Tanvi11Ghelani/ECO_BUILD_UI/build/Images/gallery/hydrofoam-gallery-6.jpg

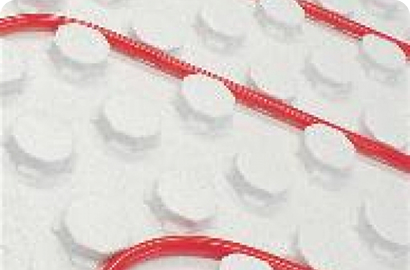
build/Images/gallery/hydrofoam-gallery-6.jpg
