Tanvi11Ghelani/ECO_BUILD_UI/public/lovable-uploads/3d971921-4959-4e32-b5d3-e499155b55ec.png

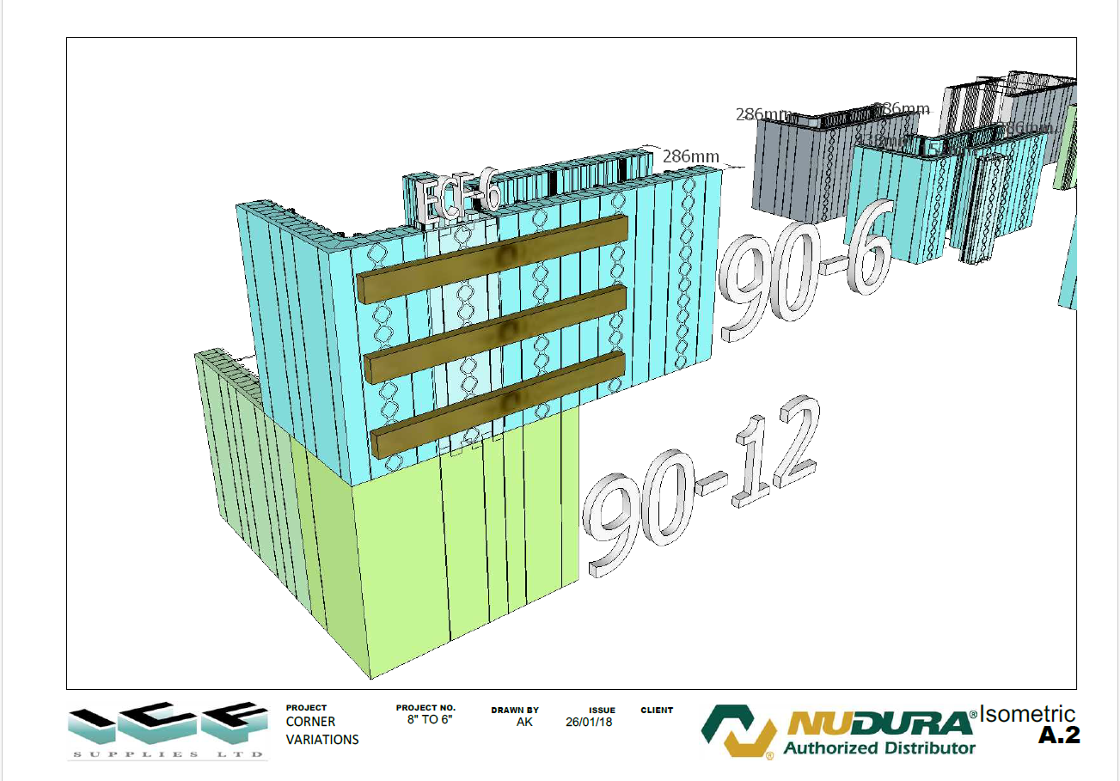
public/lovable-uploads/3d971921-4959-4e32-b5d3-e499155b55ec.png
