Tanvi11Ghelani/ECO_BUILD_UI/public/lovable-uploads/4f6da8b1-d799-4936-9964-731a3020e6be.png

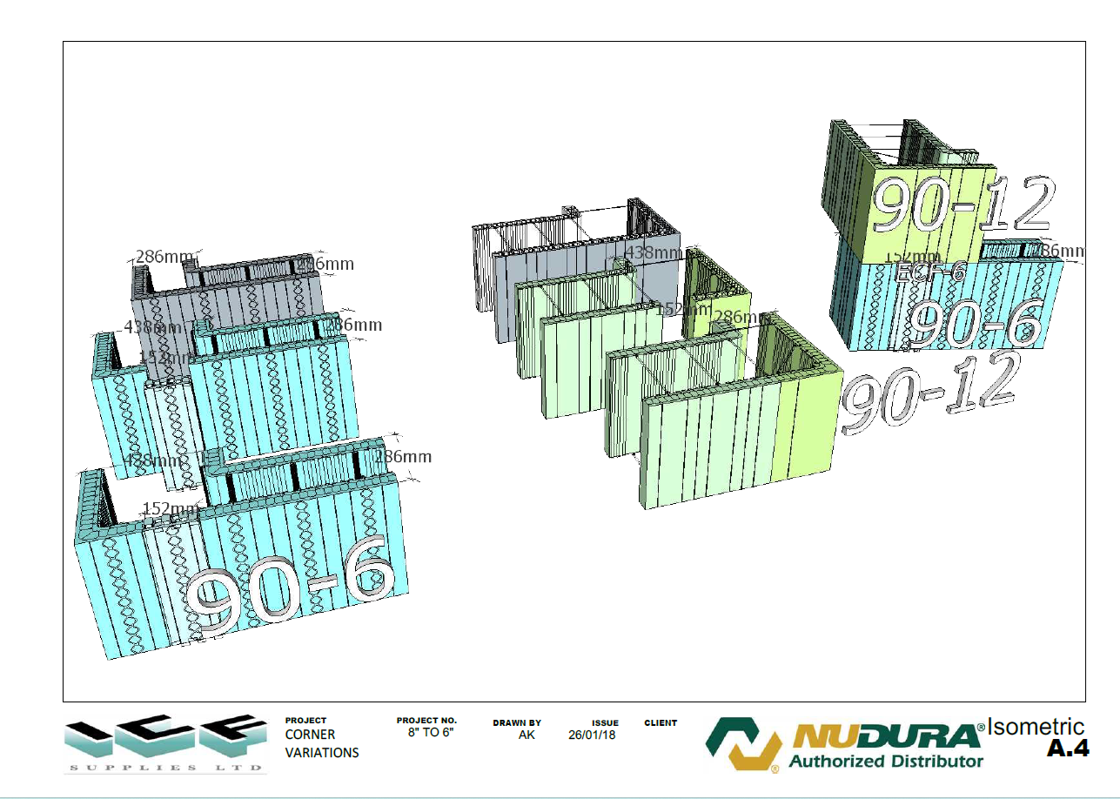
public/lovable-uploads/4f6da8b1-d799-4936-9964-731a3020e6be.png
