Tanvi11Ghelani/ECO_BUILD_UI/public/lovable-uploads/11e5b2ee-bb85-43c7-94f3-0dc3ca06c097.png

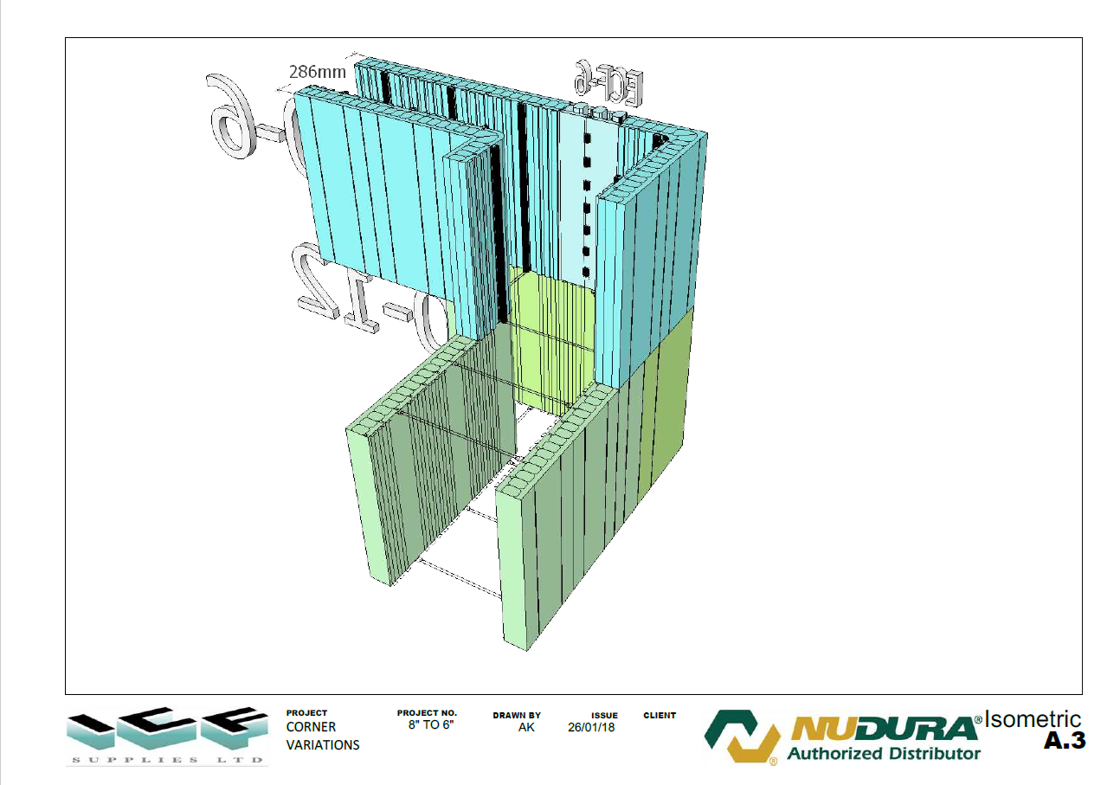
public/lovable-uploads/11e5b2ee-bb85-43c7-94f3-0dc3ca06c097.png
