Tanvi11Ghelani/ECO_BUILD_UI/public/lovable-uploads/427fd92c-301b-4182-912a-e023e5a5e665.png

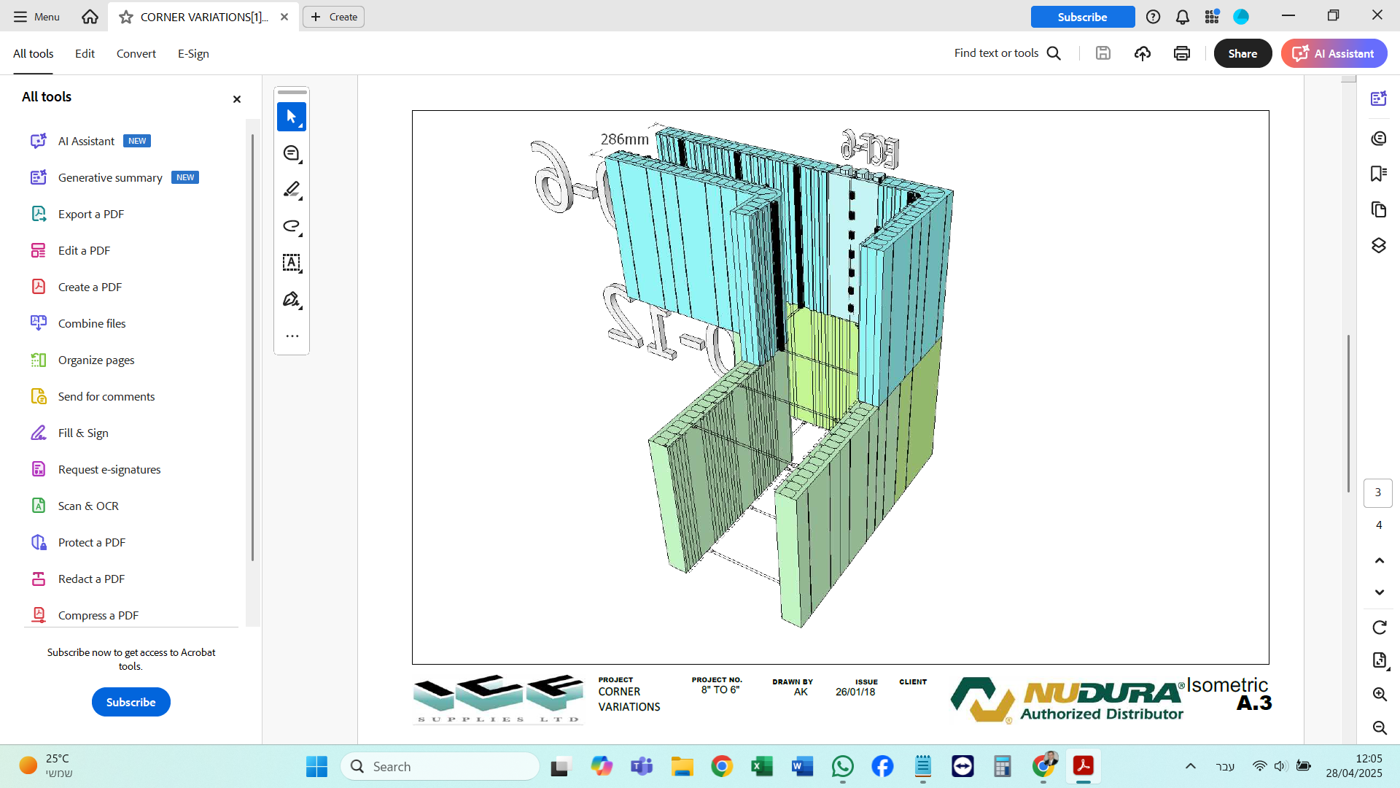
public/lovable-uploads/427fd92c-301b-4182-912a-e023e5a5e665.png
