Tanvi11Ghelani/ECO_BUILD_UI/public/lovable-uploads/4637e0ad-6543-4b1e-aaa6-287fe19e1be7.png

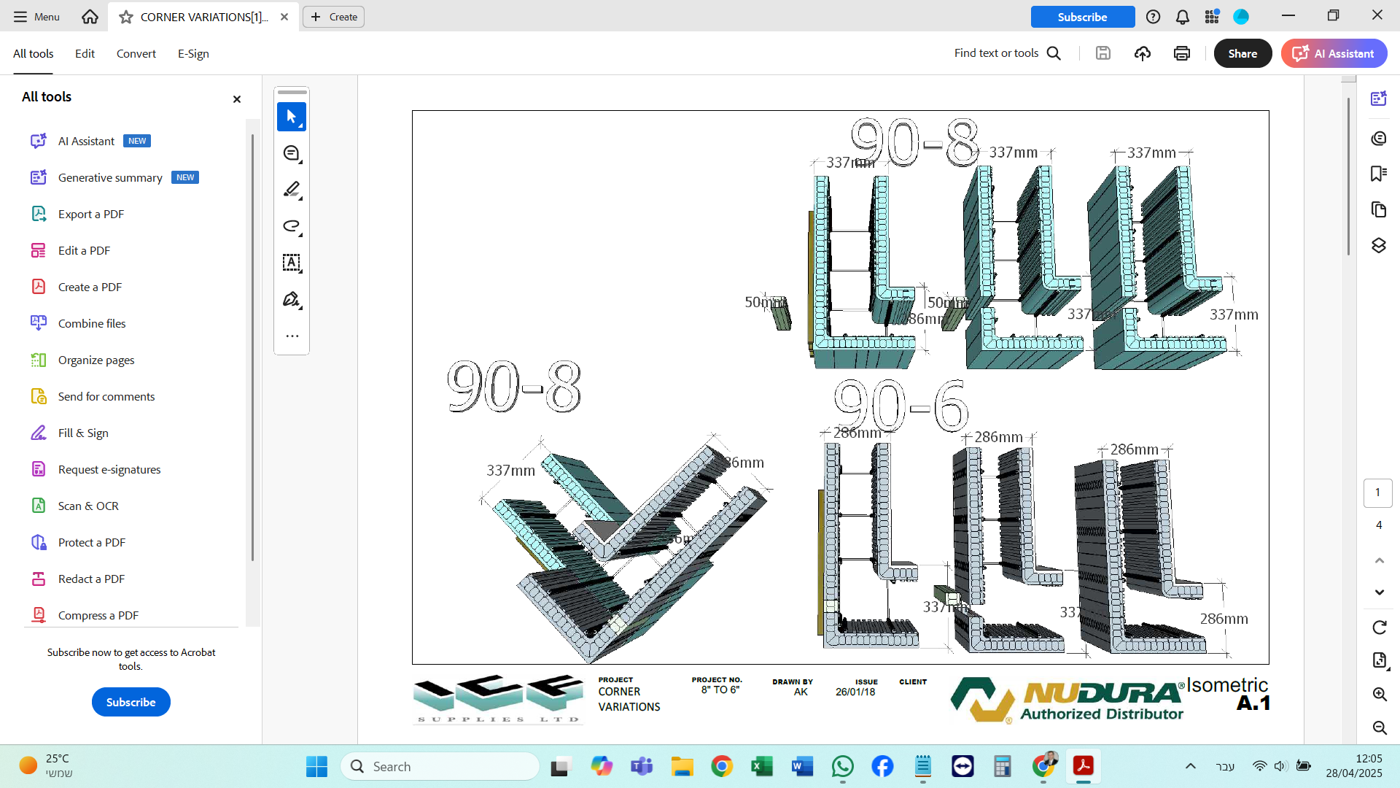
public/lovable-uploads/4637e0ad-6543-4b1e-aaa6-287fe19e1be7.png
