Tanvi11Ghelani/ECO_BUILD_UI/public/lovable-uploads/9743c81a-1aa8-4cef-92a5-277ad55554ff.png

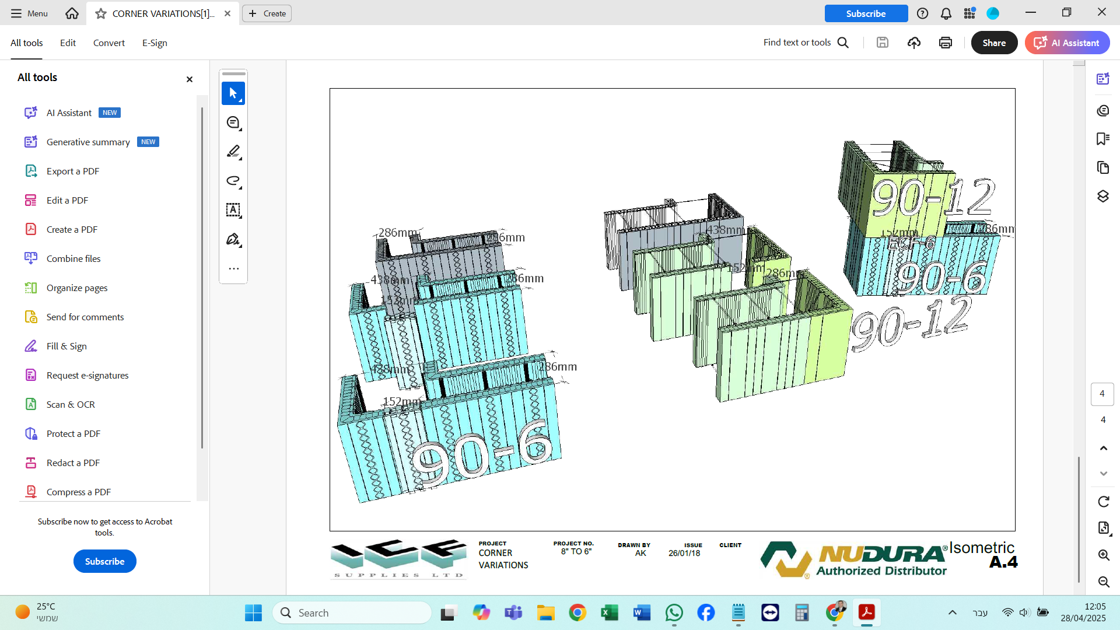
public/lovable-uploads/9743c81a-1aa8-4cef-92a5-277ad55554ff.png
