Tanvi11Ghelani/ECO_BUILD_UI/public/lovable-uploads/d565b1a1-05a1-4024-bde7-53276c35c365.png

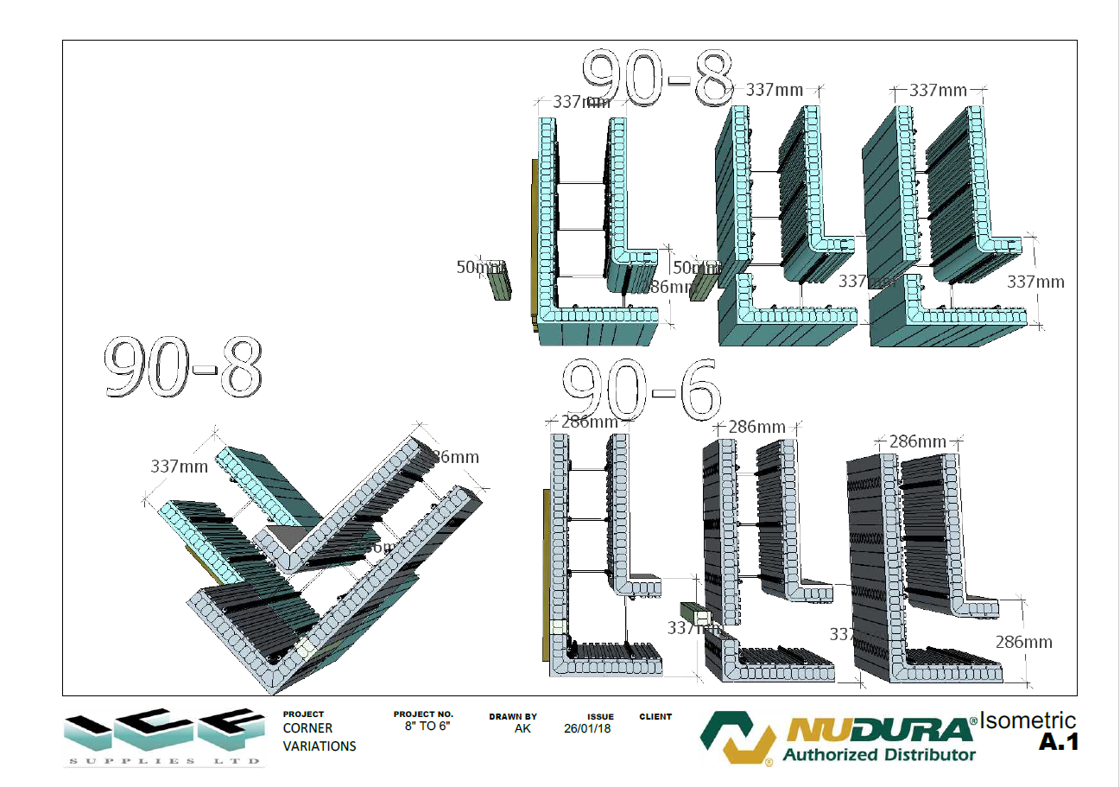
public/lovable-uploads/d565b1a1-05a1-4024-bde7-53276c35c365.png
