Tanvi11Ghelani/ECO_BUILD_UI/public/lovable-uploads/f4cbee15-ae2d-48a7-b90e-260a271ace03.png

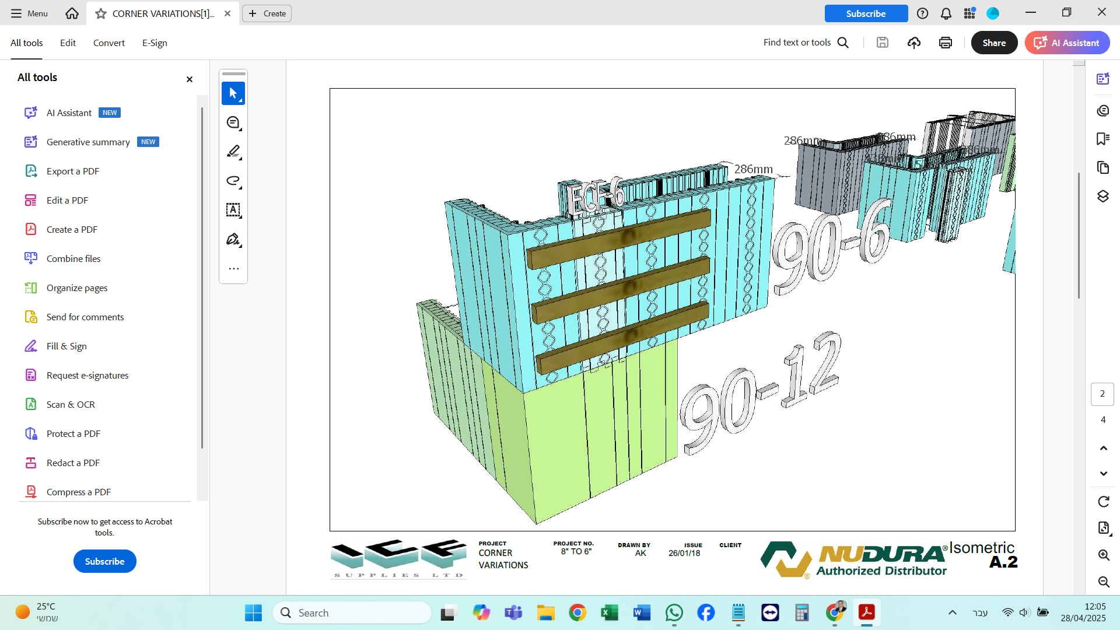
public/lovable-uploads/f4cbee15-ae2d-48a7-b90e-260a271ace03.png
