Tanvi11Ghelani/ECO_BUILD_UI/src/images/0c375863905e1bb1b25750cc52798b844b6eee66.jpg

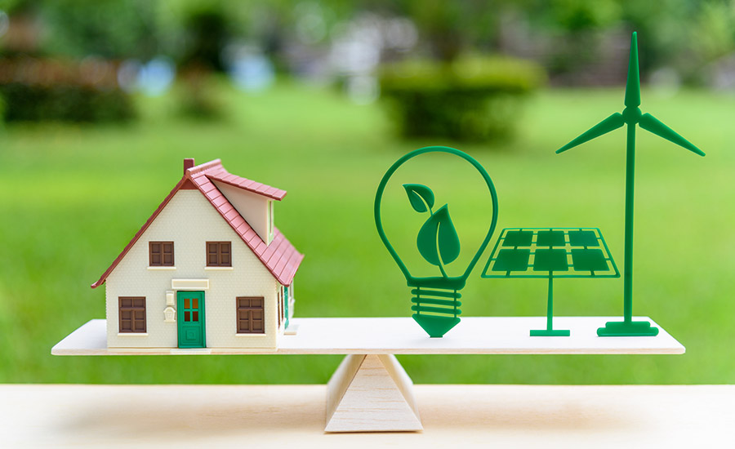
src/images/0c375863905e1bb1b25750cc52798b844b6eee66.jpg
