Tanvi11Ghelani/ECO_BUILD_UI/src/images/3recommend (3).jpeg

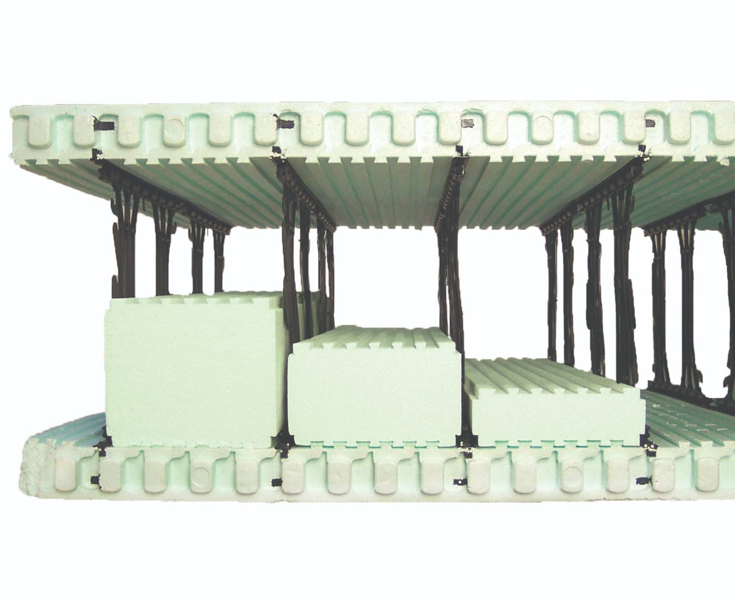
src/images/3recommend (3).jpeg
