Tanvi11Ghelani/ECO_BUILD_UI/src/images/9b8b0e7bb9354c3ecb5831282cb6aff721f5e2fe.png

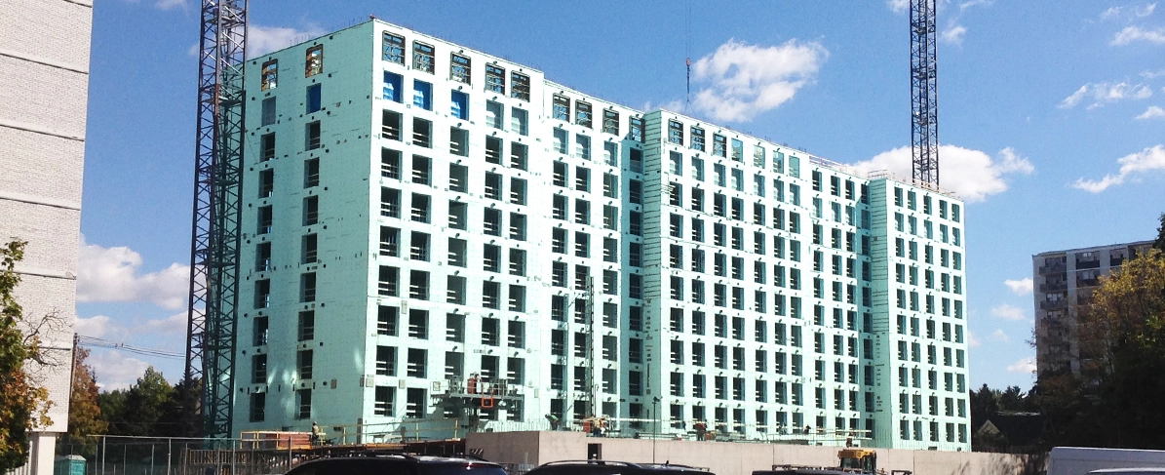
src/images/9b8b0e7bb9354c3ecb5831282cb6aff721f5e2fe.png
