Tanvi11Ghelani/ECO_BUILD_UI/src/images/ES2.png

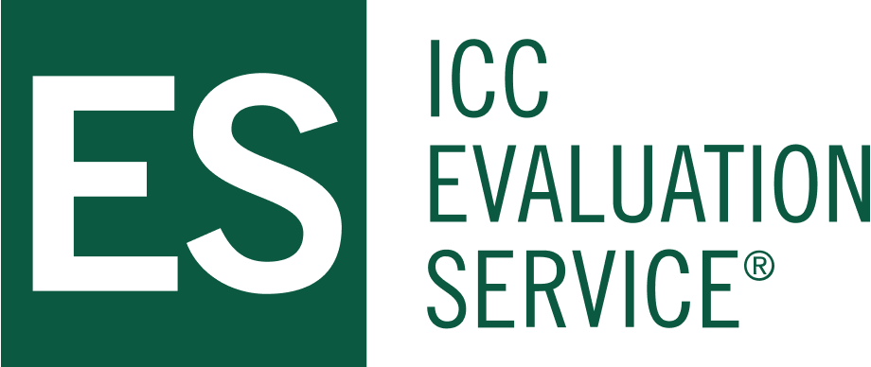
src/images/ES2.png
