Tanvi11Ghelani/ECO_BUILD_UI/src/images/ES3.jpg

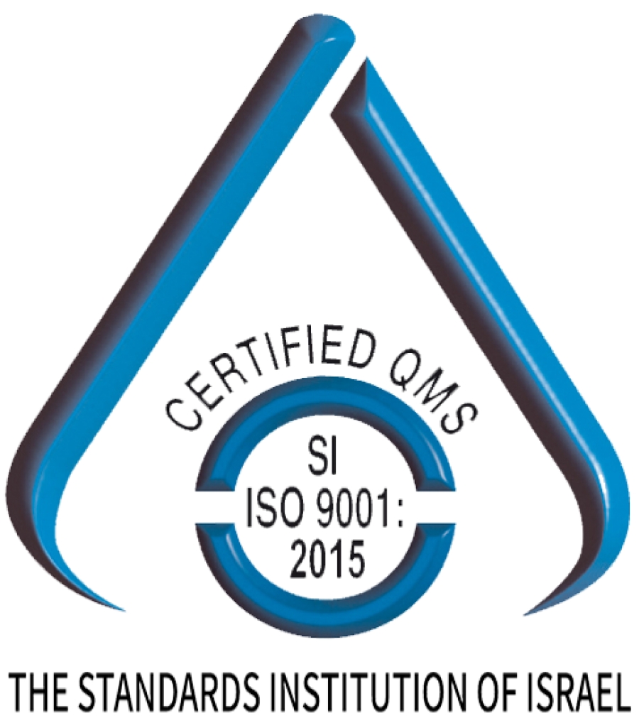
src/images/ES3.jpg
