Tanvi11Ghelani/ECO_BUILD_UI/src/images/ES4.jpg

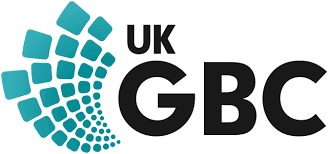
src/images/ES4.jpg
