Tanvi11Ghelani/ECO_BUILD_UI/src/images/ES5.jpg

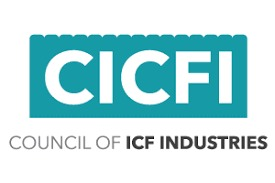
src/images/ES5.jpg
