Tanvi11Ghelani/ECO_BUILD_UI/src/images/Img2.png

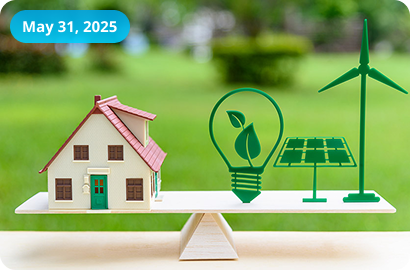
src/images/Img2.png
