Tanvi11Ghelani/ECO_BUILD_UI/src/images/Img3.png

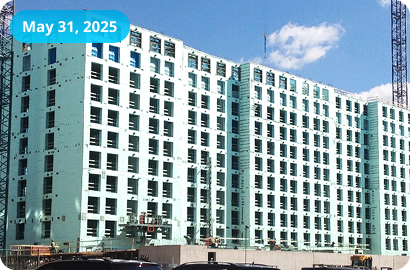
src/images/Img3.png
