Tanvi11Ghelani/ECO_BUILD_UI/src/images/nudura-plus-series-detail.png

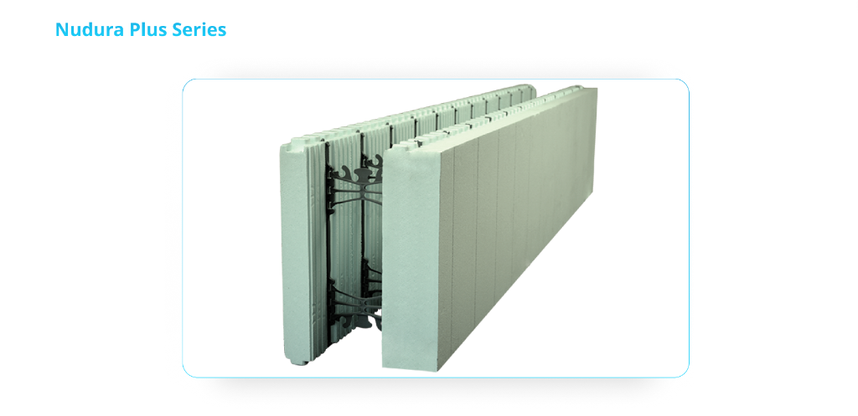
src/images/nudura-plus-series-detail.png
