Tanvi11Ghelani/ECO_BUILD_UI/src/images/photo/Gallery of completed Projects/67ac6d9e-b75c-4956-b25b-969eb53ea821.jpg

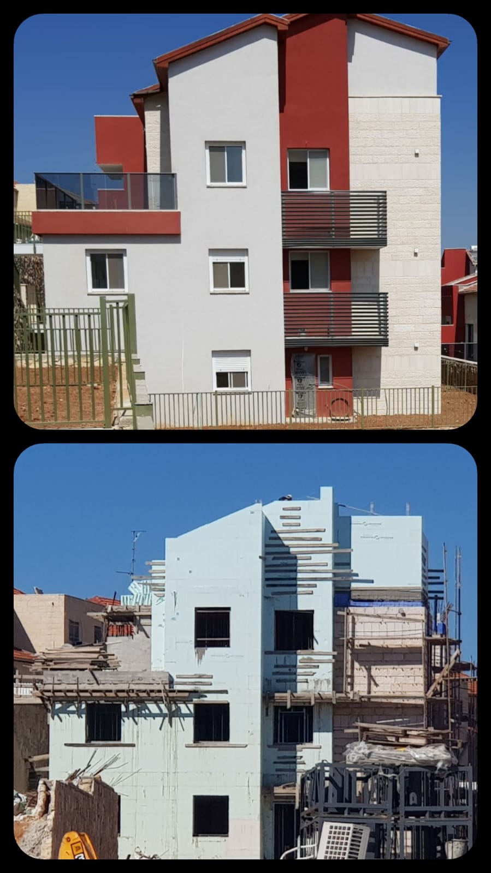
src/images/photo/Gallery of completed Projects/67ac6d9e-b75c-4956-b25b-969eb53ea821.jpg
