Tanvi11Ghelani/ECO_BUILD_UI/src/images/photo/Gallery of completed Projects/77189eb2-6007-4050-adc8-fbb78e779e5c.jpg

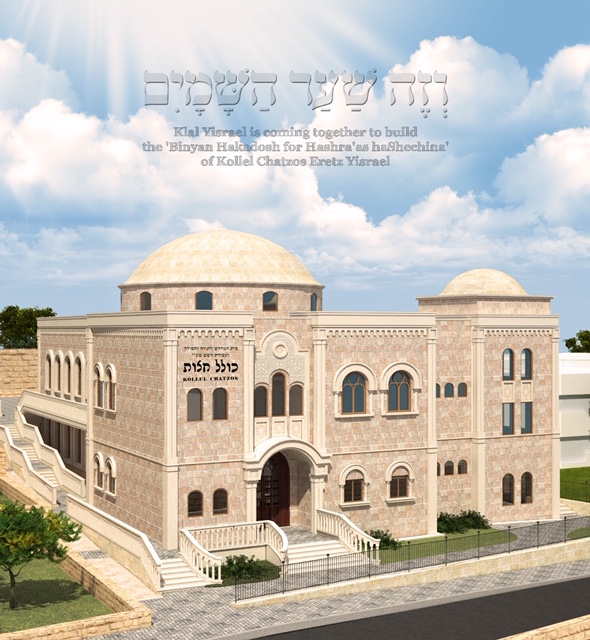
src/images/photo/Gallery of completed Projects/77189eb2-6007-4050-adc8-fbb78e779e5c.jpg
