Tanvi11Ghelani/ECO_BUILD_UI/src/images/photo/Gallery of completed Projects/a954a0a3-4781-4956-ba61-734f6c950a49.jpg

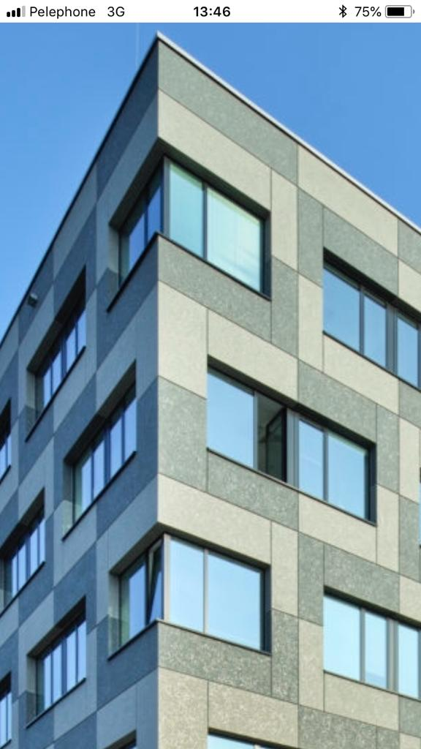
src/images/photo/Gallery of completed Projects/a954a0a3-4781-4956-ba61-734f6c950a49.jpg
