Tanvi11Ghelani/ECO_BUILD_UI/src/images/photo/Gallery of completed Projects/beb1c424-b9a0-4cc4-8972-f8892e4e08dd-1-1.jpg

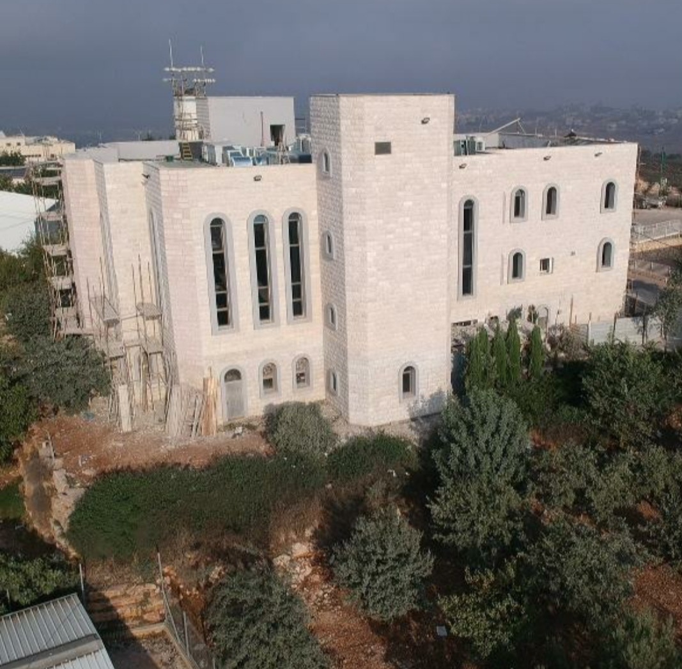
src/images/photo/Gallery of completed Projects/beb1c424-b9a0-4cc4-8972-f8892e4e08dd-1-1.jpg
