Tanvi11Ghelani/ECO_BUILD_UI/src/images/photo/Gallery of completed Projects/IMG_1801.jpg

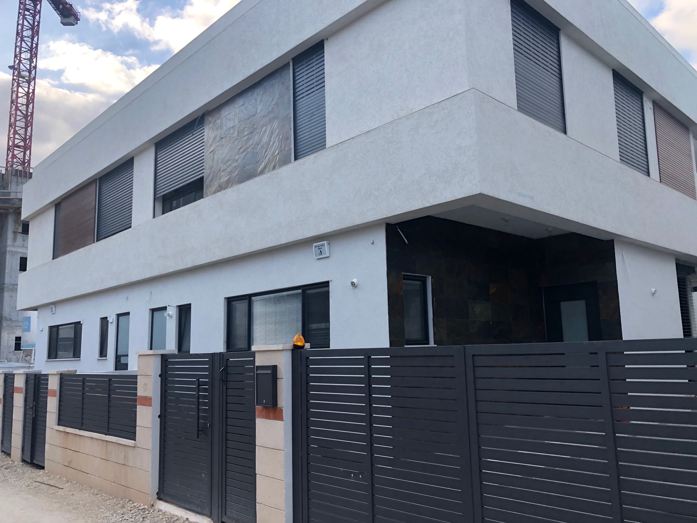
src/images/photo/Gallery of completed Projects/IMG_1801.jpg
