Tanvi11Ghelani/ECO_BUILD_UI/src/images/photo/Gallery of completed Projects/IMG_6840-rotated.jpg

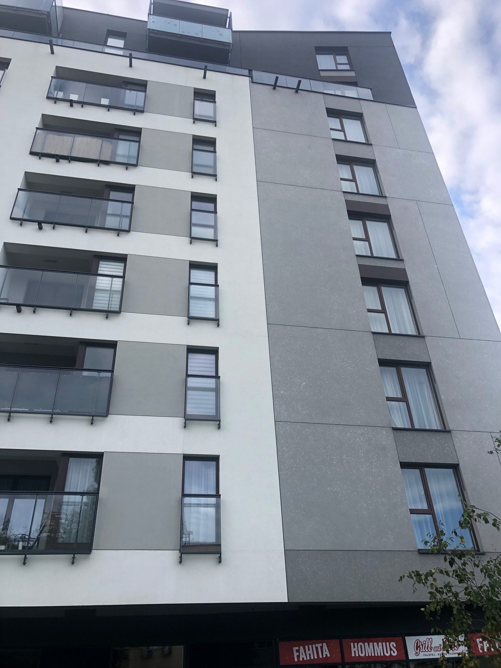
src/images/photo/Gallery of completed Projects/IMG_6840-rotated.jpg
