Tanvi11Ghelani/ECO_BUILD_UI/src/images/photo/Gallery of completed Projects/new_1715096.jpg

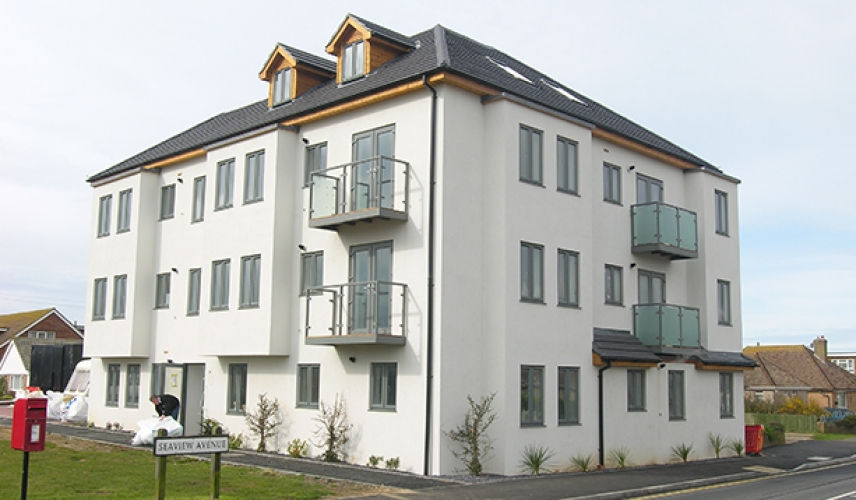
src/images/photo/Gallery of completed Projects/new_1715096.jpg
