Tanvi11Ghelani/ECO_BUILD_UI/src/images/photo/Gallery of completed Projects/new_6908463.jpg

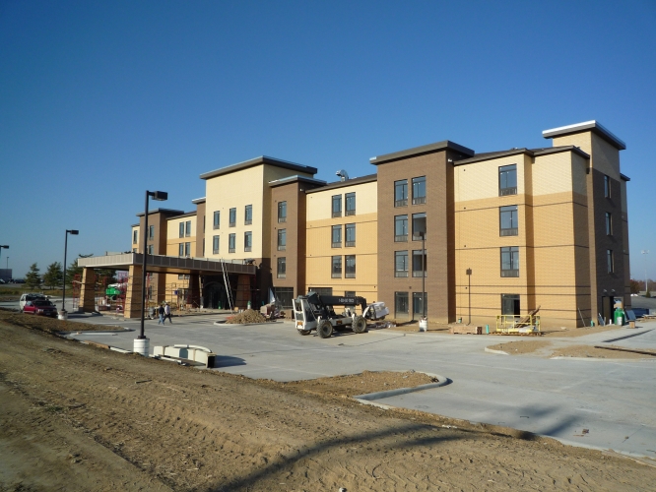
src/images/photo/Gallery of completed Projects/new_6908463.jpg
