Tanvi11Ghelani/ECO_BUILD_UI/src/images/photo/Gallery of completed Projects/new_8478451.jpg

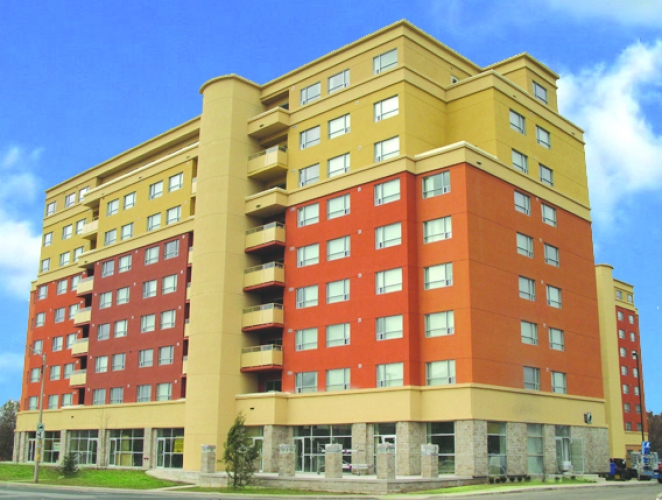
src/images/photo/Gallery of completed Projects/new_8478451.jpg
