Tanvi11Ghelani/ECO_BUILD_UI/src/images/photo/Gallery of completed Projects/PHOTO-2019-05-30-10-12-08.jpg

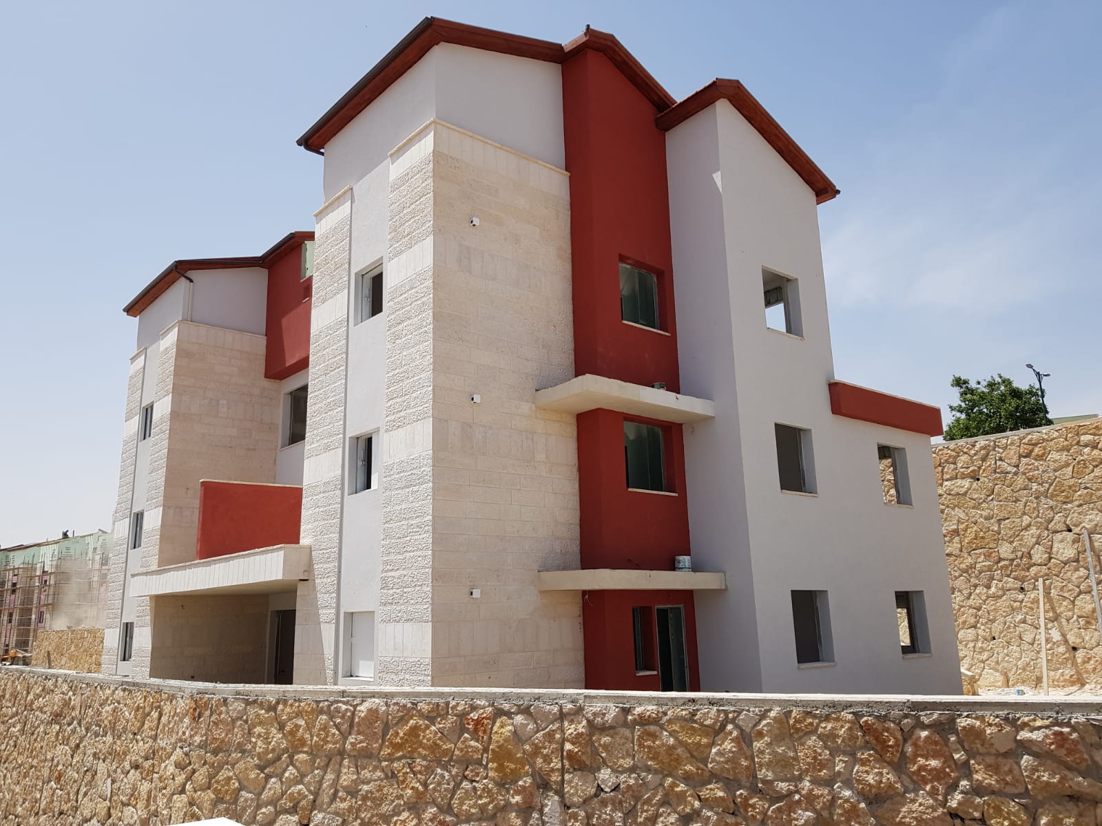
src/images/photo/Gallery of completed Projects/PHOTO-2019-05-30-10-12-08.jpg
