Tanvi11Ghelani/ECO_BUILD_UI/src/images/photo/Gallery of completed Projects/PHOTO-2019-10-07-14-19-38_1.jpg

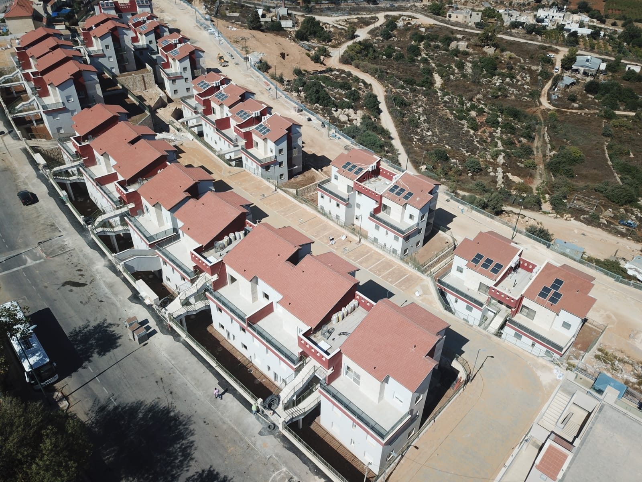
src/images/photo/Gallery of completed Projects/PHOTO-2019-10-07-14-19-38_1.jpg
