Tanvi11Ghelani/ECO_BUILD_UI/src/images/photo/Gallery of completed Projects/PHOTO-2021-01-18-13-10-40.jpg

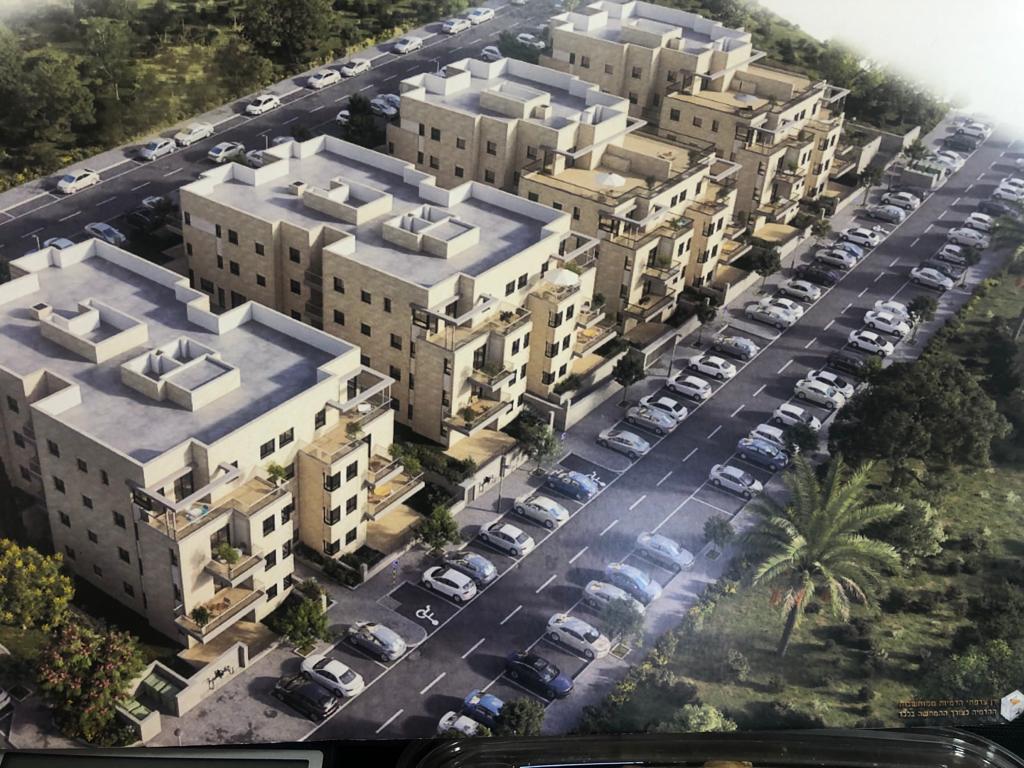
src/images/photo/Gallery of completed Projects/PHOTO-2021-01-18-13-10-40.jpg
