Tanvi11Ghelani/ECO_BUILD_UI/src/images/prod-2.png

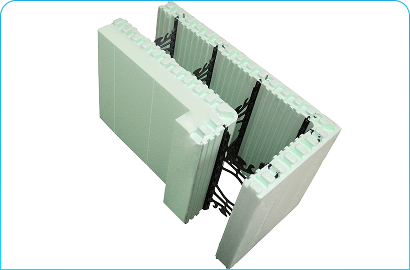
src/images/prod-2.png
