Tanvi11Ghelani/ECO_BUILD_UI/src/images/prod-3.png

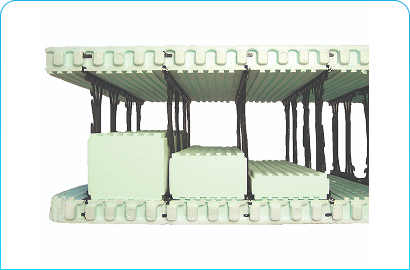
src/images/prod-3.png
