Tanvi11Ghelani/ECO_BUILD_UI/src/images/prod-4.png

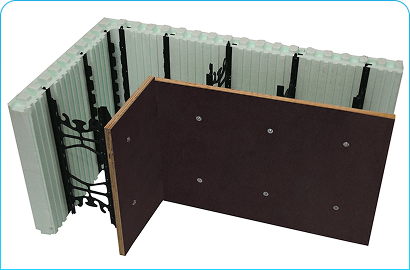
src/images/prod-4.png
