Tanvi11Ghelani/ECO_BUILD_UI/src/images/prod-5.png

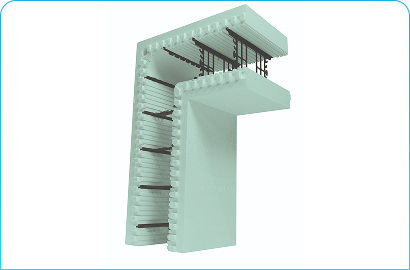
src/images/prod-5.png
