Tanvi11Ghelani/ECO_BUILD_UI/src/images/prod-6.png

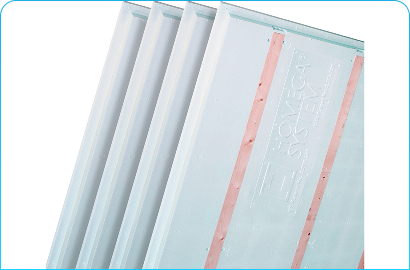
src/images/prod-6.png
