Tanvi11Ghelani/ECO_BUILD_UI/(list of files, cad)

Other CAD files:
build/EcoBuildPdf/BelowtheConstSlop/BelowGradeSlab/FloorbelowGL-insulated/B10A03.dwg
build/EcoBuildPdf/BelowtheConstSlop/BelowGradeSlab/FloorBelowGL-Notinsulated/B6A01.dwg
build/EcoBuildPdf/BelowtheConstSlop/GradeBeams/BelowGradeNon-InsulatedSlab/B12C04.dwg
build/EcoBuildPdf/BelowtheConstSlop/GradeBeams/BelowGradeSlabInsulated/B6C09.dwg
build/EcoBuildPdf/BelowtheConstSlop/HaunchedSlabonGrade/InsulatedBrick/B8D03.dwg
build/EcoBuildPdf/BelowtheConstSlop/HaunchedSlabonGrade/Non-BrickInsulated/B6D01.dwg
build/EcoBuildPdf/BelowtheConstSlop/HaunchedSlabonGrade/Non-BrickNon-InsulatedBrick/B8D02.dwg
build/EcoBuildPdf/BelowtheConstSlop/HaunchedSlabonGrade/Non-InsulatedBrick/B6D04.dwg
build/EcoBuildPdf/BelowtheConstSlop/StemWall/B6A05.dwg
build/EcoBuildPdf/BelowtheConstSlop/StemWall4/B12C02.dwg
build/EcoBuildPdf/BIMLibrary/Nudura Unit Form Model/Metric DWF 152mm/Brick Ledge Form Unit.dwg
build/EcoBuildPdf/EarlyDesignCriteria/Engineering Parameters/102mm 4 Concrete Core Forms/a4b03.dwg
build/EcoBuildPdf/EarlyDesignCriteria/Engineering Parameters/152mm 6 Concrete Core Forms/a6b09.dwg
build/EcoBuildPdf/EarlyDesignCriteria/Engineering Parameters/203mm 8 Concrete Core Forms/a8b07.dwg
build/EcoBuildPdf/EarlyDesignCriteria/Engineering Parameters/254mm 10 Concrete Core Forms/a10b05.dwg
build/EcoBuildPdf/EarlyDesignCriteria/Engineering Parameters/305mm 12 Concrete Core Forms/a12b03.dwg
build/EcoBuildPdf/Firewall/152mm-6CONCRETECOREFORM152/fw6d2b.dwg
build/EcoBuildPdf/Flammableconstruction/Door/Steel Doors/e6e01.dwg
build/EcoBuildPdf/Flammableconstruction/Door/Wood and Insulated Steel Doors/e8e08.dwg
build/EcoBuildPdf/Flammableconstruction/FlooratGradeDetails/Ledger Board Connection/c6a29.dwg
build/EcoBuildPdf/Flammableconstruction/FlooratGradeDetails/Nudura ICF Hanger System/c8a12.dwg
build/EcoBuildPdf/Flammableconstruction/FlooratGradeDetails/Simpson Ledger Hanger System/c6a22.dwg
build/EcoBuildPdf/Flammableconstruction/IntermediateFloor/LedgerBoardConnection/c6a03.dwg
build/EcoBuildPdf/Flammableconstruction/IntermediateFloor/NuduraICFHangerSystem/c10a11.dwg
build/EcoBuildPdf/Flammableconstruction/IntermediateFloor/SimpsonLedgerConnectorSystem/c10a25.dwg
build/EcoBuildPdf/Flammableconstruction/Roof/Brick Load Bearing/f8b01.dwg
build/EcoBuildPdf/Flammableconstruction/Roof/Brick Non-Load Bearing/f6b06.dwg
build/EcoBuildPdf/Flammableconstruction/Roof/Non-Brick Load Bearing/f6b03.dwg
build/EcoBuildPdf/Flammableconstruction/Roof/Non-Brick Non-Load Bearing/f8b04.dwg
build/EcoBuildPdf/Flammableconstruction/Window/Head and Sill/e6a01.dwg
build/EcoBuildPdf/Flammableconstruction/Window/Jamb/e6a05.dwg
build/EcoBuildPdf/FormUnitProfiles/152mm- 6 Concrete Core Forms/a6a02.dwg
build/EcoBuildPdf/FormUnitProfiles/203mm- 8 Concrete Core Forms/a8a03.dwg
build/EcoBuildPdf/FormUnitProfiles/254mm- 10 Concrete Core Forms/a10a05.dwg
build/EcoBuildPdf/FormUnitProfiles/305mm- 12 Concrete Core Forms/a12a02.dwg
build/EcoBuildPdf/FormUnitProfiles/8 (203mm) XR35 Concrete Core Forms/xr8a01.dwg
build/EcoBuildPdf/FormUnitProfiles/Concrete core mold 102 mm/a4a01.dwg
build/EcoBuildPdf/Information Center/Planning/Construction Below Ground Level/Floor below ground level – insulated/B8A04.dwg
build/EcoBuildPdf/Information Center/Planning/Construction Below Ground Level/Floor below ground level – not insulated/B8A01.dwg
build/EcoBuildPdf/Information Center/Planning/Description of template units/10″ (254 mm) concrete core mold/A10A03.dwg
build/EcoBuildPdf/Information Center/Planning/Description of template units/12″ (305 mm) concrete core mold/A12A03.dwg
build/EcoBuildPdf/Information Center/Planning/Description of template units/4″ (102 mm) concrete core mold/A4A06.dwg
build/EcoBuildPdf/Information Center/Planning/Description of template units/6″ (152 mm) concrete core mold/A6A04.dwg
build/EcoBuildPdf/Information Center/Planning/Description of template units/8″ (203 mm) concrete core mold/A8A01.dwg
build/EcoBuildPdf/Information Center/Planning/Firewall Details/6″ (152 mm) concrete core mold/FW6D2A.dwg
build/EcoBuildPdf/Information Center/Planning/Firewall Details/8″ (203 mm) concrete core mold/FW8D3.dwg
build/EcoBuildPdf/Information Center/Planning/Flammable Construction/Ground Floor/DSM floor details on ground level/End connection/A non-stone wall/C10A08.dwg
build/EcoBuildPdf/Information Center/Planning/Flammable Construction/Ground Floor/DSM floor details on ground level/End connection/Load-bearing wall – not made of stone/C10A01.dwg
build/EcoBuildPdf/Information Center/Planning/Flammable Construction/Ground Floor/DSM floor details on ground level/End connection/Stone bearing wall/C8A05.dwg
build/EcoBuildPdf/Information Center/Planning/Flammable Construction/Ground Floor/DSM floor details on ground level/End connection/Stone cross wall/C10A04.dwg
build/EcoBuildPdf/Information Center/Planning/Flammable Construction/Ground Floor/DSM floor details on ground level/ICF connection systems/A non-stone wall/C6A02.dwg
build/EcoBuildPdf/Information Center/Planning/Flammable Construction/Ground Floor/DSM floor details on ground level/ICF connection systems/Load-bearing wall – not made of stone/C6A11.dwg
build/EcoBuildPdf/Information Center/Planning/Flammable Construction/Ground Floor/DSM floor details on ground level/ICF connection systems/Stone bearing wall/C10A10.dwg
build/EcoBuildPdf/Information Center/Planning/Flammable Construction/Ground Floor/DSM floor details on ground level/ICF connection systems/Stone cross wall/c6105.dwg
build/EcoBuildPdf/Information Center/Planning/Flammable Construction/Ground Floor/DSM floor details on ground level/Simpson end connection/A non-stone wall/C10A22.dwg
build/EcoBuildPdf/Information Center/Planning/Flammable Construction/Ground Floor/DSM floor details on ground level/Simpson end connection/Load-bearing wall – not made of stone/C10A19.dwg
build/EcoBuildPdf/Information Center/Planning/Flammable Construction/Ground Floor/DSM floor details on ground level/Simpson end connection/Stone bearing wall/C10A20.dwg
build/EcoBuildPdf/Information Center/Planning/Flammable Construction/Ground Floor/DSM floor details on ground level/Simpson end connection/Stone cross wall/C8A23.dwg
build/EcoBuildPdf/Information Center/Planning/Non-combustible construction/Not made of stone/Isolated/B8C08.dwg
build/EcoBuildPdf/Information Center/Planning/Non-combustible construction/Not made of stone/Not isolated/B10C02.dwg
build/EcoBuildPdf/Information Center/Planning/Non-combustible construction/Stone/Isolated/B6C10.dwg
build/EcoBuildPdf/Information Center/Planning/Non-combustible construction/Stone/Not isolated/B12C07.dwg
build/EcoBuildPdf/Non-combustibleconstruction/DemisingWallIntermediateFloorConnections/Flat Plate Slab Load Bearing/g12e01.dwg
build/EcoBuildPdf/Non-combustibleconstruction/DemisingWallIntermediateFloorConnections/Hollow Core Floors Load Bearing/g8a01.dwg
build/EcoBuildPdf/Non-combustibleconstruction/DemisingWallIntermediateFloorConnections/Hollow Core Floors Non-Load Bearings/g6a02.dwg
build/EcoBuildPdf/Non-combustibleconstruction/DemisingWallIntermediateFloorConnections/Insulated Concrete Floor System Load Bearing/g6d01.dwg
build/EcoBuildPdf/Non-combustibleconstruction/DemisingWallIntermediateFloorConnections/Insulated Concrete Floor System Non-Load Bearing/g12d02.dwg
build/EcoBuildPdf/Non-combustibleconstruction/DemisingWallIntermediateFloorConnections/OWSJ- Composite Deck Load Bearing/g6c01.dwg
build/EcoBuildPdf/Non-combustibleconstruction/DemisingWallIntermediateFloorConnections/OWSJ- Composite Deck Non-Load Bearing/g6c02.dwg
build/EcoBuildPdf/Non-combustibleconstruction/DemisingWallIntermediateFloorConnections/Proprietary Steel Joist Load Bearing System/g8b01.dwg
build/EcoBuildPdf/Non-combustibleconstruction/DemisingWallIntermediateFloorConnections/Proprietary Steel Joist System Non-Load Bearing/g10b02.dwg
build/EcoBuildPdf/Non-combustibleconstruction/DemisingWallRoofConnections/Composite Deck OWSJ Bearing/g10c03.dwg
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
