Tanvi11Ghelani/ECO_BUILD_UI/build/EcoBuildPdf/Information Center/Catlog for Direct Viewing/7112325.pdf

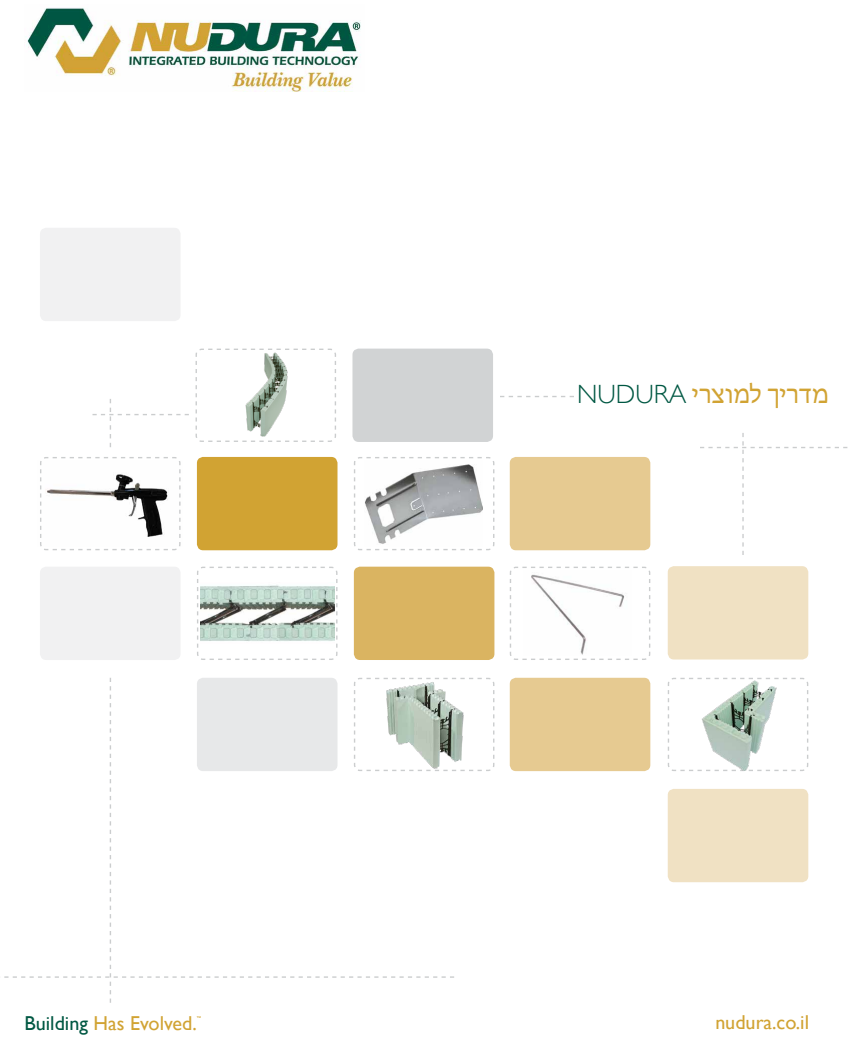
[picture p102: page 1]

מדריך למוצרי NUDURA

TM.Evolved Has Building

il.co.nudura

מבוא 4-------------------------------------------------------------------------------------------------------------------מוצרים חדשניים5------------------------------------------------------------------------------------------------------קווי מוצרים6------------------------------------------------------------------------------------------------------------

### סדרת ICF NUDURA

### תבניות מורכבות:

תבניות סטנדרטיות----------------------------------------------------------------------------------- 7
תבניות 90° -------------------------------------------------------------------------------------------- 8 תבניות 45° -------------------------------------------------------------------------------------------- 9 תבניות עם קצה משופע10-----------------------------------------------------------------------------תבניות בסיס ללבנים 11--------------------------------------------------------------------------------תבניות 12-13--------------------------------------------------------------------------------------------תבניות רדיוס14-----------------------------------------------------------------------------------------

### תבניות לא מורכבות:

תבניות סטנדרטיות15----------------------------------------------------------------------------------תבניות עם קצה משופע16-----------------------------------------------------------------------------תבניות עם קצה משופע דו-צדדי 17------------------------------------------------------------------תבניות בסיס ללבנים 18--------------------------------------------------------------------------------תבניות בסיס דו-צדדיות ללבנים 19-------------------------------------------------------------------תבניות בסיס מחודדות-קצה ללבנים20--------------------------------------------------------------תבניות אופטימיזציה 21--------------------------------------------------------------------------------)סדרה 1( Series One 22-23--------------------------------------------------------------------------

### Series Plus

תבניות Plus NUDURA 24----------------------------------------------------------------------------תוספים Value-R 25------------------------------------------------------------------------------------

### הסדרה המשולבת

RHYDROFOAM 2626---------------------------------------------------------------------------------RetroFit27-----------------------------------------------------------------------------------------------
טכנולוגיה לתקרות 28----------------------------------------------------------------------------------
טכנולוגיה לרצפות 28----------------------------------------------------------------------------------
אביזרים לתבניות NUDURA ------------------------------------------------------------------------------------- 29 אביזרים עבור NUDURA 30-34-------------------------------------------------------------------------------------מערכות יישור NUDURA 35-36-------------------------------------------------------------------------------------ערכת מתאם לקיר גבוה של NUDURA ------------------------------------------------------------------------- 37 שירות הלקוחות ---------------------------------------------------------------------------------------------------- 38

# תוכן העניינים

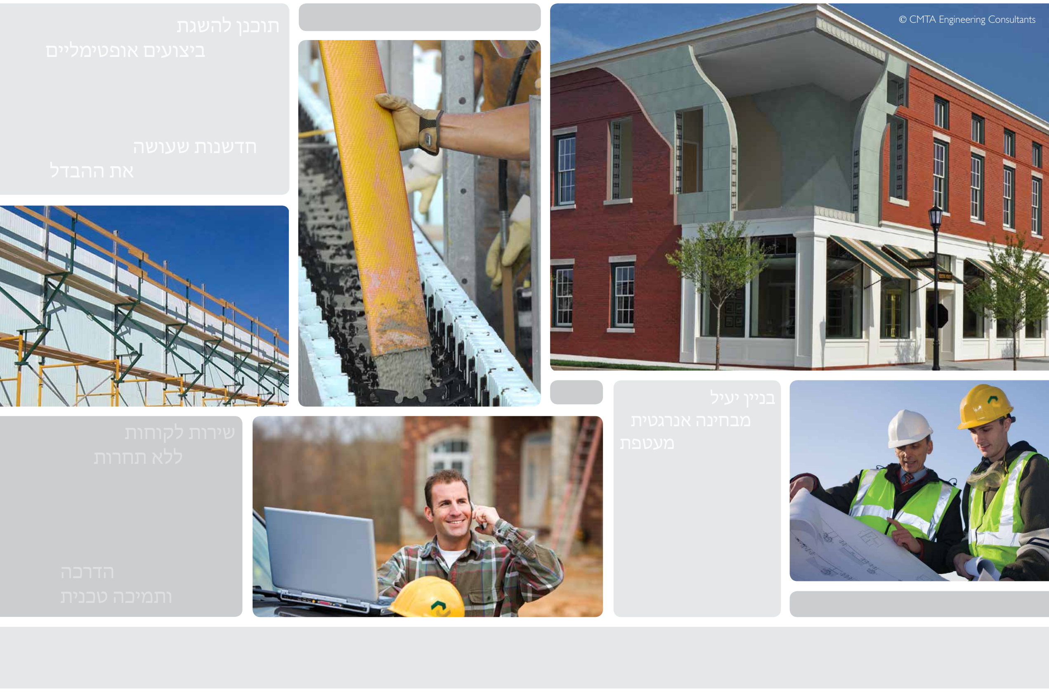
[picture p103: figure]
Consultants Engineering CMTA©; שירות לקוחות ללא תחרות; הדרכה ותמיכה טכנית; בניין יעיל מבחינה אנרגטית מעטפת; תוכנן להשגת ביצועים אופטימליים; חדשנות שעושה את ההבדל

הקריטריונםים לבניית בניינים בימינו מחייבים מבנים בעלי מעטפות מבנה אמינות, חסכוניות מבחינה אנרגטית, ידידותיות לסביבה ועתירות-ב י

צועים, זאת כדי למזער את עלויות האנרגיה, להקטין את פליטות הפחמן הדו-חמצני ולמקסם את ערך הנכס. המבנים של NUDURA מציעים

חוזק מעולה, עמידות בפני סופות ואש, בידוד מפני רעש. זו הסיבה לכך שארכיטקטים, יזמים וקבלנים בכל רחבי העולם ממשיכים לבחור

בטכנולוגיית הבנייה המשולבת של NUDURA כחלופה המוכחת לשיטות הבנייה המסורתיות.

תבניות הבטון המבודדות שלנו מעניקות למעצבים, לאדריכלים, לבעלי בתים, לקבלנים ולבעלי מקצוע אחרים בתחום הבנייה את החופש

והגמישתות לתכנן ולבנות את המבנה על פי החזון שלהם. הבנייה עם NUDURA מעניקה לכם את האפשרות לבנות מהר יותר ויעיל יותר, ול

ספק מבנה ידידותי-לסביבה בעל יתרונות מהותיים בתחום החיסכון באנרגיה בטווח הארוך. כשתבחרו ב-NUDURA, תדעו שאתם משתמשים

בפתרון הבנייה הטוב ביותר שיש כיום.

## מבוא

## TM.Evolved Has Building

## מוצרים חדשניים

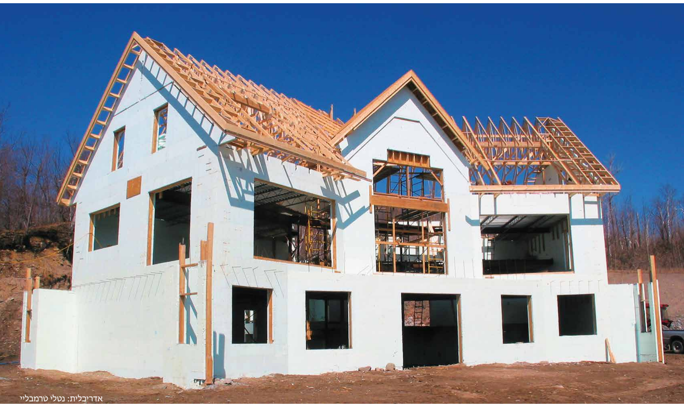
[picture p104: figure]
אדריכלית: נטלי טרמבליי

התבניות של NUDURA מיוצרות בעזרת טכנולוגיות מובילות בענף, טכנולוגיות המוגנות על ידי פטנטים והן ייחודיות ל-NUDURA. הן מאפשרות לכם ליהנות ממגוון מוצרים חדשניים שנועדו לספק יעילות אנרגטית ללא תחרות, חוזק טוב יותר ובידוד מפני רעשים. מעטפת הבנייה שלנו מציעה פתרון בנייה ידידותי לסביבה המאפשר לכם לבנות מהר יותר ויעיל יותר, וליהנות מיתרונות משמעותיים בהשוואה לשיטות הבנייה המסורתיות.
החדשנות הופכת אותנו להיות הפתרון לבנייה טובה יותר.
- טכנולוגיית TMDURALOK - נעילה בטוחה של התבניות למקומן בעזרת אינטרלוק בעל שלוש שיניים. כך נמנע הצורך בטפסנות ובברזלנות וניתן לחסוך בעלויות העבודה במהלך ההתקנה. לאחר שהתבניות נערמו זו על גבי זו, רצועת הנעילה הרציפה המותקנת לאורך הקיר כולו מבטיחה שגובה הקירות יהיו תמיד מדויק. זאת בהשוואה לתבניות אחרות ללא רצועות נעילה כאלו, דבר הגורם לירידה לא רצויה בגובה הקיר לאחר יציקת הבטון. DURALOK הופך את NUDURA לתבנית החזקה ביותר בענף הבנייה.
- מערכת REVERSIBLE WAY4- - האינטרלוק המוקצף ומוגן על ידי פטנט מאפשר הצבה של התבנית ב4- כיוונים שונים. וכך ניתן למנוע היווצרות של פינות ימניות ושמאליות ולהפחית במידה משמעותית את היקף הבזבוז באתר הבנייה.
- טכנולוגיית TMDURAMAX - התבנית הסטנדרטית הגדולה ביותר בשוק, בגודל 457 x 2438 מ“מ. התבנית שלנו בגודל 2438 מ“מ מפחיתה ב60%- את מספר החיבורים בקיר בהשוואה למערכות קירות אחרות, ומאפשרת למתקינים להניח 1.11 מ“ר של קיר בעזרת בלוק יחיד.
- טכנולוגיית TMDURAFOLD - טכנולוגיית רשת-על-צירים המוגנת ע“י פטנט מאפשרת קיפול והובלה של כל מערך תבניות NUDURA במצב שטוח, כך ניתן להעמיס 40% יותר פריטים על המשאית בהשוואה לתבניות בטון מבודדות אחרות. ברגע שהתבניות מגיעות לאתר, עליכם רק לפתוח אותן ולהערים זו על גבי זו.

צפו בסרטון החדשנות שלנו

### NUDURA היא החברה המובילה בחדשנות טכנולוגית בתחום תבניות הבטון המבודדות )ICF )ומציעה ללקוחותיה את האפשרות לשלב מגוון מוצרים שונים בתהליך הבנייה. Series ICF NUDURA

מציעה יתרונות ייחודיים בהשוואה למוצרים המתחרים בשוק. TMTechnology DURAMAX
TMTechnology DURAFOLD
TMTechnology DURALOK
System Reversible Way4- The

Series One היא מערכת התבניות הרב-חיבוריות היחידה בענף המאפשרת יצירה של משטחי בטון חשופים לגמרי על פני לוח תבנית סטנדרטי של NUDURA. כך יכולים בנאים ואדריכלים ליהנות מגמישות ללא תחרות בפרויקטים שתוכננו להשתמש בתבניות בטון מבודדות מסדרת ICF. בלב קו המוצרים החדשני הזה נמצאת טכנולוגיית TMMULTILINK DURA, רשת חדישה המאפשרת לבנאים ליצור שילובים מרובי-צדדים ומותאמים אישית לתבניות עבור מגוון

פרויקטים של בנייה בתחום המסחרי והפרטי כאחד.

### קו מוצרי Series Plus מציג דרך חדשה למעצבים ולמהנדסים לייצר ערכי R משלהם. קו תבניות Plus והאינסרטים מסוג +Plus מכיל שני מוצרים שביחד מאפשרים לכם להתאים את ערך ה-R של הבניין בעזרת מסה תרמית שתספק חיסכון משמעותי באנרגיה. Series Plus של NUDURA מסייע לאנשי המקצוע בתחום לעמוד בדרישות

הבידוד החדשות בעזרת מוצר אחד.

הסדרה המשולבת )Integrated )של NUDURA משלבת מוצרי מעטפת מבנה, שיחד עם קו מוצרי תבניות הבטון המבודדות שלנו מאפשרים לכם להגיע ליעילות האנרגיה המרבית. כל מוצרי הסדרה המשולבת תוכננו להתקנה מהירה ויעילה ולהחלפת שיטות בידוד מסורתיות רבות, שיטות הדורשות הרבה יותר עבודת התקנה.

## מוצרים חדשניים

# יחידת תבנית סטנדרטית – מורכבת

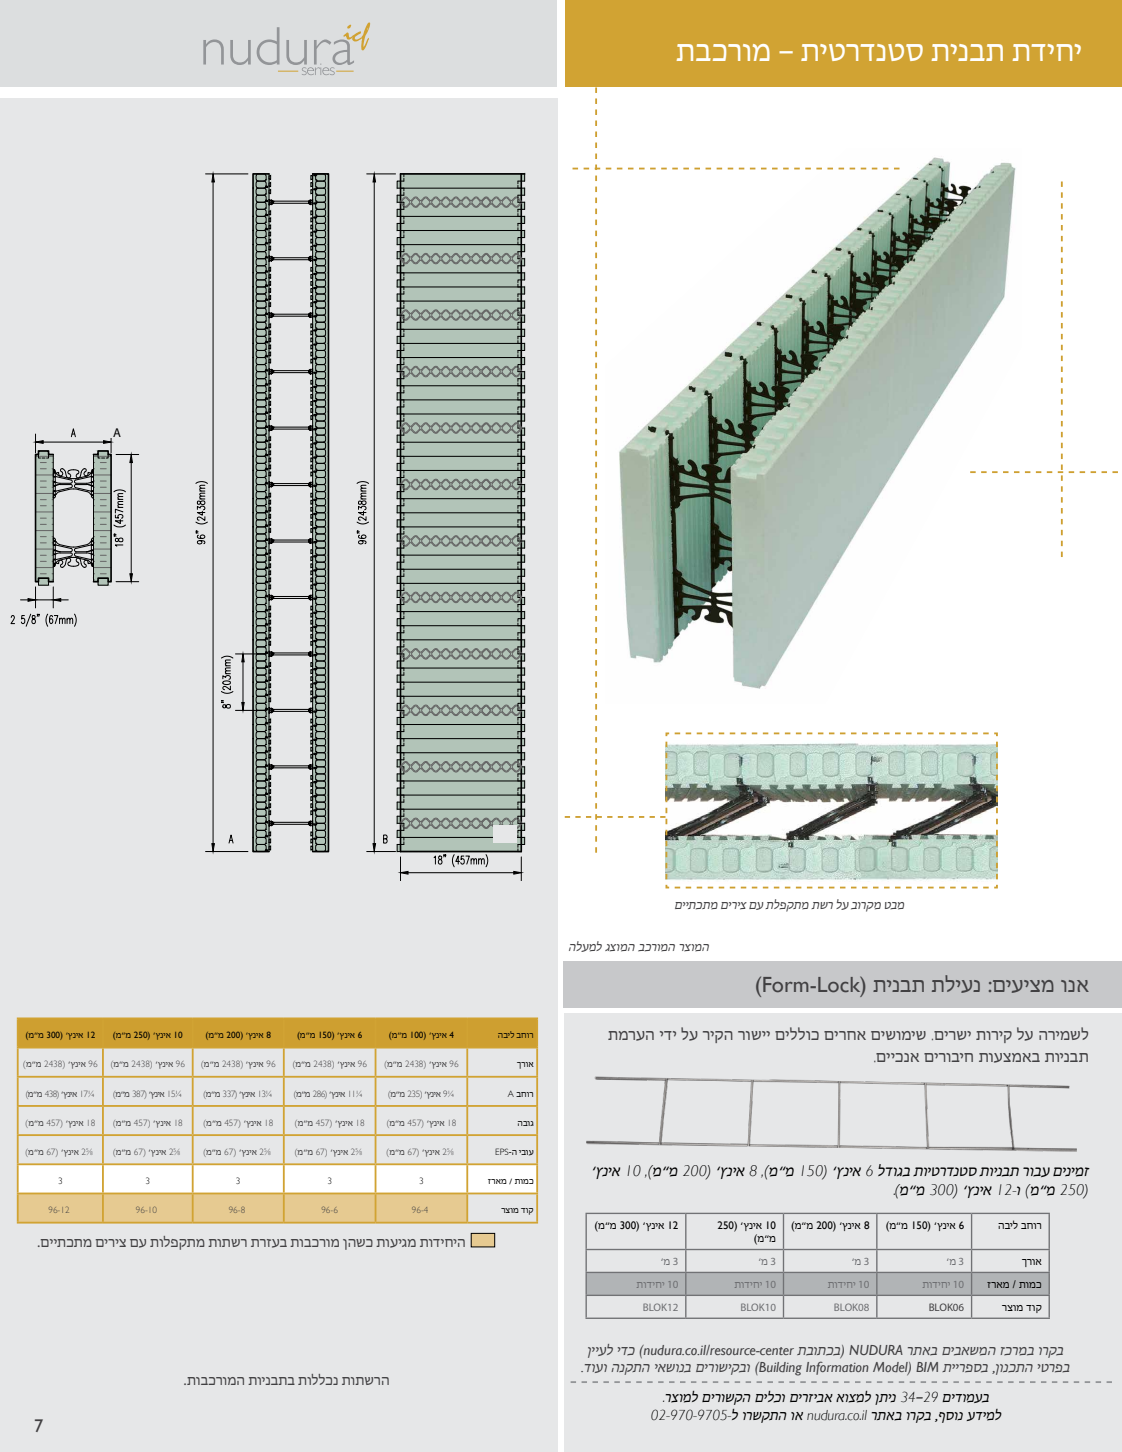
[picture p105: page 7]
)250 מ“מ( ו12- אינץ‘ )300 מ“מ(.; ⁄8 2 אינץ‘ )67 מ“מ(; עובי ה-EPS 2 אינץ‘ )67 מ“מ(; כמות / מארז 3 3 3 3 3; 12 אינץ‘ )300 מ“מ(

מבט מקרוב על רשת מתקפלת עם צירים מתכתיים

המוצר המורכב המוצג למעלה

אנו מציעים: נעילת תבנית )Lock-Form)

רוחב ליבה 4 אינץ‘ )100 מ“מ( 6 אינץ‘ )150 מ“מ( 8 אינץ‘ )200 מ“מ( 10 אינץ‘ )250 מ“מ( 12 אינץ‘ )300 מ“מ(

לשמירה על קירות ישרים. שימושים אחרים כוללים יישור הקיר על ידי הערמת

תבניות באמצעות חיבורים אנכיים.

אורך 96 אינץ‘ )2438 מ“מ( 96 אינץ‘ )2438 מ“מ( 96 אינץ‘ )2438 מ“מ( 96 אינץ‘ )2438 מ“מ( 96 אינץ‘ )2438 מ“מ(

רוחב A¼ 9 אינץ‘ )235 מ“מ( 1/411 אינץ‘ )286 מ“מ( 1/413 אינץ‘ )337 מ“מ( 1/415 אינץ‘ )387 מ“מ( 1/417 אינץ‘ )438 מ“מ(

גובה 18 אינץ‘ )457 מ“מ( 18 אינץ‘ )457 מ“מ( 18 אינץ‘ )457 מ“מ( 18 אינץ‘ )457 מ“מ( 18 אינץ‘ )457 מ“מ(

זמינים עבור תבניות סטנדרטיות בגודל 6 אינץ‘ )150 מ“מ(, 8 אינץ‘ )200 מ“מ(, 10 אינץ‘

קוד מוצר 96-4 96-6 96-8 96-10 96-12
היחידות מגיעות כשהן מורכבות בעזרת רשתות מתקפלות עם צירים מתכתיים.

רוחב ליבה 6 אינץ‘ )150 מ“מ( 8 אינץ‘ )200 מ“מ( 10 אינץ‘ )250

אורך 3 מ‘ 3 מ‘ 3 מ‘ 3 מ‘
כמות / מארז 10 יחידות 10 יחידות 10 יחידות 10 יחידות
קוד מוצר 06BLOK 08BLOK 10BLOK 12BLOK

בקרו במרכז המשאבים באתר NUDURA( בכתובת center-resource/il.co.nudura )כדי לעיין
בפרטי התכנון, בספריית BIM( Model Information Building )ובקישורים בנושאי התקנה ועוד.

הרשתות נכללות בתבניות המורכבות.

בעמודים 29–34 ניתן למצוא אביזרים וכלים הקשורים למוצר.
למידע נוסף, בקרו באתר il.co.nudura או התקשרו ל02-970-9705-

# יחידת תבנית 90° – מורכבת

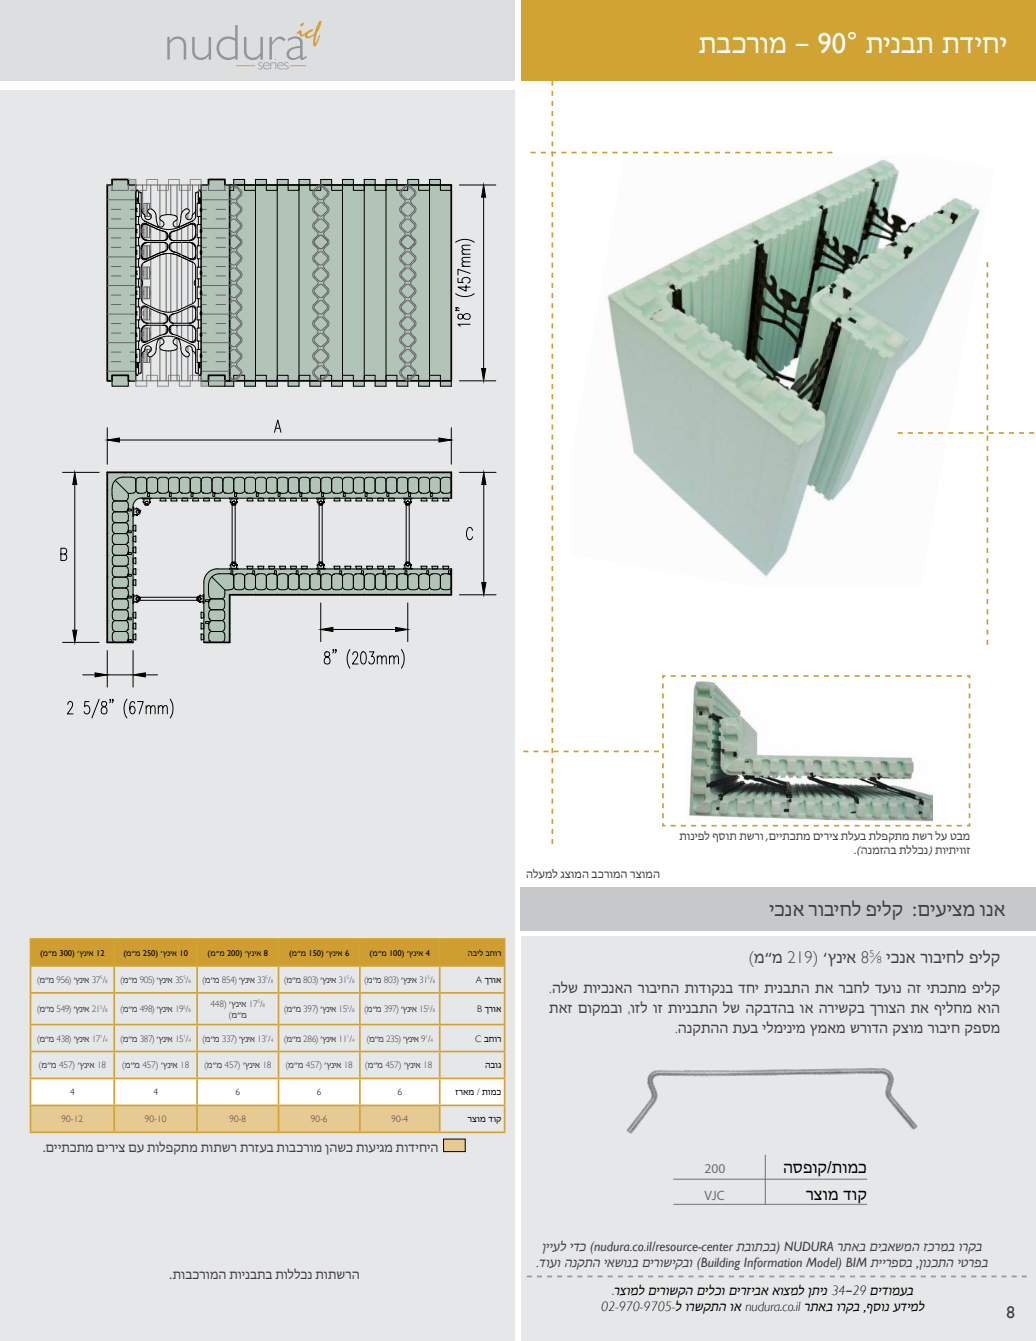
[picture p106: page 8]

מבט על רשת מתקפלת בעלת צירים מתכתיים, ורשת תוסף לפינות

זוויתיות )נכללת בהזמנה(.

המוצר המורכב המוצג למעלה

אנו מציעים: קליפ לחיבור אנכי

רוחב ליבה 4 אינץ‘ )100 מ“מ( 6 אינץ‘ )150 מ“מ( 8 אינץ‘ )200 מ“מ( 10 אינץ‘ )250 מ“מ( 12 אינץ‘ )300 מ“מ(

קליפ לחיבור אנכי 8⁵⁄8 אינץ‘ )219 מ“מ(

5 /8 | 5 /8 37 אינץ‘ )956 מ“מ( | 5 /8 35 אינץ‘ )905 מ“מ( | 5 /8 33 אינץ‘ )854 מ“מ( | 5 /8 31 אינץ‘ )803 מ“מ( | אורך A 31 אינץ‘ )803 מ“מ(

קליפ מתכתי זה נועד לחבר את התבנית יחד בנקודות החיבור האנכיות שלה.
הוא מחליף את הצורך בקשירה או בהדבקה של התבניות זו לזו, ובמקום זאת

5 /8 | 19⁵ אינץ‘ )498 מ“מ( /8 21 אינץ‘ )549 מ“מ( | 17⁵ אינץ‘ )448 /8 מ“מ( | 5 /8 | 5 /8 15 אינץ‘ )397 מ“מ( | אורך B 15 אינץ‘ )397 מ“מ(

מספק חיבור מוצק הדורש מאמץ מינימלי בעת ההתקנה.

1 /4 | 1 /4 17 אינץ‘ )438 מ“מ( | 1 /4 15 אינץ‘ )387 מ“מ( | 1 /4 13 אינץ‘ )337 מ“מ( | 1 /4 11 אינץ‘ )286 מ“מ( | רוחב C 9 אינץ‘ )235 מ“מ(

גובה 18 אינץ‘ )457 מ“מ( 18 אינץ‘ )457 מ“מ( 18 אינץ‘ )457 מ“מ( 18 אינץ‘ )457 מ“מ( 18 אינץ‘ )457 מ“מ(

כמות / מארז 6 6 6 4 4

קוד מוצר 90-4 90-6 90-8 90-10 90-12

היחידות מגיעות כשהן מורכבות בעזרת רשתות מתקפלות עם צירים מתכתיים.

כמות/קופסה 200
קוד מוצר VJC

בקרו במרכז המשאבים באתר NUDURA( בכתובת center-resource/il.co.nudura )כדי לעיין
בפרטי התכנון, בספריית BIM( Model Information Building )ובקישורים בנושאי התקנה ועוד.

הרשתות נכללות בתבניות המורכבות.

למידע נוסף, בקרו באתר il.co.nudura או התקשרו ל02-970-9705-

# יחידת תבנית 45° – מורכבת

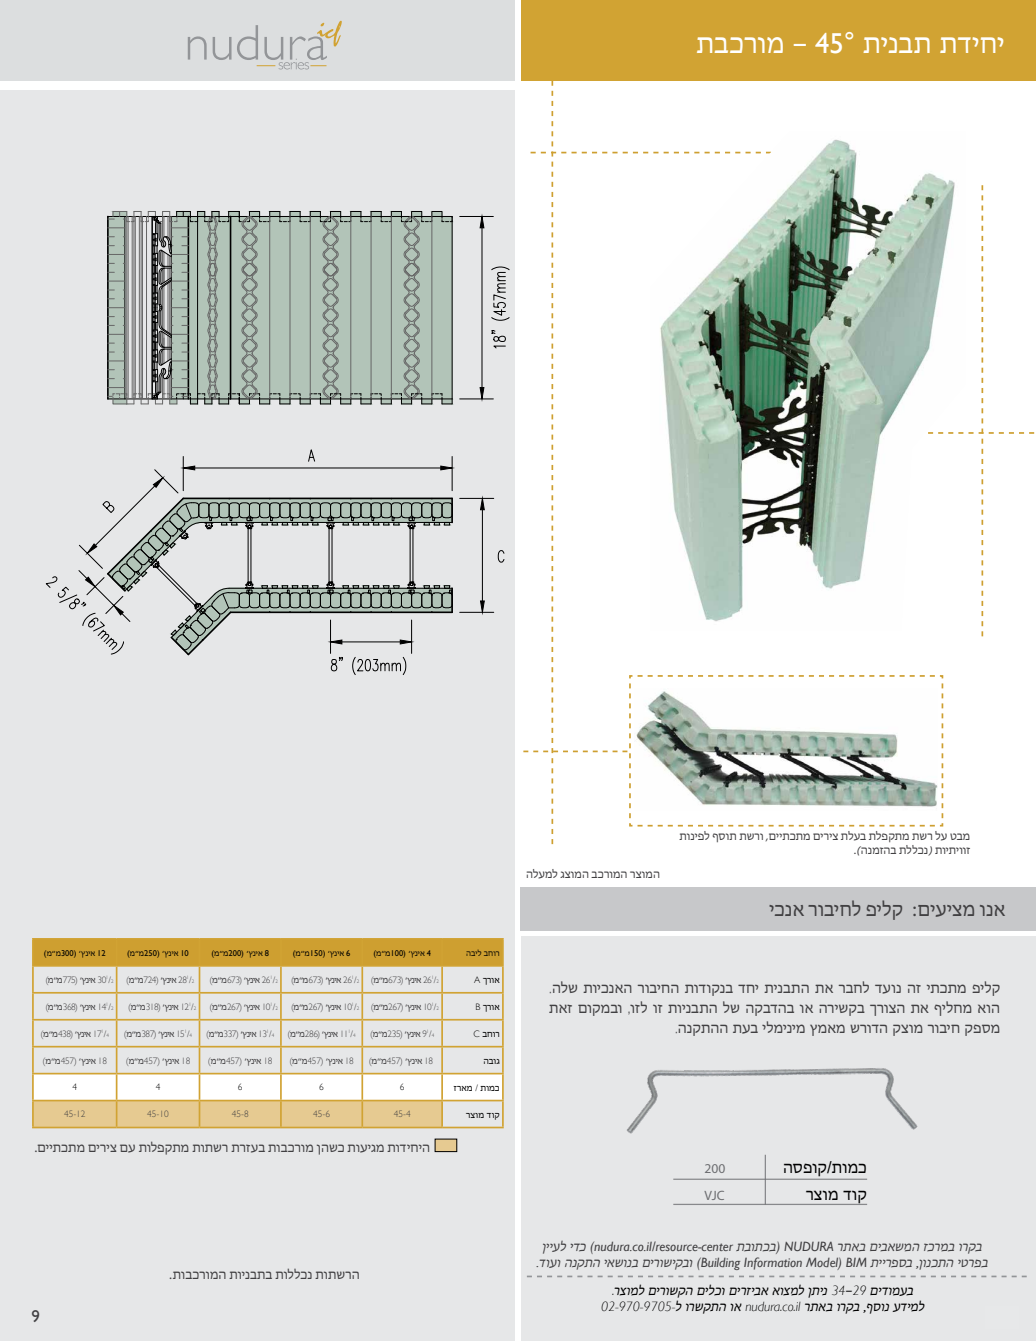
[picture p107: page 9]

מבט על רשת מתקפלת בעלת צירים מתכתיים, ורשת תוסף לפינות

זוויתיות )נכללת בהזמנה(.

המוצר המורכב המוצג למעלה

אנו מציעים: קליפ לחיבור אנכי

רוחב ליבה 4 אינץ‘ )100מ“מ( 6 אינץ‘ )150מ“מ( 8 אינץ‘ )200מ“מ( 10 אינץ‘ )250מ“מ( 12 אינץ‘ )300מ“מ(

1 /2 | 1 /2 30 אינץ‘ )775מ“מ( | 1 /2 28 אינץ‘ )724מ“מ( | 1 /2 26 אינץ‘ )673מ“מ( | 1 /2 26 אינץ‘ )673מ“מ( | אורך A 26 אינץ‘ )673מ“מ(

קליפ מתכתי זה נועד לחבר את התבנית יחד בנקודות החיבור האנכיות שלה.
הוא מחליף את הצורך בקשירה או בהדבקה של התבניות זו לזו, ובמקום זאת

1 /2 | 1 /2 14 אינץ‘ )368מ“מ( | 1 /2 12 אינץ‘ )318מ“מ( | 1 /2 10 אינץ‘ )267מ“מ( | 1 /2 10 אינץ‘ )267מ“מ( | אורך B 10 אינץ‘ )267מ“מ(

מספק חיבור מוצק הדורש מאמץ מינימלי בעת ההתקנה.

1 /4 | 1 /4 17 אינץ‘ )438מ“מ( | 1 /4 15 אינץ‘ )387מ“מ( | 1 /4 13 אינץ‘ )337מ“מ( | 1 /4 11 אינץ‘ )286מ“מ( | רוחב C 9 אינץ‘ )235מ“מ(

גובה 18 אינץ‘ )457מ“מ( 18 אינץ‘ )457מ“מ( 18 אינץ‘ )457מ“מ( 18 אינץ‘ )457מ“מ( 18 אינץ‘ )457מ“מ(

כמות / מארז 6 6 6 4 4

קוד מוצר 45-4 45-6 45-8 45-10 45-12

היחידות מגיעות כשהן מורכבות בעזרת רשתות מתקפלות עם צירים מתכתיים.

כמות/קופסה 200
קוד מוצר VJC

בקרו במרכז המשאבים באתר NUDURA( בכתובת center-resource/il.co.nudura )כדי לעיין
בפרטי התכנון, בספריית BIM( Model Information Building )ובקישורים בנושאי התקנה ועוד.

הרשתות נכללות בתבניות המורכבות.

למידע נוסף, בקרו באתר il.co.nudura או התקשרו ל02-970-9705-

# יחידת תבנית עם קצה משופע – מורכבת

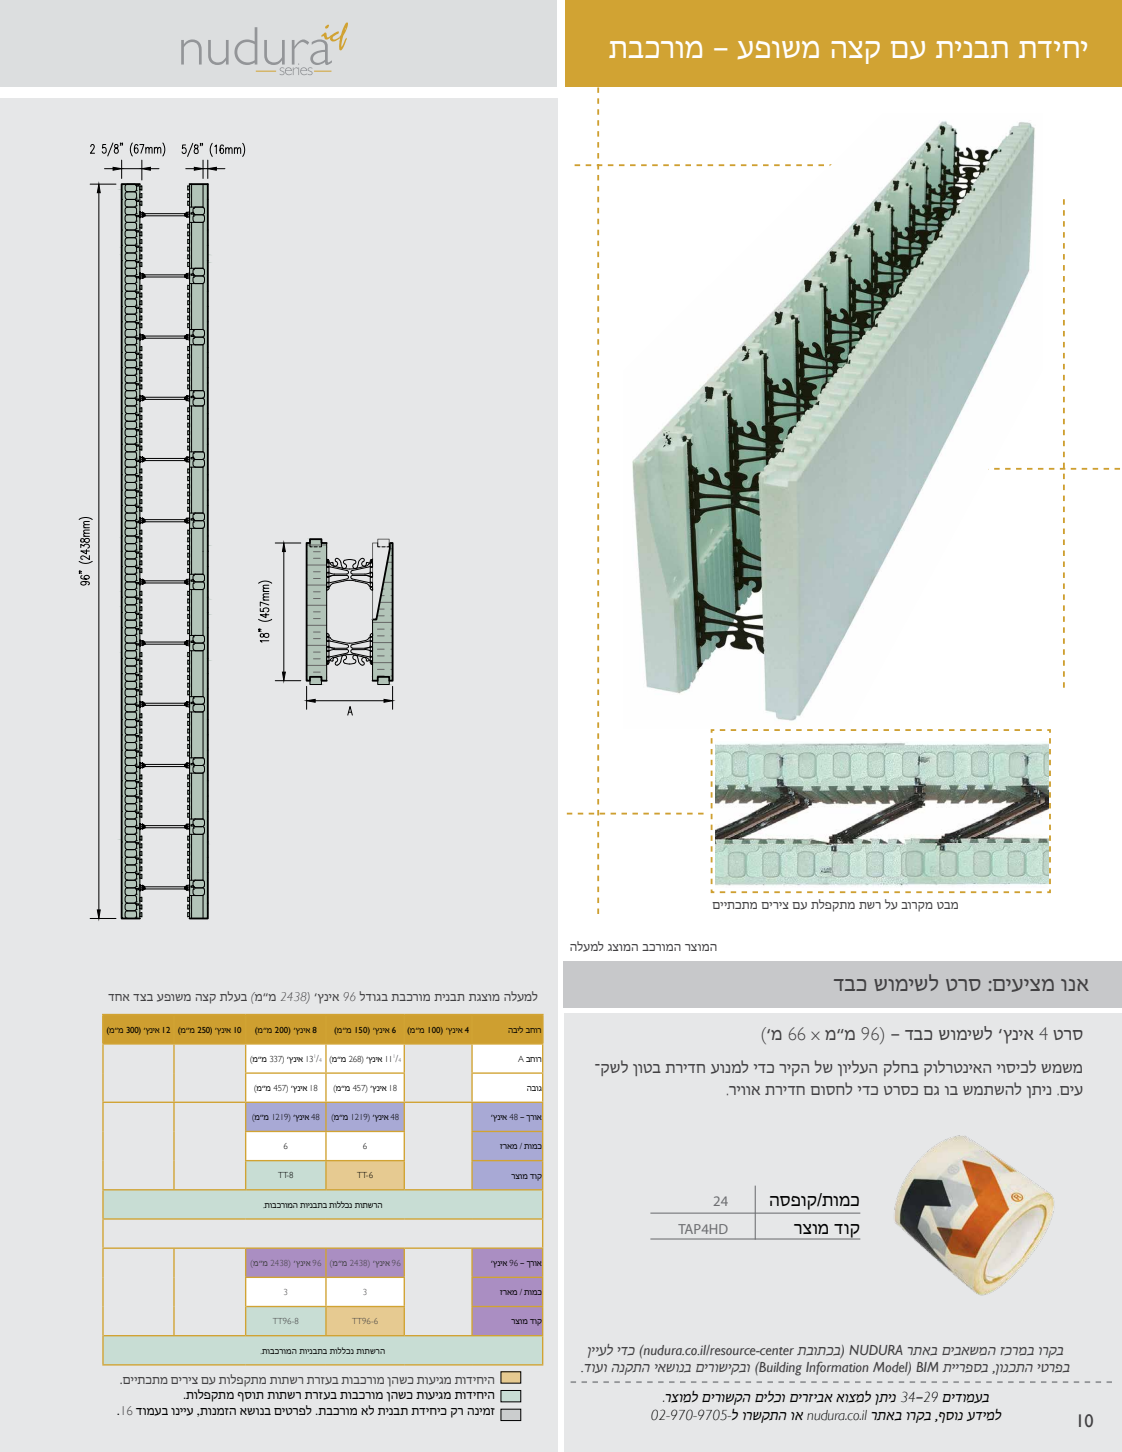
[picture p108: page 10]
כמות/קופסה 24 קוד מוצר HD4TAP; כמות / מארז 3 3; קוד מוצר 96-6TT 96-8TT

מבט מקרוב על רשת מתקפלת עם צירים מתכתיים

המוצר המורכב המוצג למעלה

אנו מציעים: סרט לשימוש כבד

למעלה מוצגת תבנית מורכבת בגודל 96 אינץ‘ )2438 מ“מ( בעלת קצה משופע בצד אחד

רוחב ליבה 4 אינץ‘ )100 מ“מ( 6 אינץ‘ )150 מ“מ( 8 אינץ‘ )200 מ“מ( 10 אינץ‘ )250 מ“מ( 12 אינץ‘ )300 מ“מ(

סרט 4 אינץ‘ לשימוש כבד – )96 מ“מ x 66 מ‘(

1 /4 | 1 /4 13 אינץ‘ )337 מ“מ( | | רוחב A 11 אינץ‘ )268 מ“מ(

מששמש לכיסוי האינטרלוק בחלק העליון של הקיר כדי למנוע חדירת בטון לשק

גובה 18 אינץ‘ )457 מ“מ( 18 אינץ‘ )457 מ“מ(

עים. ניתן להשתמש בו גם כסרט כדי לחסום חדירת אוויר.

אורך – 48 אינץ‘ 48 אינץ‘ )1219 מ“מ( 48 אינץ‘ )1219 מ“מ( כמות / מארז 6 6 קוד מוצר -6TT -8TT

הרשתות נכללות בתבניות המורכבות.

אורך – 96 אינץ‘ 96 אינץ‘ )2438 מ“מ( 96 אינץ‘ )2438 מ“מ(

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

היחידות מגיעות כשהן מורכבות בעזרת רשתות מתקפלות עם צירים מתכתיים.

היחידות מגיעות כשהן מורכבות בעזרת רשתות תוסף מתקפלות.

זמינה רק כיחידת תבנית לא מורכבת. לפרטים בנושא הזמנות, עיינו בעמוד .16

למידע נוסף, בקרו באתר il.co.nudura או התקשרו ל02-970-9705-

# תבנית בסיס דו-צדדית ללבנים – מורכבת

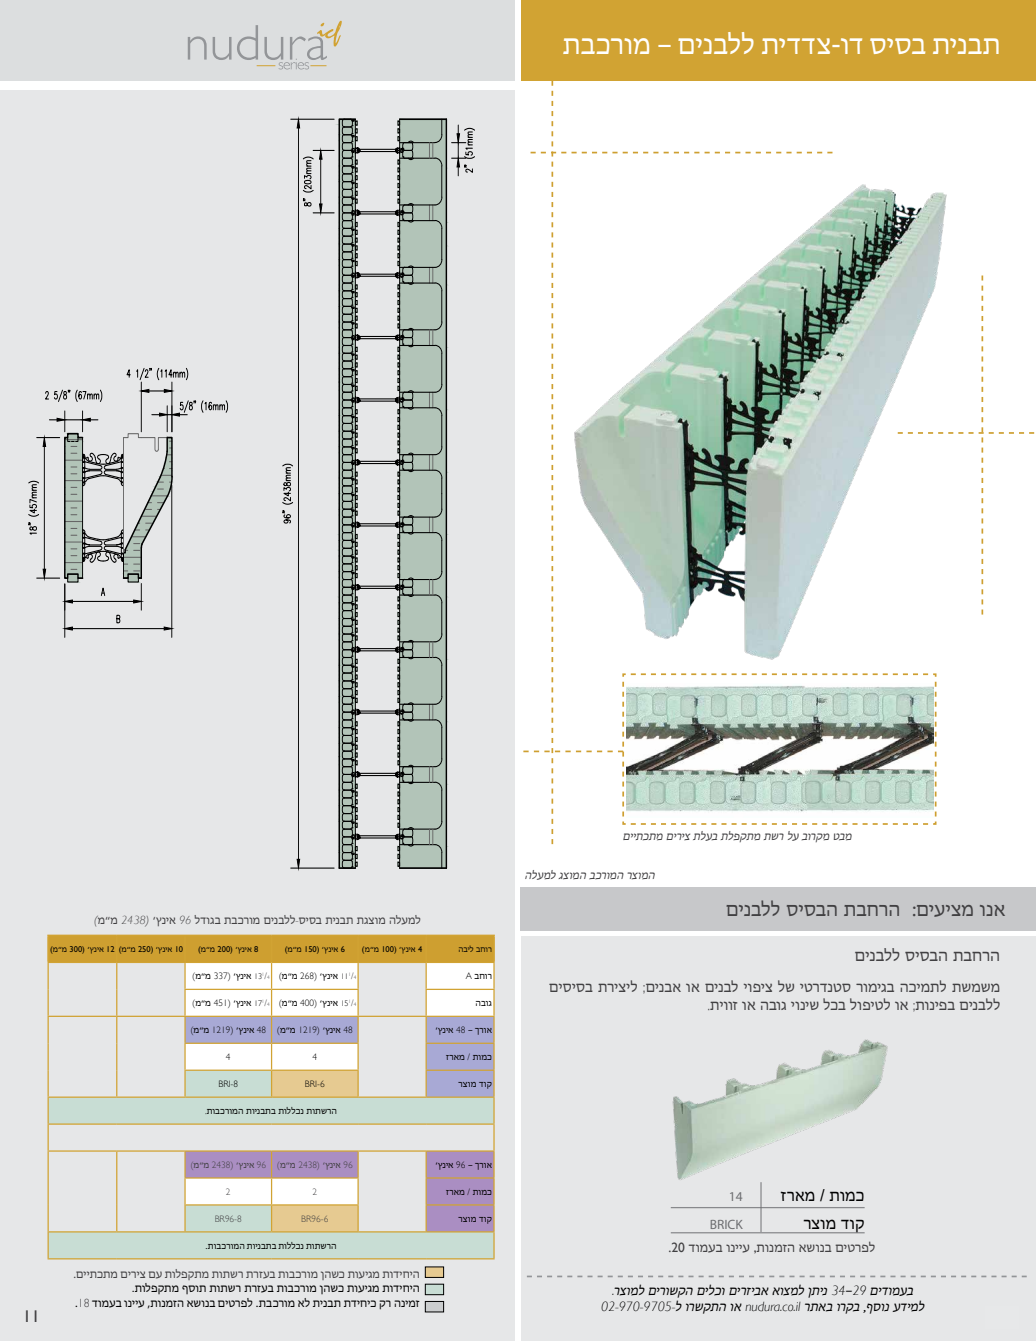
[picture p109: page 11]
/4 13 אינץ‘ )337 מ“מ(; רוחב A 11 אינץ‘ )268 מ“מ(; /4 17 אינץ‘ )451 מ“מ(; גובה 15 אינץ‘ )400 מ“מ(; כמות / מארז 4 4; קוד מוצר -6BRI -8BRI; כמות / מארז 2 2; קוד מוצר 96-6BR 96-8BR

מבט מקרוב על רשת מתקפלת בעלת צירים מתכתיים

המוצר המורכב המוצג למעלה

אנו מציעים: הרחבת הבסיס ללבנים למעלה מוצגת תבנית בסיס-ללבנים מורכבת בגודל 96 אינץ‘ )2438 מ“מ(

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

הרחבת הבסיס ללבנים

משמשת לתמיכה בגימור סטנדרטי של ציפוי לבנים או אבנים; ליצירת בסיסים

ללבנים בפינות; או לטיפול בכל שינוי גובה או זווית.

אורך – 48 אינץ‘ 48 אינץ‘ )1219 מ“מ( 48 אינץ‘ )1219 מ“מ(

הרשתות נכללות בתבניות המורכבות.

אורך – 96 אינץ‘ 96 אינץ‘ )2438 מ“מ( 96 אינץ‘ )2438 מ“מ(

כמות / מארז 14
קוד מוצר BRICK
לפרטים בנושא הזמנות, עיינו בעמוד .20

היחידות מגיעות כשהן מורכבות בעזרת רשתות מתקפלות עם צירים מתכתיים.
בעמודים 29–34 ניתן למצוא אביזרים וכלים הקשורים למוצר. זמינה רק כיחידת תבנית לא מורכבת. לפרטים בנושא הזמנות, עיינו בעמוד .18

היחידות מגיעות כשהן מורכבות בעזרת רשתות תוסף מתקפלות.

למידע נוסף, בקרו באתר il.co.nudura או התקשרו ל02-970-9705-

# תבנית T קצרה ותבנית T ארוכה

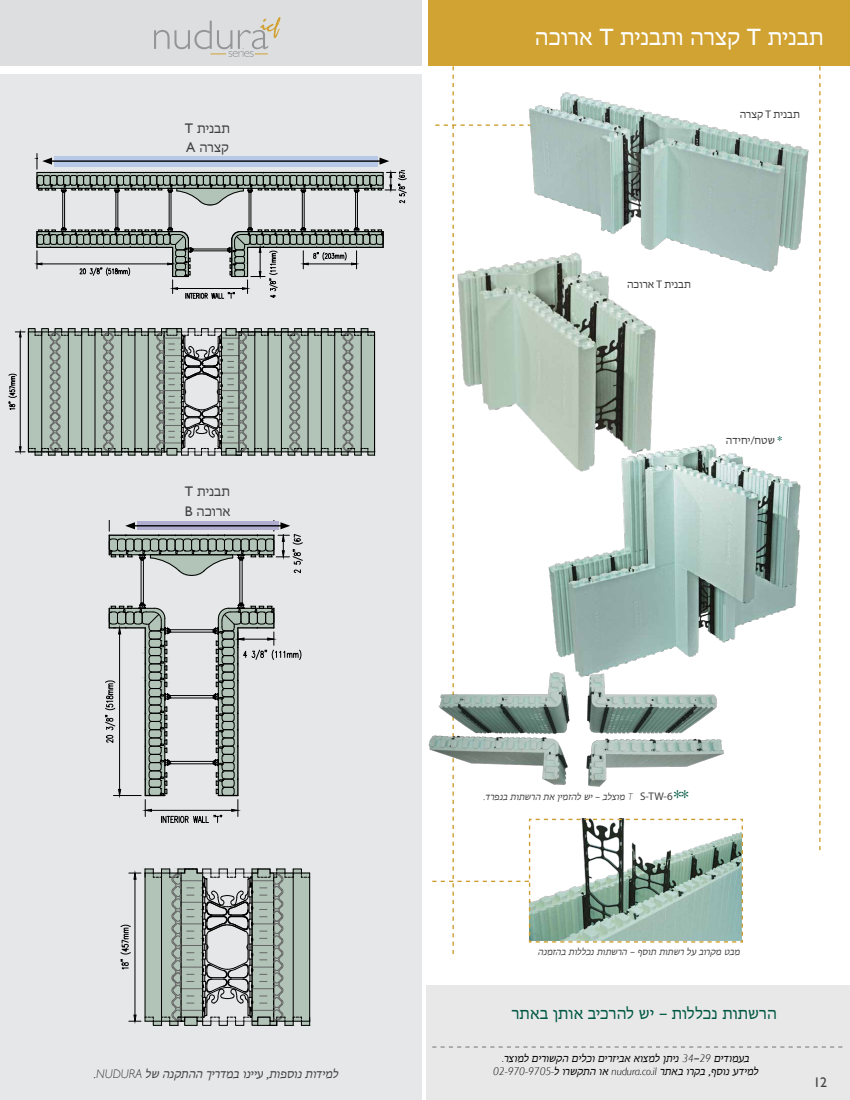
[picture p110: page 12]
תבנית T קצרה; תבנית T ארוכה; * שטח/יחידה; תבנית T קצרה A; תבנית T ארוכה B

** T מוצלב – יש להזמין את הרשתות בנפרד.

מבט מקרוב על רשתות תוסף – הרשתות נכללות בהזמנה

הרשתות נכללות – יש להרכיב אותן באתר

למידות נוספות, עיינו במדריך ההתקנה של NUDURA.

למידע נוסף, בקרו באתר il.co.nudura או התקשרו ל02-970-9705-

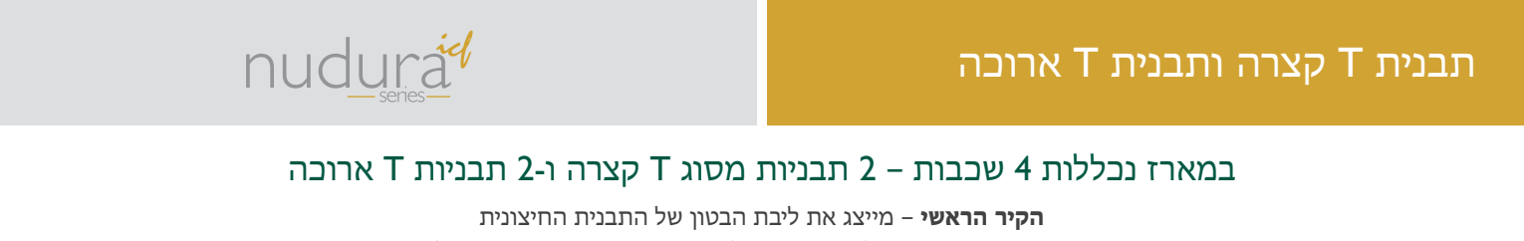
[picture p111: figure]
תבנית T קצרה ותבנית T ארוכה

קיר
פנימי – T
4 אינץ‘
)100 מ“מ(

קיר
פנימי – T
6 אינץ‘
)150 מ“מ(

קיר
פנימי – T
8 אינץ‘
)200 מ“מ(

קיר
פנימי – T
10 אינץ‘
)250 מ“מ(

קיר
פנימי – T
12 אינץ‘
)300 מ“מ(

## במארז נכללות 4 שכבות – 2 תבניות מסוג T קצרה ו2- תבניות T ארוכה

הקיר הראשי – מייצג את ליבת הבטון של התבנית החיצונית ה-T בקיר הפנימי – מייצגת את ליבת הבטון של התבנית הפנימית המתחברת לקיר הראשי

אורך תבנית T קצרה לקיר החיצוני הראשי. הרשתות כלולות. אורך תבנית T ארוכה לקיר החיצוני הראשי. הרשתות כלולות. *שטח/יחידה – יחידה מייצגת תבנית T קצרה אחת ותבנית T ארוכה אחת המחוברות יחד ויוצרות שתי שכבות )ראו תמונה משמאל(.

** בהזמנה מיוחדת: קוד מוצר -6TW-S: תבנית T מוצלבת לא מורכבת – 4 פנלים ל-T מוצלבת )4 יחידות תבנית T מוצלבת במארז( – יש צורך ב32- רשתות למארז. יש להזמין את הרשתות בנפרד. לפרטים בנושא הזמנות של רשתות, עיינו בעמוד .15

הליבה

רוחב קיר ראשי 4 אינץ‘ )100 מ“מ( 6 אינץ‘ )150 מ“מ( 8 אינץ‘ )200 מ“מ( 10 אינץ‘ )250 מ“מ( 12 אינץ‘ )300 מ“מ(

אורך תבנית T קצרה )A )50 אינץ‘ )1270 מ“מ( 50 אינץ‘ )1270 מ“מ( 50 אינץ‘ )1270 מ“מ( 50 אינץ‘ )1270 מ“מ( 50 אינץ‘ )1270 מ“מ(

אורך תבנית T ארוכה )B )18 אינץ‘ )457 מ“מ( 18 אינץ‘ )457 מ“מ( 18 אינץ‘ )457 מ“מ( 18 אינץ‘ )457 מ“מ( 18 אינץ‘ )457 מ“מ(

שטח/יחידה* 1.068 מ“ר 1.068 מ“ר 1.068 מ“ר 1.068 מ“ר 1.068 מ“ר

קוד מארז 4M4-T 6M4-T 8M4-T 10M4-T 12M4-T

אורך תבנית T קצרה )A )52 אינץ‘ )1321 מ“מ( 52 אינץ‘ )1321 מ“מ( 52 אינץ‘ )1321 מ“מ( 52 אינץ‘ )1321 מ“מ( 52 אינץ‘ )1321 מ“מ(

אורך תבנית T ארוכה )B )20 אינץ‘ )508 מ“מ( 20 אינץ‘ )508 מ“מ( 20 אינץ‘ )508 מ“מ( 20 אינץ‘ )508 מ“מ( 20 אינץ‘ )508 מ“מ(

שטח/יחידה* 1.115 מ“ר 1.115 מ“ר 1.115 מ“ר 1.115 מ“ר 1.115 מ“ר

קוד מארז 4M6-T 6M6-T 8M6-T 10M6-T 12M6-T

אורך תבנית T קצרה )A )54 אינץ‘ )1372 מ“מ( 54 אינץ‘ )1372 מ“מ( 54 אינץ‘ )1372 מ“מ( 54 אינץ‘ )1372 מ“מ( 54 אינץ‘ )1372 מ“מ(

אורך תבנית T ארוכה )B )22 אינץ‘ )559 מ“מ( 22 אינץ‘ )559 מ“מ( 22 אינץ‘ )559 מ“מ( 22 אינץ‘ )559 מ“מ( 22 אינץ‘ )559 מ“מ(

שטח/יחידה* 1.161 מ“ר 1.161 מ“ר 1.161 מ“ר 1.161 מ“ר 1.161 מ“ר

קוד מארז 4M8-T 6M8-T 8M8-T 10M8-T 12M8-T

אורך תבנית T קצרה )A )56 אינץ‘ )1422 מ“מ( 56 אינץ‘ )1422 מ“מ( 56 אינץ‘ )1422 מ“מ( 56 אינץ‘ )1422 מ“מ( 56 אינץ‘ )1422 מ“מ(

אורך תבנית T ארוכה )B )24 אינץ‘ )610 מ“מ( 24 אינץ‘ )610 מ“מ( 24 אינץ‘ )610 מ“מ( 24 אינץ‘ )610 מ“מ( 24 אינץ‘ )610 מ“מ(

שטח/יחידה* 1.208 מ“ר 1.208 מ“ר 1.208 מ“ר 1.208 מ“ר 1.208 מ“ר

קוד מארז 4M10-T 6M10-T 8M10-T 10M10T 12M10T

אורך תבנית T קצרה )A )58 אינץ‘ )1473 מ“מ( 58 אינץ‘ )1473 מ“מ( 58 אינץ‘ )1473 מ“מ( 58 אינץ‘ )1473 מ“מ( 58 אינץ‘ )1473 מ“מ(

אורך תבנית T ארוכה )B )26 אינץ‘ )660 מ“מ( 26 אינץ‘ )660 מ“מ( 26 אינץ‘ )660 מ“מ( 26 אינץ‘ )660 מ“מ( 26 אינץ‘ )660 מ“מ(

שטח/יחידה* 1.254 מ“ר 1.254 מ“ר 1.254 מ“ר 1.254 מ“ר 1.254 מ“ר

קוד מארז 4M12-T 6M12-T 8M12-T 10M12T 12M12T

# יחידת תבנית רדיוס

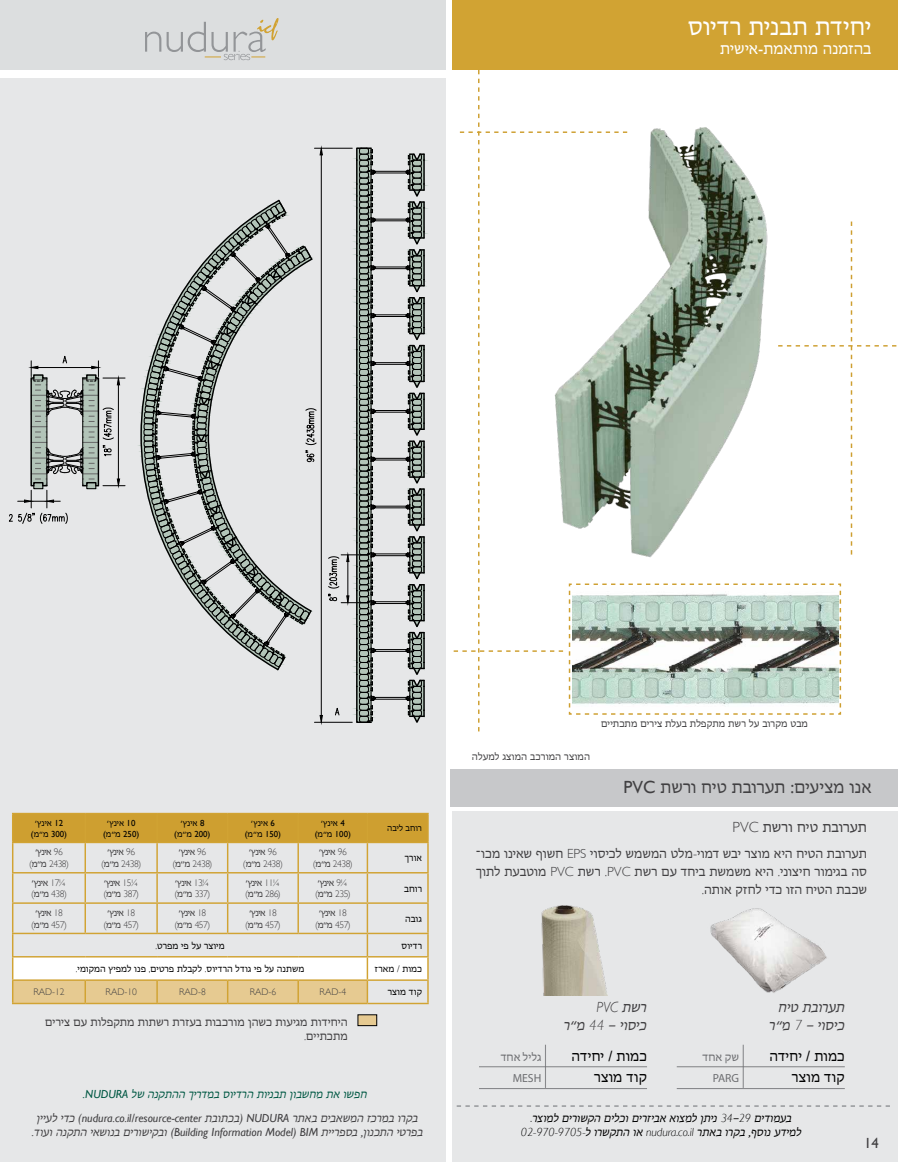
[picture p112: page 14]
מתכתיים.; רשת PVC כיסוי – 44 מ“ר; תערובת טיח כיסוי – 7 מ“ר; 4 אינץ‘; רוחב ליבה; 6 אינץ‘ )150 מ“מ(; 8 אינץ‘ )200 מ“מ(; 10 אינץ‘ )250 מ“מ(; 12 אינץ‘ )300 מ“מ(; 96 אינץ‘; אורך; 96 אינץ‘ )2438 מ“מ(; 1/49 אינץ‘; רוחב; 1/411 אינץ‘ )286 מ“מ(; 1/413 אינץ‘ )337 מ“מ(; 1/415 אינץ‘ )387 מ“מ(; 1/417 אינץ‘ )438 מ“מ(; 18 אינץ‘; גובה; 18 אינץ‘ )457 מ“מ(; רדיוס מיוצר על פי מפרט.; קוד מוצר -4RAD -6RAD -8RAD -10RAD -12RAD

בהזמנה מותאמת-אישית

מבט מקרוב על רשת מתקפלת בעלת צירים מתכתיים

המוצר המורכב המוצג למעלה

אנו מציעים: תערובת טיח ורשת PVC

תערובת טיח ורשת PVC

תערותבת הטיח היא מוצר יבש דמוי-מלט המשמש לכיסוי EPS חשוף שאינו מכו
סה בגימור חיצוני. היא משמשת ביחד עם רשת PVC. רשת PVC מוטבעת לתוך

שכבת הטיח הזו כדי לחזק אותה.

כמות / מארז משתנה על פי גודל הרדיוס. לקבלת פרטים, פנו למפיץ המקומי.

היחידות מגיעות כשהן מורכבות בעזרת רשתות מתקפלות עם צירים

כמות / יחידה גליל אחד
קוד מוצר MESH

כמות / יחידה שק אחד
קוד מוצר PARG

חפשו את מחשבון תבניות הרדיוס במדריך ההתקנה של NUDURA.

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

למידע נוסף, בקרו באתר il.co.nudura או התקשרו ל02-970-9705-

# יחידת תבנית סטנדרטית – לא מורכבת

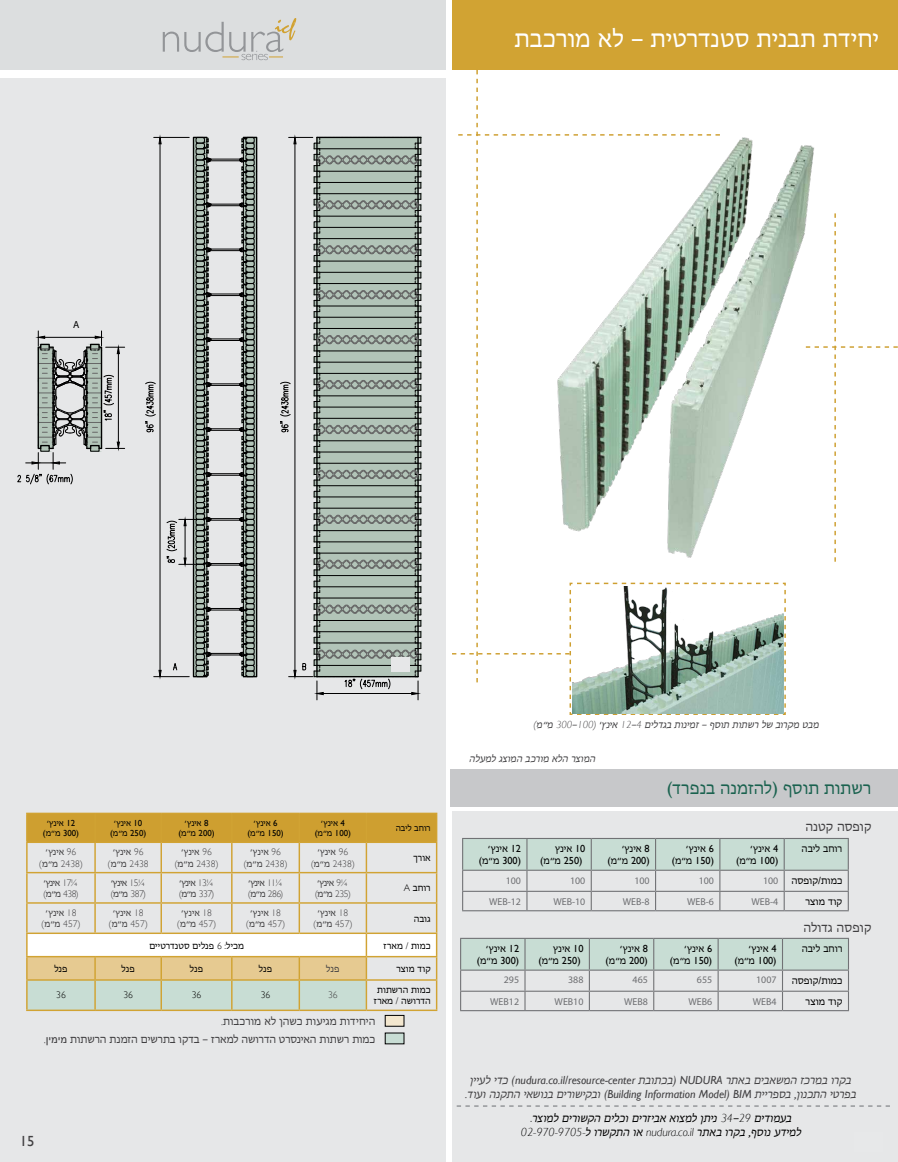
[picture p113: page 15]
קופסה קטנה; קופסה גדולה; 6 אינץ‘ )150 מ“מ(; 8 אינץ‘ )200 מ“מ(; 10 אינץ )250 מ“מ(; 12 אינץ‘ )300 מ“מ(; כמות/קופסה 1007 655 465 388 295; קוד מוצר 4WEB 6WEB 8WEB 10WEB 12WEB; כמות/קופסה 100 100 100 100 100; קוד מוצר -4WEB -6WEB -8WEB -10WEB -12WEB

מבט מקרוב של רשתות תוסף – זמינות בגדלים 4–12 אינץ‘ )100–300 מ“מ(

המוצר הלא מורכב המוצג למעלה

רשתות תוסף )להזמנה בנפרד(

12 אינץ‘ )300 מ“מ( | 10 אינץ‘ )250 מ“מ( | 8 אינץ‘ )200 מ“מ( | 6 אינץ‘ )150 מ“מ( | 4 אינץ‘ )100 מ“מ( | רוחב ליבה

96 אינץ‘ )2438 מ“מ( | 96 אינץ‘ 2438 מ“מ( | 96 אינץ‘ )2438 מ“מ( | 96 אינץ‘ )2438 מ“מ( | 96 אינץ‘ )2438 מ“מ( | אורך

רוחב ליבה 4 אינץ‘

1/417 אינץ‘ )438 מ“מ( | 1/415 אינץ‘ )387 מ“מ( | 1/413 אינץ‘ )337 מ“מ( | 1/411 אינץ‘ )286 מ“מ( | 1/49 אינץ‘ )235 מ“מ( | רוחב A

18 אינץ‘ )457 מ“מ( | 18 אינץ‘ )457 מ“מ( | 18 אינץ‘ )457 מ“מ( | 18 אינץ‘ )457 מ“מ( | 18 אינץ‘ )457 מ“מ( | גובה

כמות / מארז מכיל: 6 פנלים סטנדרטיים

קוד מוצר פנל פנל פנל פנל פנל
36 36 36 36 36 | כמות הרשתות הדרושה / מארז

היחידות מגיעות כשהן לא מורכבות.

כמות רשתות האינסרט הדרושה למארז – בדקו בתרשים הזמנת הרשתות מימין.

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

למידע נוסף, בקרו באתר il.co.nudura או התקשרו ל02-970-9705-

# יחידת תבנית עם קצה משופע – לא מורכבת

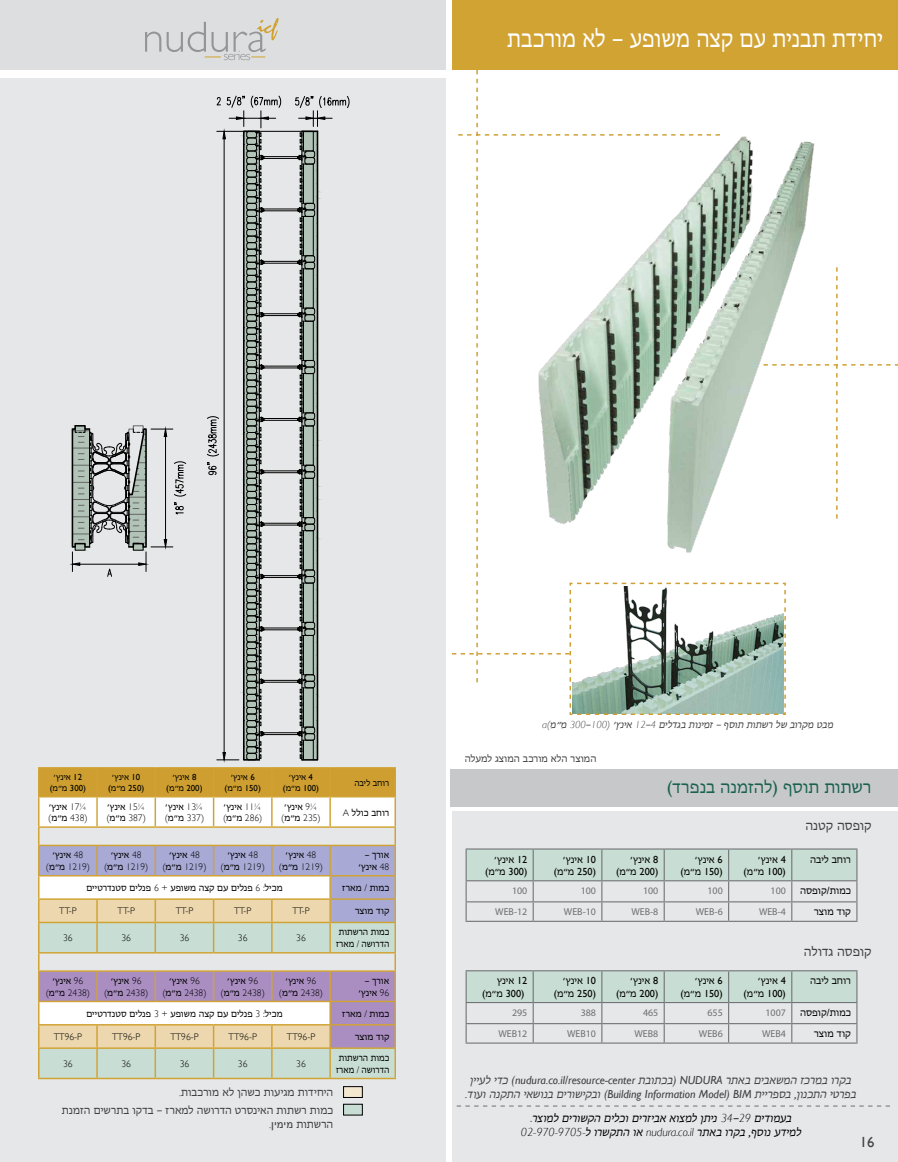
[picture p114: page 16]
קופסה קטנה; קופסה גדולה; הרשתות מימין.; 6 אינץ‘ )150 מ“מ(; 8 אינץ‘ )200 מ“מ(; 10 אינץ‘ )250 מ“מ(; 12 אינץ )300 מ“מ(; כמות/קופסה 1007 655 465 388 295; קוד מוצר 4WEB 6WEB 8WEB 10WEB 12WEB; אורך – 96 אינץ‘; 96 אינץ‘ )2438 מ“מ(; כמות הרשתות; הדרושה / מארז; 12 אינץ‘ )300 מ“מ(; כמות/קופסה 100 100 100 100 100; קוד מוצר -4WEB -6WEB -8WEB -10WEB -12WEB

מבט מקרוב של רשתות תוסף – זמינות בגדלים 4–12 אינץ‘ )100–300 מ“מ(a

המוצר הלא מורכב המוצג למעלה

12 אינץ‘ )300 מ“מ( | 10 אינץ‘ )250 מ“מ( | 8 אינץ‘ )200 מ“מ( | 6 אינץ‘ )150 מ“מ( | 4 אינץ‘ )100 מ“מ( | רוחב ליבה

רשתות תוסף )להזמנה בנפרד(

1/417 אינץ‘ )438 מ“מ( | 1/415 אינץ‘ )387 מ“מ( | 1/413 אינץ‘ )337 מ“מ( | 1/411 אינץ‘ )286 מ“מ( | 1/49 אינץ‘ )235 מ“מ( | רוחב כולל A

48 אינץ‘ )1219 מ“מ( | 48 אינץ‘ )1219 מ“מ( | 48 אינץ‘ )1219 מ“מ( | 48 אינץ‘ )1219 מ“מ( | 48 אינץ‘ )1219 מ“מ( | אורך – 48 אינץ‘

רוחב ליבה 4 אינץ‘

כמות / מארז מכיל: 6 פנלים עם קצה משופע + 6 פנלים סטנדרטיים

קוד מוצר P-TT P-TT P-TT P-TT P-TT
36 36 36 36 36 | כמות הרשתות הדרושה / מארז

96 אינץ‘
כמות / מארז מכיל: 3 פנלים עם קצה משופע + 3 פנלים סטנדרטיים

קוד מוצר P96-TT P96-TT P96-TT P96-TT P96-TT

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

היחידות מגיעות כשהן לא מורכבות.

כמות רשתות האינסרט הדרושה למארז – בדקו בתרשים הזמנת

למידע נוסף, בקרו באתר il.co.nudura או התקשרו ל02-970-9705-

## תבנית עם קצה משופע דו-צדדי – לא מורכבת

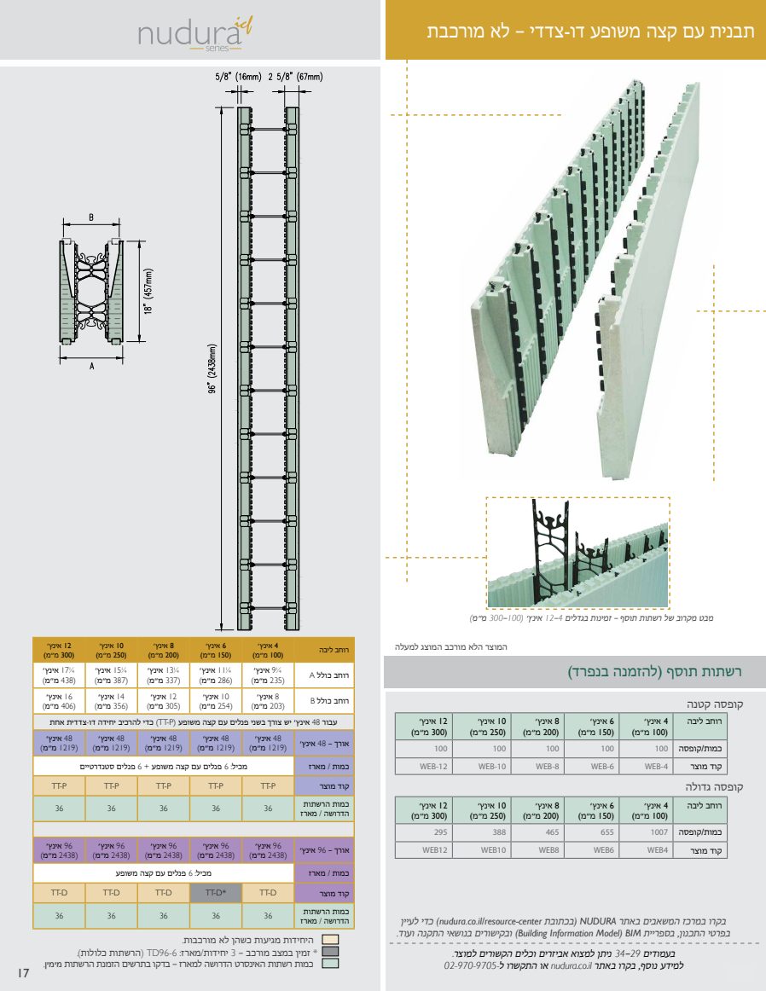
[picture p115: page 17]
6 אינץ‘ )150 מ“מ(; 8 אינץ‘ )200 מ“מ(; 10 אינץ‘ )250 מ“מ(; 12 אינץ‘ )300 מ“מ(; כמות הרשתות; הדרושה / מארז; קופסה קטנה; קופסה גדולה; קוד מוצר -4WEB -6WEB -8WEB -10WEB -12WEB

מבט מקרוב של רשתות תוסף – זמינות בגדלים 4–12 אינץ‘ )100–300 מ“מ(

12 אינץ‘ )300 מ“מ( | 10 אינץ‘ )250 מ“מ( | 8 אינץ‘ )200 מ“מ( | 6 אינץ‘ )150 מ“מ( | 4 אינץ‘ )100 מ“מ( | רוחב ליבה

המוצר הלא מורכב המוצג למעלה

רשתות תוסף )להזמנה בנפרד(

1/417 אינץ‘ )438 מ“מ( | 1/415 אינץ‘ )387 מ“מ( | 1/413 אינץ‘ )337 מ“מ( | 1/411 אינץ‘ )286 מ“מ( | 1/49 אינץ‘ )235 מ“מ( | רוחב כולל A

16 אינץ‘ )406 מ“מ( | 14 אינץ‘ )356 מ“מ( | 12 אינץ‘ )305 מ“מ( | 10 אינץ‘ )254 מ“מ( | 8 אינץ‘ )203 מ“מ( | רוחב כולל B

עבור 48 אינץ‘ יש צורך בשני פנלים עם קצה משופע )P-TT )כדי להרכיב יחידה דו-צדדית אחת

רוחב ליבה 4 אינץ‘

48 אינץ‘ )1219 מ“מ( | 48 אינץ‘ )1219 מ“מ( | 48 אינץ‘ )1219 מ“מ( | 48 אינץ‘ )1219 מ“מ( | 48 אינץ‘ )1219 מ“מ( | אורך – 48 אינץ‘

כמות/קופסה 100 100 100 100 100

כמות / מארז מכיל: 6 פנלים עם קצה משופע + 6 פנלים סטנדרטיים

קוד מוצר P-TT P-TT P-TT P-TT P-TT

כמות/קופסה 1007 655 465 388 295
קוד מוצר 4WEB 6WEB 8WEB 10WEB 12WEB

96 אינץ‘ )2438 מ“מ( | 96 אינץ‘ )2438 מ“מ( | 96 אינץ‘ )2438 מ“מ( | 96 אינץ‘ )2438 מ“מ( | 96 אינץ‘ )2438 מ“מ( | אורך – 96 אינץ‘

כמות / מארז מכיל: 6 פנלים עם קצה משופע

קוד מוצר D-TT* D-TT D-TT D-TT D-TT
36 36 36 36 36 | כמות הרשתות הדרושה / מארז

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

היחידות מגיעות כשהן לא מורכבות.

* זמין במצב מורכב – 3 יחידות/מארז: 96-6TD( הרשתות כלולות(.
כמות רשתות האינסרט הדרושה למארז – בדקו בתרשים הזמנת הרשתות מימין.

למידע נוסף, בקרו באתר il.co.nudura או התקשרו ל02-970-9705-

# תבנית בסיס דו-צדדית ללבנים – לא מורכבת

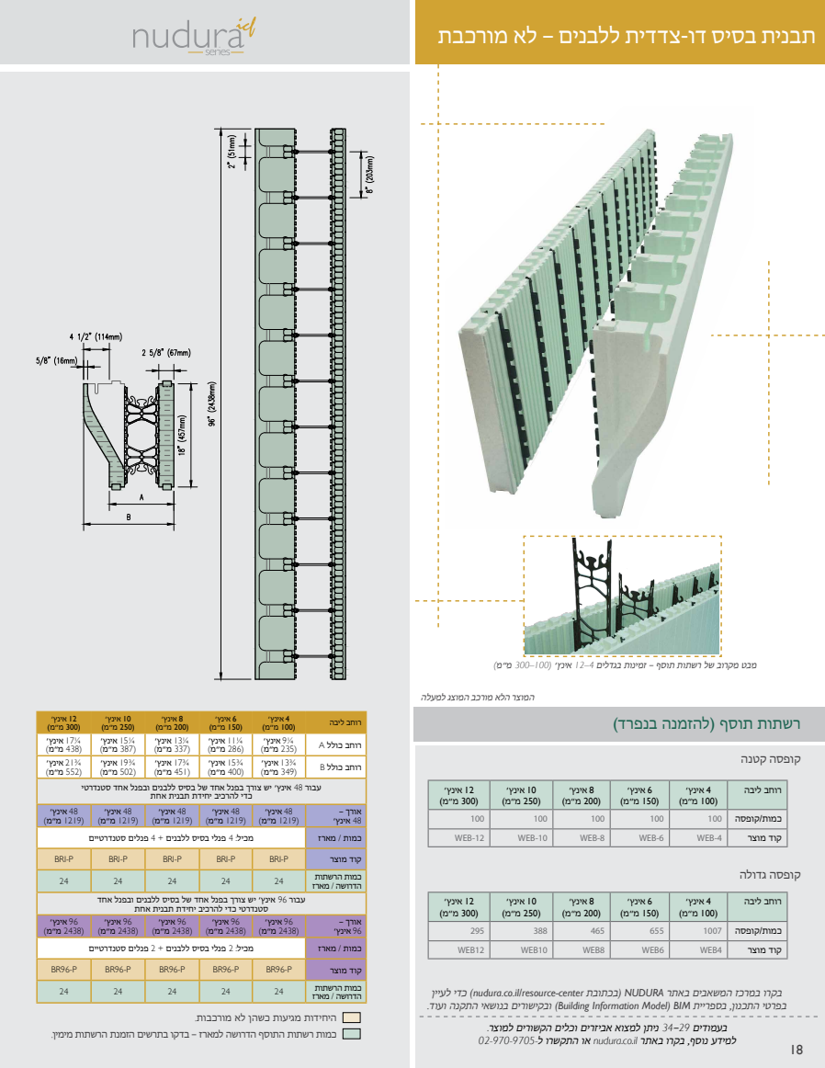
[picture p116: page 18]
6 אינץ‘ )150 מ“מ(; 8 אינץ‘ )200 מ“מ(; 10 אינץ‘ )250 מ“מ(; 12 אינץ‘ )300 מ“מ(; קופסה קטנה; קופסה גדולה; כמות/קופסה 100 100 100 100 100; קוד מוצר -4WEB -6WEB -8WEB -10WEB -12WEB

מבט מקרוב של רשתות תוסף – זמינות בגדלים 4–12 אינץ‘ )100–300 מ“מ(

המוצר הלא מורכב המוצג למעלה

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

רשתות תוסף )להזמנה בנפרד(

1/417 אינץ‘ )438 מ“מ( | 1/415 אינץ‘ )387 מ“מ( | 1/413 אינץ‘ )337 מ“מ( | 1/411 אינץ‘ )286 מ“מ( | 1/49 אינץ‘ )235 מ“מ( | רוחב כולל A

3/421 אינץ‘ )552 מ“מ( | 3/419 אינץ‘ )502 מ“מ( | 3/417 אינץ‘ )451 מ“מ( | 3/415 אינץ‘ )400 מ“מ( | 3/413 אינץ‘ )349 מ“מ( | רוחב כולל B

עבור 48 אינץ‘ יש צורך בפנל אחד של בסיס ללבנים ובפנל אחד סטנדרטי

כדי להרכיב יחידת תבנית אחת

רוחב ליבה 4 אינץ‘

48 אינץ‘ )1219 מ“מ( | 48 אינץ‘ )1219 מ“מ( | 48 אינץ‘ )1219 מ“מ( | 48 אינץ‘ )1219 מ“מ( | 48 אינץ‘ )1219 מ“מ( | אורך – 48 אינץ‘

כמות / מארז מכיל: 4 פנלי בסיס ללבנים + 4 פנלים סטנדרטיים

קוד מוצר P-BRI P-BRI P-BRI P-BRI P-BRI
24 24 24 24 24 | כמות הרשתות הדרושה / מארז

עבור 96 אינץ‘ יש צורך בפנל אחד של בסיס ללבנים ובפנל אחד

סטנדרטי כדי להרכיב יחידת תבנית אחת

96 אינץ‘ )2438 מ“מ( | 96 אינץ‘ )2438 מ“מ( | 96 אינץ‘ )2438 מ“מ( | 96 אינץ‘ )2438 מ“מ( | 96 אינץ‘ )2438 מ“מ( | אורך – 96 אינץ‘

כמות/קופסה 1007 655 465 388 295
קוד מוצר 4WEB 6WEB 8WEB 10WEB 12WEB

כמות / מארז מכיל: 2 פנלי בסיס ללבנים + 2 פנלים סטנדרטיים

קוד מוצר P96-BR P96-BR P96-BR P96-BR P96-BR

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

היחידות מגיעות כשהן לא מורכבות.

כמות רשתות התוסף הדרושה למארז – בדקו בתרשים הזמנת הרשתות מימין.

למידע נוסף, בקרו באתר il.co.nudura או התקשרו ל02-970-9705-

## תבנית בסיס ללבנים דו-צדדית – לא מורכבת

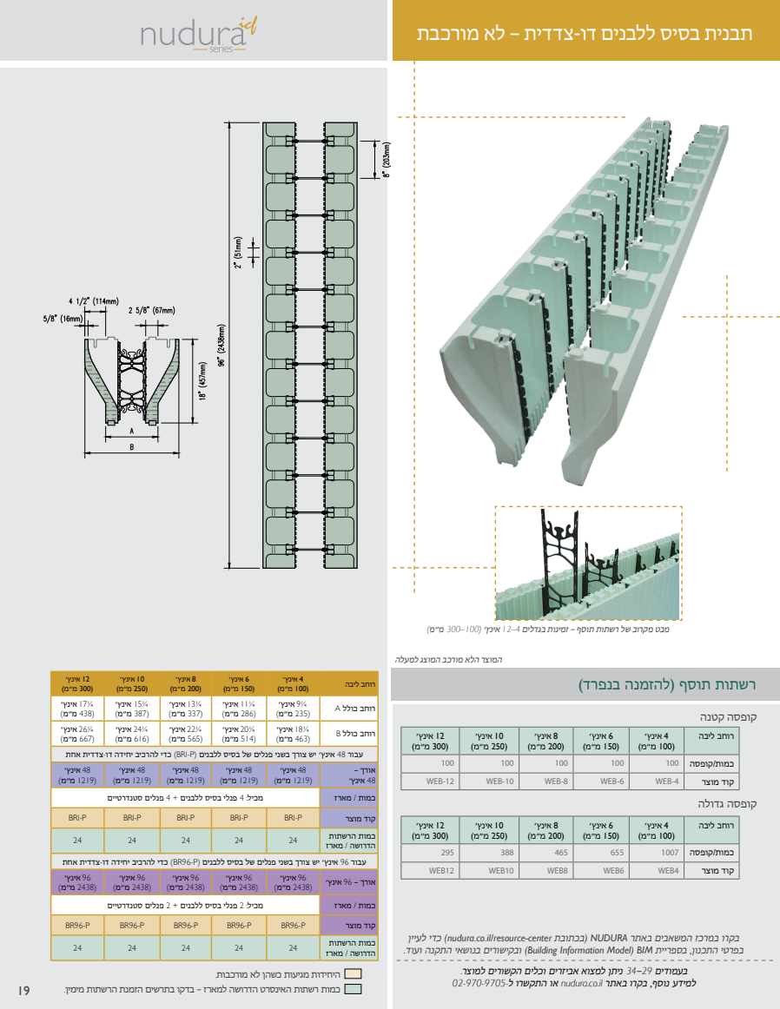
[picture p117: page 19]
קופסה קטנה; קופסה גדולה; 6 אינץ‘ )150 מ“מ(; 8 אינץ‘ )200 מ“מ(; 10 אינץ‘ )250 מ“מ(; 12 אינץ‘ )300 מ“מ(; כמות/קופסה 100 100 100 100 100; קוד מוצר -4WEB -6WEB -8WEB -10WEB -12WEB

מבט מקרוב של רשתות תוסף – זמינות בגדלים 4–12 אינץ‘ )100–300 מ“מ(

המוצר הלא מורכב המוצג למעלה

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

רשתות תוסף )להזמנה בנפרד(

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

1/426 אינץ‘ )667 מ“מ( | 1/424 אינץ‘ )616 מ“מ( | 1/422 אינץ‘ )565 מ“מ( | 1/420 אינץ‘ )514 מ“מ( | 1/418 אינץ‘ )463 מ“מ( | רוחב כולל B

רוחב ליבה 4 אינץ‘

עבור 48 אינץ‘ יש צורך בשני פנלים של בסיס ללבנים )P-BRI )כדי להרכיב יחידה דו-צדדית אחת

48 אינץ‘ )1219 מ“מ( | 48 אינץ‘ )1219 מ“מ( | 48 אינץ‘ )1219 מ“מ( | 48 אינץ‘ )1219 מ“מ( | 48 אינץ‘ )1219 מ“מ( | אורך – 48 אינץ‘

כמות / מארז מכיל: 4 פנלי בסיס ללבנים + 4 פנלים סטנדרטיים

קוד מוצר P-BRI P-BRI P-BRI P-BRI P-BRI
24 24 24 24 24 | כמות הרשתות הדרושה / מארז

12 אינץ‘ )300 מ“מ( | 10 אינץ‘ )250 מ“מ( | 8 אינץ‘ )200 מ“מ( | 6 אינץ‘ )150 מ“מ( | )100 מ“מ( | רוחב ליבה 4 אינץ‘

כמות/קופסה 1007 655 465 388 295
קוד מוצר 4WEB 6WEB 8WEB 10WEB 12WEB

עבור 96 אינץ‘ יש צורך בשני פנלים של בסיס ללבנים )P96-BR )כדי להרכיב יחידה דו-צדדית אחת

96 אינץ‘ )2438 מ“מ( | 96 אינץ‘ )2438 מ“מ( | 96 אינץ‘ )2438 מ“מ( | 96 אינץ‘ )2438 מ“מ( | 96 אינץ‘ )2438 מ“מ( | אורך – 96 אינץ‘

כמות / מארז מכיל: 2 פנלי בסיס ללבנים + 2 פנלים סטנדרטיים

קוד מוצר P96-BR P96-BR P96-BR P96-BR P96-BR

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

היחידות מגיעות כשהן לא מורכבות.

למידע נוסף, בקרו באתר il.co.nudura או התקשרו ל02-970-9705-

כמות רשתות האינסרט הדרושה למארז – בדקו בתרשים הזמנת הרשתות מימין.

# תבנית בסיס ללבנים + קצה משופע – לא מורכבת

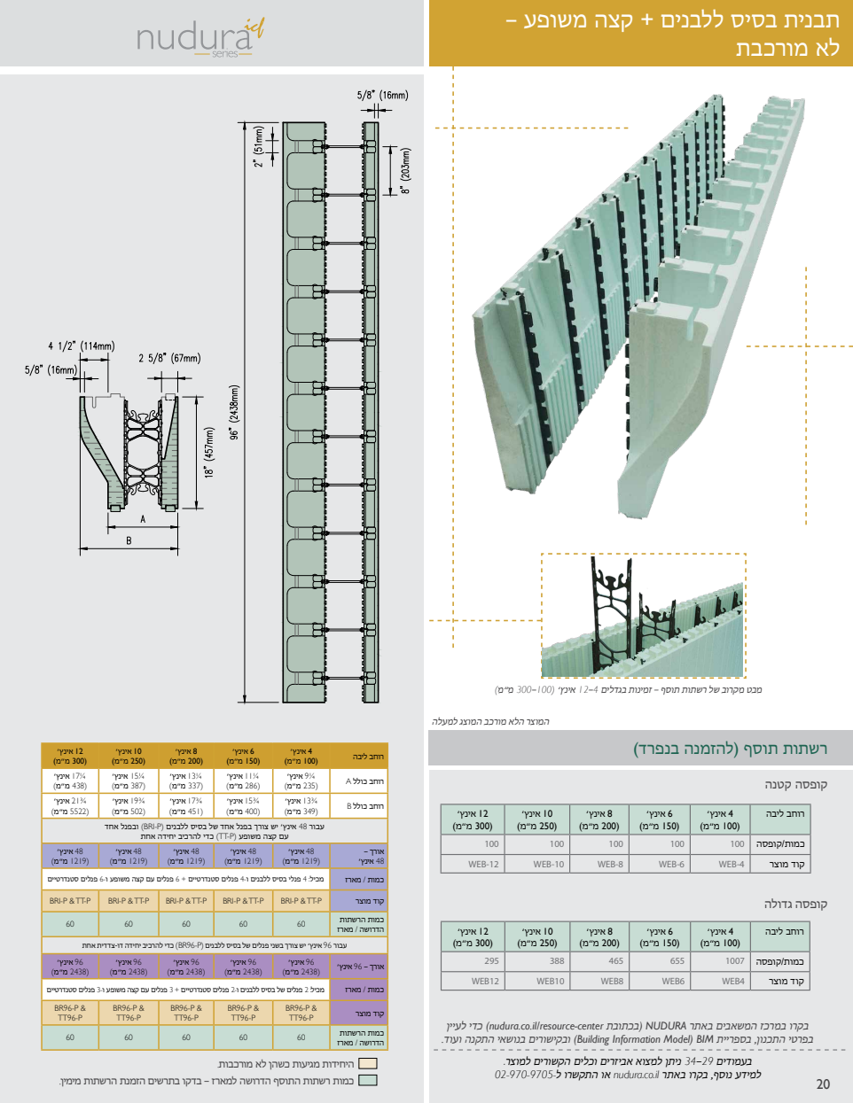
[picture p118: page 20]
6 אינץ‘ )150 מ“מ(; 8 אינץ‘ )200 מ“מ(; 10 אינץ‘ )250 מ“מ(; 12 אינץ‘ )300 מ“מ(; כמות/קופסה 1007 655 465 388 295; קוד מוצר 4WEB 6WEB 8WEB 10WEB 12WEB; 96 אינץ‘; אורך – 96 אינץ‘; 96 אינץ‘ )2438 מ“מ(; קופסה קטנה; קופסה גדולה; כמות/קופסה 100 100 100 100 100; קוד מוצר -4WEB -6WEB -8WEB -10WEB -12WEB

מבט מקרוב של רשתות תוסף – זמינות בגדלים 4–12 אינץ‘ )100–300 מ“מ(

המוצר הלא מורכב המוצג למעלה

רשתות תוסף )להזמנה בנפרד(

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

3/421 אינץ‘ )5522 מ“מ( | 3/419 אינץ‘ )502 מ“מ( | 3/417 אינץ‘ )451 מ“מ( | 3/415 אינץ‘ )400 מ“מ( | 3/413 אינץ‘ )349 מ“מ( | רוחב כולל B

רוחב ליבה 4 אינץ‘

עבור 48 אינץ‘ יש צורך בפנל אחד של בסיס ללבנים )P-BRI )ובפנל אחד

עם קצה משופע )P-TT )כדי להרכיב יחידה אחת

48 אינץ‘ )1219 מ“מ( | 48 אינץ‘ )1219 מ“מ( | 48 אינץ‘ )1219 מ“מ( | 48 אינץ‘ )1219 מ“מ( | 48 אינץ‘ )1219 מ“מ( | אורך – 48 אינץ‘

כמות / מארז מכיל: 4 פנלי בסיס ללבנים ו4- פנלים סטנדרטיים + 6 פנלים עם קצה משופע ו6- פנלים סטנדרטיים

קוד מוצר P-TT & P-BRI P-TT & P-BRI P-TT & P-BRI P-TT & P-BRI P-TT & P-BRI

60 60 60 60 60 | כמות הרשתות הדרושה / מארז

עבור 96 אינץ‘ יש צורך בשני פנלים של בסיס ללבנים )P96-BR )כדי להרכיב יחידה דו-צדדית אחת
96 אינץ‘

כמות / מארז מכיל: 2 פנלים של בסיס ללבנים ו2- פנלים סטנדרטיים + 3 פנלים עם קצה משופע ו3- פנלים סטנדרטיים
& P96-BR P96-TT | & P96-BR P96-TT | & P96-BR P96-TT | & P96-BR P96-TT | & P96-BR P96-TT | קוד מוצר

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

היחידות מגיעות כשהן לא מורכבות.

כמות רשתות התוסף הדרושה למארז – בדקו בתרשים הזמנת הרשתות מימין.

למידע נוסף, בקרו באתר il.co.nudura או התקשרו ל02-970-9705-

## יחידת תבנית אופטימיזציה – לא מורכבת

# Optimizer

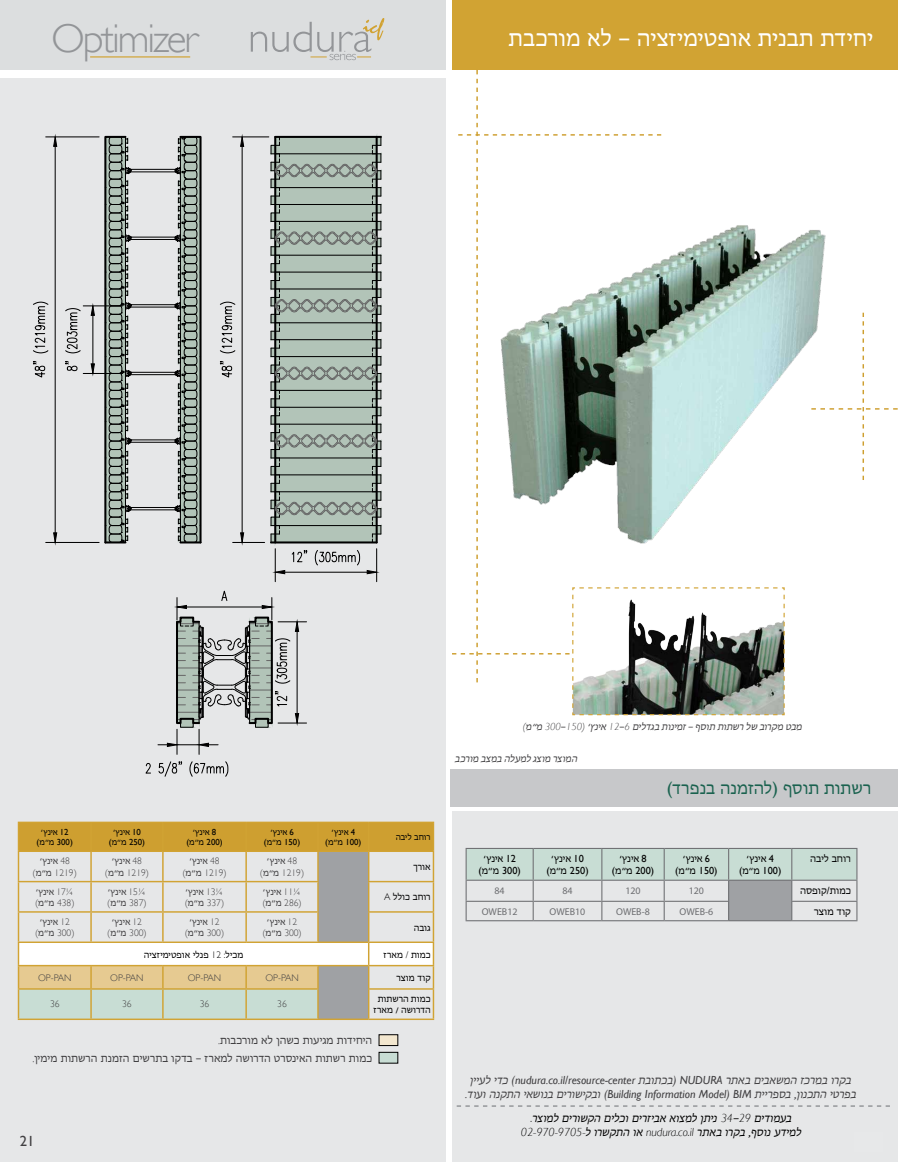
[picture p119: page 21]
6 אינץ‘ )150 מ“מ(; 8 אינץ‘ )200 מ“מ(; 10 אינץ‘ )250 מ“מ(; 12 אינץ‘ )300 מ“מ(; כמות/קופסה 120 120 84 84; קוד מוצר -6OWEB -8OWEB 10OWEB 12OWEB; 4 אינץ‘; רוחב ליבה; 48 אינץ‘; אורך; 48 אינץ‘ )1219 מ“מ(; 1/411 אינץ‘; רוחב כולל A; 1/413 אינץ‘ )337 מ“מ(; 1/415 אינץ‘ )387 מ“מ(; 1/417 אינץ‘ )438 מ“מ(

מבט מקרוב של רשתות תוסף – זמינות בגדלים 6–12 אינץ‘ )150–300 מ“מ(

המוצר מוצג למעלה במצב מורכב

רשתות תוסף )להזמנה בנפרד(

רוחב ליבה 4 אינץ‘

12 אינץ‘ )300 מ“מ( | 12 אינץ‘ )300 מ“מ( | 12 אינץ‘ )300 מ“מ( | 12 אינץ‘ )300 מ“מ( | גובה

כמות / מארז מכיל: 12 פנלי אופטימיזציה

קוד מוצר PAN-OP PAN-OP PAN-OP PAN-OP
36 36 | כמות הרשתות הדרושה / מארז

היחידות מגיעות כשהן לא מורכבות.

כמות רשתות האינסרט הדרושה למארז – בדקו בתרשים הזמנת הרשתות מימין.

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

למידע נוסף, בקרו באתר il.co.nudura או התקשרו ל02-970-9705-

## תבניות Series One NUDURA

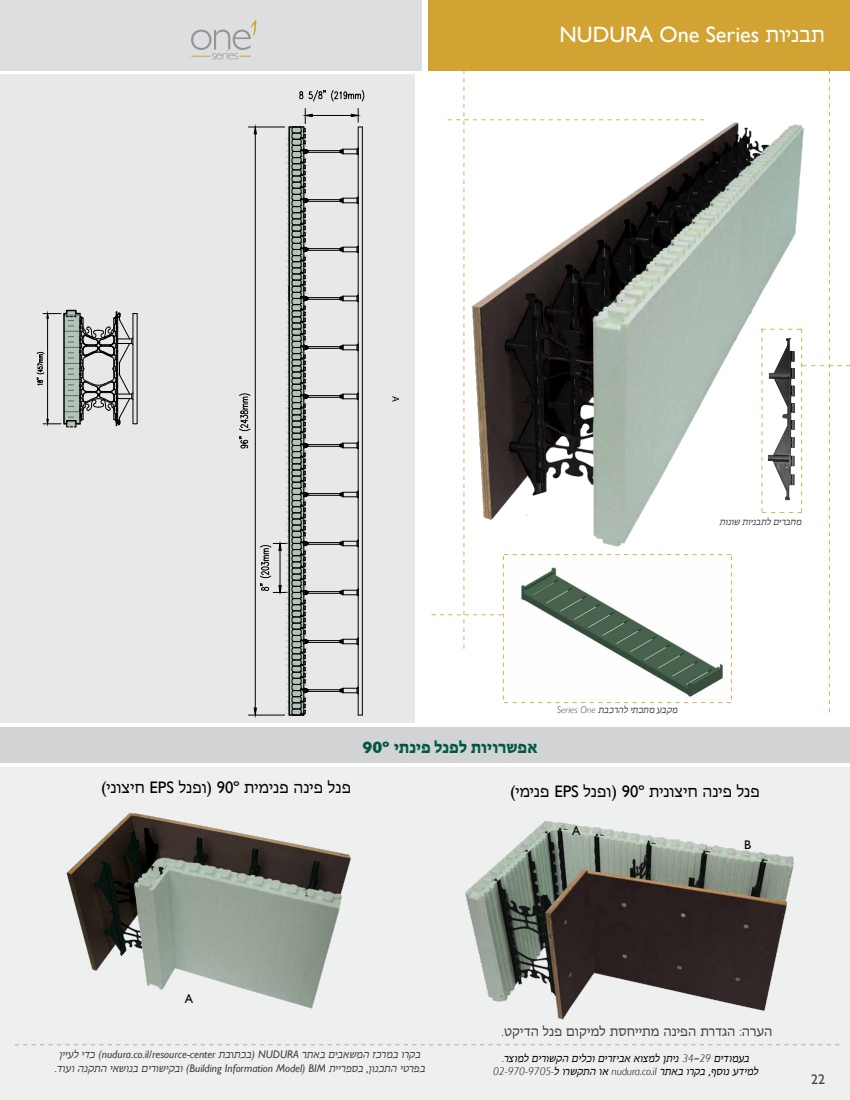
[picture p120: page 22]

מחברים לתבניות שונות

מקבע מתכתי להרכבת One Series

אפשרויות לפנל פינתי º90

פנל פינה חיצונית º90( ופנל EPS פנימי( פנל פינה פנימית º90( ופנל EPS חיצוני(

הערה: הגדרת הפינה מתייחסת למיקום פנל הדיקט.

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

למידע נוסף, בקרו באתר il.co.nudura או התקשרו ל02-970-9705-

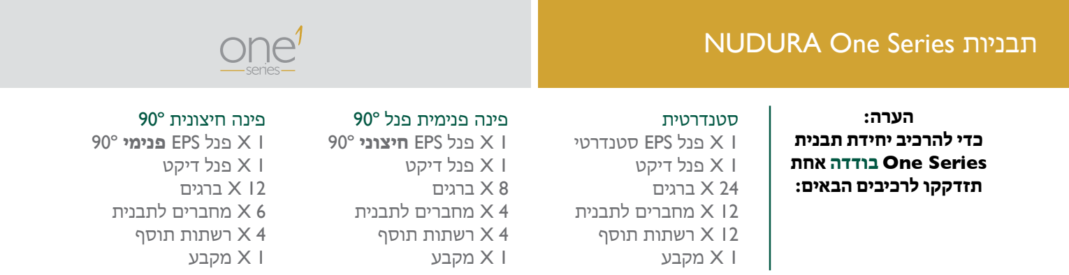
[picture p121: figure]
תבניות Series One NUDURA; הערה: כדי להרכיב יחידת תבנית Series One בודדה אחת תזדקקו לרכיבים הבאים:; פינה פנימית פנל º90 1 X פנל EPS חיצוני º90 1 X פנל דיקט 8 X ברגים 4 X מחברים לתבנית 4 X רשתות תוסף 1 X מקבע; פינה חיצונית º90 1 X פנל EPS פנימי º90 1 X פנל דיקט 12 X ברגים 6 X מחברים לתבנית 4 X רשתות תוסף 1 X מקבע; סטנדרטית 1 X פנל EPS סטנדרטי 1 X פנל דיקט 24 X ברגים 12 X מחברים לתבנית 12 X רשתות תוסף 1 X מקבע

## בורג ראש משושה עם דסקית פלדה שטוחה

גודל: מס‘ 10 X 2 אינץ‘ )50 מ“מ( כמות/חבילה: 1000
קוד מוצר: -2.0SC

)יש להשתמש בברגים בגודל מינימלי של 2 אינץ‘ )50 מ“מ( – -2.0SC)

### רשתות תוסף )להזמנה בנפרד(

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

קופסה קטנה

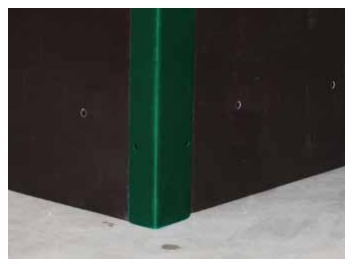
[picture p122: figure]
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

קופסה גדולה

כמות/קופסה 100 100 100 100 100

קוד מוצר -4WEB -6WEB -8WEB -10WEB -12WEB

כמות/קופסה 1007 655 465 388 295

קוד מוצר 4WEB 6WEB 8WEB 10WEB 12WEB

## דיקט* סטנדרטי º90 חיצוני º90 פנימי

אורך A 96 אינץ‘ )2438 מ“מ( 96 אינץ‘ )2438 מ“מ( 375/8 אינץ‘ )956 מ“מ( 203/8 אינץ‘ )518 מ“מ(

אורך B - - 215/8 אינץ‘ )549 מ“מ( 43/8 אינץ‘ )111 מ“מ(

גובה 18 אינץ‘ )457 מ“מ( 18 אינץ‘ )457 מ“מ( 18 אינץ‘ )457 מ“מ( 18 אינץ‘ )457 מ“מ(

כמות / מארז לוח דיקט אחד 6 פנלים סטנדרטיים 4 פנלים 16 פנלים

קוד מוצר PLYPAN PANEL OUT90- -6TW-S

כמות הרשתות - 72 16 64
הדרושה / מארז

ניתן להשיג פנלים של º45 פנימיים וחיצוניים לא מורכבים בהזמנה מיוחדת בלבד * את הפנלים מדיקט יש לחתוך באתר הבנייה. להוראות, עיינו בחוברת המידע.

למידע נוסף, בקרו באתר il.co.nudura או התקשרו ל.02-970-9705-

### מחבר פינתי

המחבר הפינתי מיועד לחיבור מאובטח של שני פנלים מדיקט איכותי בזווית של .90°
אורך: 3 מ‘
קוד מוצר: ONECB

לא מוצג מחבר באורך מלא.

## מחברים לתבניות שונות

כמות/קופסה: 96 חתיכות קוד מוצר: MULTI

## מקבע

מקבע מתכתי להרכבת תבניות Series-One כמות: 1 מקבע קוד מוצר: ONEJIG

## תבניות +Plus NUDURA

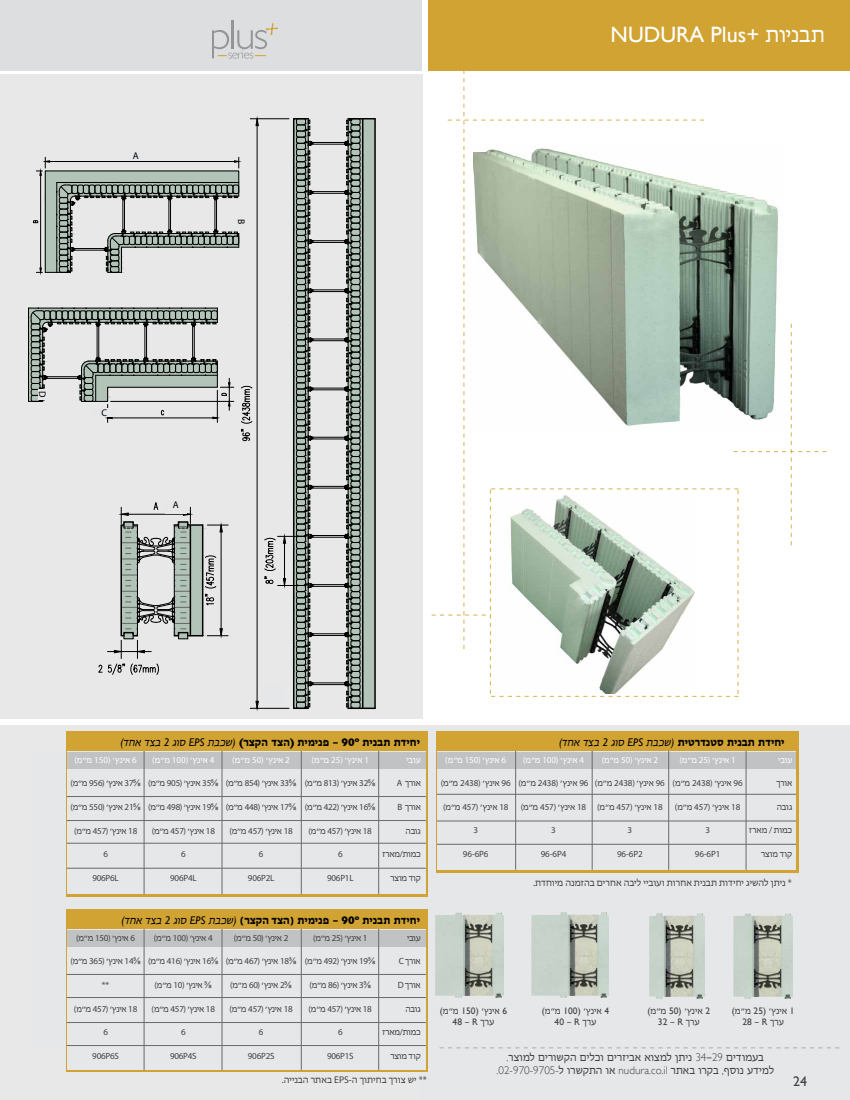
[picture p123: page 24]
(mm300” (12) mm250” (10) mm200” (8) mm150” (6) mm100” (4 Width Core; כמות / מארז 3 3 3 3; קוד מוצר 1P96-6 2P96-6 4P96-6 6P96-6; כמות/מארז 6 6 6 6; קוד מוצר L1P906 L2P906 L4P906 L6P906; קוד מוצר S1P906 S2P906 S4P906 S6P906; 1 אינץ‘ )25 מ“מ( ערך R – 28; 2 אינץ‘ )50 מ“מ( ערך R – 32; 4 אינץ‘ )100 מ“מ( ערך R – 40; 6 אינץ‘ )150 מ“מ( ערך R – 48

יחידת תבנית סטנדרטית )שכבת EPS סוג 2 בצד אחד( יחידת תבנית º90 – פנימית )הצד הקצר( )שכבת EPS סוג 2 בצד אחד(

עובי 1 אינץ‘ )25 מ“מ( 2 אינץ‘ )50 מ“מ( 4 אינץ‘ )100 מ“מ( 6 אינץ‘ )150 מ“מ(

אורך A⅝ 32 אינץ‘ )813 מ“מ( 5/833 אינץ‘ )854 מ“מ( 5/835 אינץ‘ )905 מ“מ( 5/837 אינץ‘ )956 מ“מ(

אורך 96 אינץ‘ )2438 מ“מ( 96 אינץ‘ )2438 מ“מ( 96 אינץ‘ )2438 מ“מ( 96 אינץ‘ )2438 מ“מ(

אורך B⅝ 16 אינץ‘ )422 מ“מ( 5/817 אינץ‘ )448 מ“מ( 5/819 אינץ‘ )498 מ“מ( 5/821 אינץ‘ )550 מ“מ(

גובה 18 אינץ‘ )457 מ“מ( 18 אינץ‘ )457 מ“מ( 18 אינץ‘ )457 מ“מ( 18 אינץ‘ )457 מ“מ(

* ניתן להשיג יחידות תבנית אחרות ועוביי ליבה אחרים בהזמנה מיוחדת.

יחידת תבנית º90 – פנימית )הצד הקצר( )שכבת EPS סוג 2 בצד אחד(

אורךC⅜ 19 אינץ‘ )492 מ“מ( 3/818 אינץ‘ )467 מ“מ( 3/816 אינץ‘ )416 מ“מ( 3/814 אינץ‘ )365 מ“מ(

אורךD⅜ 3 אינץ‘ )86 מ“מ( 3/82 אינץ‘ )60 מ“מ( 3/8 אינץ‘ )10 מ“מ( **

למידע נוסף, בקרו באתר il.co.nudura או התקשרו ל.02-970-9705-

** יש צורך בחיתוך ה-EPS באתר הבנייה.

## תוספים להגדלת ערכי R

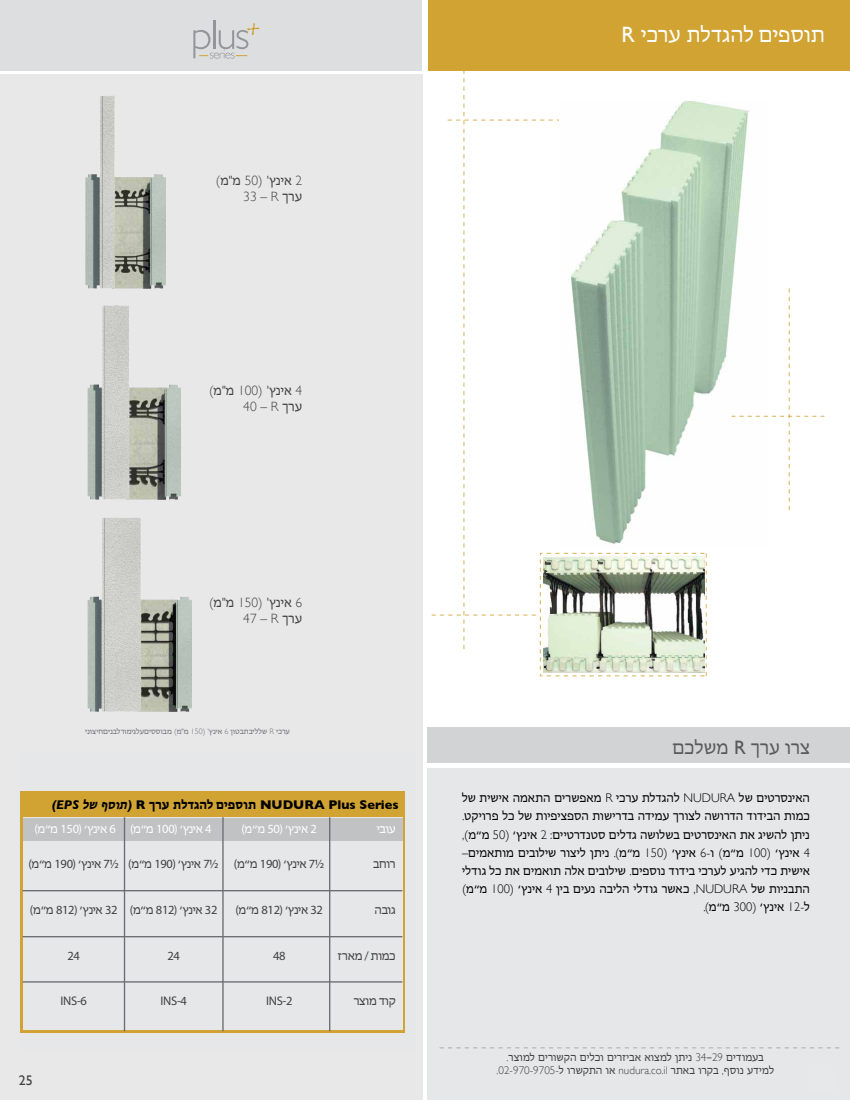
[picture p124: page 25]
כמות / מארז 48 24 24; קוד מוצר -2INS -4INS -6INS; 2 אינץ' (50 מ"מ) ערך R – 33; 4 אינץ' (100 מ"מ) ערך R – 40; 6 אינץ' (150 מ"מ) ערך R – 47; ל12- אינץ‘ )300 מ“מ(.

ערכי R שלליבתבטון 6 אינץ' (150 מ"מ) מבוססיםעלגימורלבניםחיצוני

צרו ערך R משלכם

(mm300” (12) mm250” (10) mm200” (8) mm150” (6) mm100” (4 Width Core
Series Plus NUDURA תוספים להגדלת ערך R( תוסף של EPS)

האינסרטים של NUDURA להגדלת ערכי R מאפשרים התאמה אישית של
כמות הבידוד הדרושה לצורך עמידה בדרישות הספציפיות של כל פרויקט.
ניתן להשיג את האינסרטים בשלושה גדלים סטנדרטיים: 2 אינץ‘ )50 מ“מ(,
4 אינץ‘ )100 מ“מ( ו6- אינץ‘ )150 מ“מ(. ניתן ליצור שילובים מותאמים-
אישית כדי להגיע לערכי בידוד נוספים. שילובים אלה תואמים את כל גודלי
התבניות של NUDURA, כאשר גודלי הליבה נעים בין 4 אינץ‘ )100 מ“מ(

עובי 2 אינץ‘ )50 מ“מ( 4 אינץ‘ )100 מ“מ( 6 אינץ‘ )150 מ“מ(

רוחב 1/27 אינץ‘ )190 מ“מ( 1/27 אינץ‘ )190 מ“מ( 1/27 אינץ‘ )190 מ“מ(

גובה 32 אינץ‘ )812 מ“מ( 32 אינץ‘ )812 מ“מ( 32 אינץ‘ )812 מ“מ(

למידע נוסף, בקרו באתר il.co.nudura או התקשרו ל.02-970-9705-

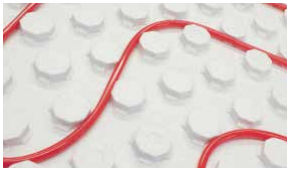
[picture p125: figure]

RHYDROFOAM הוא מוצר בידוד אידאלי לחימום רצפות שמטרתו לשפר את הנוחות ואת היעילות האנרגטית RHYDROFOAM ממקסם את חימום הרצפות; הוא מבטיח את

בפרויקטים לבנייה במגזר הפרטי והמסחרי כאחד. RHYDROFOAM

פיזור החום באופן שווה על פני כל שטח הרצפה ומספק לדיירי הבניין סביבת מחיה ועבודה נוחה. מציע למתקינים מוצר פוליסטירן מוקצף )EPS )צפוף ביותר, אך קל-משקל. מוצר שמגדיל את מהירות ההתקנה, קל לחיתוך בכל זווית או רדיוס רצויים, מספק ערך בידוד של עד -16R ומוסיף הגנה אקוסטית ברמה שאינה מוכרת לנו בארץ.
ההתקנה קלה ומהירה בהשוואה לבידוד מבוסס-הקצף המסורתי. ניתן להזמין את לוחות הבידוד )במידות 1.2 x 1.2 מ‘( בשני עוביים שונים. הם מתחברים זה לזה באינטרלוק חופף בכל ארבעת צדדיהם, וכך מובטח שיהיו נעולים RHYDROFOAM משתמש במערכת עיגון 360° רב-כיוונית ומבוססת-חיכוך שמייתרת את

למקומם במהלך ההתקנה.
הצורך להשתמש ברשת תיל. קל מאוד להתקין את צנרת חימום הרצפות במקומה בכל כיוון רצוי.

שיטת הבידוד הקלה לחימום רצפות.

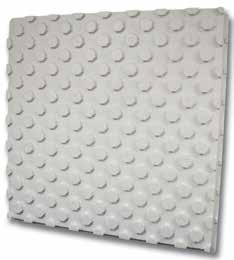
[picture p126: figure]

## נקודות חשובות:

•בידוד מתחת ללוח הבטון
•לוחות בידוד יצוקים-בתבנית בגודל 1.2 x 1.2 מ‘ •מרחק של 100 מ“מ בלבד מהבסיס לבליטות •דרגות עובי זמינות: 1/22 אינץ‘ )64 מ“מ( – 10R( 1.76 RSI), וכן בהזמנה מיוחדת: 4 אינץ‘ )100 מ“מ( – 16R( 2.47 RSI) •עיגון רב-כיווני לצינורות בגודל 1/2 אינץ‘ )13 מ“מ( •אינטרלוק חופף בכל 4 צדי הלוח •ידידותי לסביבה. ללא CFC או HCFC •ניתן למיחזור ב100%-
•עמיד בפני מים ולחות
R | •LEED
יכול לזכות את הבניין בנקודות לבנייה ירוקה בהתאם לתוכניות NC

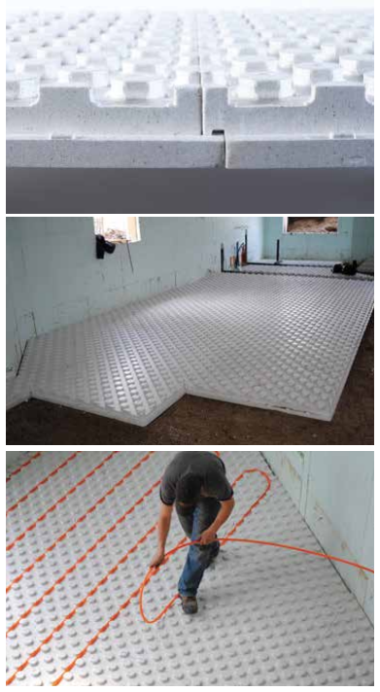
[picture p127: figure]

עובי הלוח 1/22 אינץ‘ )64 מ“מ( 4 אינץ‘ )100 מ“מ( גודל הלוח 1.2 x 1.2 מ‘ 1.2 x 1.2 מ‘ כמות / מארז 10 6
קוד מוצר RHFL -4RHFL

לצפייה בסרטון ההתקנה של RHYDROFOAM.

# HYDROFOAM

RHYDROFOAM. כל לוח מכסה שטח

ניתן להניח כ457- מ‘ של צנרת תוך 45 דקות, כשמשתמשים ב-של 1.49 מ“ר.

למידע נוסף, הורידו את גיליון הנתונים הטכניים )Sheet Data Technical )מאתר il.co.nudura

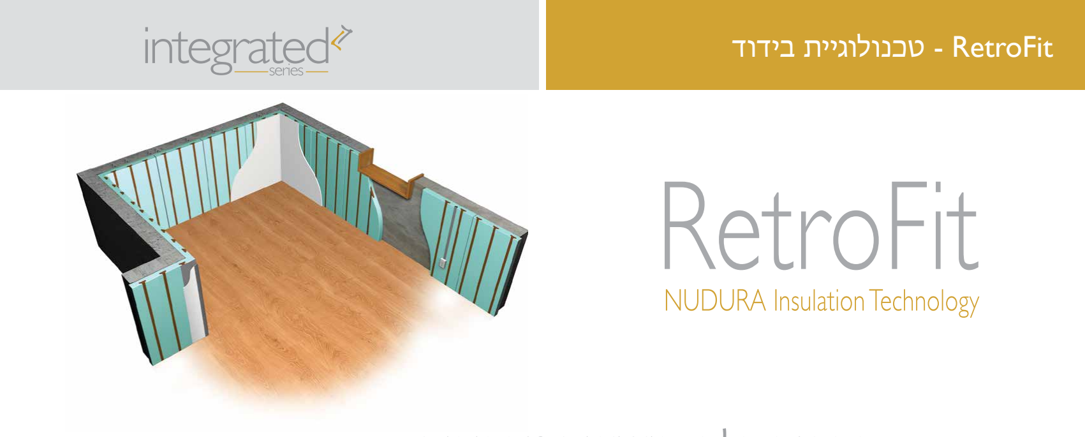
[picture p128: figure]
RetroFit - טכנולוגיית בידוד

טכנולוגיית הבידוד RetroFit של NUDURA היא פתרון בידוד קל-להתקנה לגימור מרתפים או לבידוד קירות בלוקים פנימיים או חיצוניים. ההתקנה קלה ופשוטה בהשוואה לשיטות גימור מסורתיות מרובות שלבים. טכנולוגיית הבידוד RetroFit של NUDURA יוצרת הן בידוד והן נקודות עיגון בשלב פשוט אחד. פשוט חברו את הלוחות הסטנדרטיים של NUDURA בגודל 1.2 x 2.4 מ‘ לקיר באמצעות פס החיבור המוטבע בהם ובורגי בטון. לוחות טכנולוגיית הבידוד RetroFit של NUDURA מתחברים זה לזה בחפיפה באופן מושלם. קל להשלים את צנרת החשמל ולחבר לוח טיח או גבס באמצעות פס החיבור ברוחב 1/22 אינץ‘ )64 מ“מ( במרווחים של 16 אינץ‘ )400 מ“מ(. לאחר התקנת טכנולוגיית לוחות הבידוד RetroFit, ביצועי הבידוד שלה מגיעים ל-14.8-R ומציעים יעילות אנרגטית משופרת, תוספת משמעותית לבידוד האקוסטי ונוחות לכל בית מגורים או בניין מסחרי.

התקנה קלה. ביצועים מרהיבים.

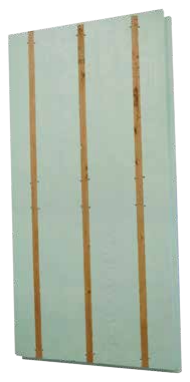
[picture p129: figure]

## נקודות חשובות:

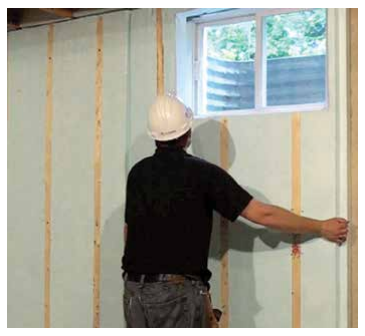
[picture p130: figure]

•בידוד בערך של עד -14.8R
•עמידות בפני לחות
•ללא VOC, CFC או HCFC
הלוחות הם בגודל 1.2 x 2.4 מ‘ ובעוביים של ⁵⁄8 | •2 אינץ‘ )67 מ“מ(, 1/23 אינץ‘ )89
מ“מ(, 3⁷⁄8 אינץ‘ )98 מ“מ(
2 | •m/w)

ערכי הבידוד הם עד -14.8R( 2.61 RSI וערך U של 0.384 k• •זמינים עם פסי חיבור מעץ או מפוליסטירן •עשויים מפוליסטירן מוקצף )EPS), ולכן קלי-משקל וקלים לחיתוך •פשוט להתקנה בעזרת פס החיבור המוטבע ברוחב 1/22 אינץ‘ )64 מ“מ( במרווחים של 16 אינץ‘ )400 מ“מ(
•הפנלים יושבים זה על זה בחפיפה כדי למנוע את תופעת הגישור התרמי •בידוד לקירות מרתפים או לקירות של בלוקים פנימיים וחיצוניים

עובי הלוח 5/82 אינץ‘ )67 מ“מ( 1/23 אינץ‘ )89 מ“מ( 7/83 אינץ‘ )98 מ“מ( גודל הלוח 48 x 96 אינץ‘ )1219 x 2438 מ“מ( 48 x 96 אינץ‘ )1219 x 2438 מ“מ( 48 x 96 אינץ‘ )1219 x 2438 מ“מ( כמות / מארז 6 4 4
פסי חיבור עץ | פוליסטירן עץ | פוליסטירן עץ | פוליסטירן
קוד מוצר 9-055P | 9-050P 9-045P | 9-040P 9-035P | 9-031P

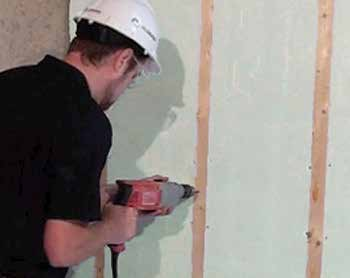
[picture p131: figure]

לצפייה בסרטון התקנת RetroFit.

בורגי בטון 6 אינץ‘ )152 מ“מ( כמות/חבילה: 50 ברגים
קוד מוצר 6CS-SC

למידע נוסף, הורידו את גיליון הנתונים הטכניים )Sheet Data Technical )מאתר il.co.nudura

בורגי בטון 5 אינץ‘ )127 מ“מ( כמות/חבילה: 300 ברגים כמות/צנצנת: 50 ברגים קוד מוצר CSL-SC קוד מוצר CS-SC

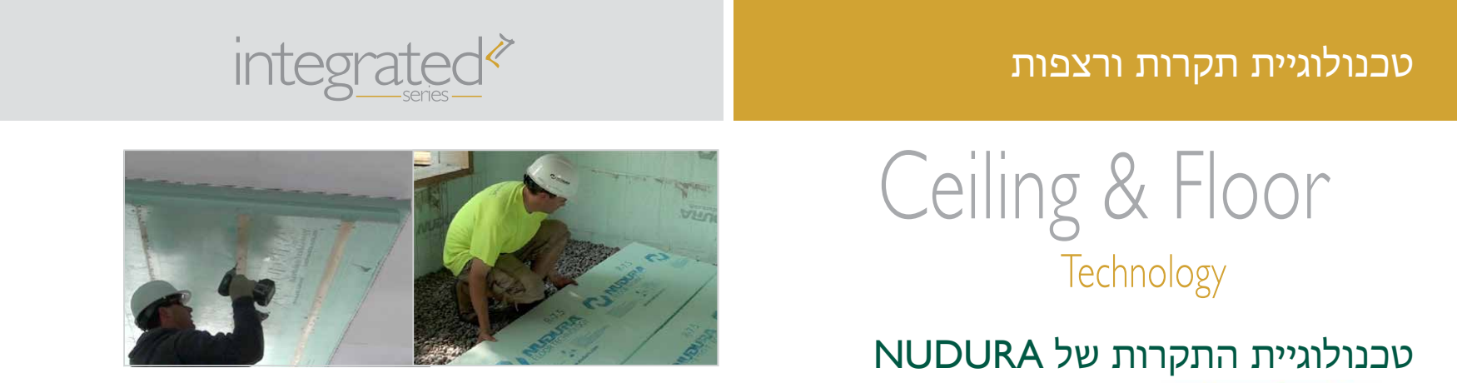
[picture p132: figure]
טכנולוגיית התקרות של NUDURA; טכנולוגיית תקרות ורצפות
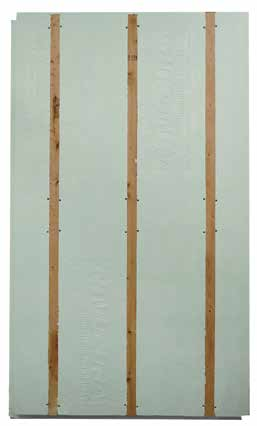
[picture p133: figure]
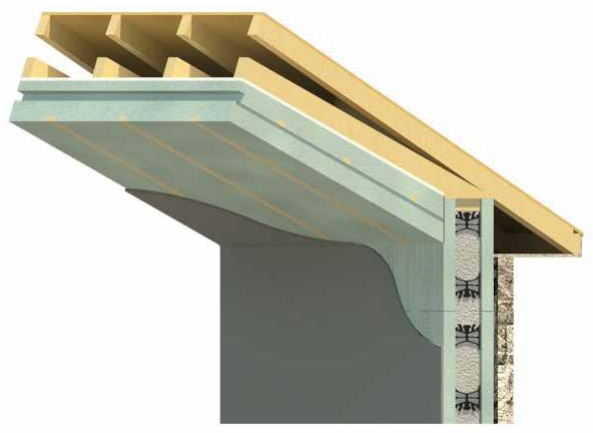
[picture p134: figure]

## נקודות חשובות:

•מפחית חדירת אוויר באופן יעיל. •עמיד בפני מים ולחות.
•כשמותקנת שכבה כפולה, תופעת הגישור התרמי מופחתת עוד יותר, וכך גדלות הנוחות והיעילות האנרגטית. •ידידותי-למשתמש ובעל ביצועים מעולים. •פוליסטירן מוקצף )ESP )ידידותי לסביבה – אינו מכיל CFC או HCFC.. •ניתן למיחזור ב.100%-
•פסי חיבור מוטבעים מעץ או מפוליסטירן, חסין בפני פגיעות )זמינות בכמויות מוגבלות(.

ברגים ‘ 10 4 אינץ‘ )102 מ“מ( 5 אינץ‘ )127 מ“מ( 6 אינץ‘ )152 מ“מ( כמות/קופסה 500 500 500
קוד מוצר -4.0SC -6.0SC -5.0SC

# טכנולוגיית הרצפות של NUDURA

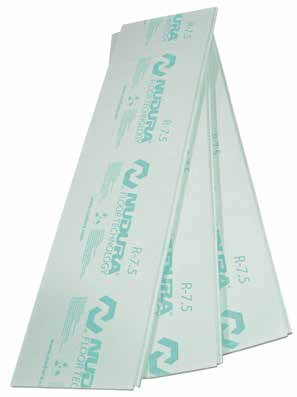
[picture p135: figure]
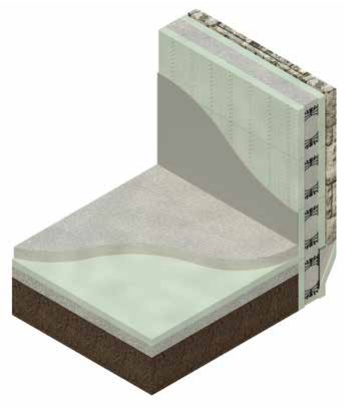
[picture p136: figure]

כשמדובר בבידוד, רצפת הבניין היא לעתים קרובות המשטח המוזנח ביותר. ככל שתקני האנרגיה משתנים, כך הופך גם הבידוד מתחת למרצפות להכרח על פי התקנים שנקבעו באזורים מסוימים. השלימו את מעטפת המבנה והוסיפו בידוד בעזרת טכנולוגיית הרצפות של NUDURA להגדלת הנוחות והיעילות האנרגטית.

## נקודות חשובות:

•שכבת הגנה חסכונית למניעת העברת חום אל הקרקע. •בסיס יעיל לחימום רצפות.
•הפוליסטירן המוקצף )EPS )אינו מכיל CFC או HCFC והוא ניתן למיחזור ב.100%-
| עובי הלוח 2⁵/8 אינץ‘ )67 מ“מ( 31/2 אינץ‘ )89 מ“מ( 3⁷/8 אינץ‘ )98 מ“מ(
)2438 x 1219 מ“מ( )2438 x 1219 מ“מ( )2438 x 1219 מ“מ( | גודל הלוח 48 אינץ‘ x 96 אינץ‘ 48 אינץ‘ x 96 אינץ‘ 48 אינץ‘ x 96 אינץ‘
| פסי עץ כן כן כן
| כמות / מארז 6 4 4
| קוד מוצר 9-050P 9-040P 9-031P

סוג 2 – ירוק חפיפה של 11/4 אינץ‘ )32 מ“מ( 17/8 אינץ‘ )48 מ“מ( חריץ ושגם 21/2 אינץ‘ )64 מ“מ( חריץ ושגם גודל 24 x 96 אינץ‘ )610 x 2438 מ“מ( 24 x 96 אינץ‘ )610 x 2438 מ“מ( 24 x 96 אינץ‘ )610 x 2438 מ“מ( כמות / מארז 15 10 7
קוד מוצר 2-435P 2-445P 2-455P סוג 3 – לבן לא זמין 17/8 אינץ‘ )48 מ“מ( חריץ ושגם 21/2 אינץ‘ )64 מ“מ( חריץ ושגם גודל - 24 x 96 אינץ‘ )610 x 2438 מ“מ( 24 x 96 אינץ‘ )610 x 2438 מ“מ( כמות / מארז - 8 6
קוד מוצר - 3-443P 3-453P

אורך 32 אינץ‘ )813 מ“מ(

גובה 3 אינץ‘ )76 מ“מ(
כמות / מארז 80
קוד מוצר F-HADJ

### הרחבת הבסיס ללבנים וכן בורג 6 אינץ‘ )152 מ“מ( ודסקית מפלסטיק

אורך 32 אינץ‘ )813 מ“מ(
רוחב 41/2 אינץ‘ )114 מ“מ( גובה 13 אינץ‘ )330 מ“מ(
כמות / מארז 14
קוד מוצר BRICK

הרחבת הבסיס ללבנים משמשת לתמיכה בגימור סטנדרטי של ציפוי לבנים או אבנים; ליצירת בסיסים ללבנים בפינות; או לטיפול בכל שינוי גובה או זווית.

אפשר להשתמש במכסה הקצה )עם פס חיבור( כדי לסיים את הקיר. ניתן להשתמש בו גם למשקופים עיוורים.

רוחב 4 אינץ‘ )100 מ“מ( 6 אינץ‘ )150 מ“מ( 8 אינץ‘ )200 מ“מ( 10 אינץ‘ )250 מ“מ( 12 אינץ‘ )300 מ“מ(

גובה 18 אינץ‘ )457 מ“מ( 18 אינץ‘ )457 מ“מ( 18 אינץ‘ )457 מ“מ( 18 אינץ‘ )457 מ“מ( 18 אינץ‘ )457 מ“מ( Thickness EPS 25/8 אינץ‘ )67 מ“מ( 25/8 אינץ‘ )67 מ“מ( 25/8 אינץ‘ )67 מ“מ( 25/8 אינץ‘ )67 מ“מ( 25/8 אינץ‘ )67 מ“מ(

כמות/קופסה 57 40 30 35 30

קוד מוצר -4ECF -6ECF -8ECF 10ECF 12ECF

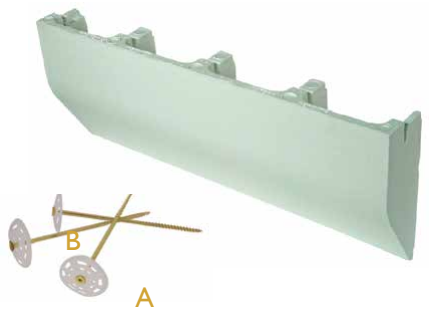
[picture p137: figure]
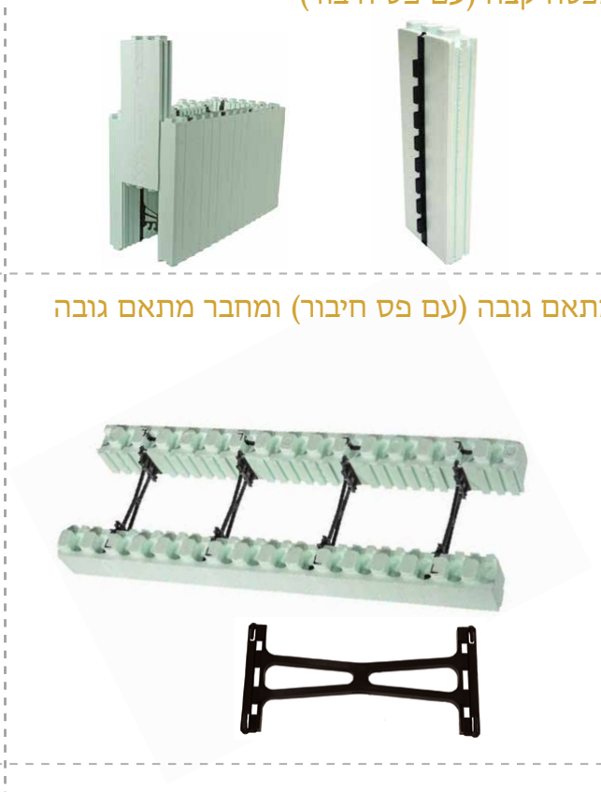
[picture p138: figure]

מתאם גובה )עם פס חיבור( ומחבר מתאם גובה מתאם הגובה )עם פס חיבור( ביחד עם מחבר מתאם הגובה יכולים להגדיל את גובה הקיר בקפיצות של 3
אינץ‘ )75 מ“מ(. מחבר מתאם הגובה מאפשר חיבור
של הפנלים זה לזה.

יש צורך בהרכבה באתר הבנייה.

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

כמות/קופסה 100 100 100 100 80

קוד מוצר -4T-HA -6T-HA -8T-HA 10T-HA 12T-HA

מחבר מתאם הגובה לחבילת F-HADJ אחת נדרשים 160 מחברי מתאם גובה

נעילת תבנית )Lock-Form)

LOCK-FORM משמש כדי לשמור על הקיר ישר. שימושים אחרים כוללים יישור הקיר על ידי הערמת תבניות באמצעות חיבורים אנכיים. בכל חבילה יש 30 מ‘ של LOCK-FORM.

רוחב ליבה 6 אינץ‘ )150 מ“מ( 8 אינץ‘ )200 מ“מ( 10 אינץ‘ )250 מ“מ( 12 אינץ‘ )300 מ“מ(

אורך 3 מ‘ 3 מ‘ 3 מ‘ 3 מ‘

כמות / מארז 10 יחידות 10 יחידות 10 יחידות 10 יחידות

קוד מוצר 06BLOK 08BLOK 10BLOK 12BLOK

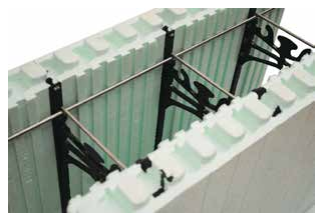
[picture p139: figure]

לא מוצג LOCK-FORM באורך מלא.

ניתן להשתמש בבורג ובדסקית מפלסטיק כדי לחבר את הרחבת הבסיס ללבנים אל דופן התבנית

# אביזרים לתבניות NUDURA

### מכסה קצה )עם פס חיבור(

זמין רק עבור תבניות סטנדרטיות בגודל 6–12 אינץ‘ )150–300 מ“מ(.

איטום משקוף/חלל משקוף איטום משקוף/חלל משקוף האינסרט לבידוד משקופים מאפשר סגירה של החלל מעל לחלון ומתחתיו, כדי למזער את תופעת הגישור התרמי. האינסרט לבידוד משקופים של
NUDURA מיוצר בעובי סטנדרטי של 2 אינץ‘ )50 מ“מ(.

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

כמות/קופסה 84 60 48 36 36

קוד מוצר 04LINT 06LINT 08LINT 10LINT 12LINT

כמות/קופסה 250
קוד מוצר PW-SC

כמות/קופסה 500
קוד מוצר -6.0SC
A. דסקית מפלסטיק B. בורג 6 אינץ‘ )152 מ“מ(

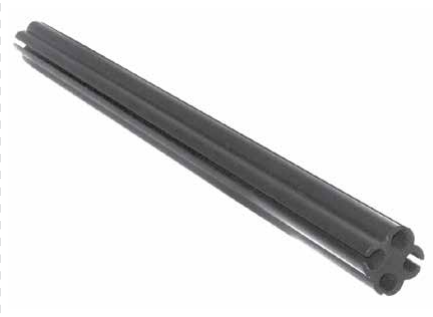
[picture p140: figure]
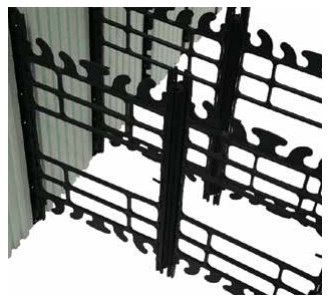
[picture p141: figure]

### מחבר רשת ארבע-כיווני

כמות/קופסה 100
קוד מוצר XWEBC4

מחבר הרשת הארבע-כיווני מאפשר חיבור של שתי רשתות תוסף ואו יותר זו לזו כדי ליצור רוחבי תבניות גדולים יותר. ניתן להשת מש בו גם כדי ליצור תבניות בצורות ובגדלים שונים. יותר גמישות בתכנון.

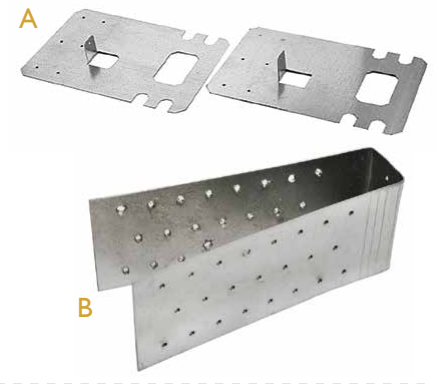
[picture p142: figure]
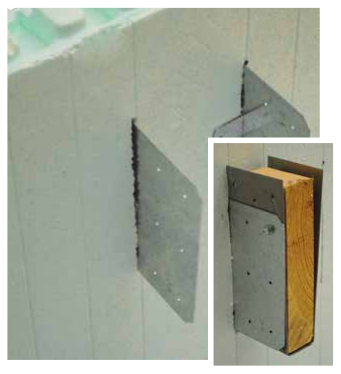
[picture p143: figure]

מחבר ICF( שם רשמי: מערכת מתלי עגינה רב-שימושית(

כמות/קופסה 50
קוד מוצר ICFHIP

מחבירי ה-ICF משמשים לחיבור קורות לתמיכה ברצפה או למ ערכת חיבור גגות עץ. מדובר במערכת חיבור לא יקרה אך נוחה להרכבה.

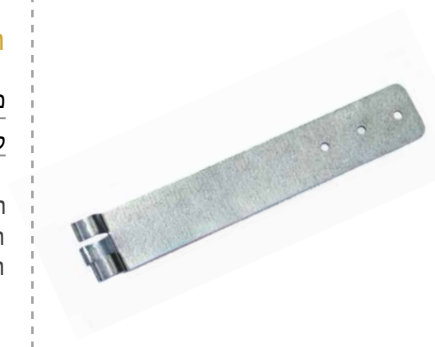
[picture p144: figure]
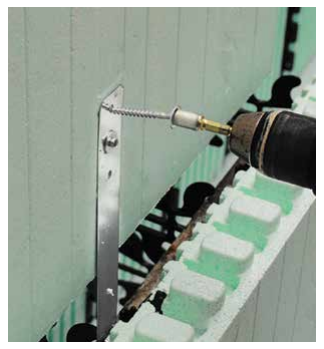
[picture p145: figure]

### תושבת מעבר

כמות/קופסה 100
קוד מוצר BR-TRA

תושבת המעבר מאפשר חיבור יחדיו של שני עוביי תבנית שונים. השימשוש העיקרי בה הוא ליצירת שפה לתמיכה בלבנים או במע רכת רצפה.

כמות/קופסה 25
קוד מוצר ICFSBB
A. לוחית לתליית ICF B. תושבת נשיאה מחוררת )כולל קופסה עם 170 ברגים מס‘ 12(

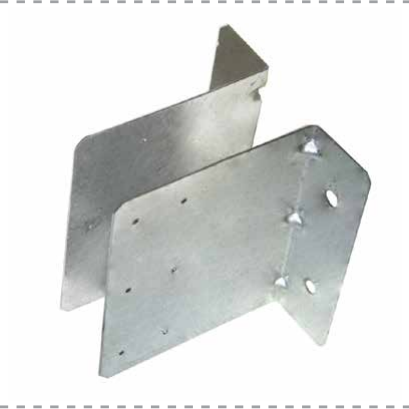
[picture p146: figure]
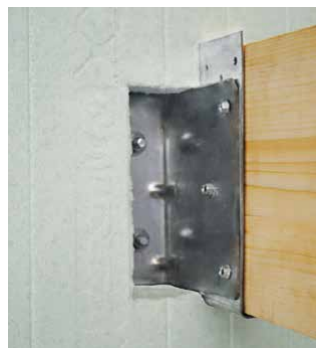
[picture p147: figure]

תושבת Retrofit

כמות/קופסה 12
קוד מוצר ICFRFB

תושבת ה-Retrofit משמשת ביחד עם תושבת הנשיאה המחוררת כתוסתפת מאוחרת לחיבור לקיר הבטון. כך ניתן לתקן טעויות שנ בעו מהתקנה לא נכונה של מחבר ה-ICF.

בורגי פטנט לעץ אינם כלולים.

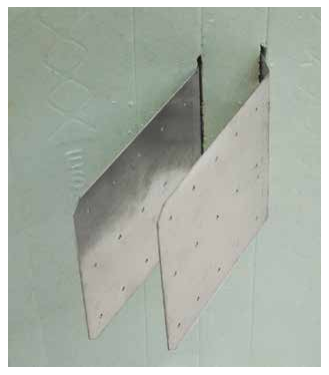
[picture p148: figure]
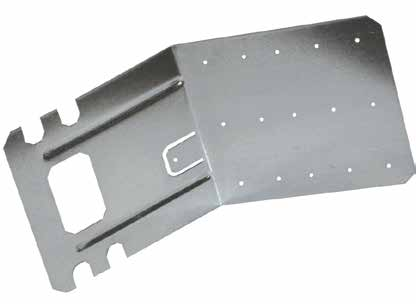
[picture p149: figure]

### לוחית לתליית ICF בזווית של 45°

1/41 אינץ‘ )32 מ“מ( על 1/23 אינץ‘ )89 מ“מ(

כמות/קופסה 20
קוד מוצר -45HIP
הלוחית לתליית ICF בזווית של 45° זהה ללוחית הסטנדרטית אך מספקת חיבור מוצק לרצפה בתוך זוויות פינה של 90° או .45° בלוחית לתליית ICF בזווית של 45° יש להשתמש ביחד עם תושבת הנשיאה המחוררת.

#כולל קופסה עם 170 בר

גים מס‘ 12

# אביזרי NUDURA

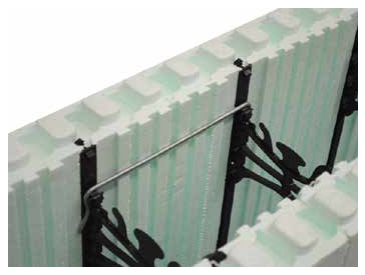
[picture p150: figure]

### קליפ לחיבור אנכי 85/8 אינץ‘ )219 מ“מ(

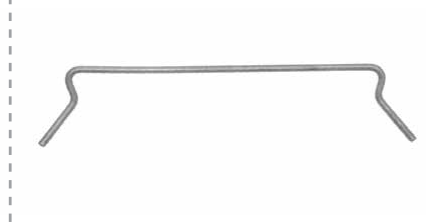
[picture p151: figure]

כמות/קופסה 200
קוד מוצר VJC

הקליפ הזה לחיבור אנכי נועד לחבר את התבנית יחד בנקודות החיברור האנכיות שלה. הוא מחליף את הצורך בקשירה או בהדב קה של התבניות זו לזו, ובמקום זאת מספק חיבור מוצק הדורש מאמץ מינימלי בעת ההתקנה..

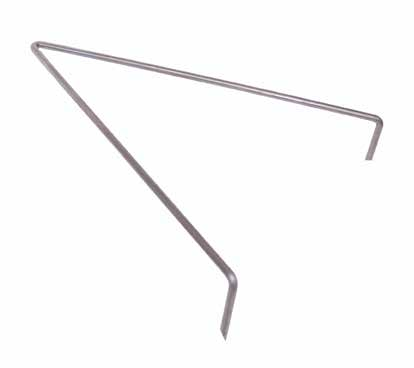
[picture p152: figure]
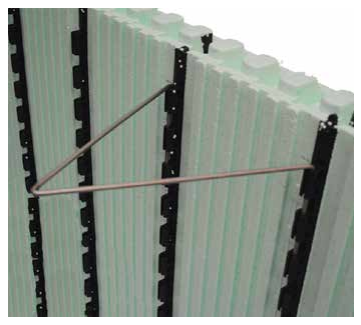
[picture p153: figure]

### קליפ V

כמות/קופסה 250
קוד מוצר VCLIP
קלפיפ ה-V משמש לחיבור פנל NUDURA לרצפת בטון. הוא מאפ שר לקבלן לתמוך בפנל ללא צורך בחומרים נוספים בצדו החיצוני של הקיר.

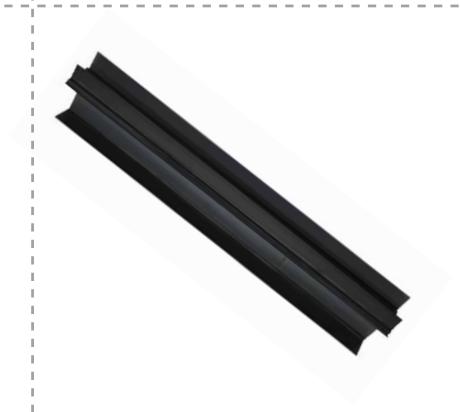
[picture p154: figure]
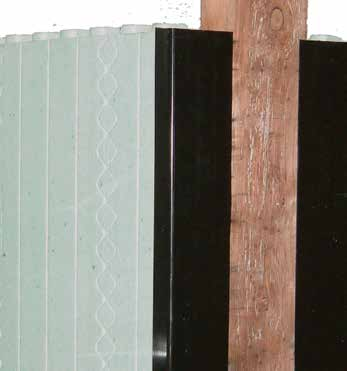
[picture p155: figure]

Buck Easy - באורך 3 מ‘

כמות / מארז 10 יחידות
קוד מוצר WBUCK

ה-Buck Easy משמש למסגרות חלונות ודלתות ומאפשר חיבור של קורות עץ בגודל סטנדרטי בין הפנלים של הפוליסטירן המוקצף )EPS). השימוש העיקרי שלו הוא לדלתות ולחלונות. כל חבילה מכילה 30 מ‘ של Buck Easy.

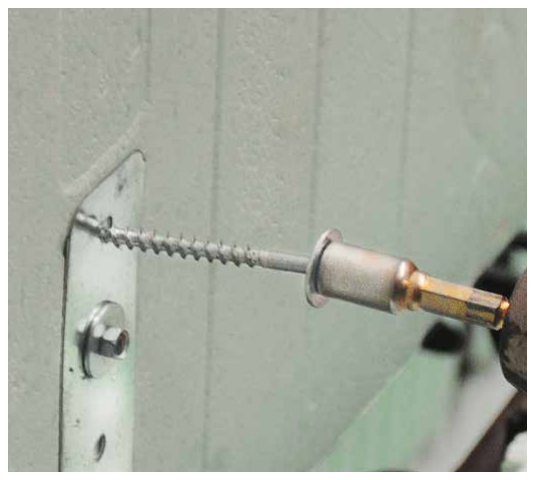
[picture p156: figure]

### בורג ראש משושה עם דסקית פלדה שטוחה

כמות/קופסה 1000 1000 1000
קוד מוצר -2.0SC -2.5SC -3.0SC

ניתן להשתמש בבורג מס‘ 10 לחיבור מערכת היישור של NUDURA אל התבניות. שימושים נוספים כוללים חיבור פסי חיבור או משקופים עוורים לבטון. זמין בגדלים 2 אינץ‘ )50 מ“מ(, 2.5 אינץ‘ )64 מ“מ( ו3- אינץ‘ )76 מ“מ(. בכל חבילה נכללים שני מפתחות אינץ‘ )6 מ“מ(.

גודל: 10 X 2 אינץ‘ )50 מ“מ( 10 X 2.5 אינץ‘ )64 מ“מ( 10 X 3 אינץ‘ )76 מ“מ(

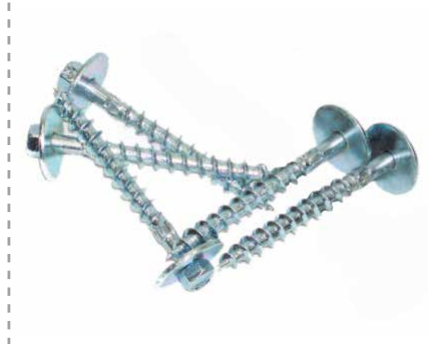
[picture p157: figure]

ייתכן שהמוצר בפועל יהיה שונה מהמוצג כאן. המוצר כפוף לשינויים.

# אביזרי NUDURA

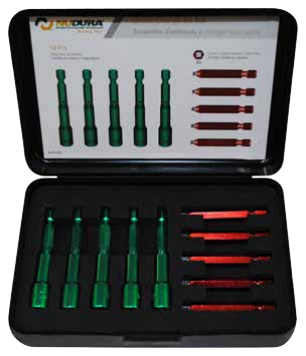
[picture p158: figure]
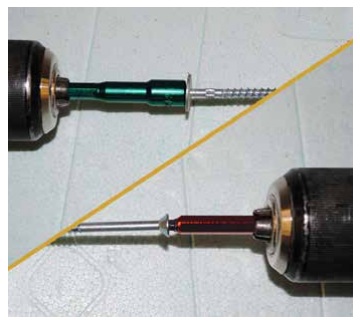
[picture p159: figure]

### ערכת 10 ביטים למברגה

פנו למפיץ המקומי שלכם לקבלת מידע נוסף על אופן ההזמנה.
ערכת 10 הביטים כוללת חמישה מובילי ברגים מגנטיים בגודל אינץ‘ שניתן להשתמש בהם בכל הברגים המשושים עם דסקיות המתכת השטוחות של NUDURA. כמו כן יש בערכה חמישה ביטים מרובעים אדומים. קופסת הפלסטיק העמידה שומרת על כל הביטים ביחד במקום נוח אחד, ומקלה על מציאת הביטים המי תאימים באתר הבנייה.

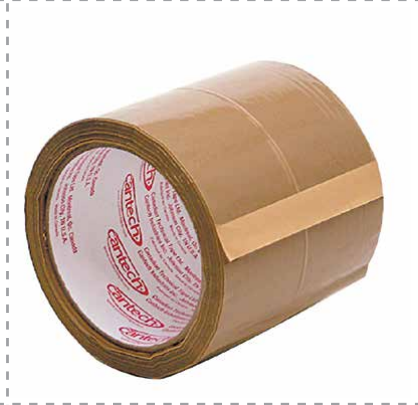
[picture p160: figure]
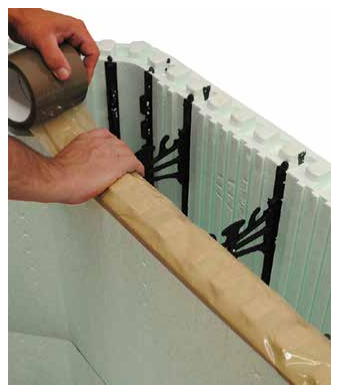
[picture p161: figure]

### סרט 4 אינץ‘ להגנה – 4 אינץ )96 מ“מ( על 66 מ‘

סרט 4 אינץ‘ להגנה נועד לכיסוי חיבור האינטרלוק בחלק העליון של הקיר כדי למנוע מהבטון לזרום לתוך השקעים. ניתן להשתמש בו גם כסרט כדי לחסום חדירת אוויר.

כמות/קופסה 18
קוד מוצר -4TAPE

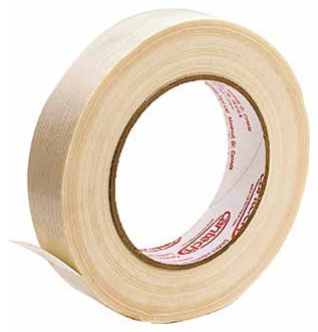
[picture p162: figure]
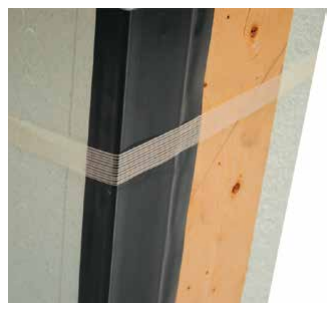
[picture p163: figure]

### סרט PVC- 1 אינץ )24 מ“מ( על 55 מ‘

כמות/קופסה 36
קוד מוצר TAPE

סרט PVC משמש לתמיכה נוספת בתבניות EPS שנחתכו בשטח ושיש בהן למעלה מ4- אינץ‘ )100 מ“מ( של EPS שבולט מעבר לרשת האחרונה. כמו כן הוא נועד לתבניות בסיס ללבנים בפינות ולתבניות רדיוס.

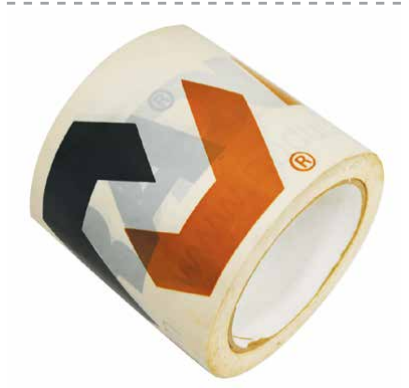
[picture p164: figure]
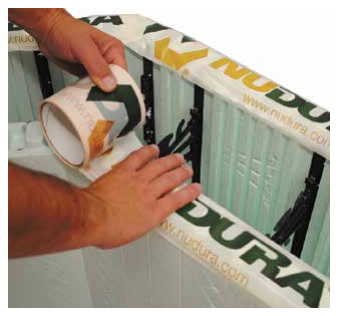
[picture p165: figure]

### סרט 4 אינץ‘ לשימוש כבד – 4 אינץ )96 מ“מ( על 66 מ‘

סרט 4 אינץ‘ לשימוש כבד נועד לכיסוי חיבור האינטרלוק בחלק העליון של הקיר כדי למנוע מהבטון לזרום לתוך השקעים. ניתן להשתמש בו גם כסרט כדי לחסום חדירת אוויר.

כמות/קופסה 24
קוד מוצר HD4TAP

# אביזרי NUDURA

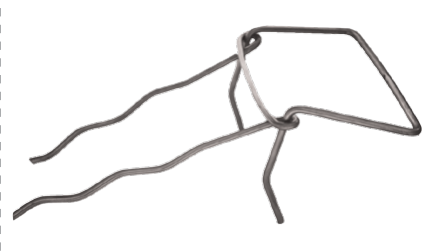
[picture p166: figure]

### מחברי לבנים )פלדה מגולוונת(

### מחברי לבנים )פלדת אל-חלד(

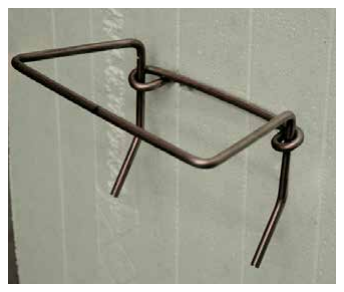
[picture p167: figure]

כמות/קופסה 100 יחידות כמות/קופסה 100 יחידות קוד מוצר BRKTG קוד מוצר BRKTSS מחברי לבנים וצירים יצוקים באתר הבנייה – מאפשרים עיגון מוצק של ציפוי אבן חיצוני דרך לוחות הפוליסטירן אל ליבת הבטון; עומדים בדרישות התקנים 754D( ארה“ב( ו370-A-CSA )קנדה( לעוגני אבן..

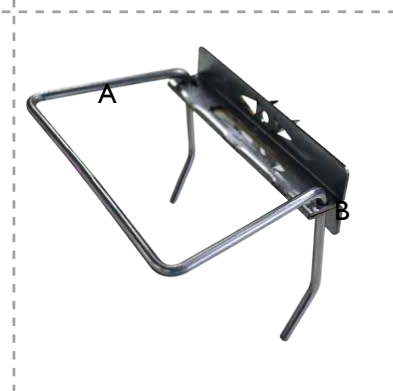
[picture p168: figure]
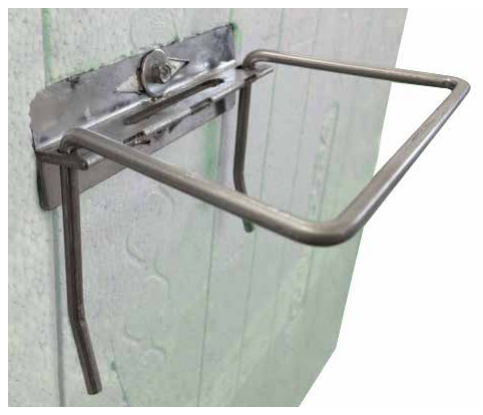
[picture p169: figure]

### מחברים למשטח )A)

כמות/קופסה 100 יחידות

קוד מוצר SBRKTG

מחברים וצירים לחיבור למשטח – תוכננו להיות מהודקים בעזרת 2 בורגי ראש משושה של NUDURA בכל מקום על פני פס הח י בור של NUDURA. מחבר זה עובד עם צירים של NUDURA ועם צירים קטנים יותר.

### ציר )B)

כמות/קופסה 100 יחידות

קוד מוצר PINTLE

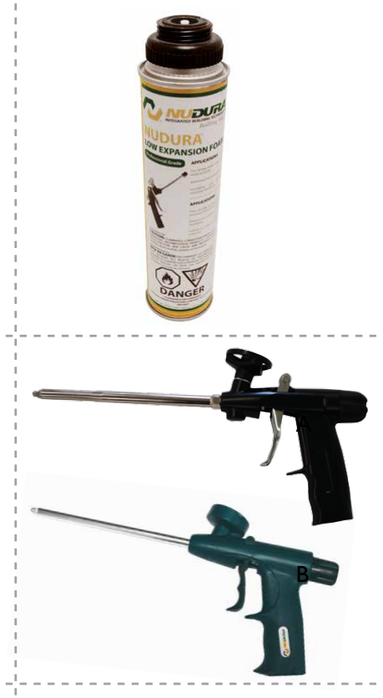
[picture p170: figure]
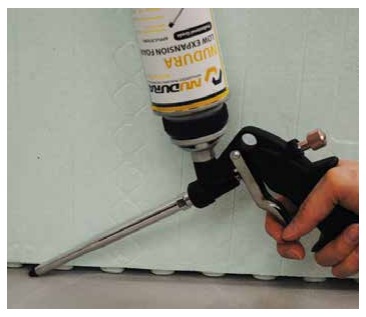
[picture p171: figure]

אקדח II Gun Econo( A)

### אקדח קצף )ידית מתכת(

כמות 1 GUN
קוד מוצר M-GUN

אקדחי הקצף II Gun Econo ו-Shooter Sure תואמים את מכלי 680 גרם של הקצף המתפשט-באיטיות של NUDURA. ניתן להשתמש בקצף זה למספר משימות באתר הבנייה.

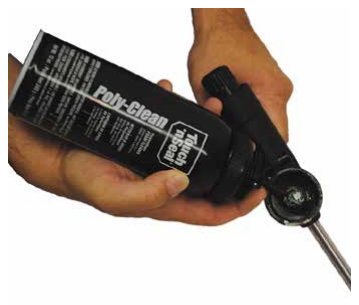
[picture p172: figure]
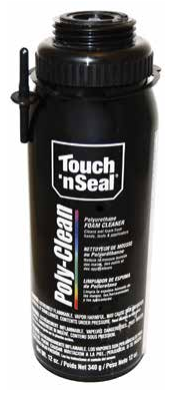
[picture p173: figure]

### חומר ניקוי לאקדח קצף - 340 גרם

כמות/קופסה 12
קוד מוצר C-FOAM

חומר הניקוי לאקדח קצף משמש לניקוי הקצף שהתקשה מהתא הפניימי של אקדח הקצף. הוא משמש גם לניקוי המשטחים הח י צוניים של האקדח.

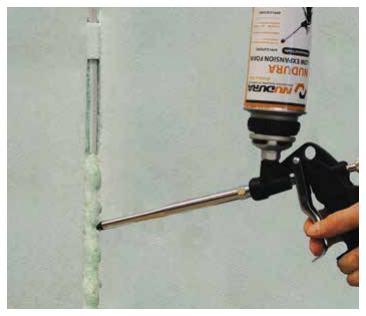
[picture p174: figure]

### קצף מתפשט-באיטיות של NUDURA - 680 גרם

כמות/קופסה 12
קוד מוצר FOAM

הקצף המתפשט-באיטיות מותאם לפוליסטירן המוקצף )EPS )של NUDURAA וניתן להשתמש בו למספר משימות באתר הבנייה. ב י ניהן: מילוי והדבקה ללוח הבטון או לתחתיתו בין חיבורים אנכיים, אבטחת פתחי שירות ובידוד מסביב לפתחים.

אקדח Shooter Sure( B)

### אקדח קצף )ידית פלסטיק(

כמות 1 GUN
קוד מוצר GUN

# אביזרי NUDURA

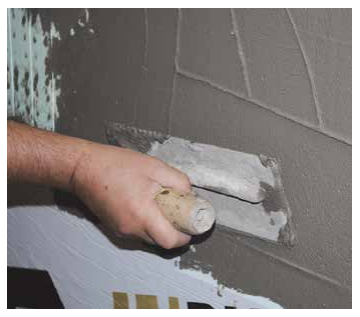
[picture p175: figure]

### תערובת טיח - לכיסוי של 7 מ“ר

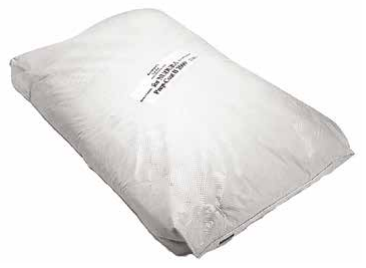
[picture p176: figure]

כמות שק אחד
קוד מוצר PARG

תערובת הטיח היא מוצר יבש דמוי-מלט המשמש לכיסוי EPS חשוף שאינו מכוסה בגימור חיצוני. היא משמשת ביחד עם רשת PVC.

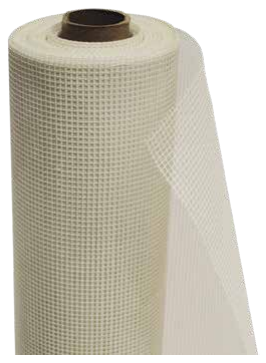
[picture p177: figure]
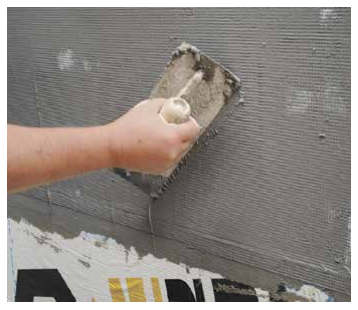
[picture p178: figure]

### רשת PVC - לכיסוי של 44 מ“ר

כמות גליל אחד
קוד מוצר MESH

רשת PVC מוטבעת לתוך שכבת הטיח הזו כדי לחזק אותה.

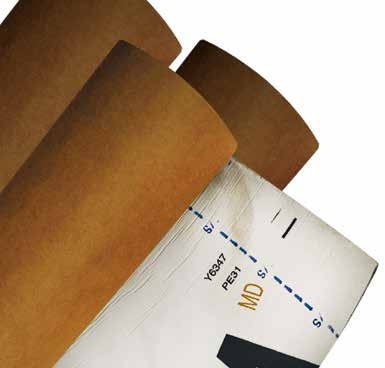
[picture p179: figure]
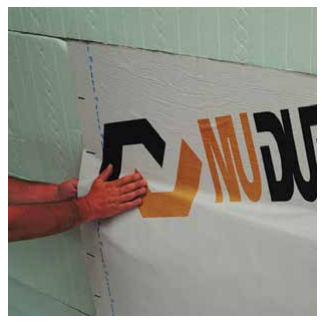
[picture p180: figure]

### גיליון איטום נגד מים - 21 מ“ר

כמות גליל אחד
קוד מוצר WPROF
גיליון האיטום נגד מים מסוג קלף-והדבק משמש לאיטום נגד מים מתחת לפני הקרקע של קירו ת NUDURA. שימושים אחרים לג י ליון האיטום נגד מים כוללים איטום מסביב לפתחי החלונות והדי לתות, ואיטום בין בסיס הלבנים לקירות.

כמות גליל אחד
קוד מוצר 2WPROF
A. דירוג קיץ B. דירוג חורף

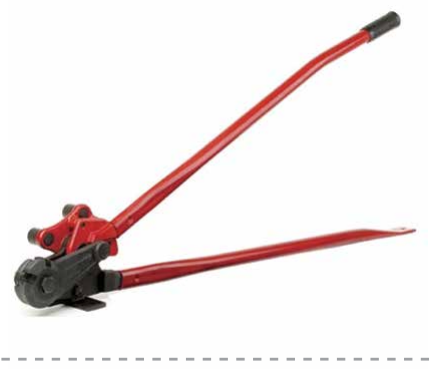
[picture p181: figure]

### קאטר למוטות חיזוק

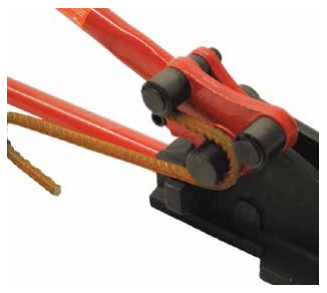
[picture p182: figure]

כמות קאטר/מכופף אחד
קוד מוצר RBC

הקאטר למוטות חיזוק משמש לחיתוך ולכיפוף של מוטות מפלדה מזוינת המשמשים לבניית קירות NUDURA. הוא מגיע עם שני ראשי חיתוך שמסוגלים לחתוך מוטות פלדה מזוינת שגודלם עד מס‘ 5 )M15). הגלגיליות שמשמשות לכיפוף הפלדה מסוגלות לטפל במוטות שגודלם עד מס‘ 5 )M15).

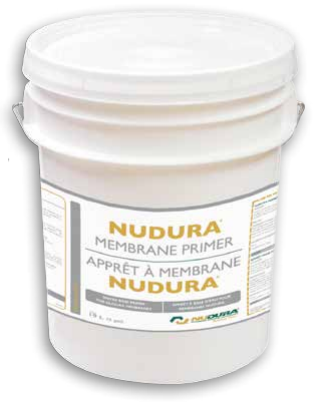
[picture p183: figure]
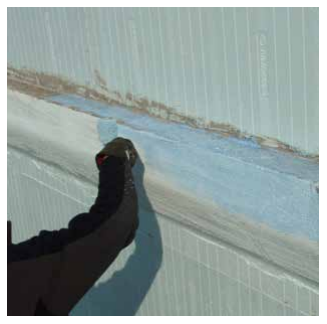
[picture p184: figure]
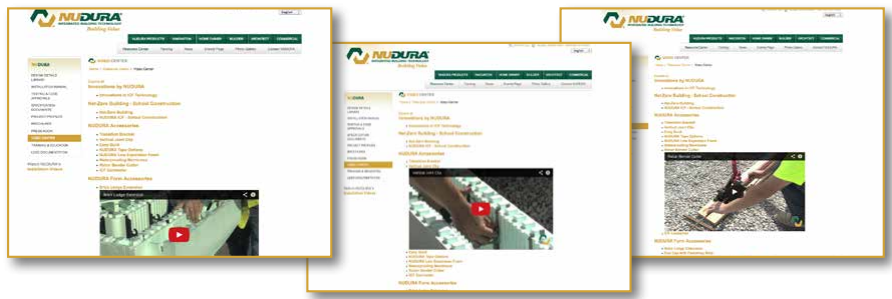
[picture p185: figure]
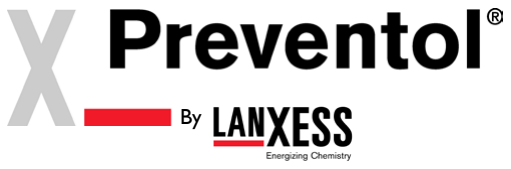
[picture p186: figure]

TMRPreventol הוא טיפול מבוסס-אימידקלופריד נגד טרמיטים שניתן להוסיף אותו בשלב הייצור של כל | By
RPreventol .ICF NUDURA עבר הערכה רשמית של Service Evaluation ICC לשימוש נגד

מוצרי TM
טרמיטים והוגדר כדוחה חרקים לשימוש בפוליסטירן מוקצף )-2918ESR (.)EPS).( הערה: את המוצר הזה
ניתן להשיג רק במפעל NUDURA בדרום ארה“ב על פי דרישות קוד הבנייה האמריקאי.(

למידע נוסף ולצפייה בסרטון על האביזרים השונים שמציעה NUDURA, בקרו באתר accessoryvideos/il.co.nudura.

### שכבת יסוד לגיליון איטום

כמות מכל אחד
קוד מוצר WPRIME
שכבת היסוד נועדה לשימוש עם גיליון האיטום הנדבק-מעצמו של NUDURA. שכבת יסוד מבוססת-תחליב פולימר זו ניתנת לרכישה במכלים של 19 ליטר, שכל אחד מהם מכסה כ60-–90 מ“ר של קיר. שכבת היסוד לגיליון איטום של NUDURA יכולה לשפר את איכות הדבקת גיליון האיטום באזורים מסוימים.

# אביזרי NUDURA

# מערכת היישור של NUDURA

## פין למניעת

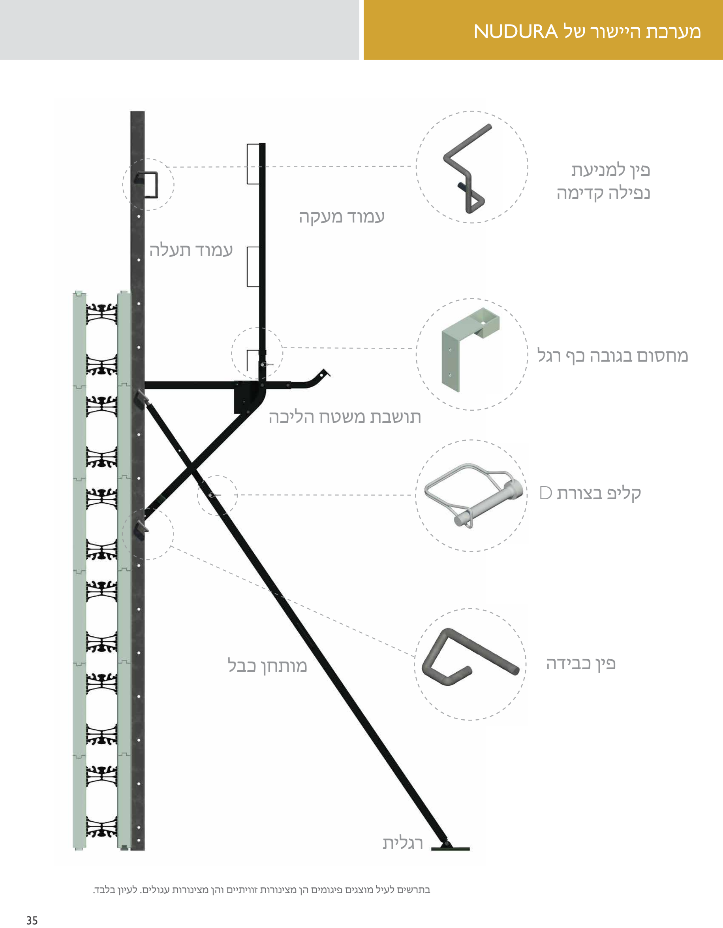
[picture p187: page 35]

## עמוד תעלה

## נפילה קדימה

## תושבת משטח הליכה

## מותחן כבל

## מחסום בגובה כף רגל

## קליפ בצורת D

## פין כבידה

## עמוד מעקה

## רגלית

בתרשים לעיל מוצגים פיגומים הן מצינורות זוויתיים והן מצינורות עגולים. לעיון בלבד.

פיגומים מצינורות זוויתיים - ללא עמודי תעלה מכיל 20 עמודי מעקה
20 תושבות משטח הליכה
20 מותחני כבל
40 פיני כבידה

קוד מוצר L-BRAC

ארוז על משטח עץ. ניתן להזמין בנפרד מסגרת אריזה ממתכת⁺⁺. את עמודי התעלה של הקיר יש להזמין בנפרד. ראו להלן.

עמודי תעלה לקיר )הפיגומים אינם כלולים(
2 מ‘ *-8CHA
3 מ‘ -10CHA
4 מ‘ -12CHA

כולל /100קופסה
קוד מוצר CLIP-D

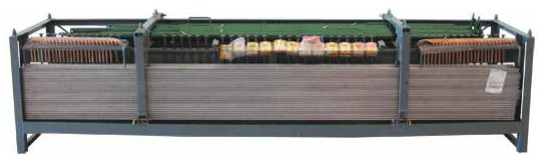
[picture p188: figure]

כולל /50קופסה
קוד מוצר PINS-G

כולל /40קופסה
קוד מוצר FFGPIN

כולל /40קופסה
קוד מוצר TCLAMP

עמודי תעלה/מארז 20

פיגומים מצינורות זוויתיים - עם עמודי תעלה 3 מ‘ מכיל 20 עמודי תעלה לקיר באורך 3 מ‘
20 עמודי מעקה
20 תושבות משטח הליכה
20 מותחני כבל
40 פיני כבידה

קוד מוצר R10BST

ארוזים במסגרת אריזה ממתכת⁺⁺.

פיגומים מצינורות עגולים - עם עמודי תעלה 3 מ‘

קליפ בצורת D פיני כבידה - 6 אינץ‘ )152 מ“מ(

פין למניעת נפילה קדימה מחסום בגובה כף רגל

מכיל 20 עמודי תעלה לקיר באורך 3 מ‘
20 עמודי מעקה
20 תושבות משטח הליכה
20 מותחני כבל
40 פיני כבידה

קוד מוצר *R10BRT
ארוזים במסגרת אריזה ממתכת⁺⁺.

*הזמנה מיוחדת - יש צורך בזמן ייצור לאספקת הזמנה זו.

פיגומים מצינורות עגולים - עם עמודי תעלה 4 מ‘ מכיל 20 עמודי תעלה לקיר באורך 4 מ‘ 20 עמודי מעקה
20 תושבות משטח הליכה
20 מותחני כבל
40 פיני כבידה

קוד מוצר *R12BRT
ארוזים במסגרת אריזה ממתכת⁺⁺.

++מסגרת אריזה ממתכת - קוד מוצר BRRACK

# מערכת היישור של NUDURA

# מתאם של NUDURA לקירות גבוהים

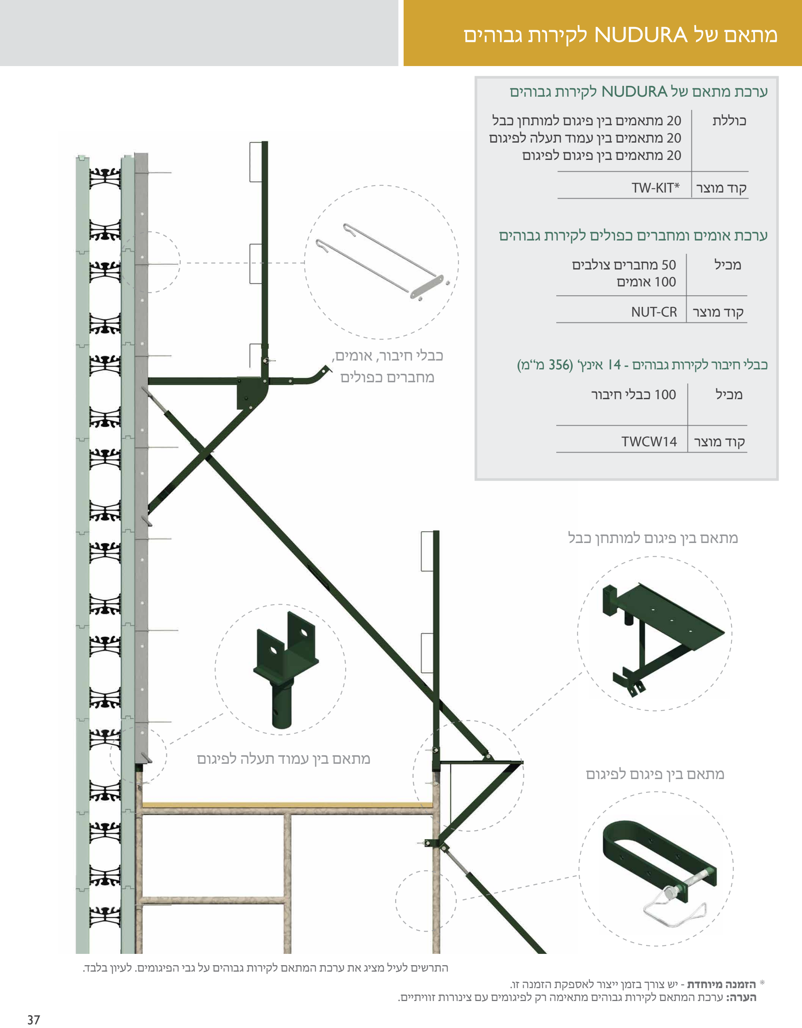
[picture p189: page 37]

### ערכת מתאם של NUDURA לקירות גבוהים

כוללת 20 מתאמים בין פיגום למותחן כבל 20 מתאמים בין עמוד תעלה לפיגום
20 מתאמים בין פיגום לפיגום

קוד מוצר *KIT-TW

### ערכת אומים ומחברים כפולים לקירות גבוהים

מכיל 50 מחברים צולבים
100 אומים
קוד מוצר CR-NUT

כבלי חיבור לקירות גבוהים - 14 אינץ‘ )356 מ“מ( מכיל 100 כבלי חיבור

קוד מוצר 14TWCW

התרשים לעיל מציג את ערכת המתאם לקירות גבוהים על גבי הפיגומים. לעיון בלבד. * הזמנה מיוחדת - יש צורך בזמן ייצור לאספקת הזמנה זו.

### מתאם בין פיגום למותחן כבל

### מתאם בין עמוד תעלה לפיגום מתאם בין פיגום לפיגום

כבלי חיבור, אומים,

### מחברים כפולים

הערה: ערכת המתאם לקירות גבוהים מתאימה רק לפיגומים עם צינורות זוויתיים.

# תמיכה ושירות לקוחות

### כלים ומשאבים מקוונים למקצוענים

אתר NUDURA מספק לקבלנים, לאדריכלים ולאנשי מקצוע בתחום הבנייה ספרייה עשירה בפרטי תכנון, מדריכי התקנות, סרטוני הדרכה, גלריית תמונות ענקית מפרויקטים שונים ועוד הרבה יותר. לגישה לכלים ולמשאבים המקוונים שלנו למקצוענים בקרו באתר center-resource/il.co.nudura.

### תמיכה טכנית ושירות לקוחות

המפיץ המורשה של NUDURA יוכל לספק לכם תמיכה טכנית רחבה לצד שירותים כגון: המלצות בנושא התקנה, עצות עדכניות בנוגע לתאימות לקודי הבנייה, מידע על מוצרים ויישומי התקנה שונים. המפיץ המקומי יוכל גם לספק חומרים לעבודות בקנה מידה קטן. למידע נוסף, פנו למפיץ המקומי שלכם בטלפון .02-970-9705

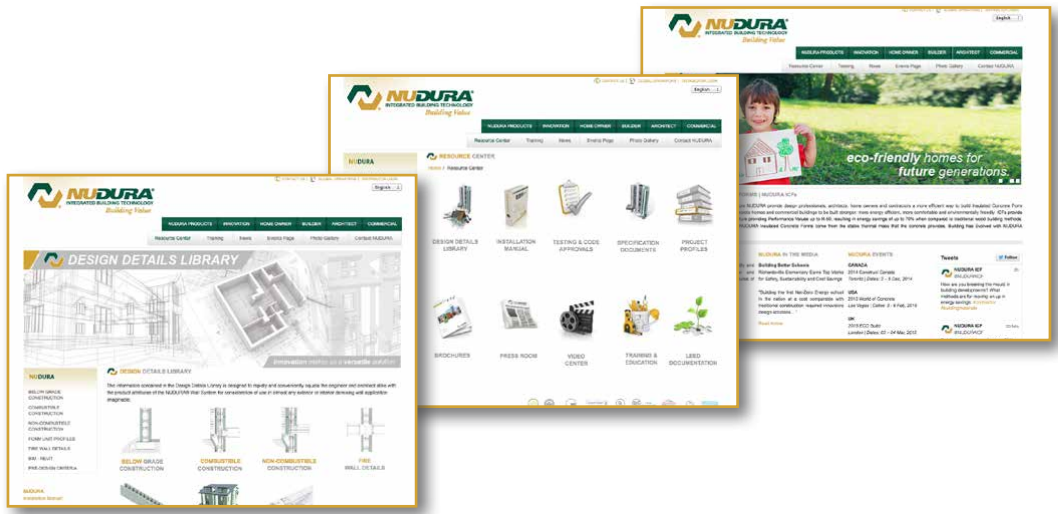
[picture p190: figure]

הדרכה בסיסית בנושאי התקנות וקורסים של ה-AIA. NUDURAA מציעה לבנאים ולמתקינים סמינר הדרכה של יום אחד במטרה לספק להם כישורי בנייה בסיסיים עם תבניות הבטון המ בודדות שלה. המטרה שלנו היא להעביר לכם את הידע הדרוש לביצוע העבודה בבטחה ובאופן יעיל. לאיתור קורסי הדרכה באזורכם, התקשרו לאקדמיה של Nudura בטלפון 02-970-9705

במטרה לספק לכם מידע על התקנים העדכניים בענף, נרשמה NUDURA כספקית מורשית ב‘מערכת ההכשרה המתמשכת‘ של AIA )איגוד האדריכלים האמריקאי(. למידע נוסף על תוכניות הדרכה אלו, התקשרו למספר 02-970-9705

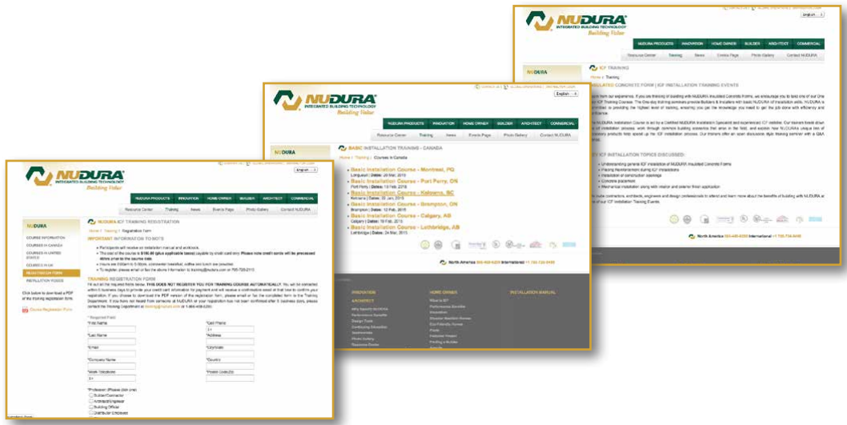
[picture p191: figure]

להורדת אפליקציית Centre Information Product שלנו עבור iPad.

### הערות

PRODIL
IL1605ND

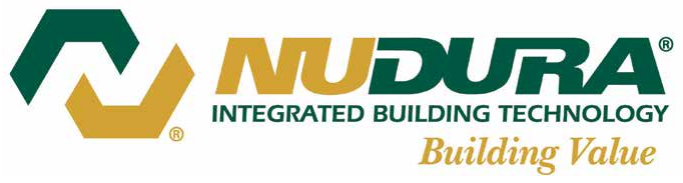
[picture p192: figure]

ניסיון בנייה של מעל 50 שנה.

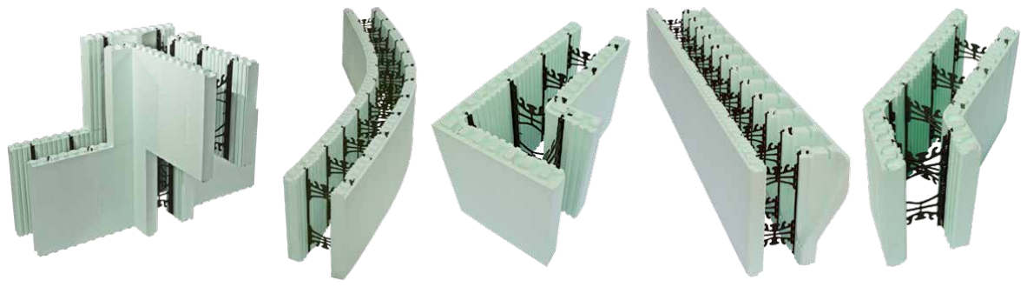
[picture p193: figure]

כשתבחרו בתבניות הבטון המבודדות של NUDURA לבניית הבניין הבא שלכם, תדעו שאתם משתמשים בפתרון הבנייה הטוב ביותר שיש כיום.

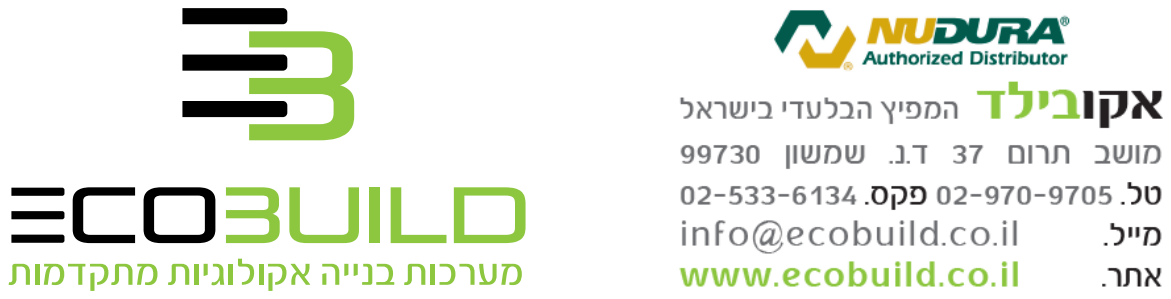
[picture p194: figure]

RNUDURA)”. המדריך

המידע הכלול במדריך זה למוצרי NUDURA מוצג כאן רק במטרה לספק מידע על המוצרים השונים המהווים חלק ממערכת תבניות הבטון המבודדות של RNUDURA“( RNUDURA אינה מבטיחה כל הבטחות בנוגע לישימות הספציפית של כל אחד מהמוצרים לנסיבות שבהן יבחר המתכנן

הזה למוצרי NUDURA לא יכול לשמש כתחליף לקבלת ייעוץ הנדסי מקצועי. RNUDURA כל שליטה בהתקנה או באיכות

להשתמש במוצרים אלה. באחריות מתכנן הפרויקט לבצע תיקונים או שינויים סופיים שיתאמו את הנסיבות המדויקות של השימוש במוצרים אלה. אין ל-RNUDURA לא תישא באחריות לאף נזק כללי, ספציפי, ישיר, עקיף או תוצאתי, כולל פגיעה גופנית, שיסבול כל אדם, כולל, ללא הגבלה, המתקין,

העבודה של התקנת מוצרי RNUDURA. אי לכך, הקבלן, האדריכל, המהנדס, בעל הבית או הלקוח עקב השימוש, ההרכבה או ההתקנה של RNUDURA. מוצרי NUDURA המתוארים לעיל נמכרים בכפוף לאחריות המוגבלת של NUDURA CORPORATION.

פנו אלינו לקבלת פרטים על המפיץ הקרוב אליכם. 02-970-9705

TM R הם סימנים מסחריים של Corporation NUDURA © 2014
