Tanvi11Ghelani/ECO_BUILD_UI/build/EcoBuildPdf/Information Center/Project Description/Janacek Residence Project Profile.pdf

## NUDURA Project Profile

0800 014 8901

### www.nuduraicfs.co.uk

### PROJECT STATISTICS

Location:
Princeton,Texas

Building:
2 1,450m of indoor space on six levels and an octagonal tower rising more than 33m above the foundations.

ICF:
2 1,500m of NUDURA ICF

2
forms; 186m as interior wall

2
and an additional 930m
Insuldeck EPS floor decking

ICF Installer:
Cameron Ware, Double Eagle Builders

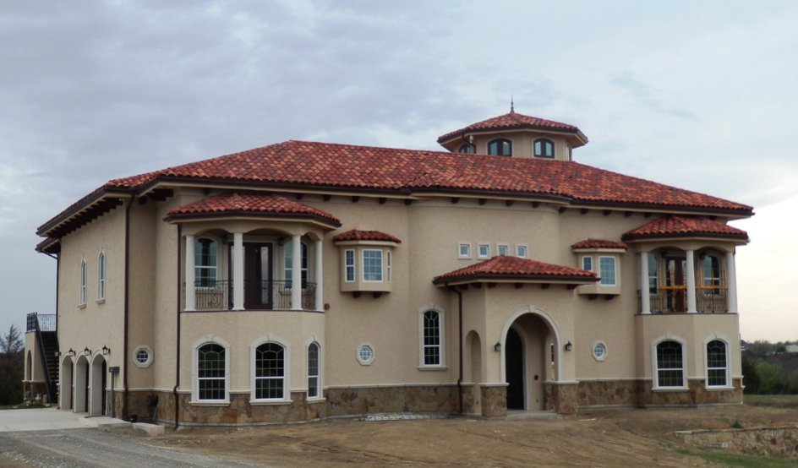
[picture p195: figure]

## Designer residence sets new ICF standards

The Janacek Residence in Princeton Texas is an exemplar of how ICF lends itself to construcon on a grand scale. This designer home took 15 months to build, of which, only 60 days were needed install NUDURA ICF.

st
The Janacek Residence is a 21 century landmark in the town of Princeton, 2 Texas, and lies about 25 miles northeast of Dallas. With 1,450m of indoor space on six levels and an octagonal tower rising more than 33m above the foundaons, it is truly a flagship project. Its crowning glory, the observaon tower, houses a 3.05m diameter, anque stained glass dome to beauful effect.

2 In total, the scheme used more than 1,500m of NUDURA ICF forms

2 | 2
(152mm and 305mmcore); 186m as interior walls and an addional 930m 2 of Insuldeck EPS floor decking including a 185m pao.

The project; constructed by Cameron Ware of ICF installers, Double Eagle

3
Builders and supplied by distributors FutureStone; was built using 765m of concrete. The three key challenges unique to this bespoke project were; the sheer scale of the building, its geometry and the heavy loads amassed by the concrete floors.

Georgia architectural home designer, G. Frank Dollar teamed up with his Texas client to design and build this custom-built, energy efficient dwelling. The homeowner, a busy cardiologist, acted as main contractor and his requirements were well established in his own mind before appoinng Dollar. The design of the mansion, an outcome of an ever increasingly

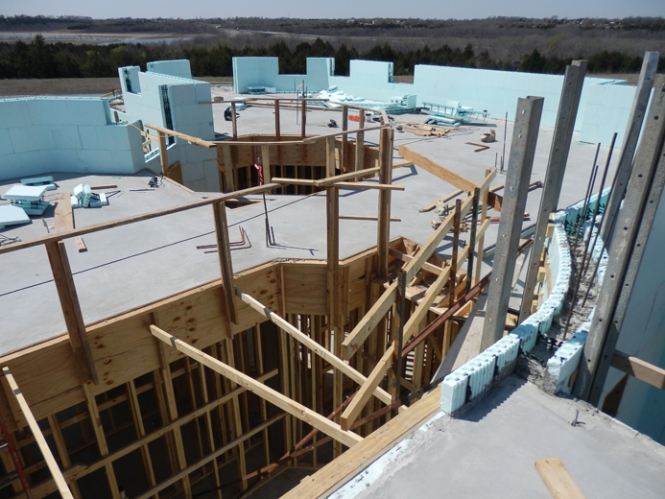
[picture p196: figure]
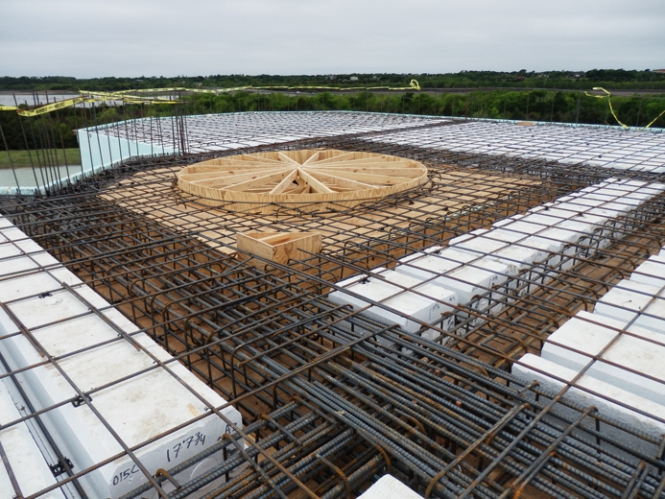
[picture p197: figure]
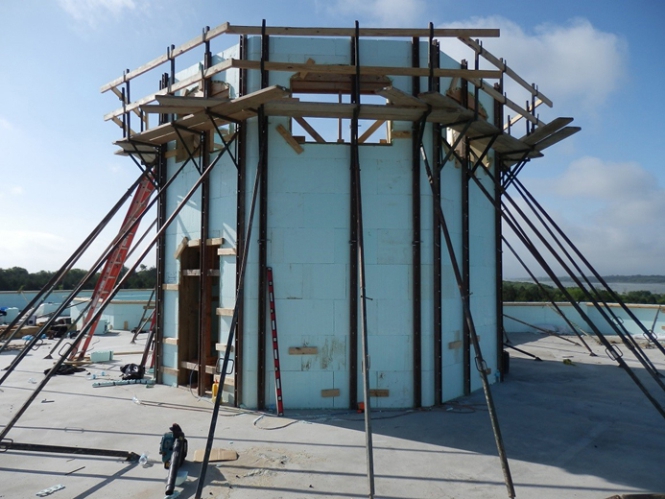
[picture p198: figure]
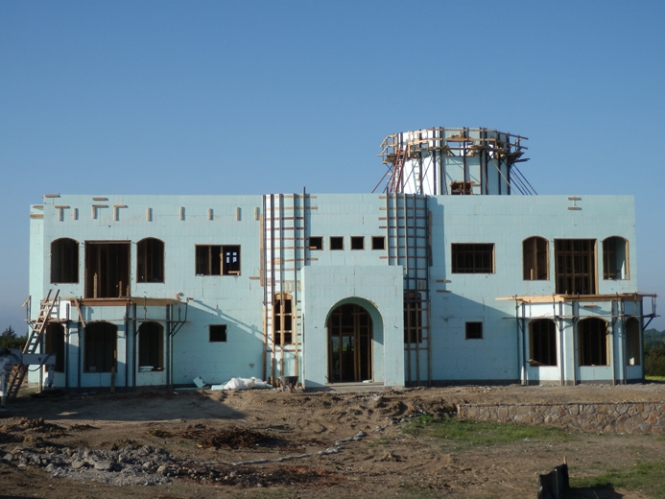
[picture p199: figure]

digital world, was developed in Georgia and client liaison comprised telephone and e-mail conversaons while documents and drawings were couriered overnight. Mr. Janacek's vision was to build a luxury home, while retaining the need for durability, all-round efficiency and sustainability.

Janacek's Concrete Challenge
The home includes six floor elevaons, all of which are constructed of concrete: sump room, storm shelter/safe room, first (ground) floor, second floor, ac floor and tower levels. Load calculaons for the tremendous weight of the floors and interior ICF walls required a major feat of engineering, especially as the floor plan required that some of the second floor columns and ICF walls to be offset from those below.

Structural engineer, Jerry Coombs used transfer beams and canlevers within the floor deck to collect the floor loads and carry them to the foundaon. Beams varied in size from 915mm x 510mm to 610mm x 430mm and all were poured monolithically with the Insul-deck wall system.

The arched arcade, which surrounds most of the first floor, was cast in place using removable forms. It also

2
supports approximately 185m of the outdoor pao. Janacek himself designed an ingenious thermal break which isolates all external concrete decking from the interior concrete floors which was implemented by the ICF installers.

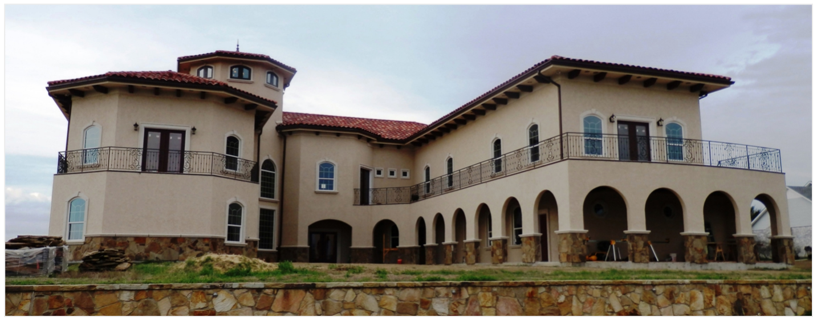
[picture p200: figure]

Each segment of the U-shaped home extends approximately 30m, long enough to cause concerns about floor deck shrinkage. Since an expansion or movement joint was undesirable, special consideraon had to be given to floor cracking in the reentrant corners as well as ensuring that deck shrinkage did not cause excess irregularity to the walls.

Janacek sits on expansive clay. To compensate for poor site soil condions, the foundaon sits on 98 concrete piers each extending 7.6m into the soil. Radius floors and landings in the tower were poured monolithically with the walls. All arches in windows and doors were built out of ICF and poured.

The observaon deck is the highest point of the building, created with ICF fully around its perimeter, and is supported at the ac level. Since a proporon of the walls were supported on the perimeter wall of the house, and the other on the Insuldeck, the engineer also had to resolve concerns about differenal deflecon.

The interior is well appointed, a central feature being the broad spiral staircase which enables access to all floors.

The finished home offers outstanding energy efficiency. To date, the Janacek Residence has recorded energy bills which average about $250 a month. Instead of a typical well system, a lake on the property facilitates a geothermal

2
heang/cooling system. Some 930m of living space is condioned for approximately $90 per month which represents a miniscule sum for a home of this size in the Texan heat.

The Janacek Residence has many other unique features. In addion to ICF construcon and the illuminated stained glass dome, residenal home automaon and an all-LED interior lighng system have been installed. The project 2 won Annual Insulated Concrete Form (ICF) Builder Awards in the Unlimited Residenal category (over 550m ) on the basis of the project's design complexity, striking architecture, and the construcon challenges overcome. Janacek has set a new standard for the enre ICF industry and during construcon was visited regularly by engineers, architects, and homeowners interested in ICF. The builder discussed the project in detail in an on-line ICF forum which received more than 50,000 views.

For further informaon contact Jean Marc Bouvier, Director of Sales and Business Development – Internaonal on 07766 118711 or visit www.Nuduraicfs.co.uk (http://vimeo.com/90548467)
