Tanvi11Ghelani/ECO_BUILD_UI/build/EcoBuildPdf/Information Center/Project Description/Farmhouse Basement Project Profile v2.pdf

## NUDURA Project Profile

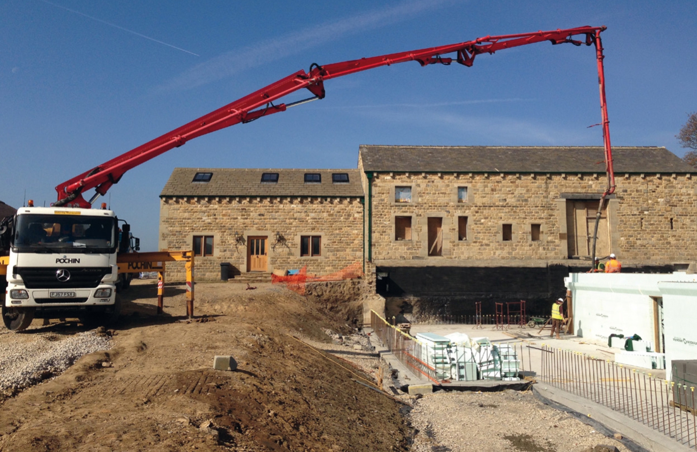
[picture p207: figure]

0800 014 8901

### www.nuduraicfs.co.uk

### NUDURA ICF chosen above and below ground for new build farmhouse

Landmarks (UK) Ltd, a Yorkshire based developer, has used insulated concrete form (ICF) technology both above and below ground in the construcon of a tradional two-storey farmhouse. The property sits on a natural gentle slope, so the basement is fully buried to the rear with a raised pao area to the front.

The property was built using the market leading, NUDURA ICF where polystyrene forms are used to contain the wet concrete when casng in-situ concrete walls – and are le in place as insulaon.

NUDURA ICF forms consist of two stay-in-place panels of expanded polystyrene which are connected with an innovave folding web which minimises wastage and offers maximum flexibility. The forms are transported flat to site, opened and stacked, reinforcement placed, propped and then filled with concrete; creang a solid monolithic concrete wall.

Blocks are typically installed to a li height to suit requirements and concrete is then poured into the forms. To ensure that no air remains within the void, the concrete is consolidated by means of a mechanical internal poker vibrator. As soon as the floor/roof is installed, wall building connues. The system is delivered to site folded flat to reduce distribuon costs and allow for easy handling and storage. A sturdy four-way reversible interlock enables the forms to lock together and waste is almost eliminated.

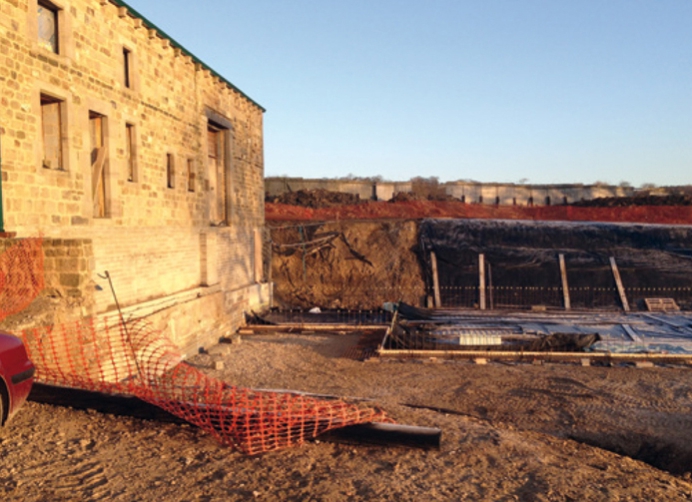
[picture p208: figure]
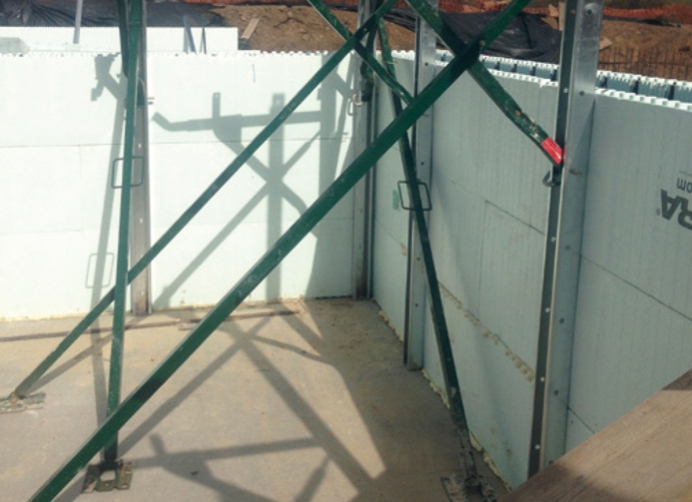
[picture p209: figure]

Using a number of Triton waterproofing products, the lower slab to the farmhouse was made waterproof by the installaon of a membrane beneath it and the inclusion of an addive in the mix. This waterproofing agent contains acve chemicals that react with fresh concrete to generate a non-soluble crystalline formaon that seals the concrete itself against the penetraon of water or liquid.

A pre-formed water bar, which swells by up to 350% when in contact with water, was placed into all joints. The shuering around the slab had made provision for the concrete groove in the face of slab and the bar was fixed into the groove using a masc expansion sealant. The hydro-swelling and lasng adhesive properes of the masc allow it to swell up to 100% when in contact with water. The bar was also placed in the centre of the wall on top of the slab so that the joint between the wall and the slab was protected.

The waterproofing addive was incorporated in the concrete mix used to form the basement walls. The walls were filled in one day, with over 60m³ of concrete being pumped and consolidated with the mechanical internal poker vibrator.

All joints between the polystyrene panels were protected with a width of reinforcing fabric to give extra tensile strength. A fillet seal trowelled into a wedge shape to the external toe of the concrete slab to ensure that any water flowed away from the joint which was also protected with the fleeceband.

Externally, the basement walls were treated with two coats of vapour membrane, a ready blended, single component acrylic modified coang that provides a primary waterproof and gas proof barrier. The membrane layer membrane provided a drainage and protecon layer, which as well as working as a tradional cavity drain membrane to allow air movement between its face and the formwork, was then draped down the walls to connect to the land drain. The geotexle layer of the membrane was extended over the land drain to ensure that fines are kept out of the system. The external walls were then back filled.

Jon Rowlands, a director at Landmarks UK Ltd., explained that although his company enjoys a rich heritage of building with tradional skills, they are acvely ulising complementary modern methods of construcon to build

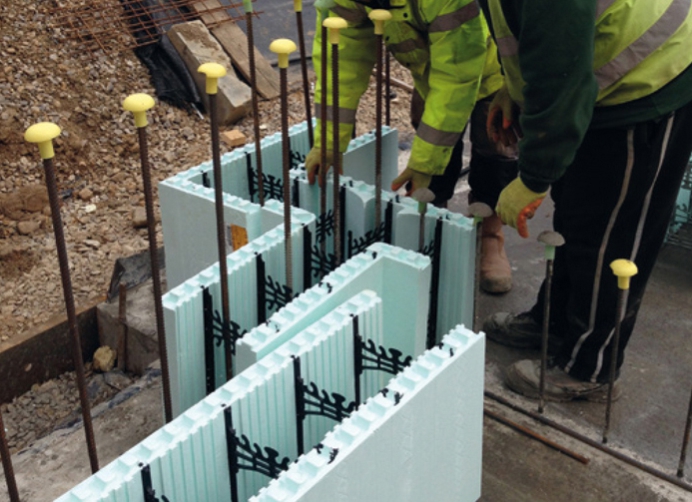
[picture p210: figure]
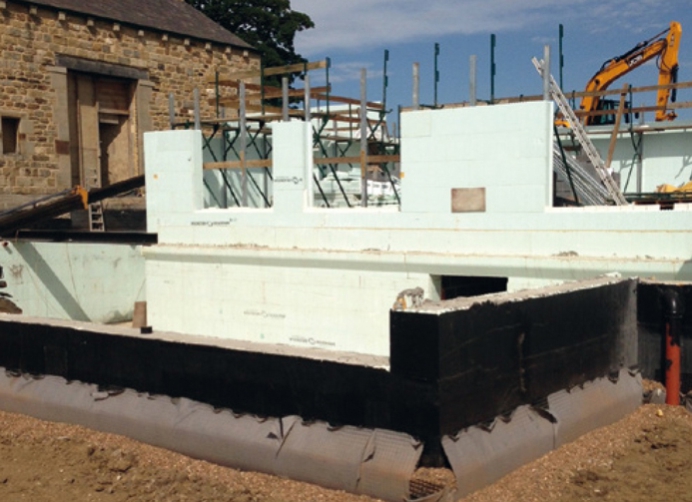
[picture p211: figure]

energy efficient housing in order to deliver low maintenance and low running costs. He said; “As NUDURA is suitable for both below and above ground applicaons, speed of build really comes into its own. ICF buildings also offer limitless design possibilies, unbeatable energy efficiency, acousc performance, strength, minimal maintenance and repair plus fire and disaster resistance”.

For further informaon contact Jean Marc Bouvier, Director of Sales and Business Development – Internaonal on 07766 118711 or visit www.Nuduraicfs.co.uk
