Tanvi11Ghelani/ECO_BUILD_UI/build/EcoBuildPdf/Information Center/Standard and laboratory certifications/ISO 9001 2008 certification.pdf

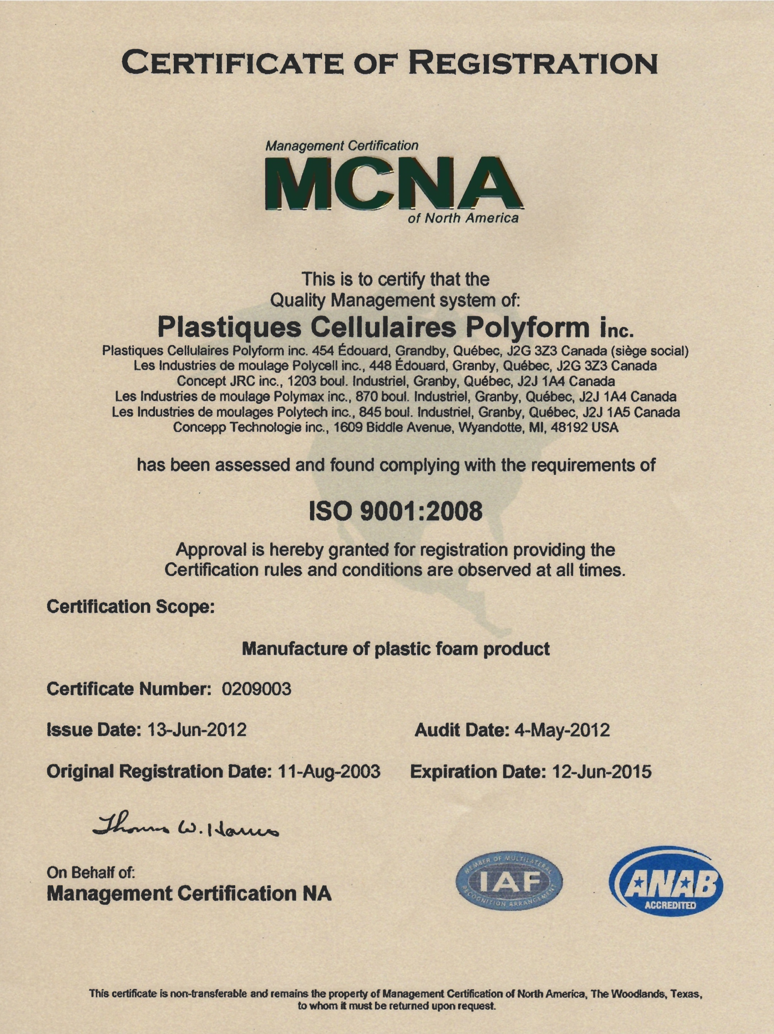
[picture p226: page 1]
