Tanvi11Ghelani/ECO_BUILD_UI/build/EcoBuildPdf/EarlyDesignCriteria/General Layout Guide/Radius Wall Cut Dimensions/radius_wall_cut_dimensions-1.xls

 | Order Date
 | Distributor
 | P.O.Number
 | Client Name
 | Shipping Address
 | City
 | Postal Code
NUDURA Radius Wall Calculation Spreadsheet
Data Input:
Enter Outside Radius (in inches) - here > | 0
Enter O/A Form Thickness (in Inches) here > | 11.25
Inside Radius | -11.25
Enter Degrees of Turn of Radius here > | 90
Enter Total Courses of Form Units in wall here > | 1
Data Output:
 |  |  | Feet | Inches
Total Length of Outside Wall (in inches) = | 0.000 | or | 0 | 0.000
Total Length of Inside Wall (in inches) = | -17.671 | or | -1 | -5.671
Difference: Outside - Inside (in inches) = | 17.671
Total 8 Inch Segments of Outside Wall = | 0 | actual | 0
Interior Cut Segment Width per web space (in)= | #DIV/0!
Interior Ins. Segment Width per web space (in) = | #DIV/0!
Total Radius Forms per Course (nearest 1/2 unit)= | 0.5 | actual | 0
Total Forms Required for Order (full units) = | 0.5
