Tanvi11Ghelani/ECO_BUILD_UI/build/EcoBuildPdf/Product/Nudura Series/Gap Threshold Sealer.png

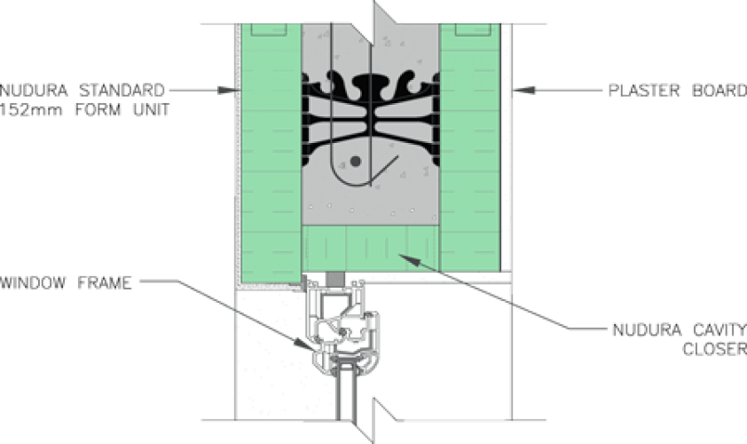
build/EcoBuildPdf/Product/Nudura Series/Gap Threshold Sealer.png
