Tanvi11Ghelani/ECO_BUILD_UI/build/Images/4WAY-REVERSIBLE-System.jpg

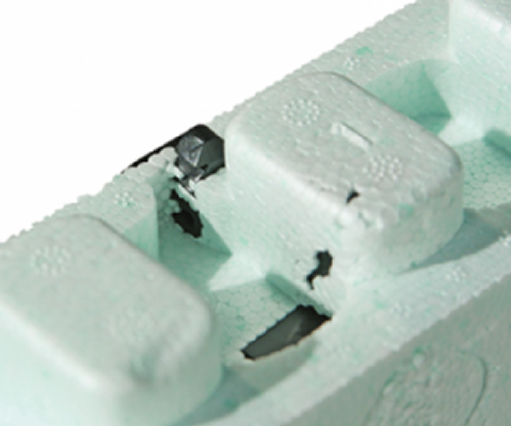
build/Images/4WAY-REVERSIBLE-System.jpg
