Tanvi11Ghelani/ECO_BUILD_UI/build/Images/about-us.jpg

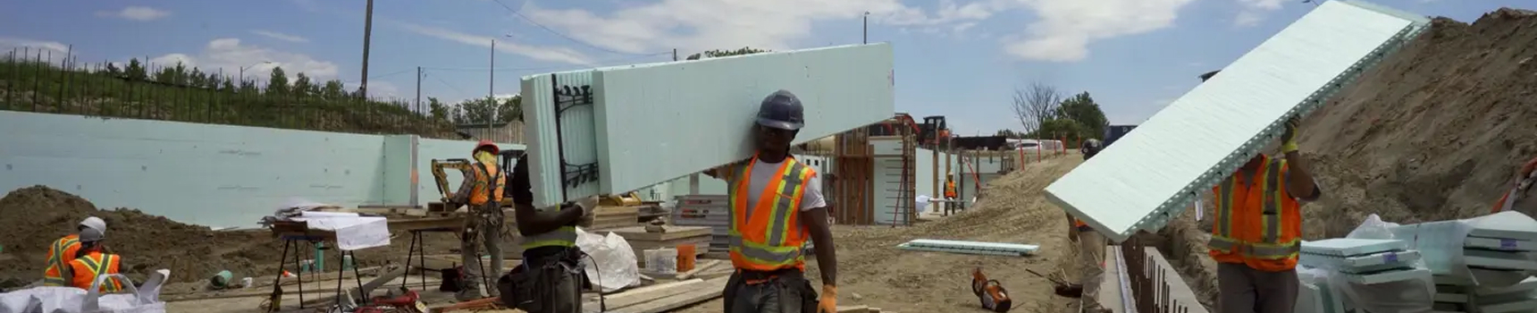
build/Images/about-us.jpg
