Tanvi11Ghelani/ECO_BUILD_UI/build/Images/blog-01.jpg

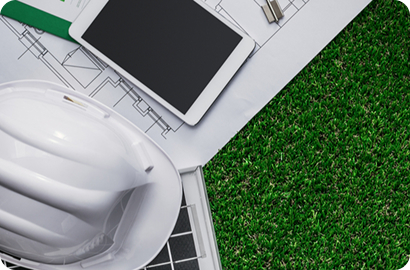
build/Images/blog-01.jpg
