Tanvi11Ghelani/ECO_BUILD_UI/build/Images/broadcast-video-thumbnail-01.jpg

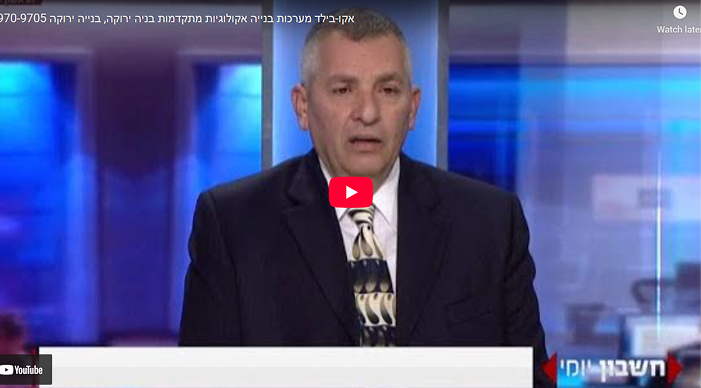
build/Images/broadcast-video-thumbnail-01.jpg
