Tanvi11Ghelani/ECO_BUILD_UI/build/Images/broadcast-video-thumbnail.jpg

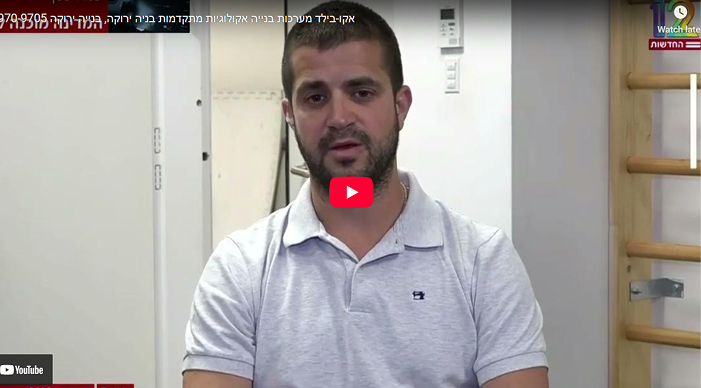
build/Images/broadcast-video-thumbnail.jpg
