Tanvi11Ghelani/ECO_BUILD_UI/build/Images/ceiling-technology.jpg

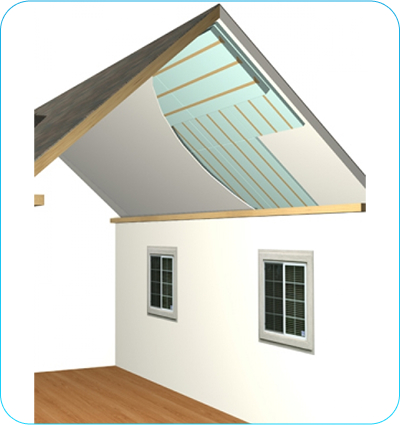
build/Images/ceiling-technology.jpg
