Tanvi11Ghelani/ECO_BUILD_UI/build/Images/Concrete-Core.jpg

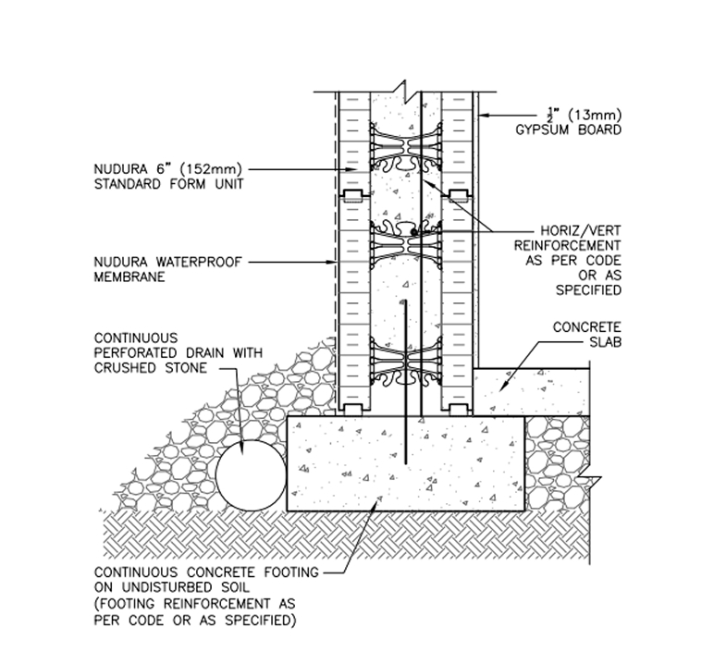
build/Images/Concrete-Core.jpg
