Tanvi11Ghelani/ECO_BUILD_UI/build/Images/Corley-House.jpg

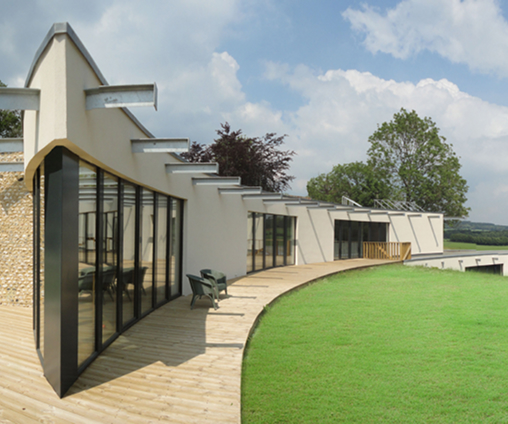
build/Images/Corley-House.jpg
