Tanvi11Ghelani/ECO_BUILD_UI/build/Images/DURAFOLD-Technology.jpg

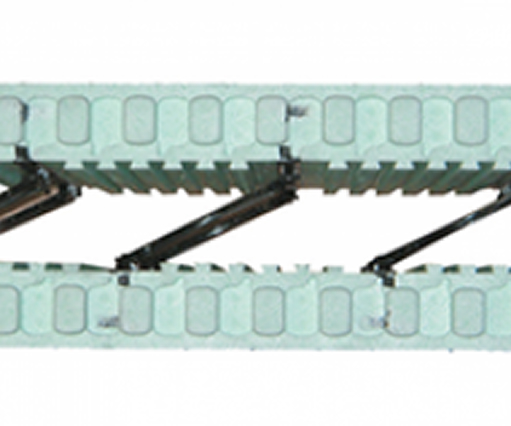
build/Images/DURAFOLD-Technology.jpg
