Tanvi11Ghelani/ECO_BUILD_UI/build/Images/DURALOK-Technology.jpg

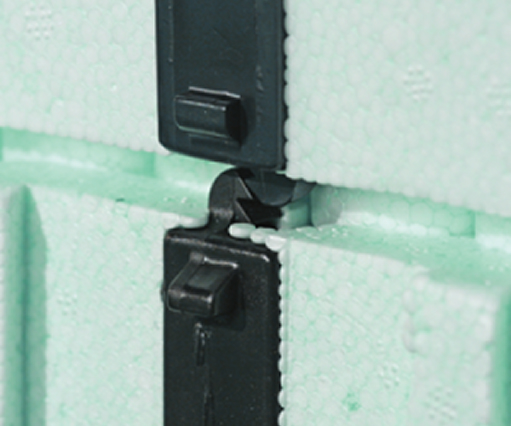
build/Images/DURALOK-Technology.jpg
