Tanvi11Ghelani/ECO_BUILD_UI/build/Images/DURAMAX-Technology.jpg

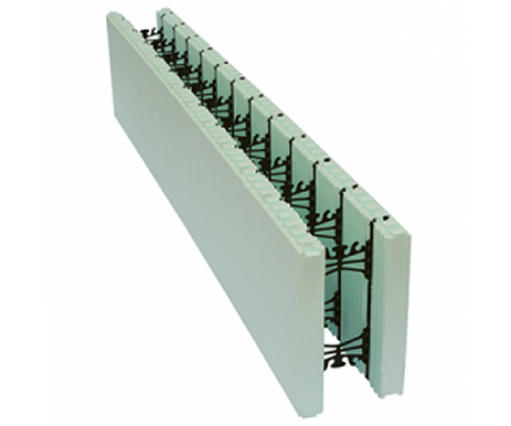
build/Images/DURAMAX-Technology.jpg
