Tanvi11Ghelani/ECO_BUILD_UI/build/Images/flooring-technology.jpg

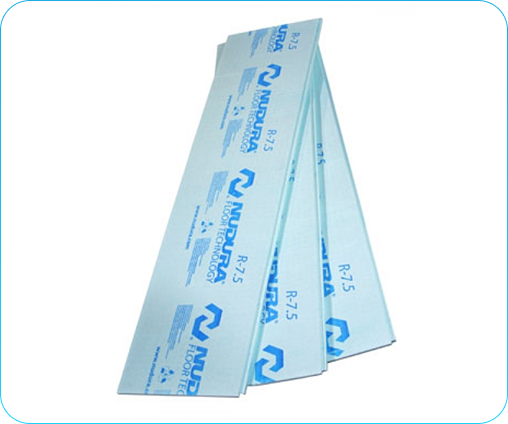
build/Images/flooring-technology.jpg
