Tanvi11Ghelani/ECO_BUILD_UI/build/Images/founder-profile.jpg

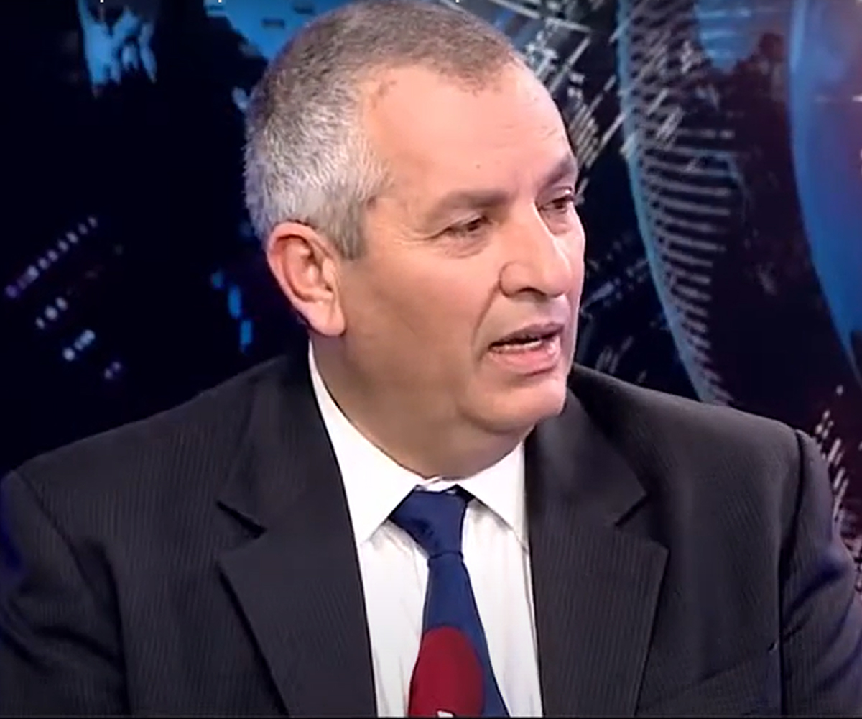
build/Images/founder-profile.jpg
