Tanvi11Ghelani/ECO_BUILD_UI/build/Images/gallery/gallery-img-all-10.jpg

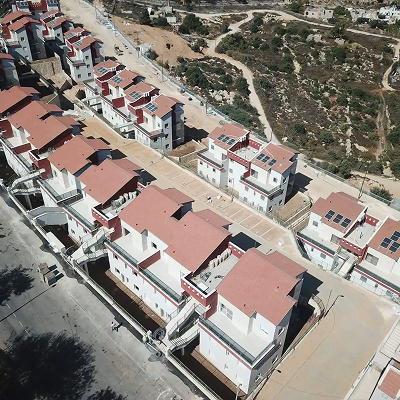
build/Images/gallery/gallery-img-all-10.jpg
