Tanvi11Ghelani/ECO_BUILD_UI/build/Images/gallery/gallery-img-all-11.jpg

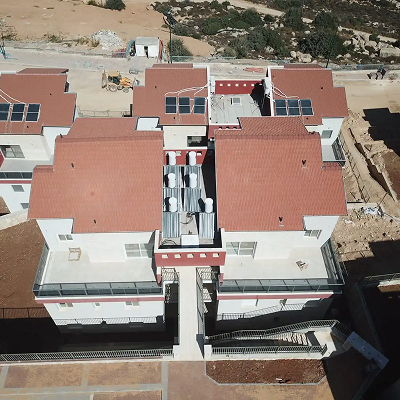
build/Images/gallery/gallery-img-all-11.jpg
