Tanvi11Ghelani/ECO_BUILD_UI/build/Images/gallery/hydrofoam-gallery-2.jpg

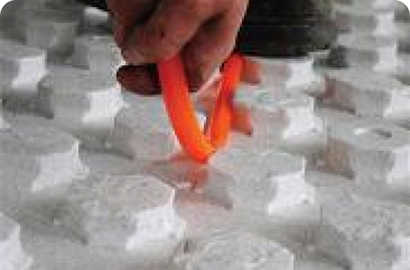
build/Images/gallery/hydrofoam-gallery-2.jpg
