Tanvi11Ghelani/ECO_BUILD_UI/build/Images/gallery/hydrofoam-gallery-5.jpg

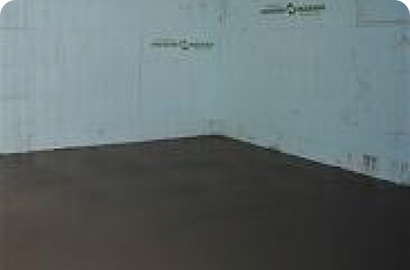
build/Images/gallery/hydrofoam-gallery-5.jpg
