Tanvi11Ghelani/ECO_BUILD_UI/build/Images/gallery/hydrofoam-gallery-7.jpg

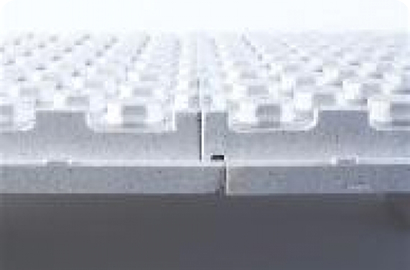
build/Images/gallery/hydrofoam-gallery-7.jpg
