Tanvi11Ghelani/ECO_BUILD_UI/build/Images/GreenNest-Eco-House.jpg

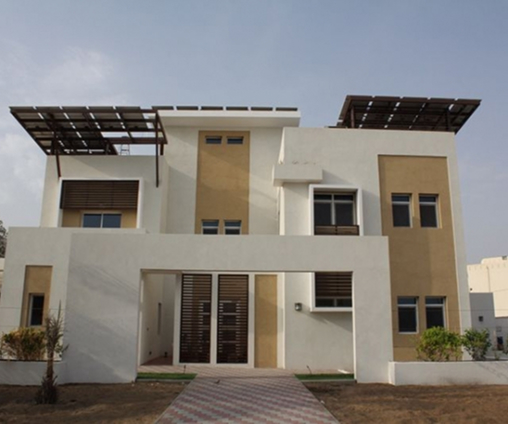
build/Images/GreenNest-Eco-House.jpg
