Tanvi11Ghelani/ECO_BUILD_UI/build/Images/helping-grow.png

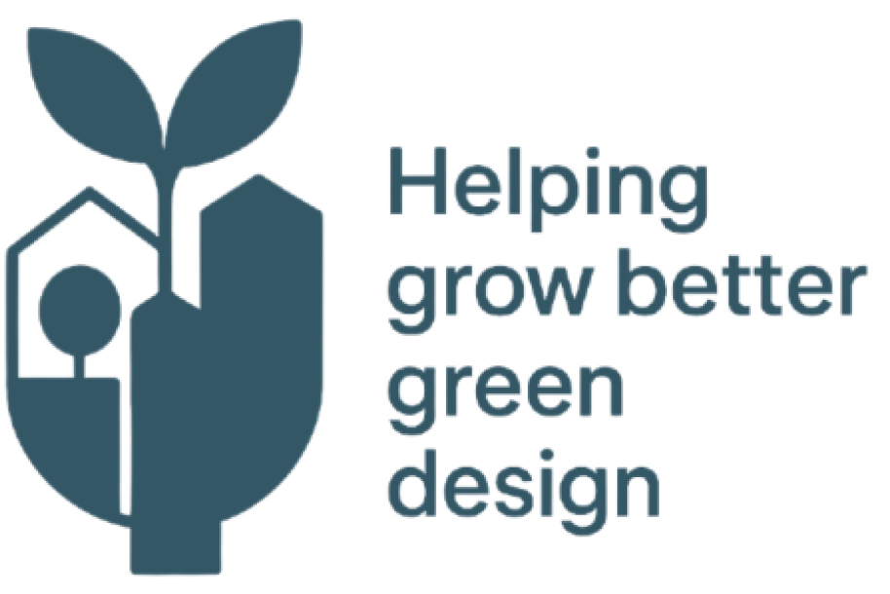
build/Images/helping-grow.png
