Tanvi11Ghelani/ECO_BUILD_UI/build/Images/hydro-scaled.jpg

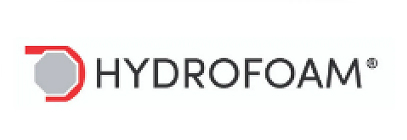
build/Images/hydro-scaled.jpg
