Tanvi11Ghelani/ECO_BUILD_UI/build/Images/ICF Series 1 slider.jpg

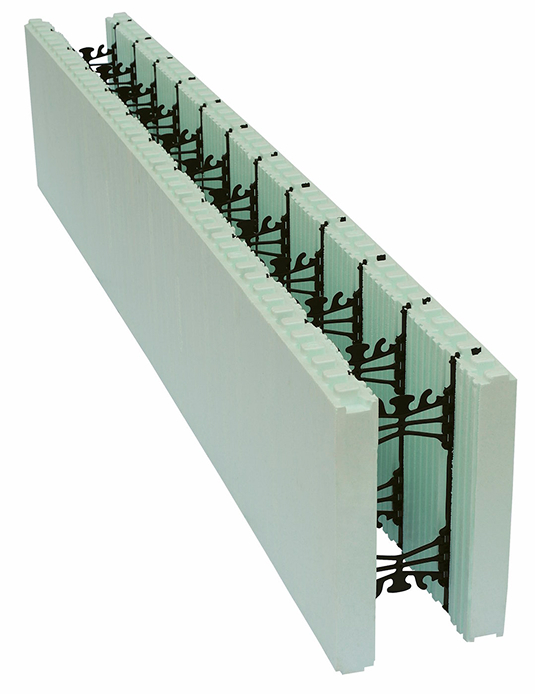
build/Images/ICF Series 1 slider.jpg
