Tanvi11Ghelani/ECO_BUILD_UI/build/Images/ICF Series 2 slider.jpg

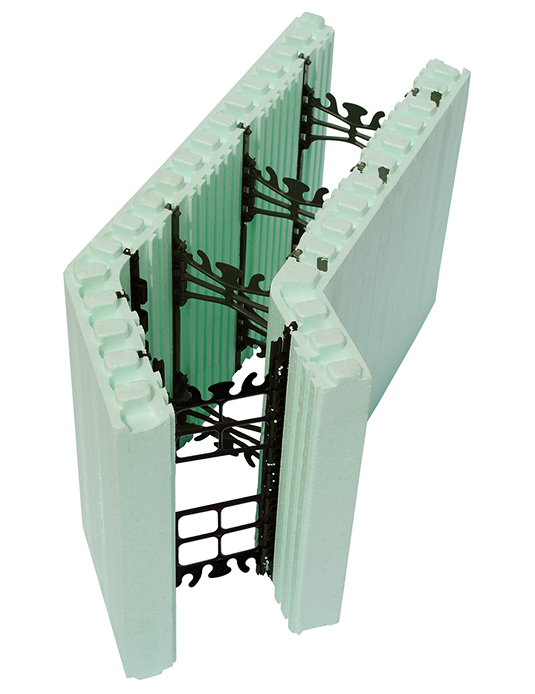
build/Images/ICF Series 2 slider.jpg
