Tanvi11Ghelani/ECO_BUILD_UI/build/Images/ICF Series 3 slider.jpg

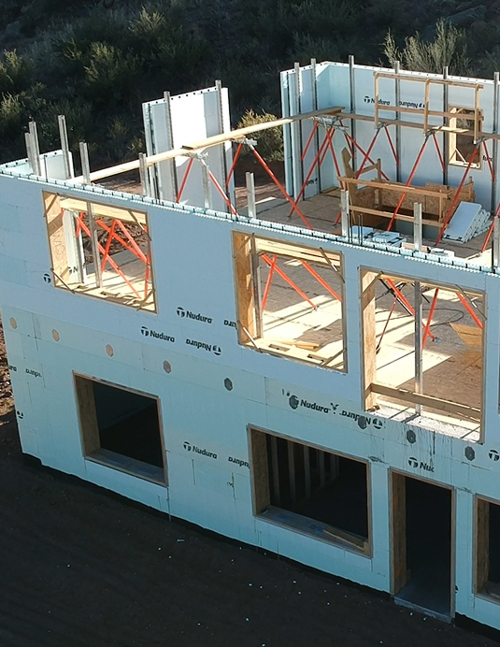
build/Images/ICF Series 3 slider.jpg
