Tanvi11Ghelani/ECO_BUILD_UI/build/Images/Internal-EPS-board.jpg

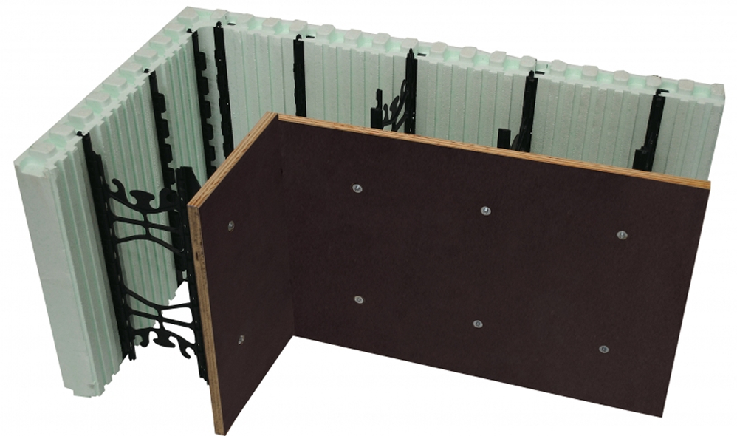
build/Images/Internal-EPS-board.jpg
