Tanvi11Ghelani/ECO_BUILD_UI/build/Images/Nudura-ICF-graph.png

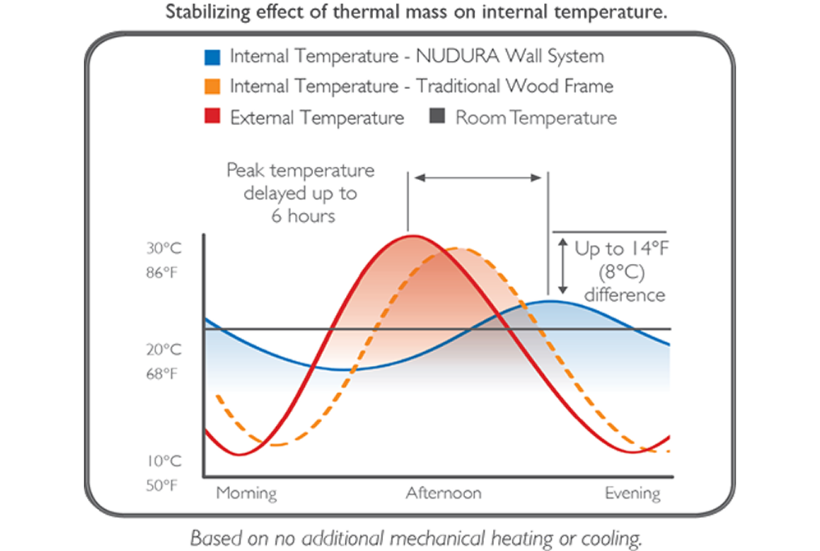
build/Images/Nudura-ICF-graph.png
