Tanvi11Ghelani/ECO_BUILD_UI/build/Images/Nudura-Plus-Series.jpg

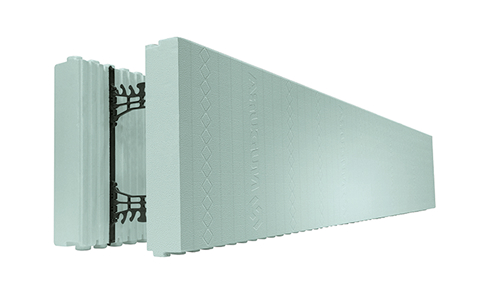
build/Images/Nudura-Plus-Series.jpg
