Tanvi11Ghelani/ECO_BUILD_UI/build/Images/onboarding-overlay.jpg

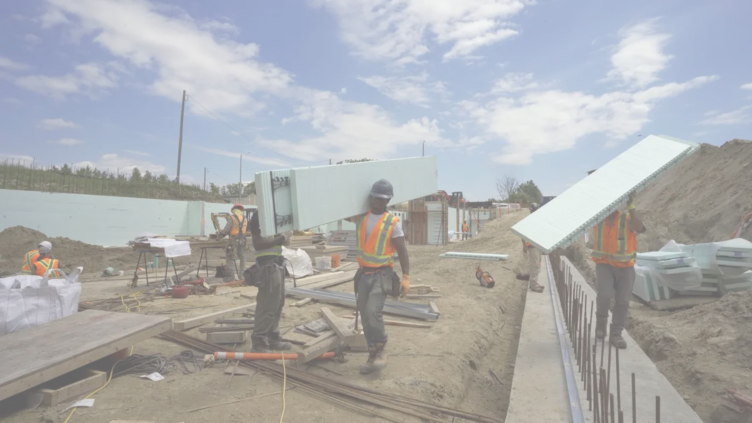
build/Images/onboarding-overlay.jpg
