Tanvi11Ghelani/ECO_BUILD_UI/build/Images/One-Series.jpg

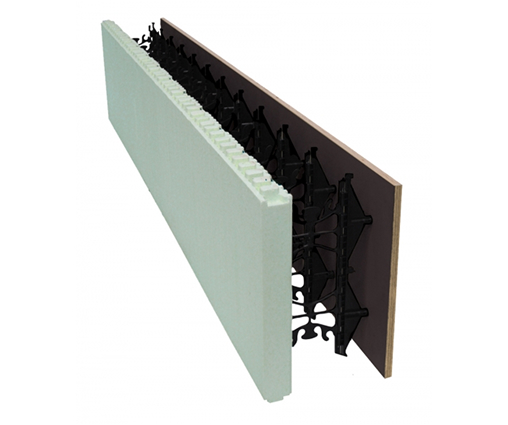
build/Images/One-Series.jpg
