Tanvi11Ghelani/ECO_BUILD_UI/build/Images/Plaster-finish01.jpg

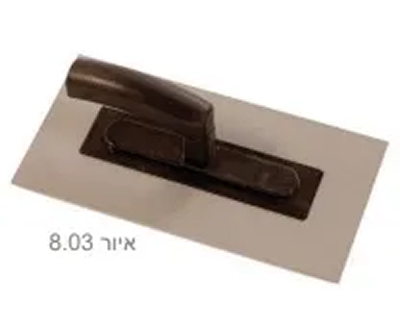
build/Images/Plaster-finish01.jpg
