Tanvi11Ghelani/ECO_BUILD_UI/build/Images/Plaster-finish.jpg

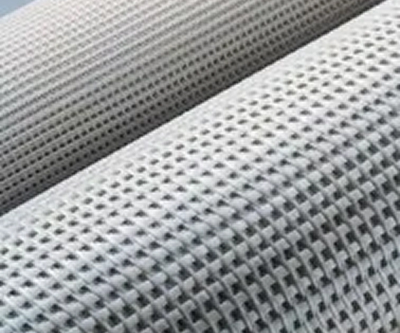
build/Images/Plaster-finish.jpg
