Tanvi11Ghelani/ECO_BUILD_UI/build/Images/prod-1.png

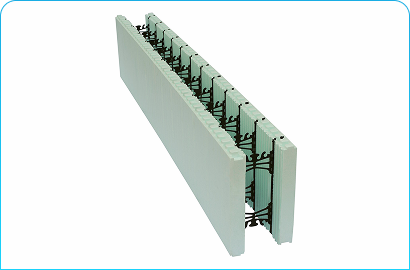
build/Images/prod-1.png
