Tanvi11Ghelani/ECO_BUILD_UI/build/Images/Product-features-book.jpg

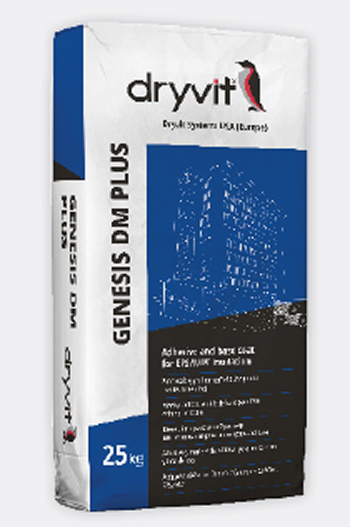
build/Images/Product-features-book.jpg
