Tanvi11Ghelani/ECO_BUILD_UI/build/Images/product-video-thumnail.jpg

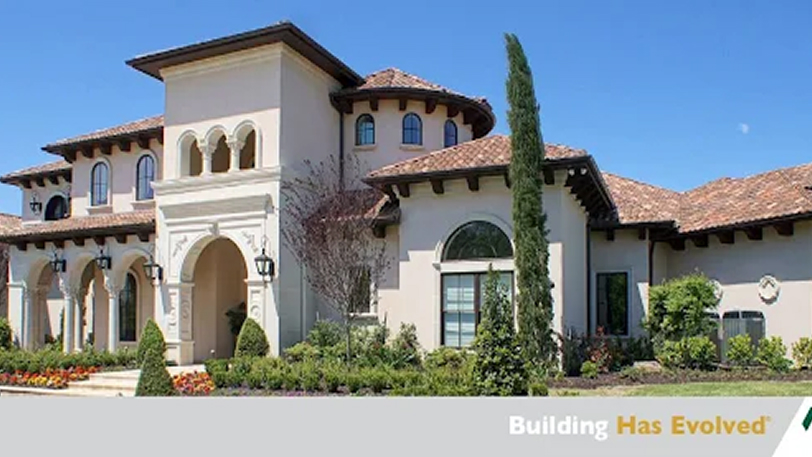
build/Images/product-video-thumnail.jpg
