Tanvi11Ghelani/ECO_BUILD_UI/build/Images/profile-01.jpg

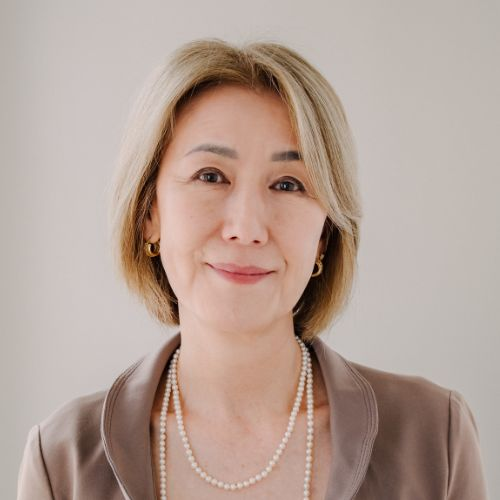
build/Images/profile-01.jpg
