Tanvi11Ghelani/ECO_BUILD_UI/build/Images/Rock-plaster.jpg

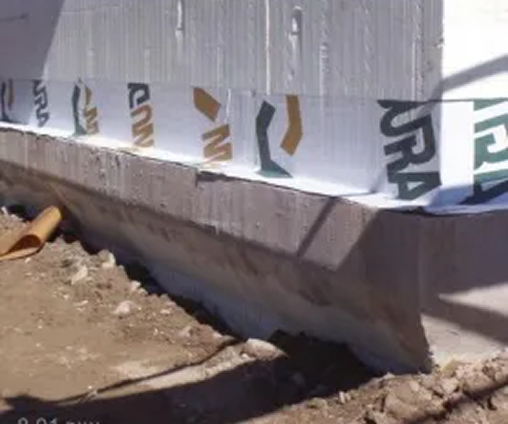
build/Images/Rock-plaster.jpg
