Tanvi11Ghelani/ECO_BUILD_UI/build/Images/Threshold-Sealer.jpg

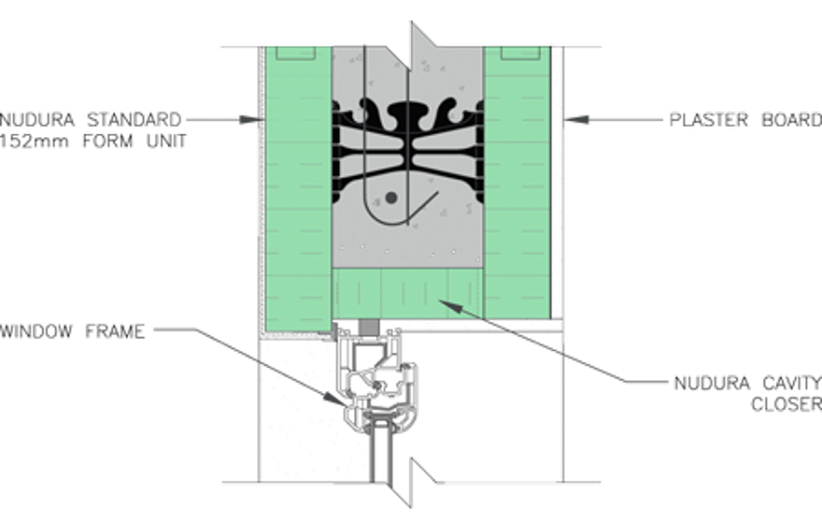
build/Images/Threshold-Sealer.jpg
