Tanvi11Ghelani/ECO_BUILD_UI/build/Images/thumnail.jpg

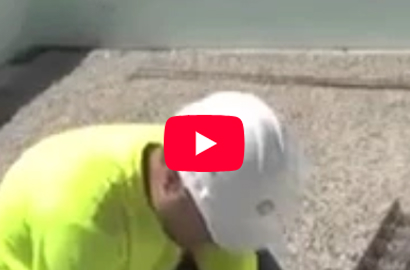
build/Images/thumnail.jpg
