Tanvi11Ghelani/ECO_BUILD_UI/build/EcoBuildPdf/Information Center/Files to Download/Technical circulars/Bracket for repairs.pdf

BUILDING HAS EVOLVED™

# תוסף תושבת קיר

תוסף תושבת הקיר RNUDURA משמש כאשר מתרחש שינוי או שגיאה לאחר יציקת הבטון לתוך התבניות והוא התקשה. תושבת זו משמשת בעיקר לשימושים כגון חיבורי רצפה או דק, חיבורי מסבכים בודדים, או עיגון / חיזוק של קיר מחיצה ממוסגר בחלקים פנימיים או חיצוניים לקיר ICF . מכיל:
- 2לוחות מוטבעות בצורת L אשר מחוברות לבטון
- 4 עוגני טריז "3// x" 4( 01 מ"מ x 011 מ"מ( או "5 )011 מ"מ( אורך נדרשים גם לכל סט של 1 לוחות מוטבעות בצורת L

הערה: יש להסיר לחלוטין את ה- EPS כדי לחשוף את הבטון לפני החיבור של תוסף תושבת קיר לבטון. ניתן להתקין מחדש את ה-EPS סביב התושבת או ניתן לשים ספריי קצף, לאחר שעוגני הטריז הותקנו והודקו.

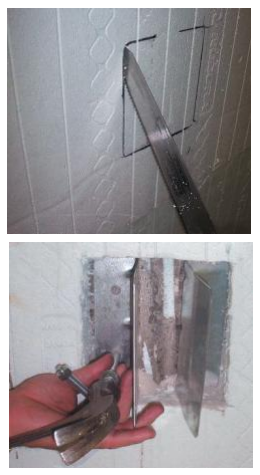
[picture p278: figure]
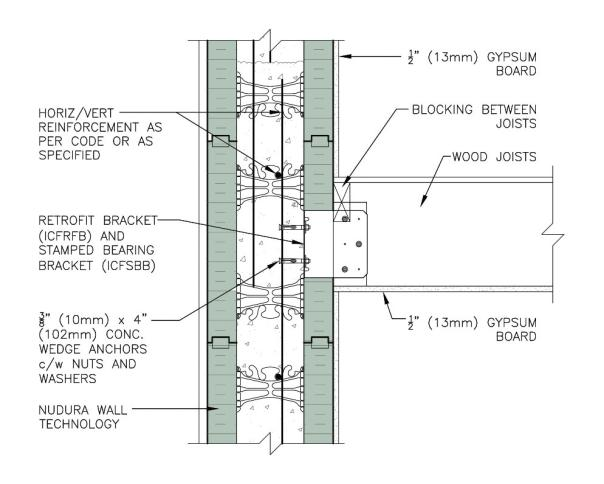
[picture p279: figure]

### הוראות התקנה

1קבע את המיקום שבו התושבת צריכה להיות מותקנת )כלומר.

גובה ומרווח(.
2 חתוך והסר כל קצף באזור ההכנסה )ראה א(.

### 3 חזק את הקטע הראשון של תוסף תושבת הקיר ישירות על

הבטון באמצעות עוגני טריז "3// x" 4( 01 מ"מ x 011 מ"מ( או "5 )011 מ"מ( )ראה ב'(.

### 4 חזק את החלק השני של תוסף תושבת הקיר לתוך הבטון

תוך כדי שאתה מוודא להשאיר מרווח נכון עבור המריש או מרכיב המסבך שיצורף )ראה ג' ו- ד'(.

### 5 סמן קו גיר שני בחלק העליון או התחתון של גובה

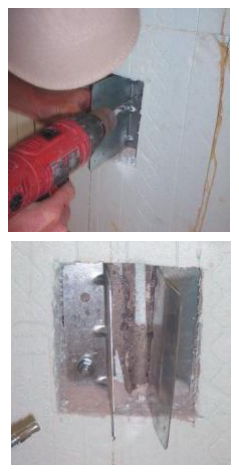
[picture p280: figure]

המריש/מסבך שיותקן. זֶה צריך להיעשות עם פלס רגיל או פלס לייזר.

### 6 התאם מרכיב המסגרת תושבת נשיאה מוטבעת בקצה

התחתון של המריש או המסבך כמוצג )ראה ה' ו- ו'(.

### 7 החלק למקום את המריש או המסבך ואת תושבת הנשיאה

המוטבעת למטה בין תוסף תושבת הקיר והקצף, הכן לעיגון בגובה הרצוי.
8 לאחר שמוקם כך שהמריש בקו אחד עם קו הגיר הסופי,

הדק היטב את תוסף תושבת הקיר ואת הנקבים של תושבת הנשיאה המוטבעת בצורה של היסט משולש, באמצעות בורג מס' 01 בעל קידוח עצמי כדי להבטיח עיגון מוצק של תושבת נשיאה מוטבעת למקומה )ראה ח'(.

### 9 התקן מחדש את הקצף שנעקר או מלא את החלל עם ספריי

קצף כדי להשלים את התקנה.
