Tanvi11Ghelani/ECO_BUILD_UI/build/EcoBuildPdf/BelowtheConstSlop/StemWall/DWGB10A05.pdf

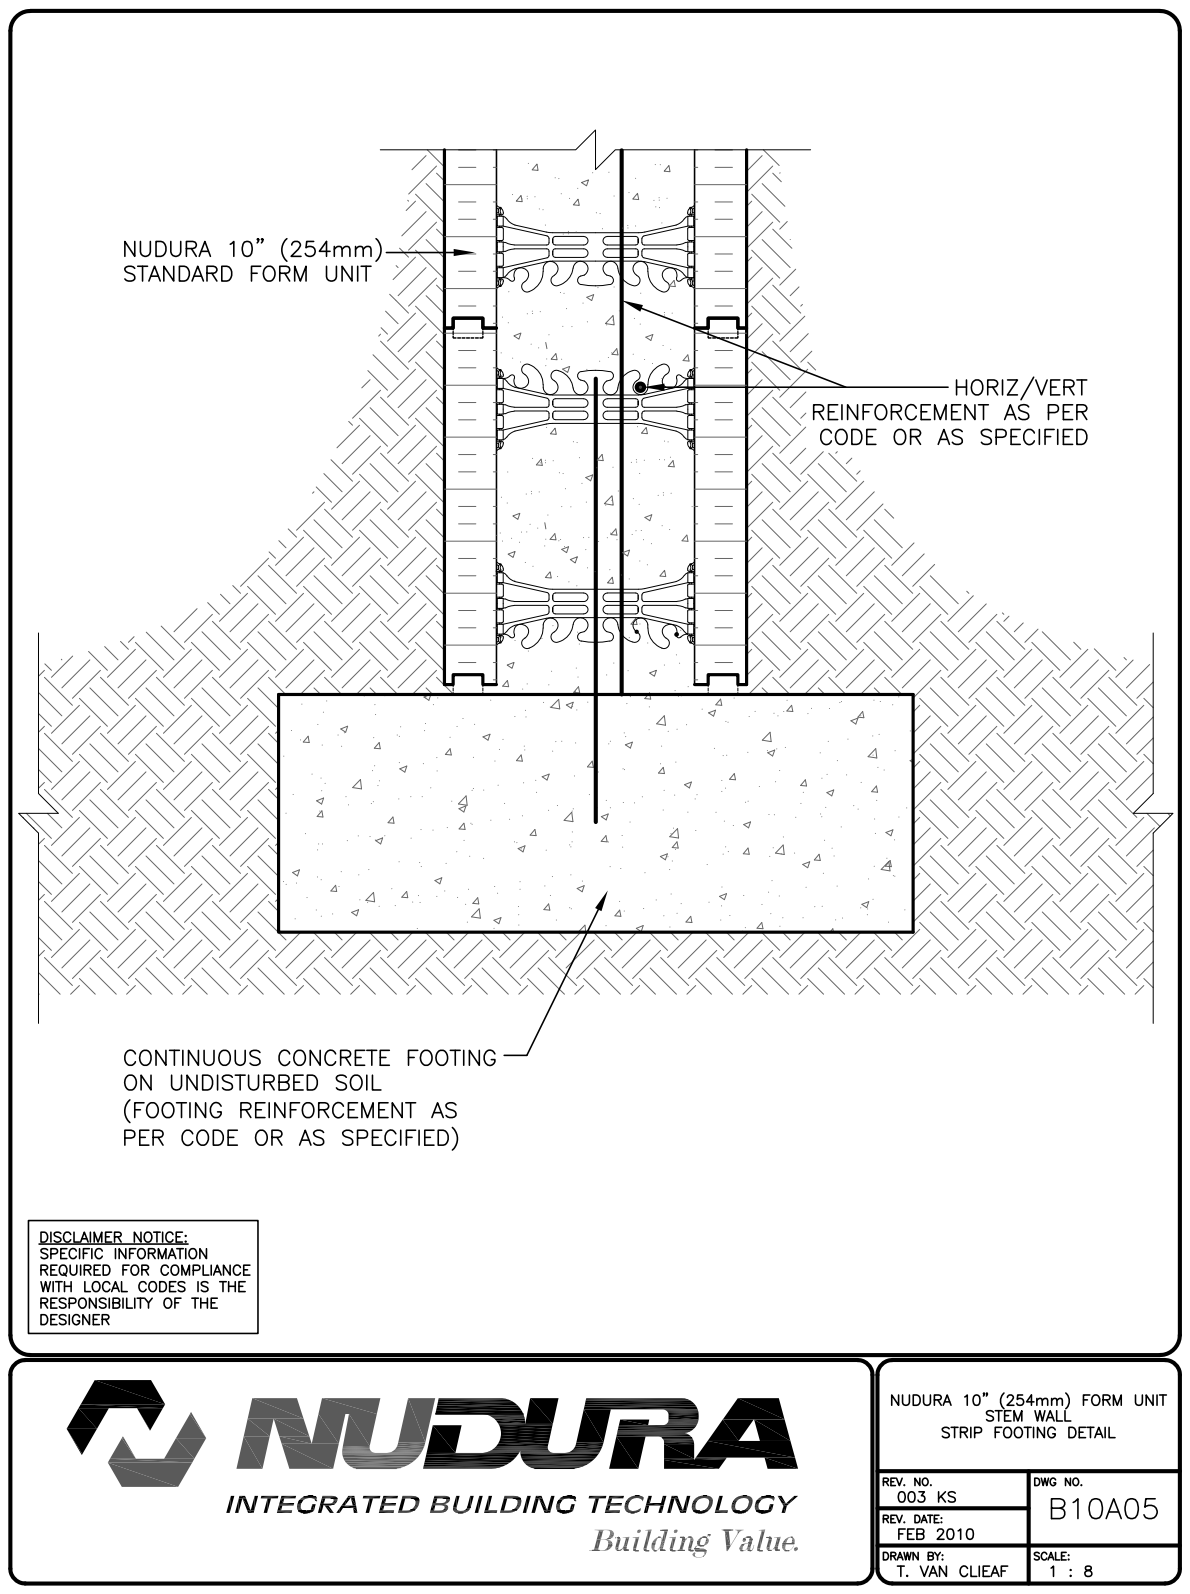
[picture p281: page 1]
