Tanvi11Ghelani/ECO_BUILD_UI/build/EcoBuildPdf/BelowtheConstSlop/StemWall/DWGB12A04.pdf

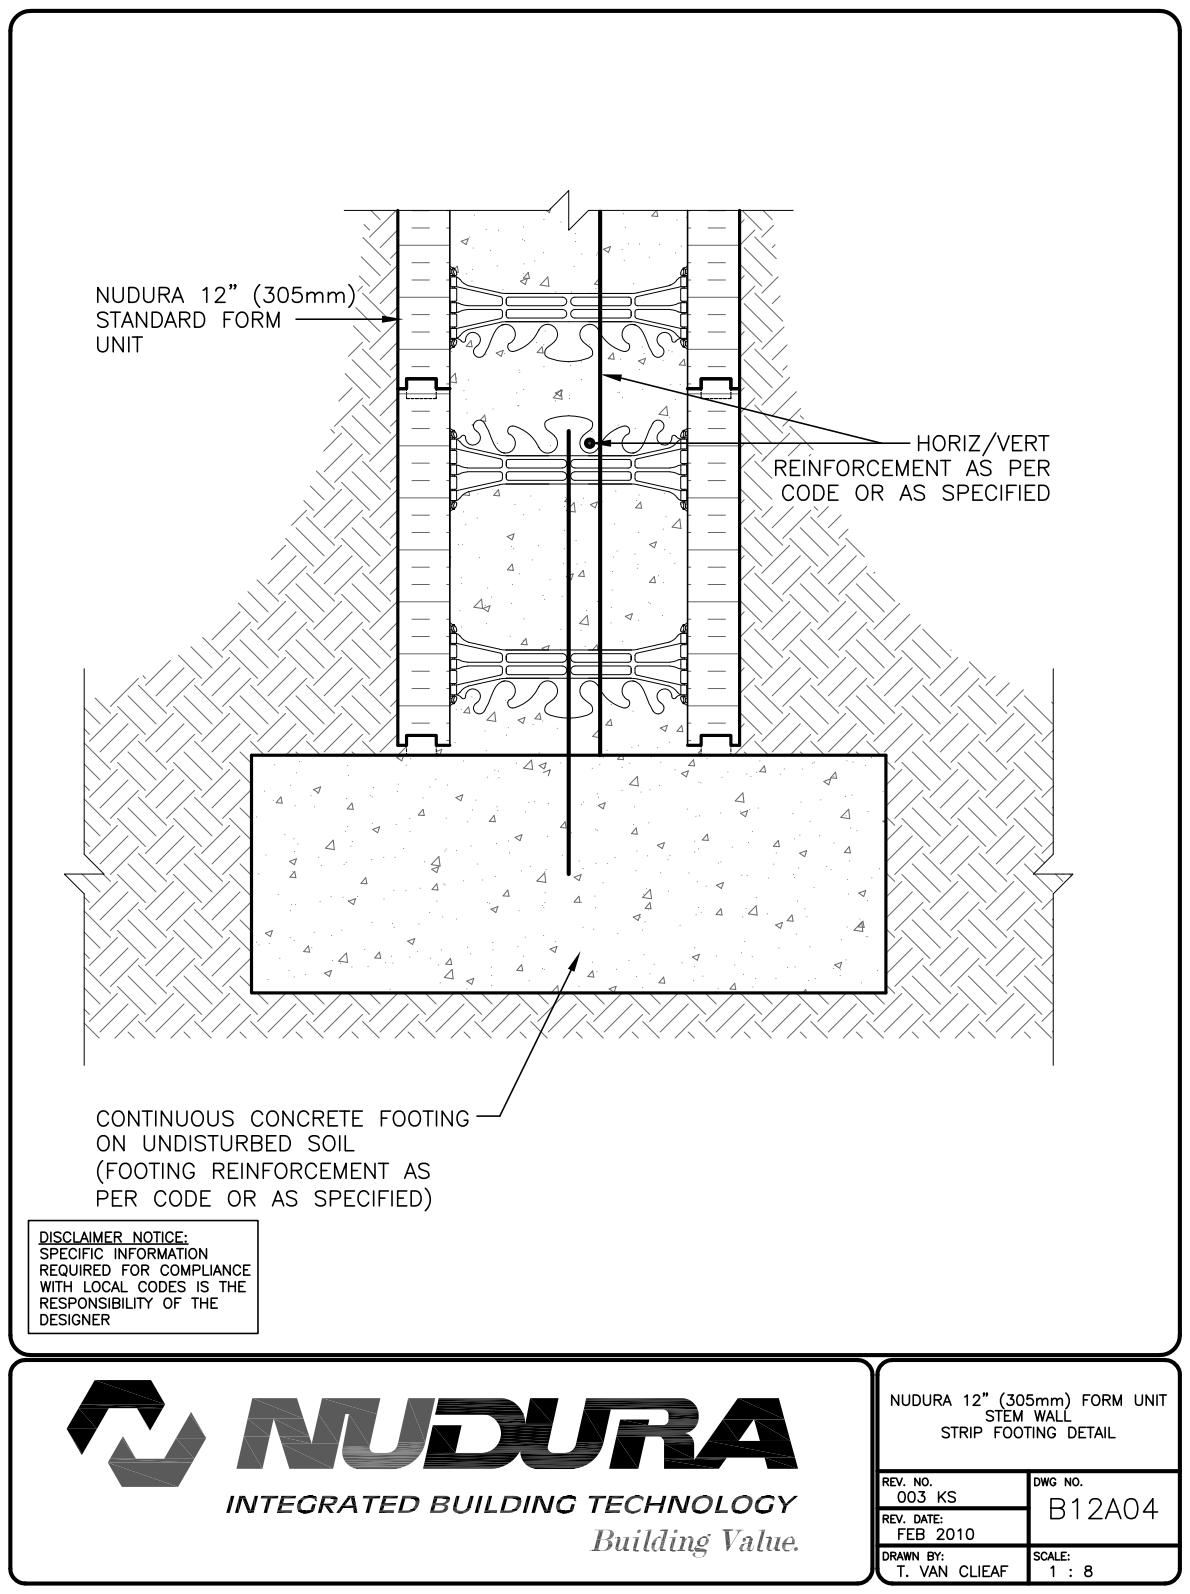
[picture p282: page 1]
