Tanvi11Ghelani/ECO_BUILD_UI/build/EcoBuildPdf/BelowtheConstSlop/StemWall/DWGB6A05.pdf

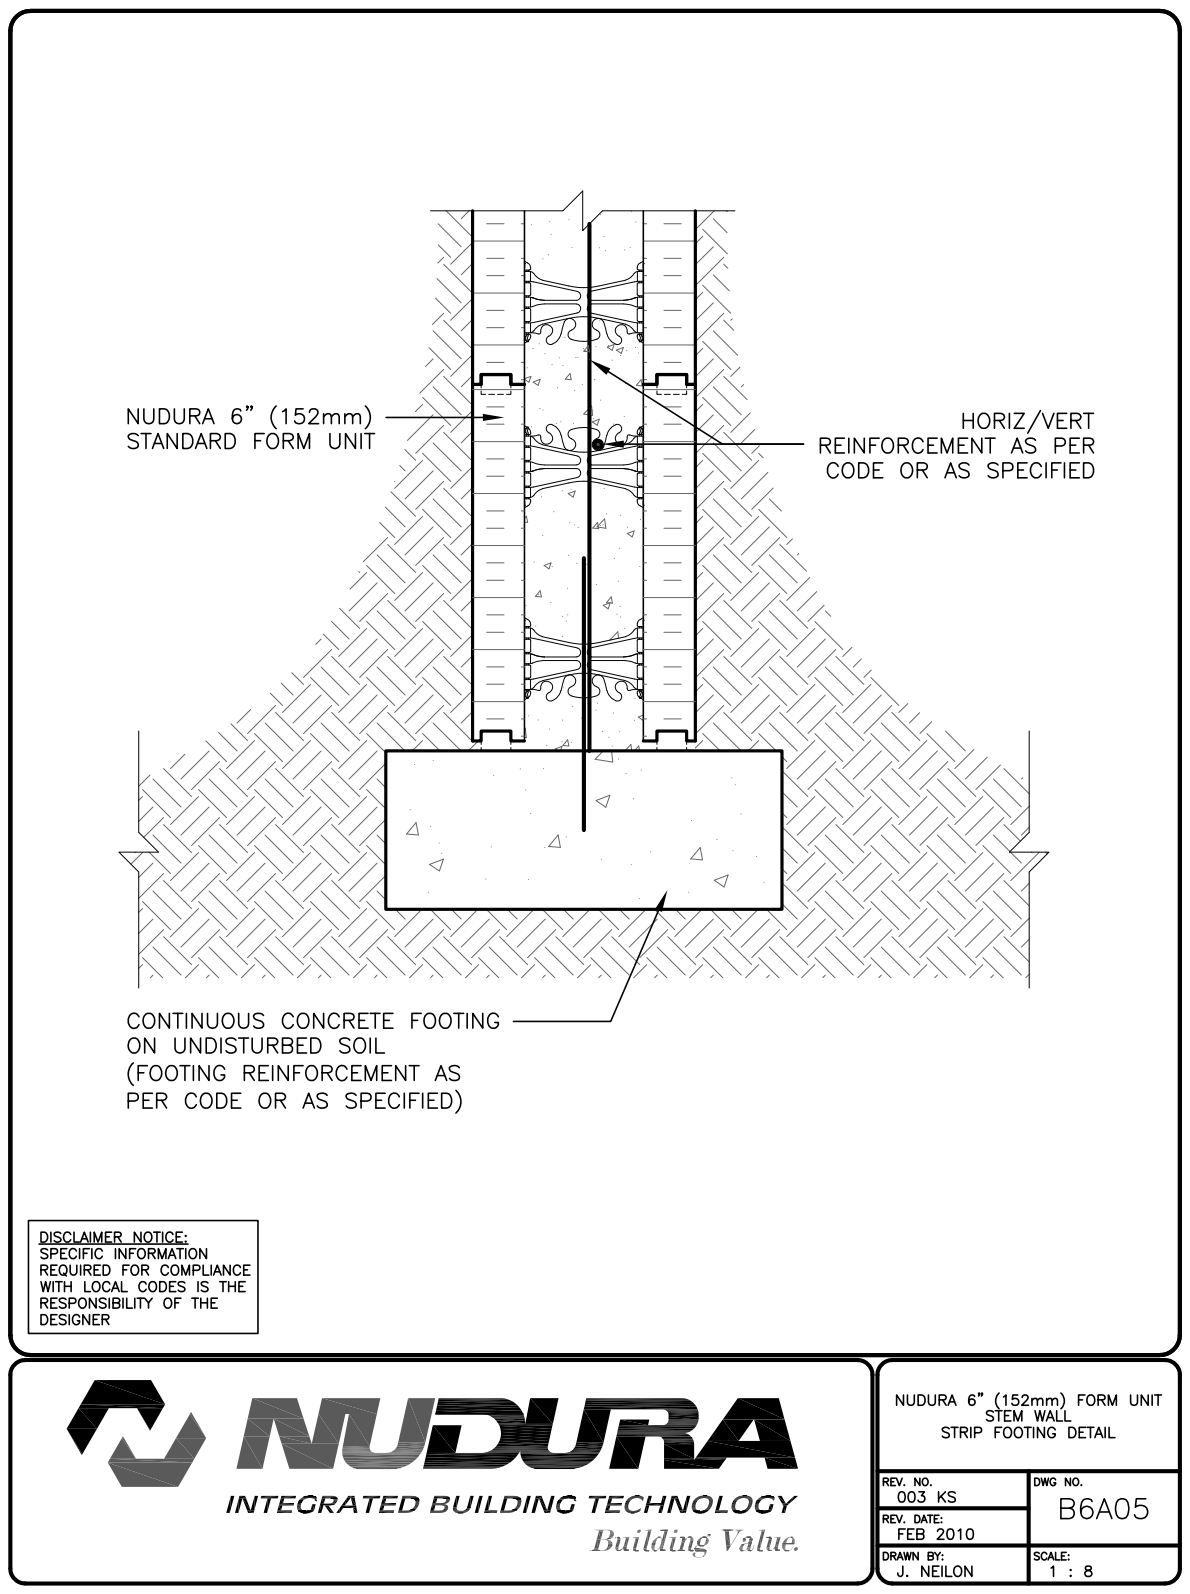
[picture p283: page 1]
