Tanvi11Ghelani/ECO_BUILD_UI/build/EcoBuildPdf/BelowtheConstSlop/StemWall/DWGB8A06.pdf

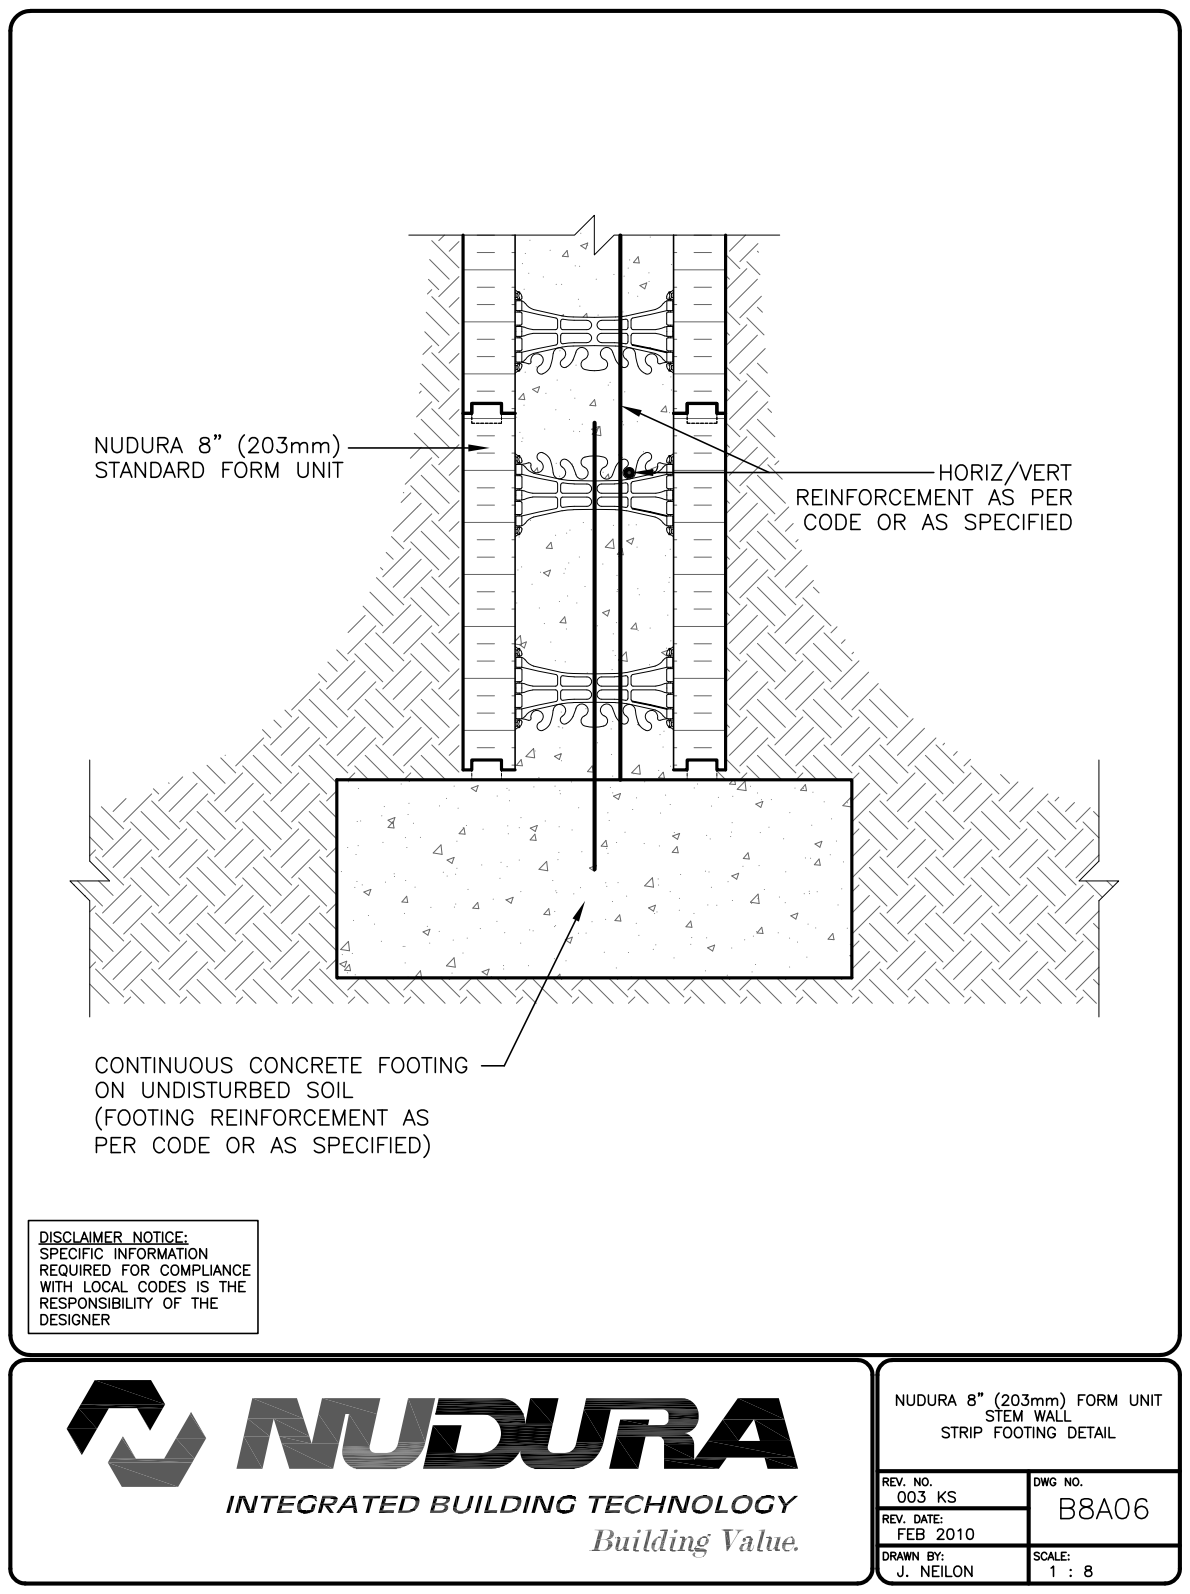
[picture p284: page 1]
