Tanvi11Ghelani/ECO_BUILD_UI/build/EcoBuildPdf/BelowtheConstSlop/StemWall4/DWGB10C03.pdf

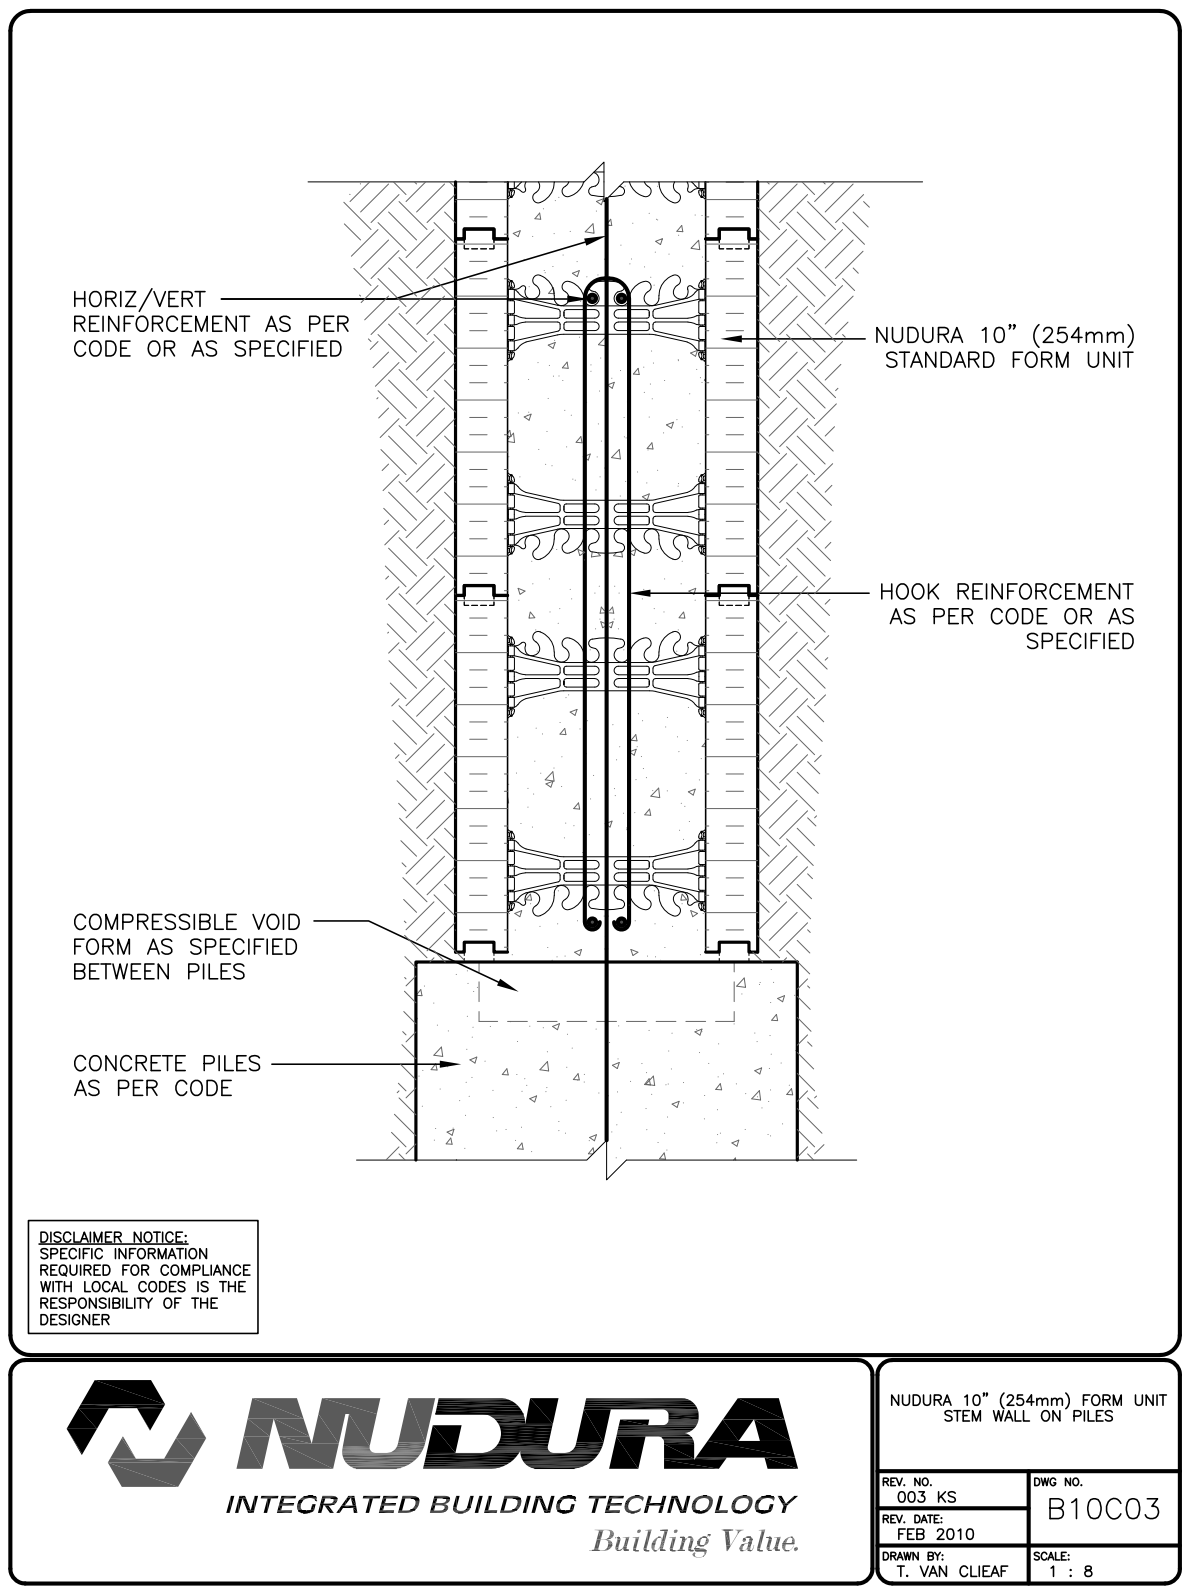
[picture p285: page 1]
