Tanvi11Ghelani/ECO_BUILD_UI/build/EcoBuildPdf/BelowtheConstSlop/StemWall4/DWGB12C02.pdf

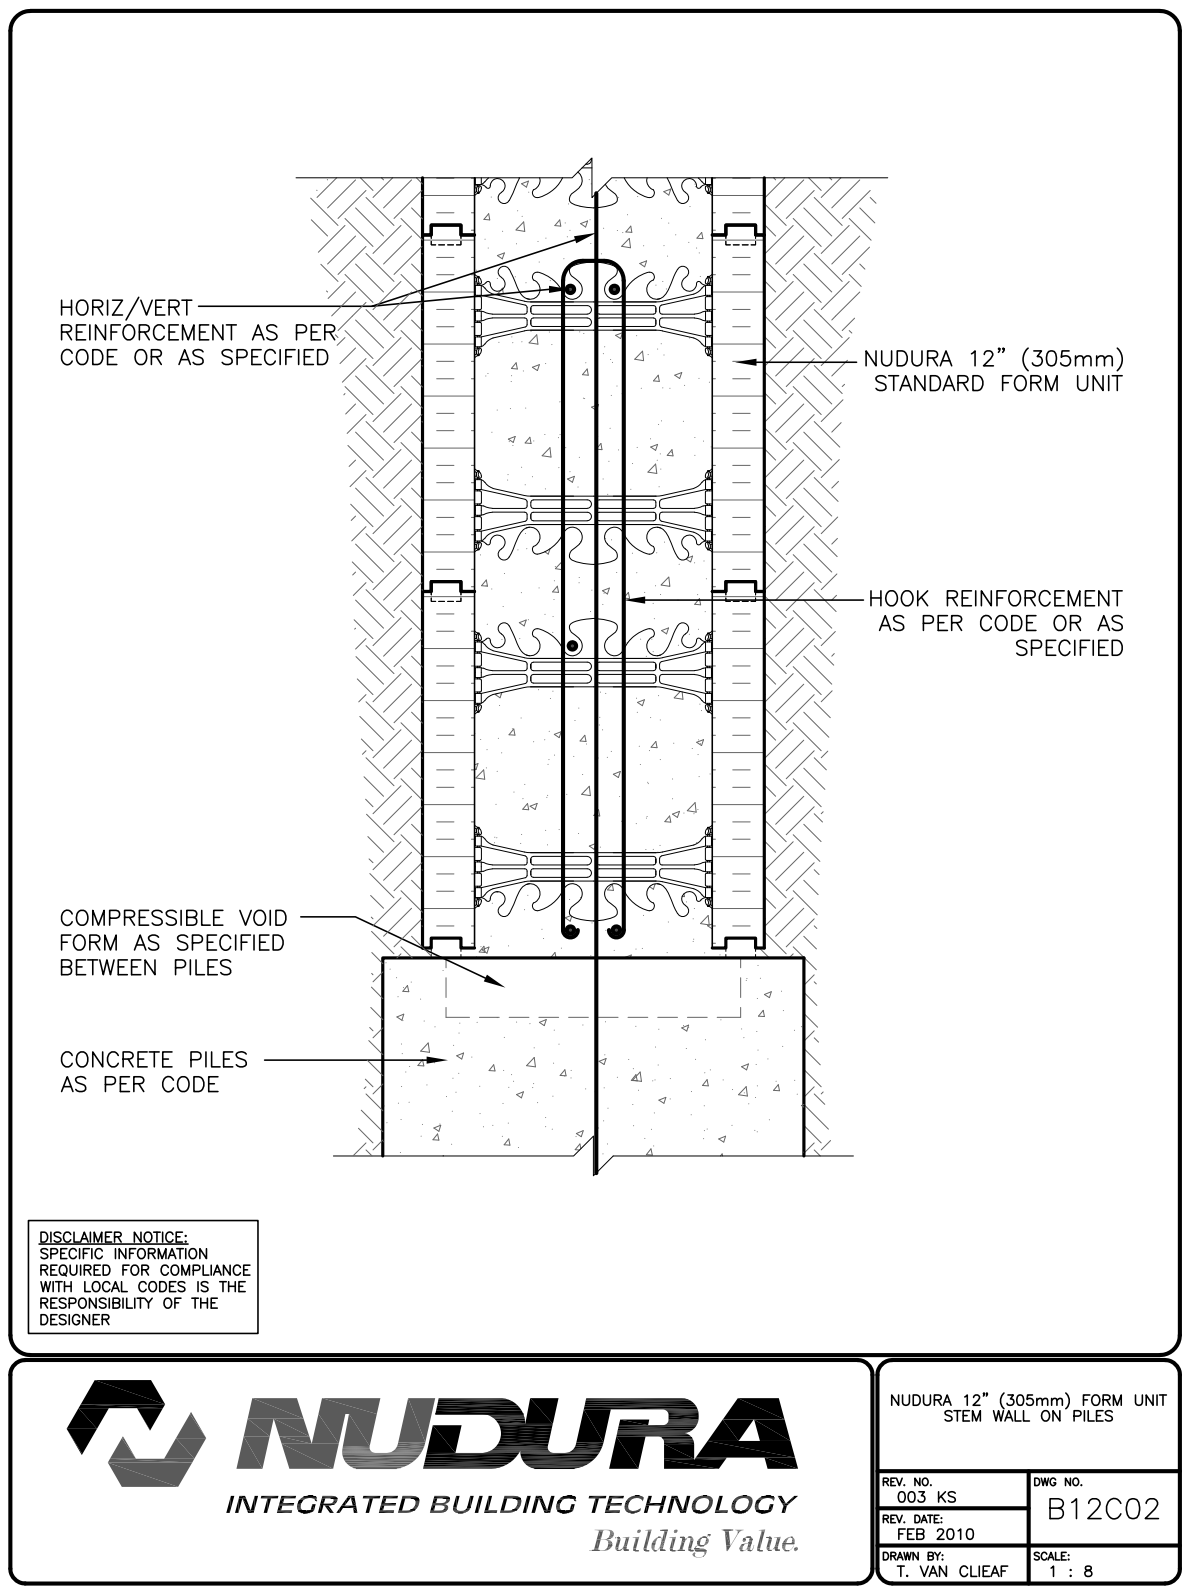
[picture p286: page 1]
