Tanvi11Ghelani/ECO_BUILD_UI/build/EcoBuildPdf/BelowtheConstSlop/StemWall4/DWGB6C06.pdf

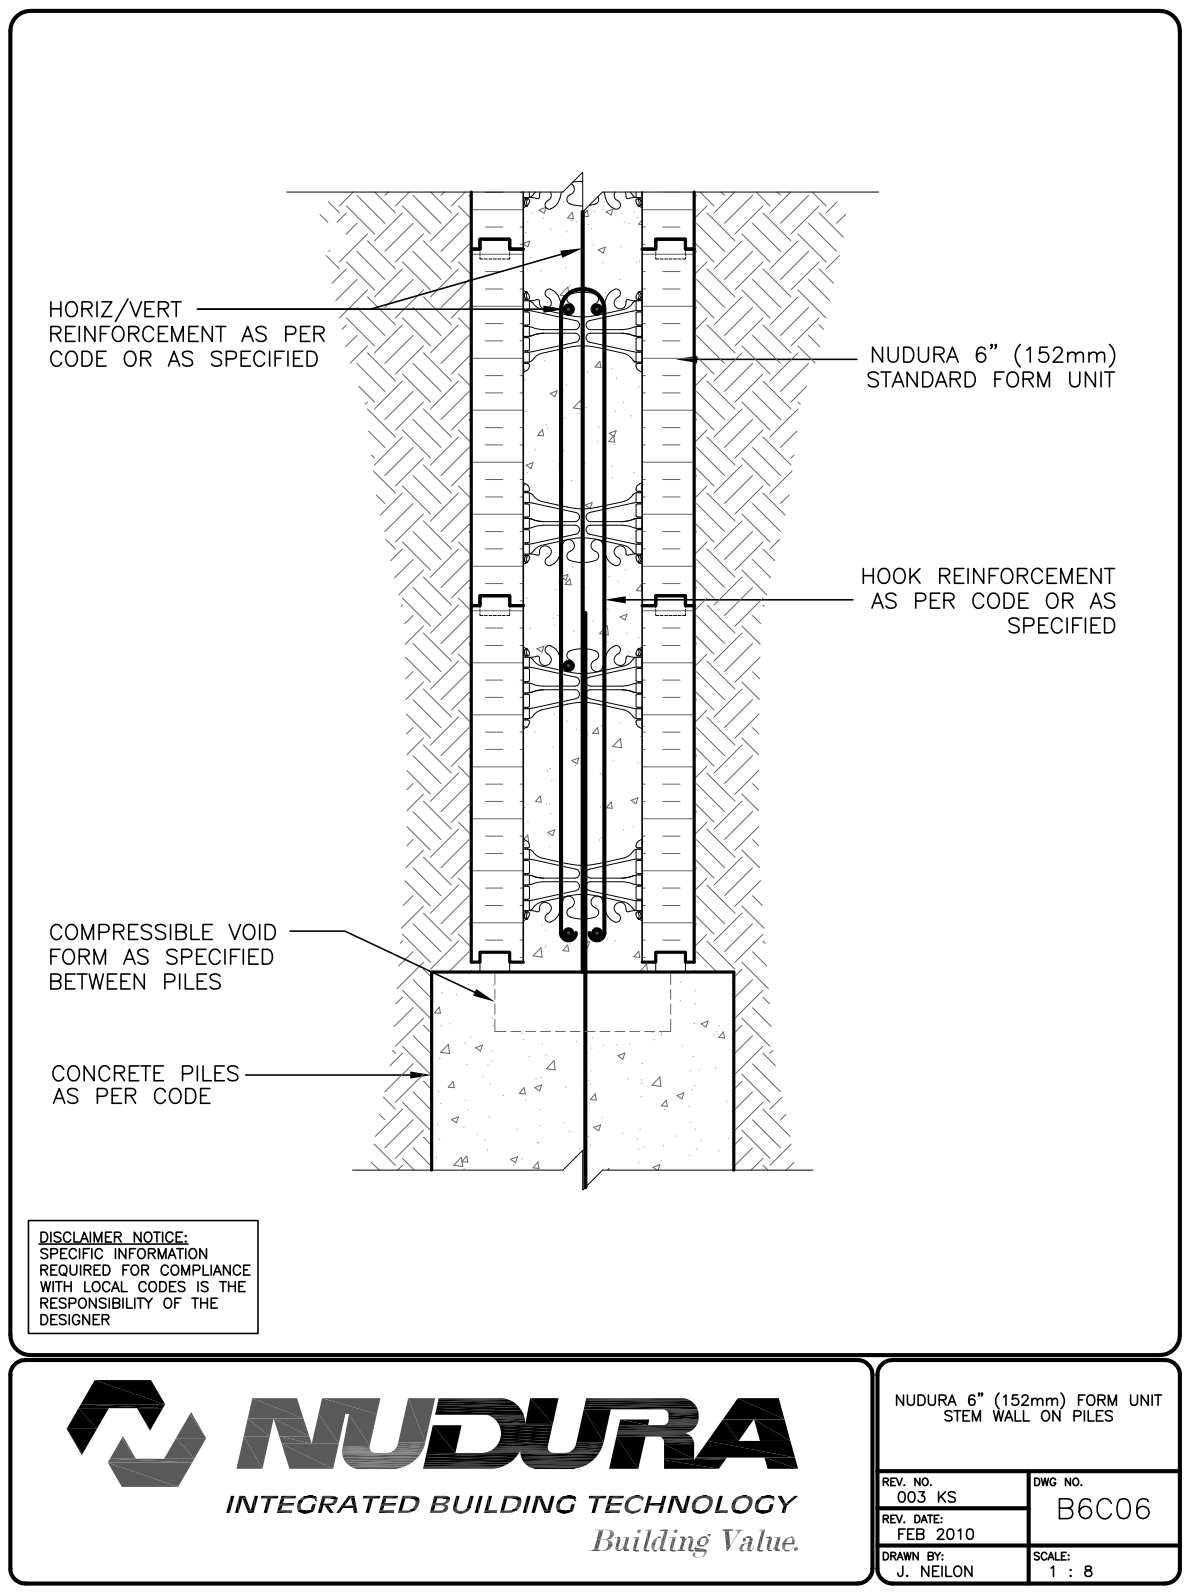
[picture p287: page 1]
