Tanvi11Ghelani/ECO_BUILD_UI/build/EcoBuildPdf/BelowtheConstSlop/StemWall4/DWGB8C07.pdf

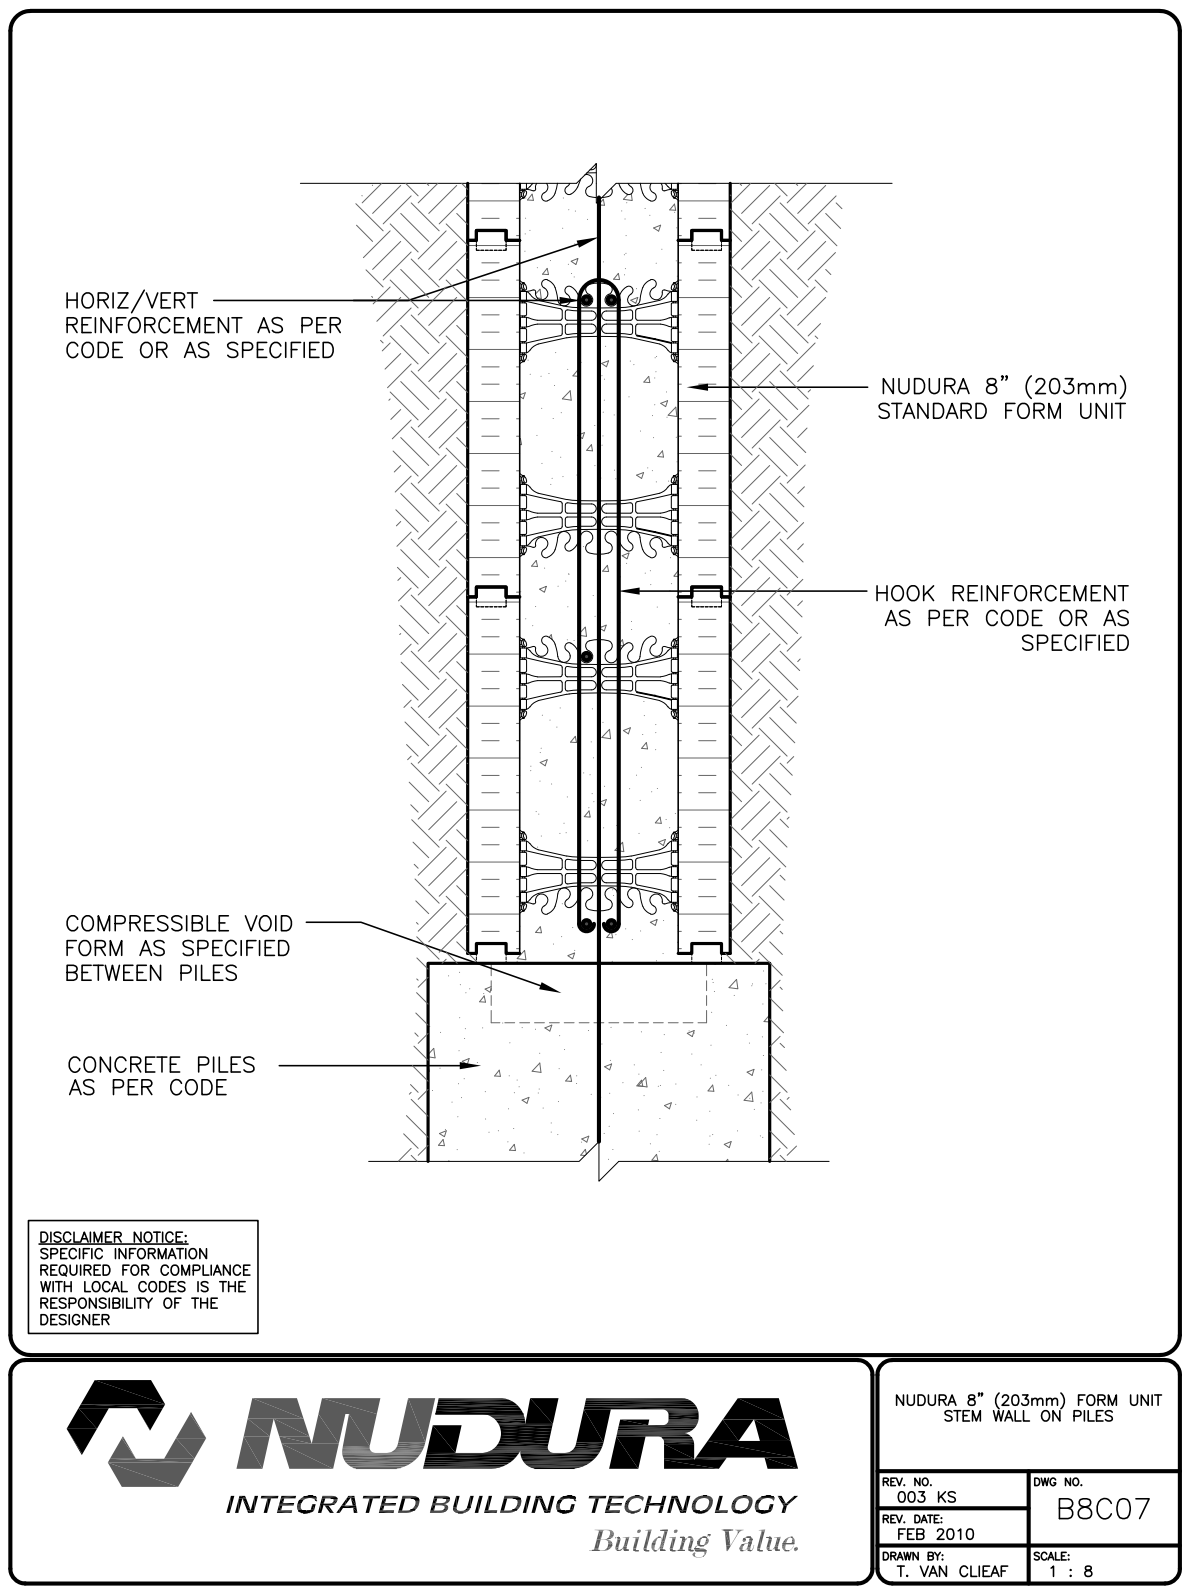
[picture p288: page 1]
