Tanvi11Ghelani/ECO_BUILD_UI/build/EcoBuildPdf/Firewall/152mm-6CONCRETECOREFORM152/FirewallSTC at Ceiling FW6D3.pdf

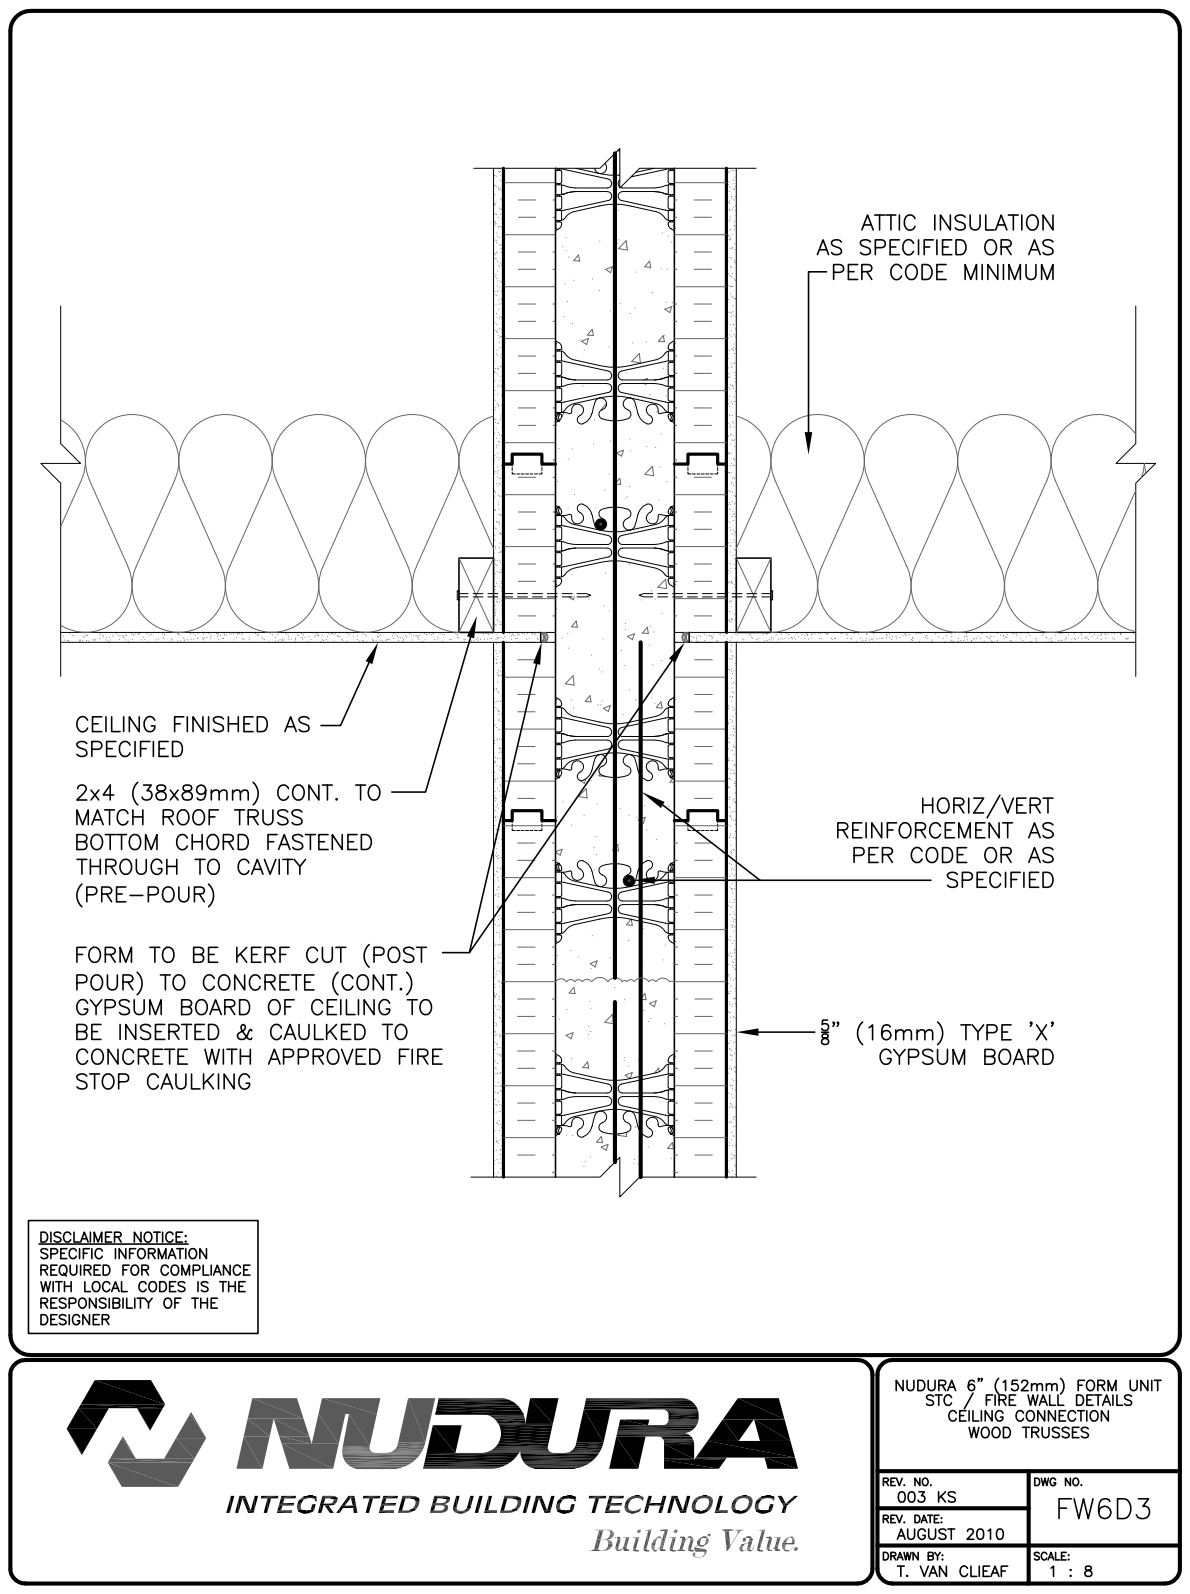
[picture p289: page 1]
