Tanvi11Ghelani/ECO_BUILD_UI/build/EcoBuildPdf/Firewall/152mm-6CONCRETECOREFORM152/FirewallSTC at Roof (Canada) FW6D4.pdf

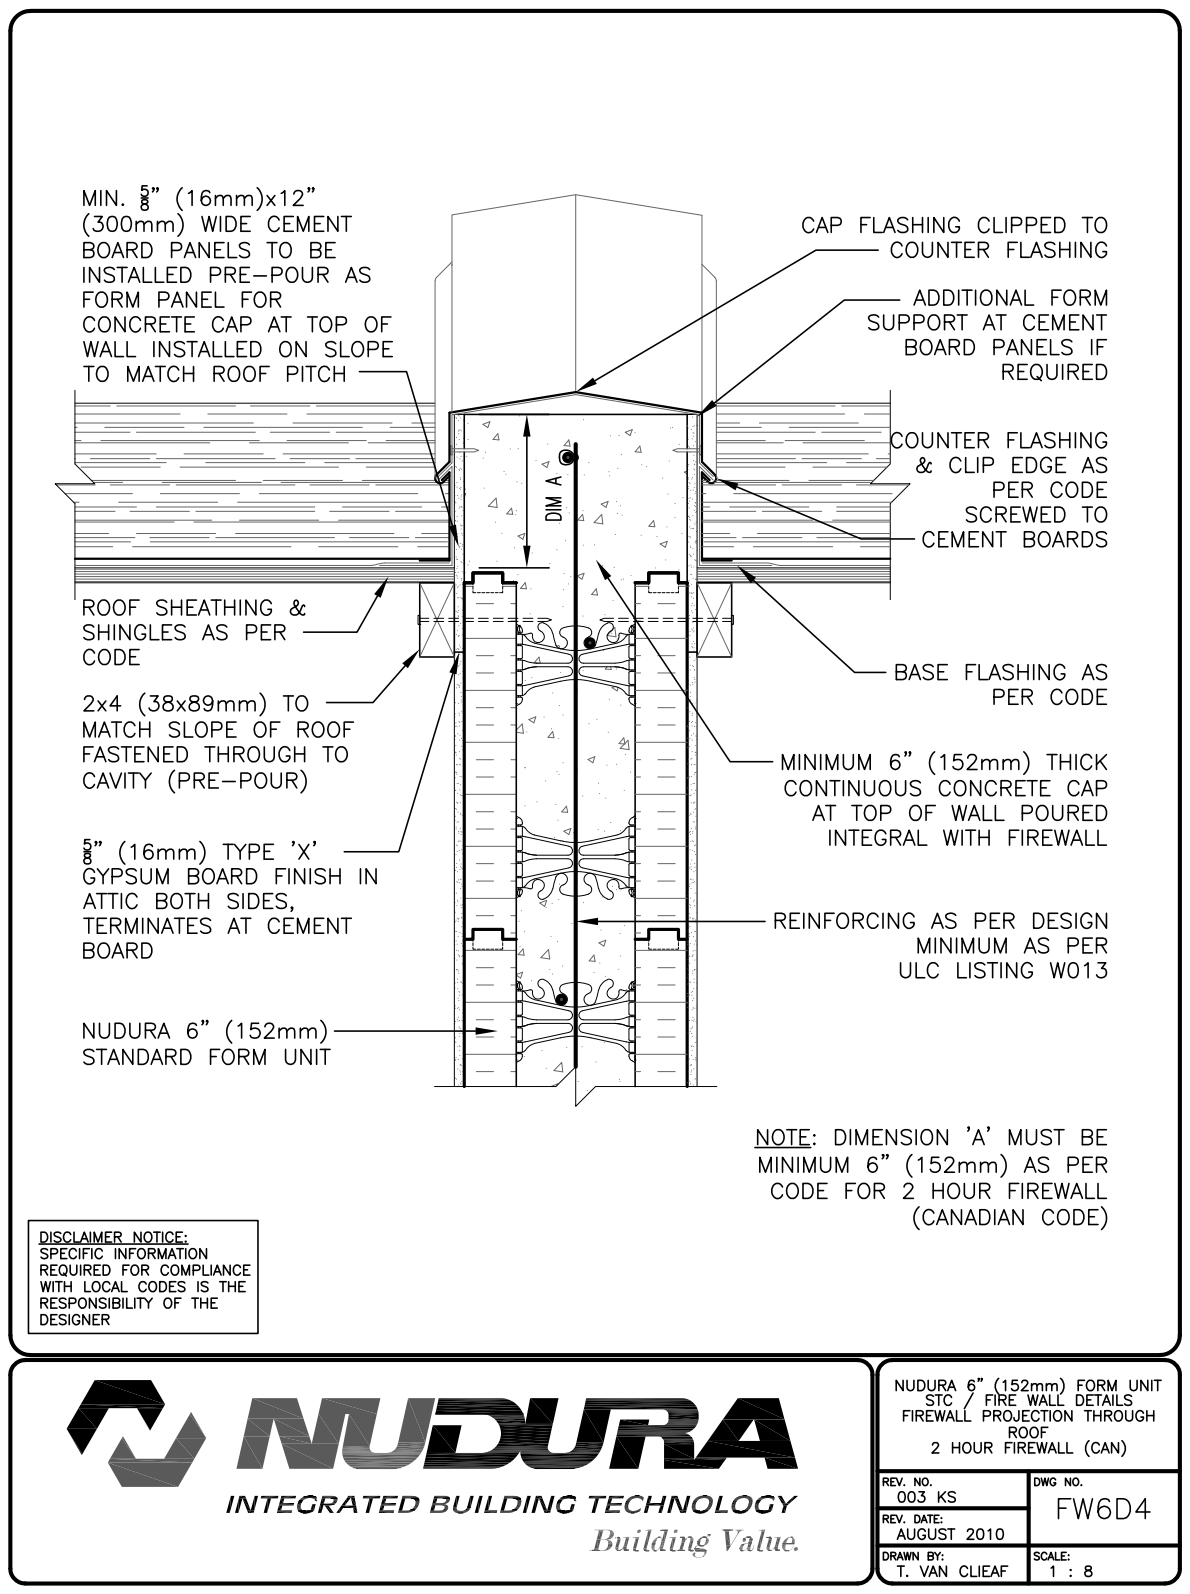
[picture p290: page 1]
