Tanvi11Ghelani/ECO_BUILD_UI/build/EcoBuildPdf/Firewall/152mm-6CONCRETECOREFORM152/FirewallSTC at Roof (USA) FW6D5.pdf

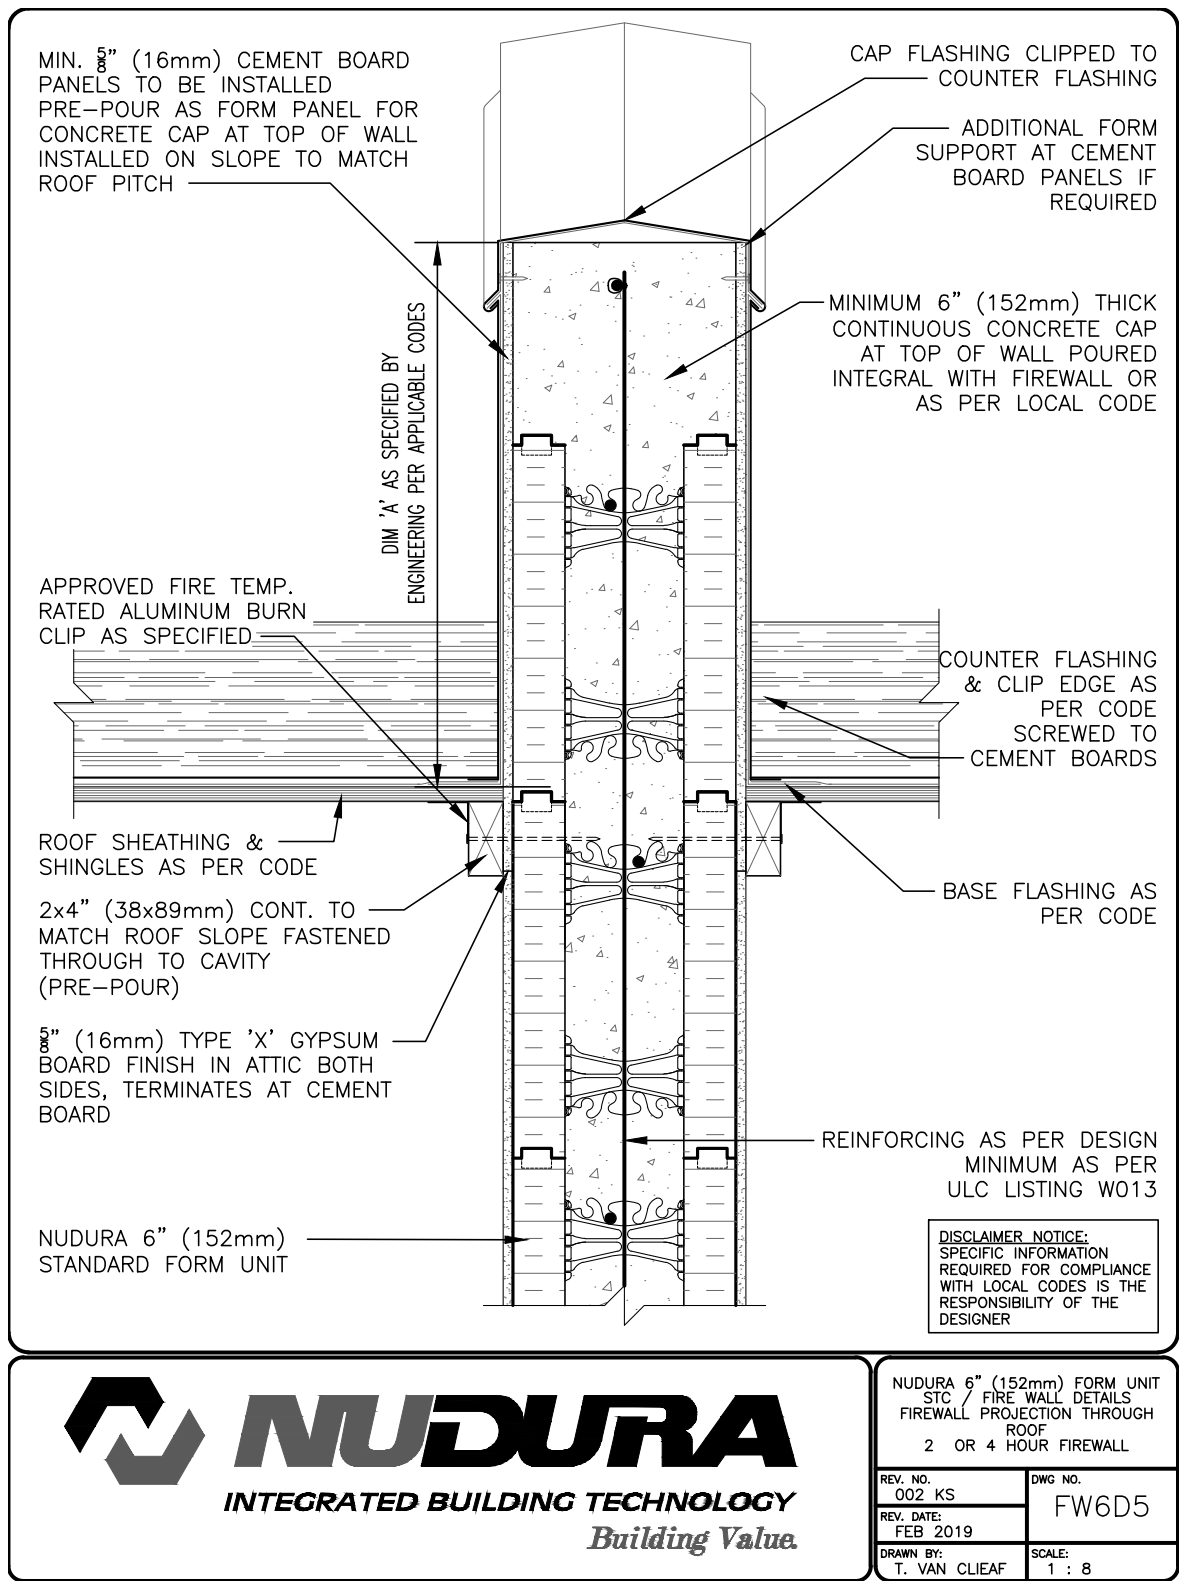
[picture p291: page 1]
