Tanvi11Ghelani/ECO_BUILD_UI/build/EcoBuildPdf/Firewall/152mm-6CONCRETECOREFORM152/FirewallSTC Intermediate Floor (a) FW6D2A.pdf

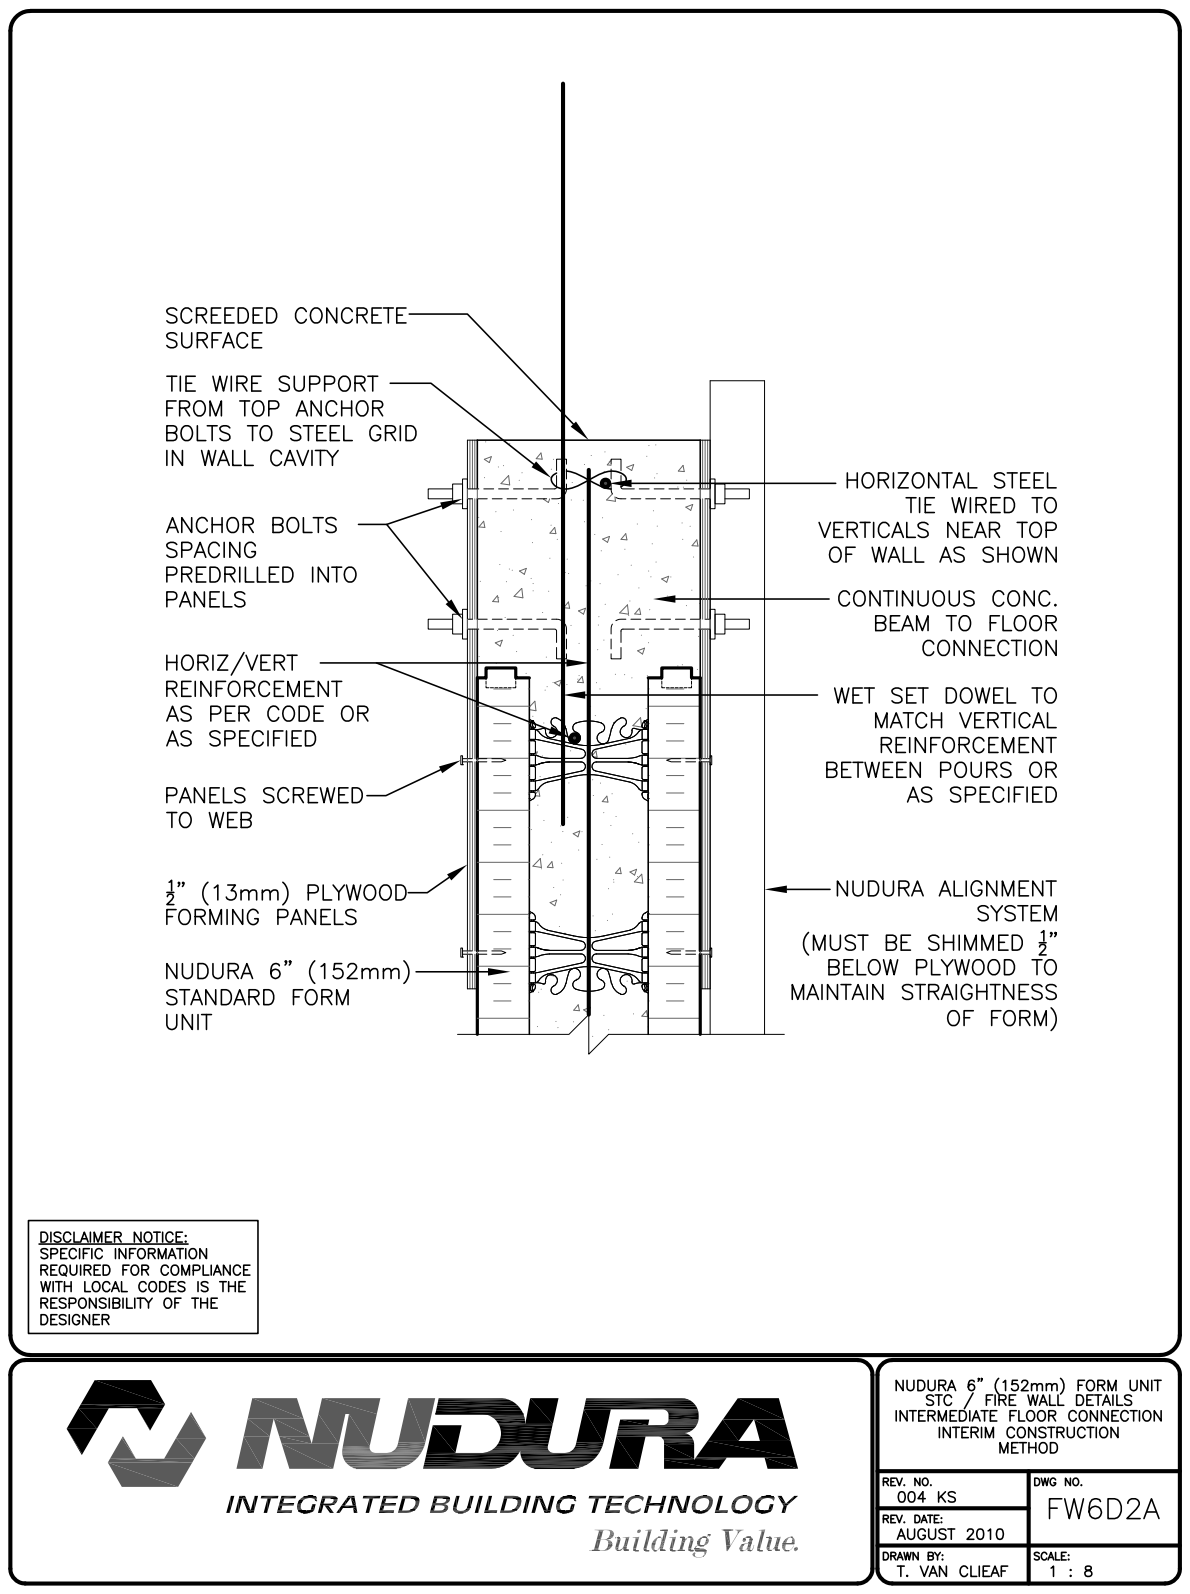
[picture p292: page 1]
