Tanvi11Ghelani/ECO_BUILD_UI/build/EcoBuildPdf/Firewall/152mm-6CONCRETECOREFORM152/FirewallSTC Intermediate Floor (b) FW6D2B.pdf

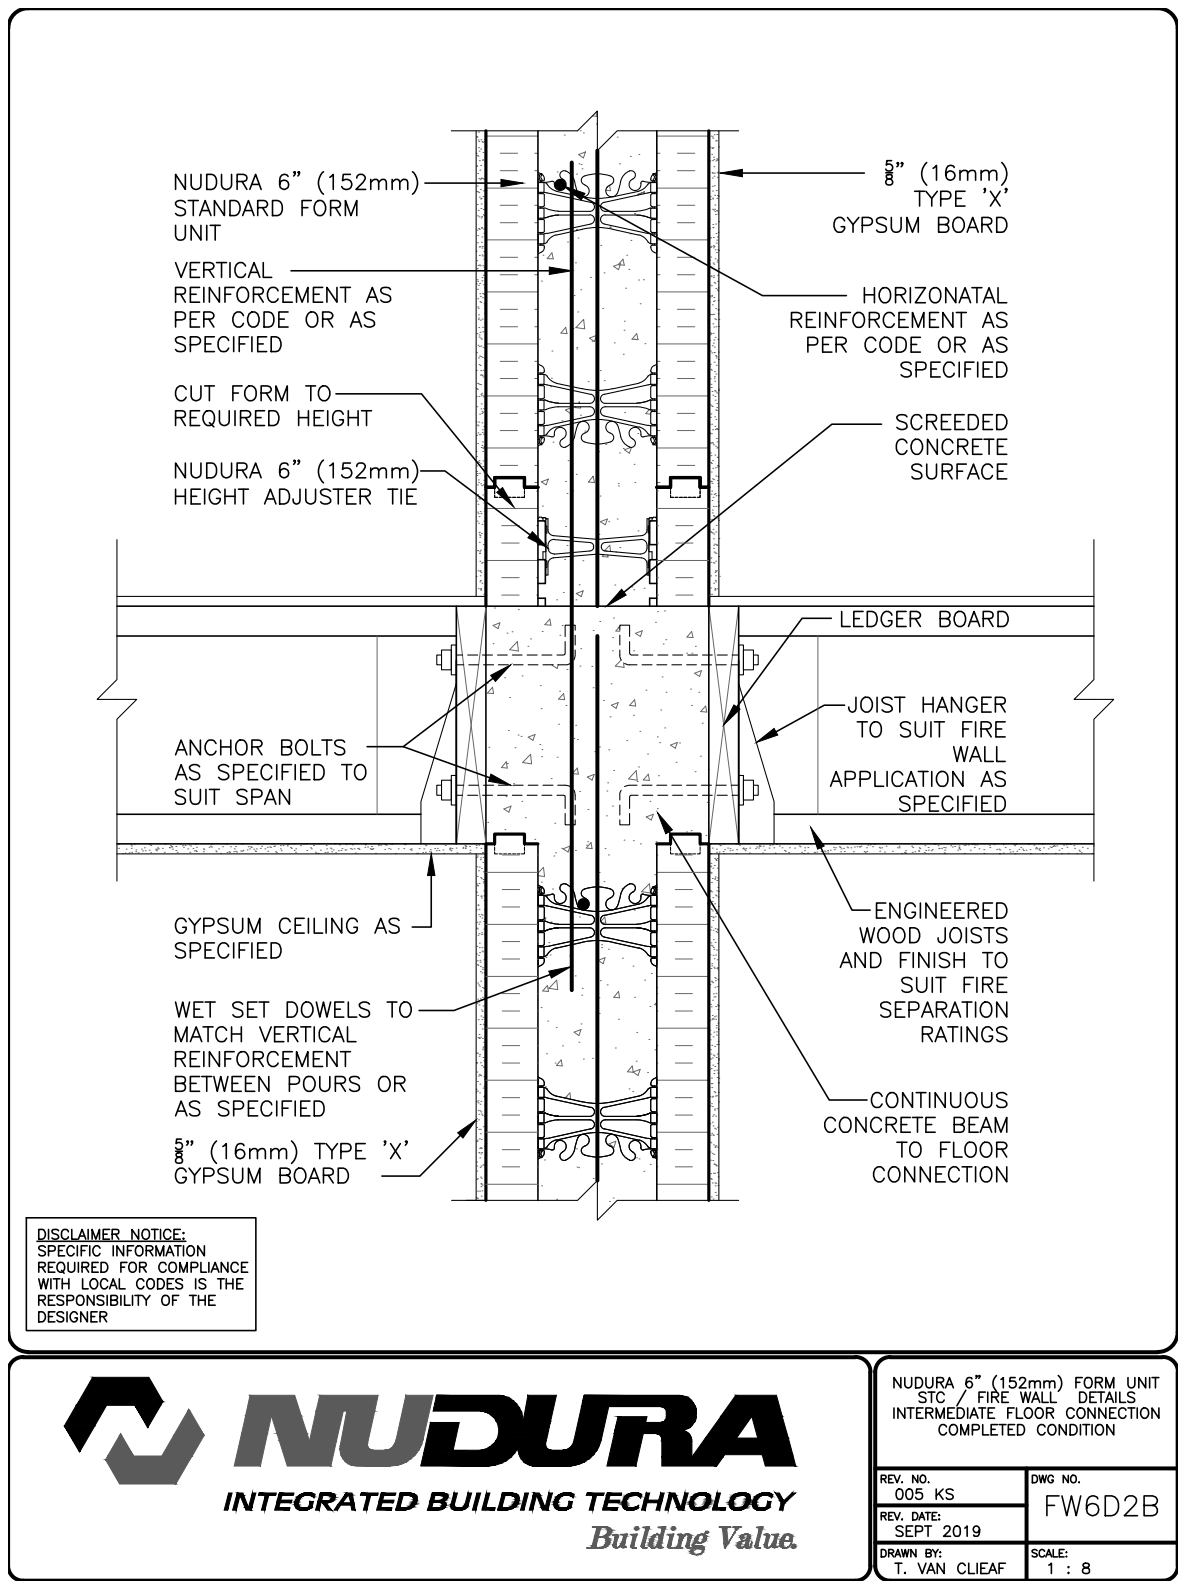
[picture p293: page 1]
