Tanvi11Ghelani/ECO_BUILD_UI/build/EcoBuildPdf/FormUnitProfiles/152mm- 6 Concrete Core Forms/45 Degree Corner Form Unit A6A03.pdf

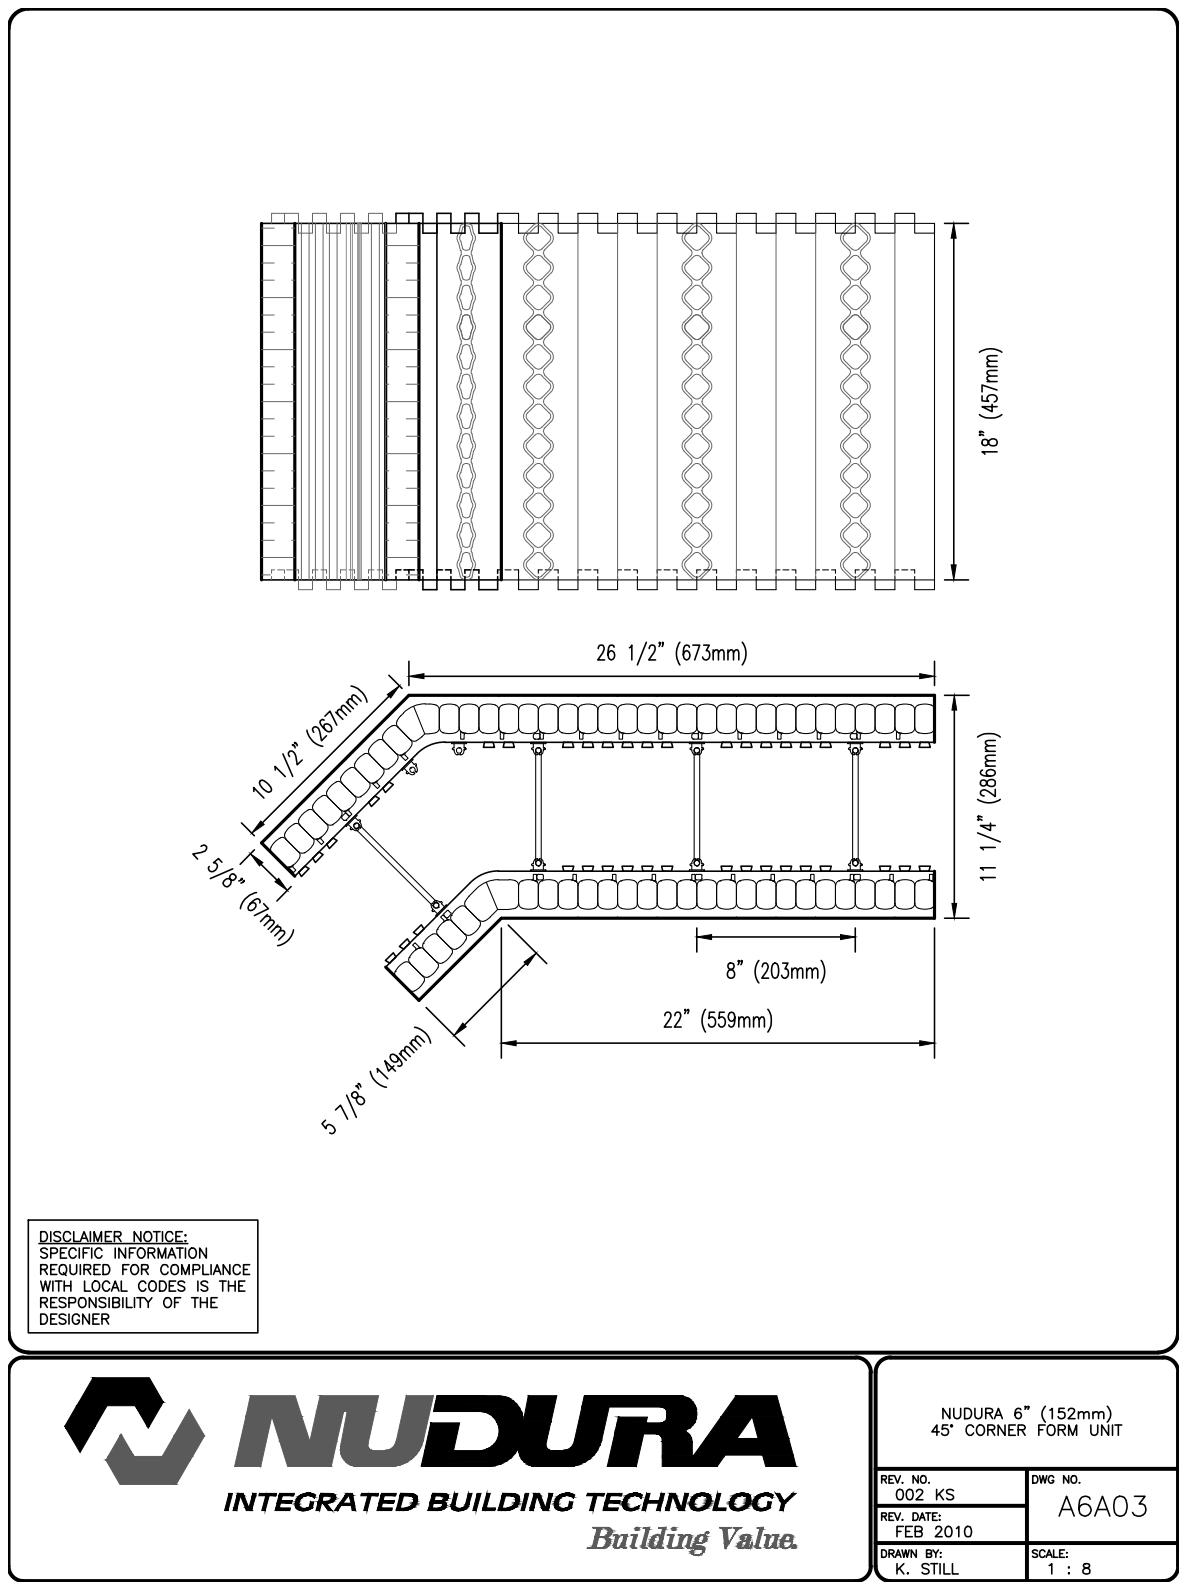
[picture p296: page 1]
