Tanvi11Ghelani/ECO_BUILD_UI/build/EcoBuildPdf/FormUnitProfiles/152mm- 6 Concrete Core Forms/90 Degree Corner Form Unit A6A02.pdf

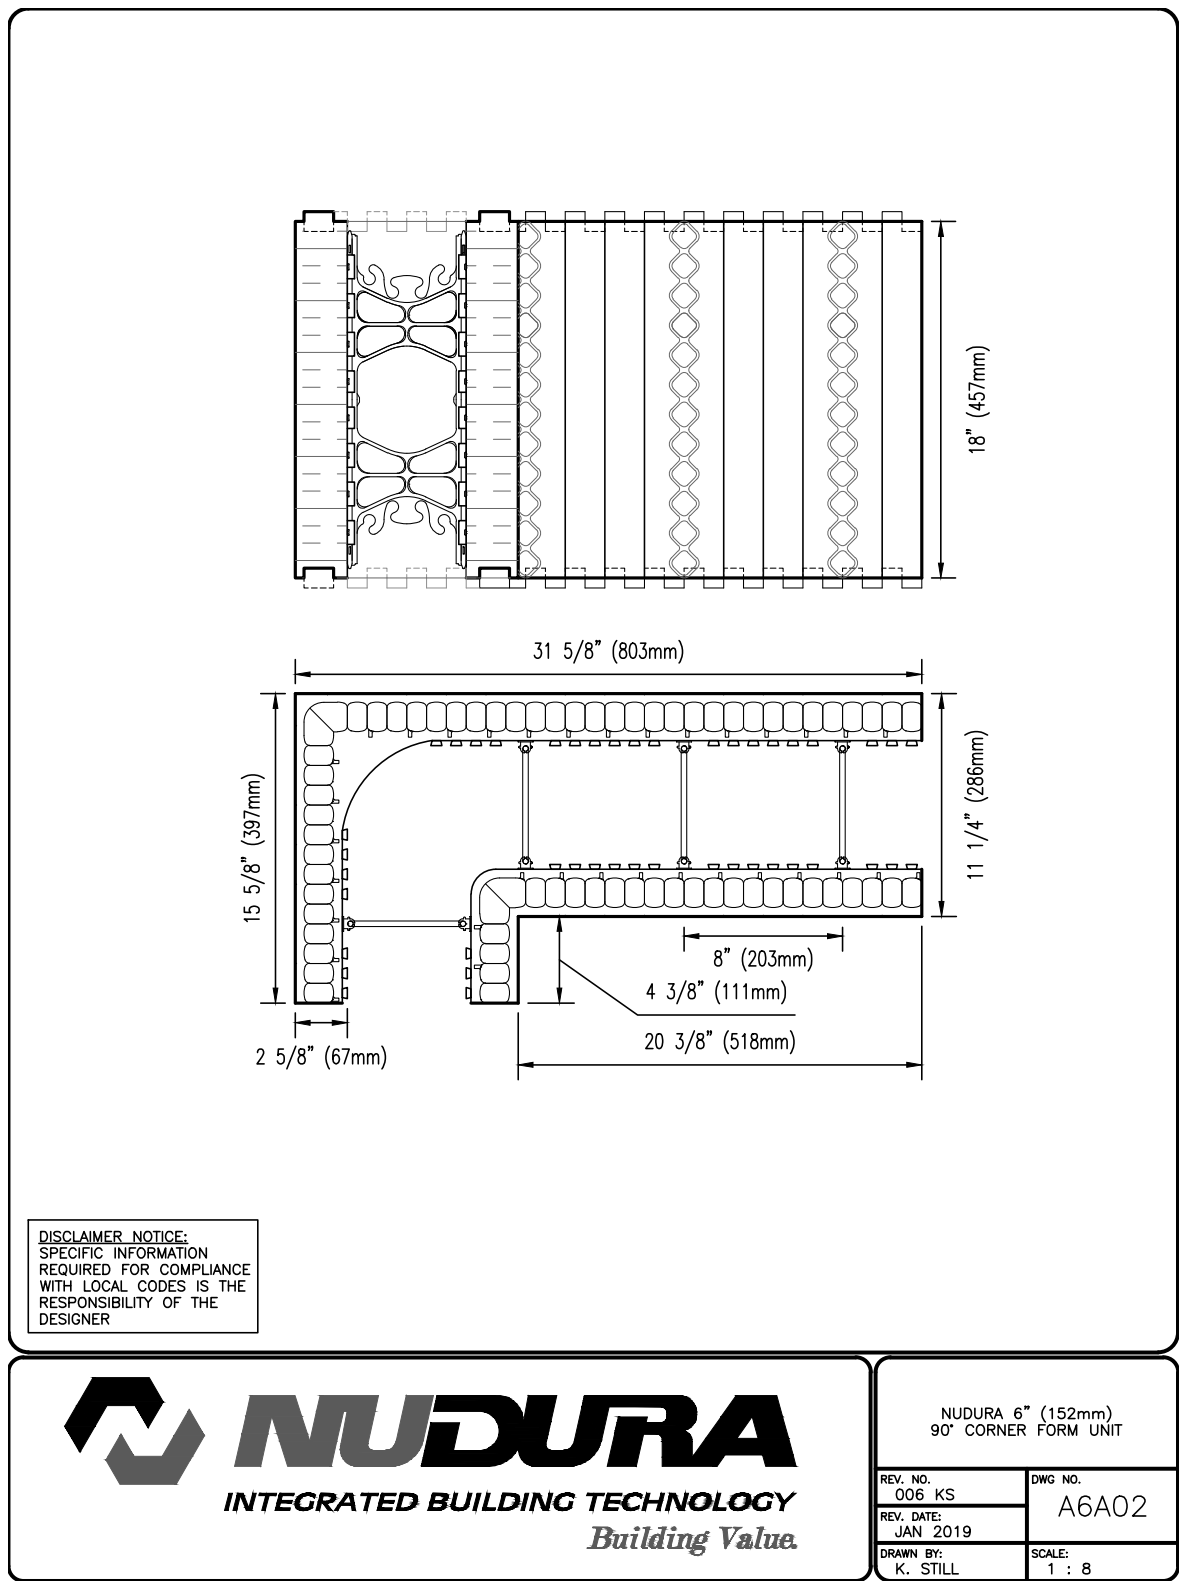
[picture p297: page 1]
