Tanvi11Ghelani/ECO_BUILD_UI/build/EcoBuildPdf/FormUnitProfiles/152mm- 6 Concrete Core Forms/Brick Ledge Form Unit A6A06.pdf

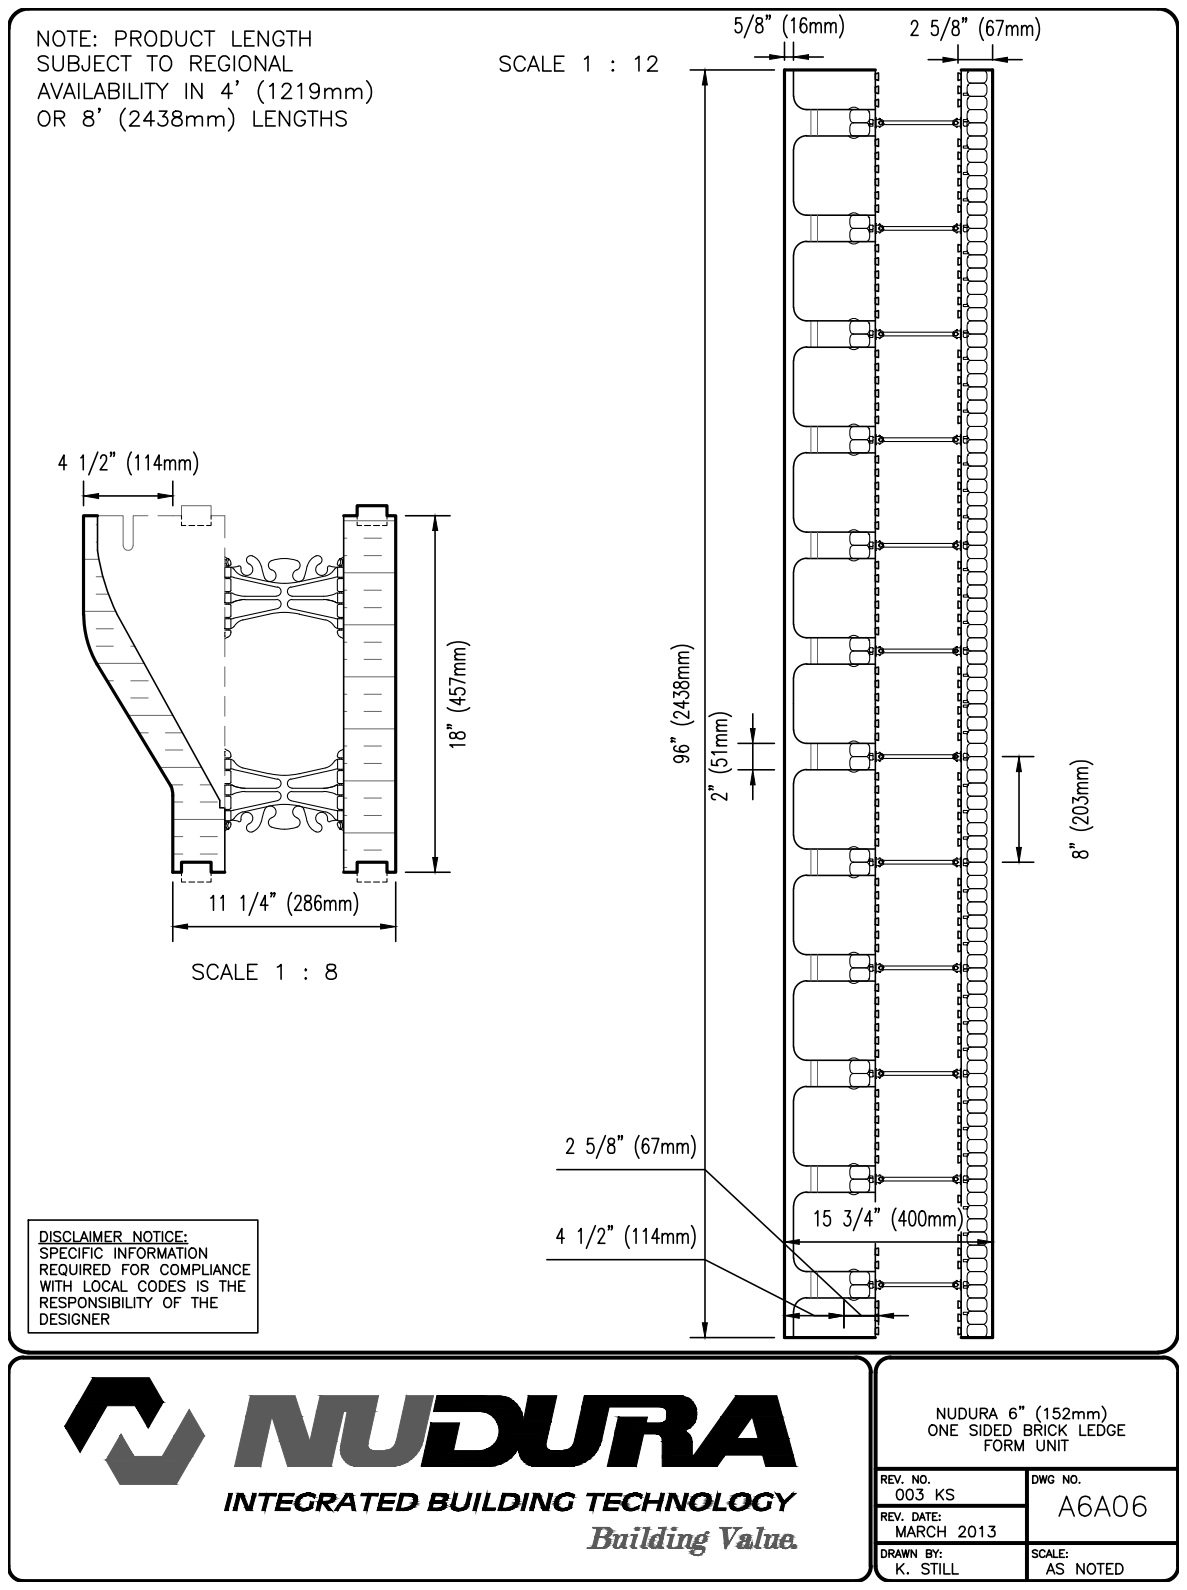
[picture p298: page 1]
