Tanvi11Ghelani/ECO_BUILD_UI/build/EcoBuildPdf/FormUnitProfiles/152mm- 6 Concrete Core Forms/Double Sided Taper Top Form Unit A6A05.pdf

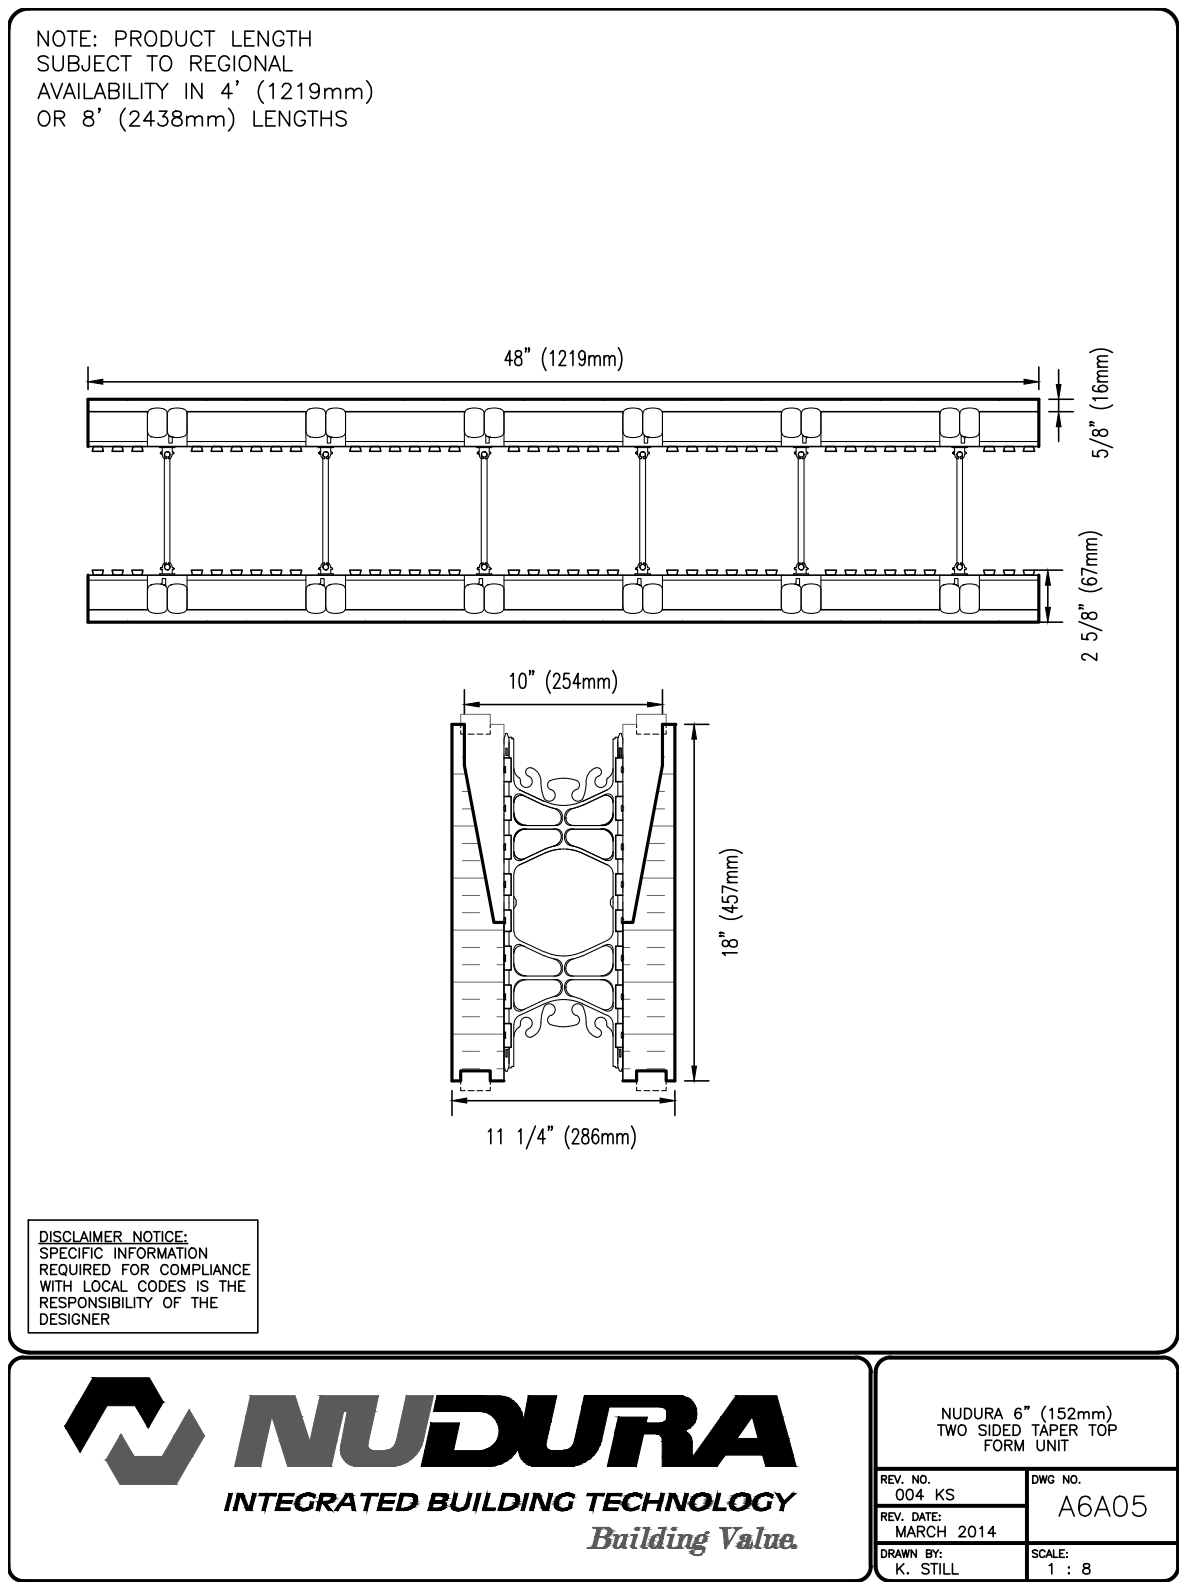
[picture p299: page 1]
