Tanvi11Ghelani/ECO_BUILD_UI/build/EcoBuildPdf/FormUnitProfiles/152mm- 6 Concrete Core Forms/End Cap and Height Adjuster A6A08.pdf

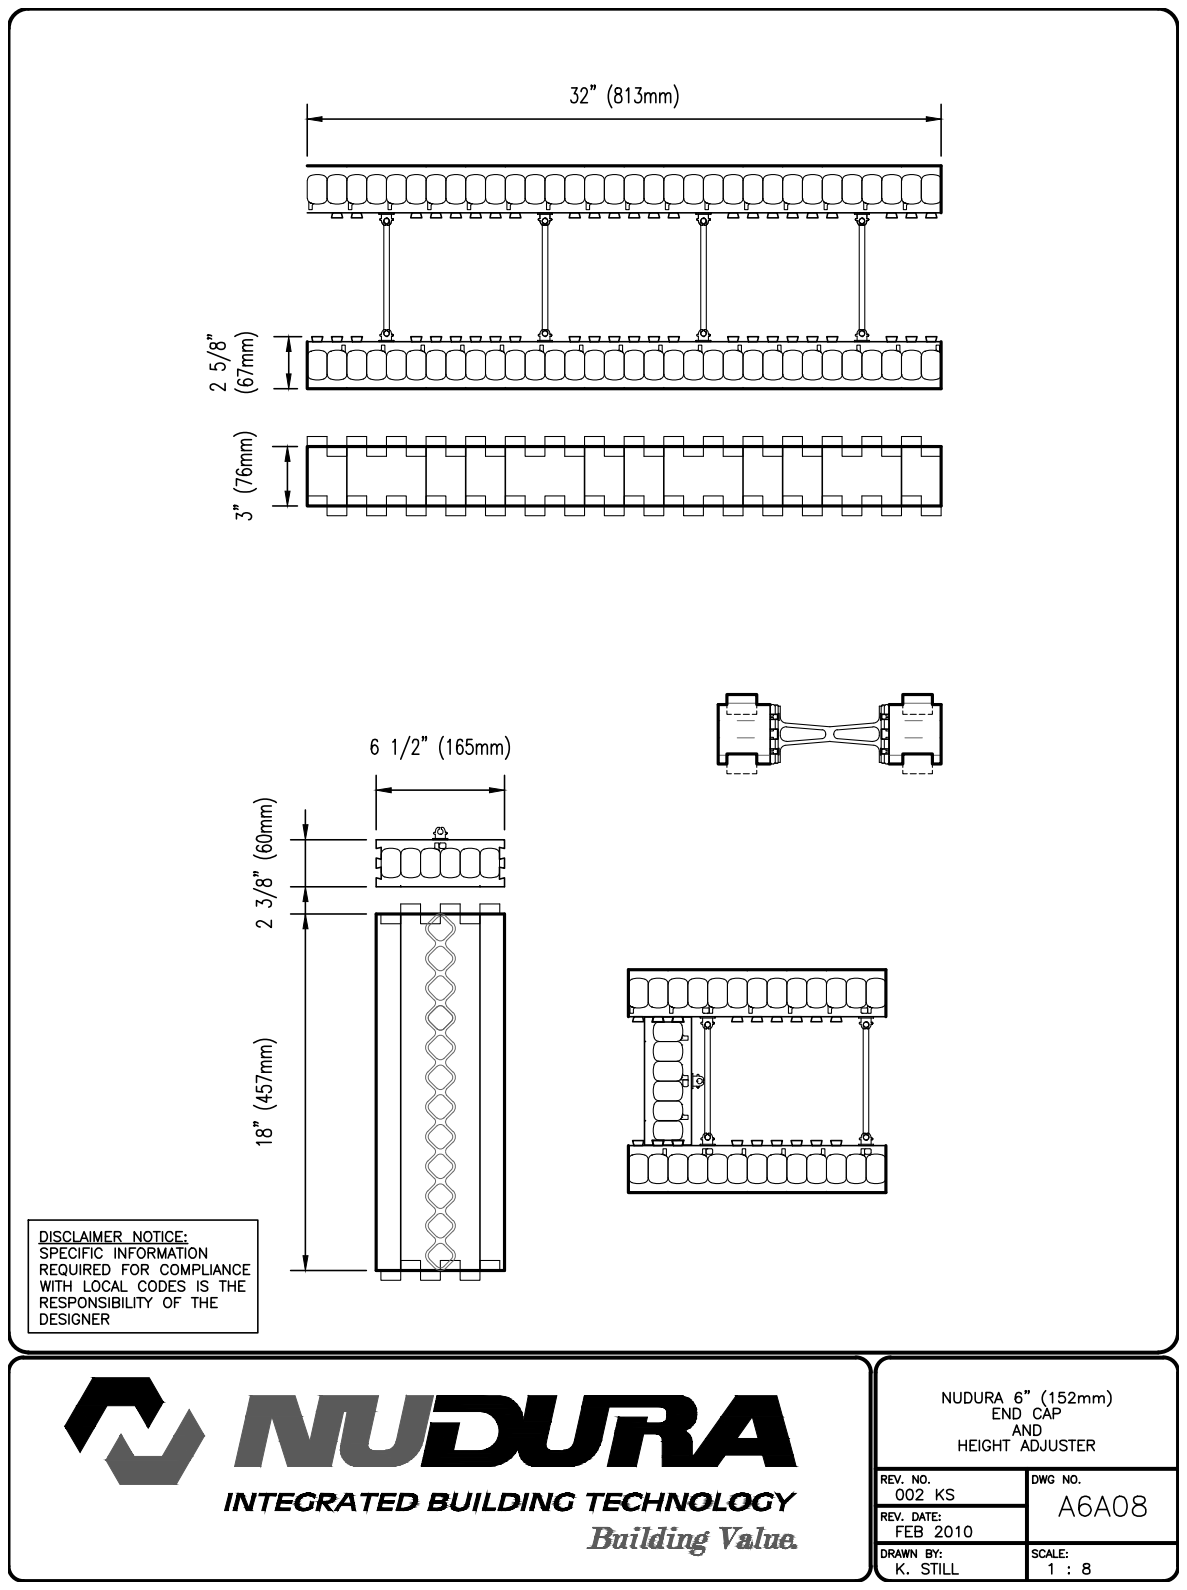
[picture p300: page 1]
