Tanvi11Ghelani/ECO_BUILD_UI/build/EcoBuildPdf/FormUnitProfiles/152mm- 6 Concrete Core Forms/Single Sided Taper Top Form Unit A6A04.pdf

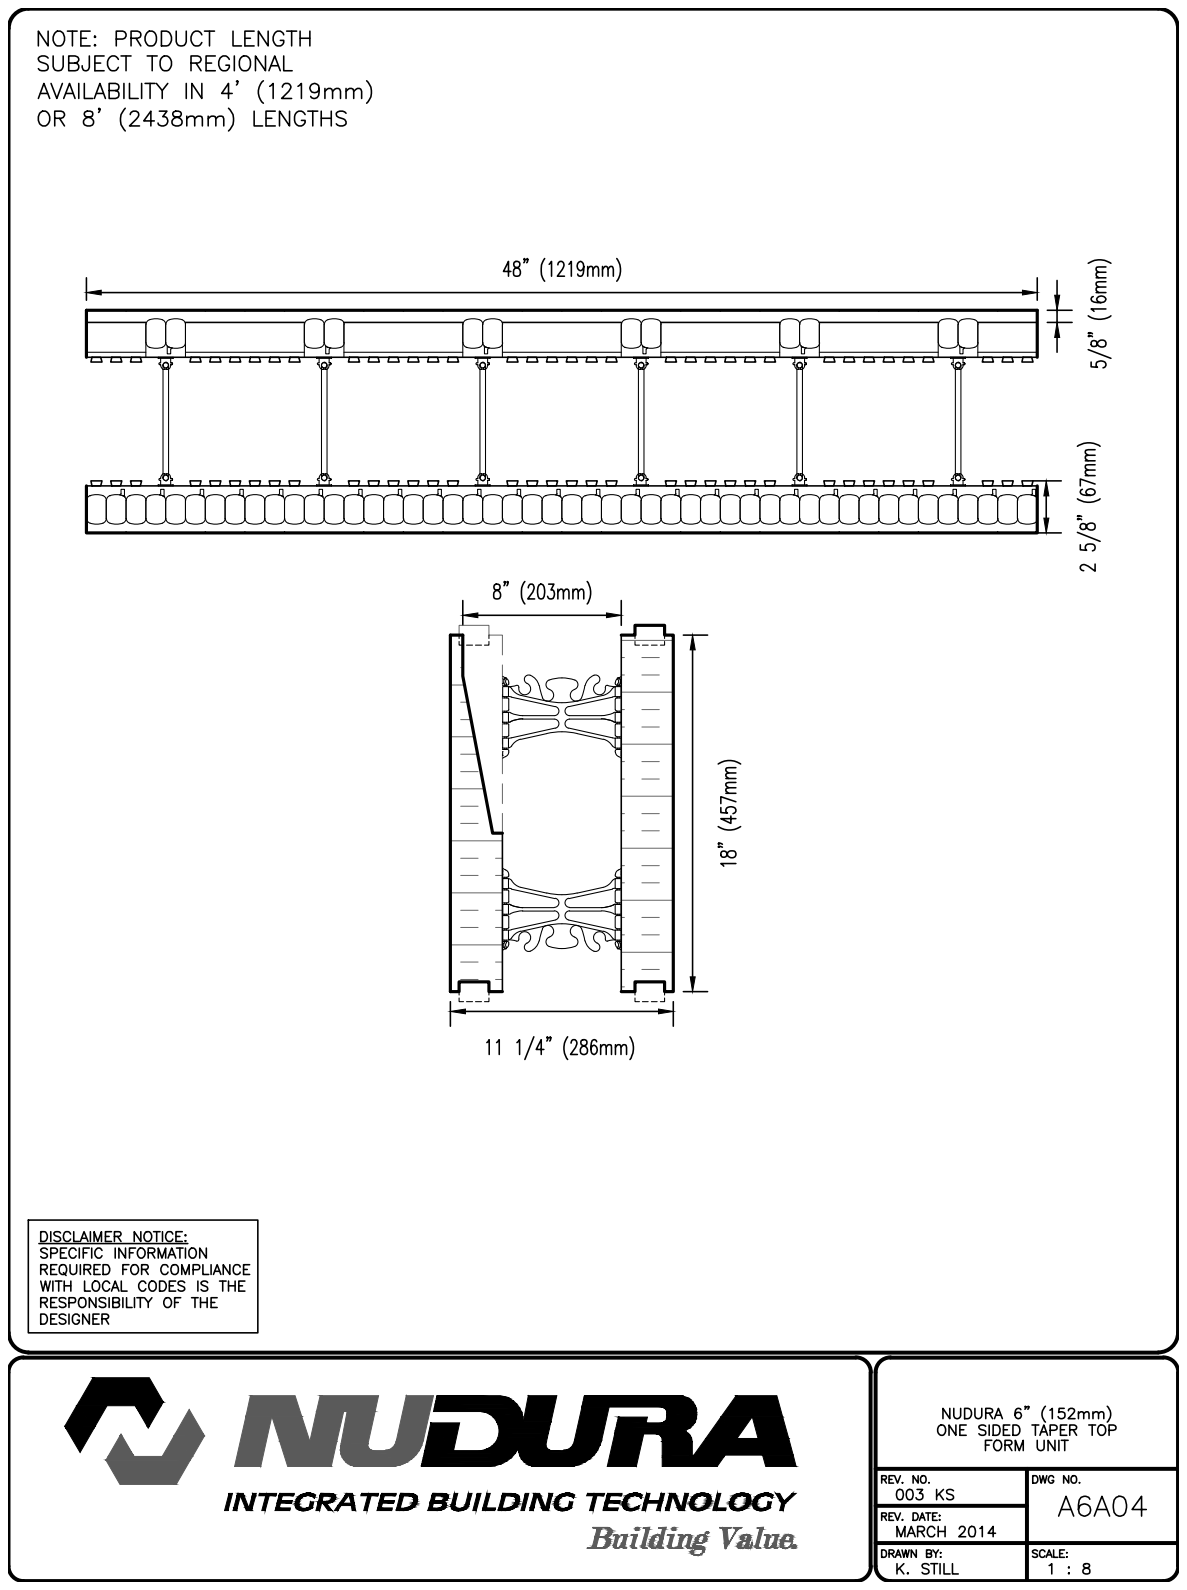
[picture p301: page 1]
