Tanvi11Ghelani/ECO_BUILD_UI/build/EcoBuildPdf/FormUnitProfiles/152mm- 6 Concrete Core Forms/Standard Form Unit A6A01.pdf

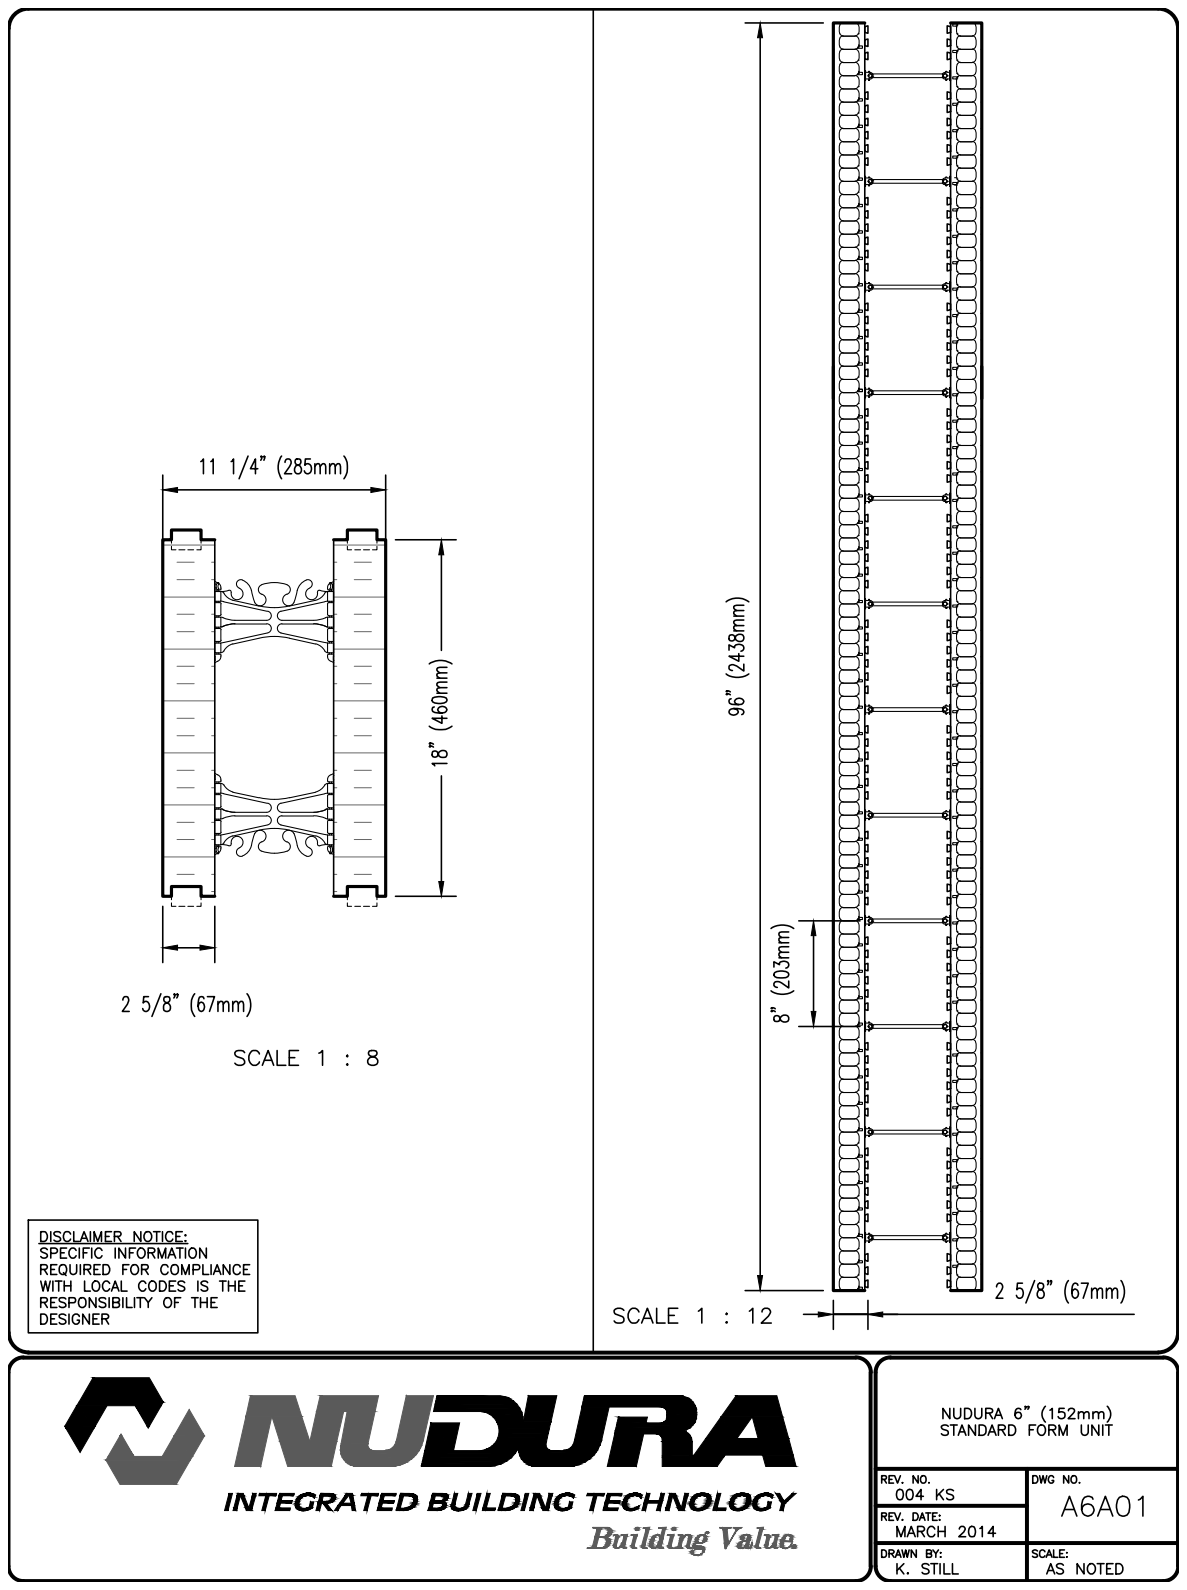
[picture p302: page 1]
