Tanvi11Ghelani/ECO_BUILD_UI/build/EcoBuildPdf/FormUnitProfiles/152mm- 6 Concrete Core Forms/T-Form Unit A6A07.pdf

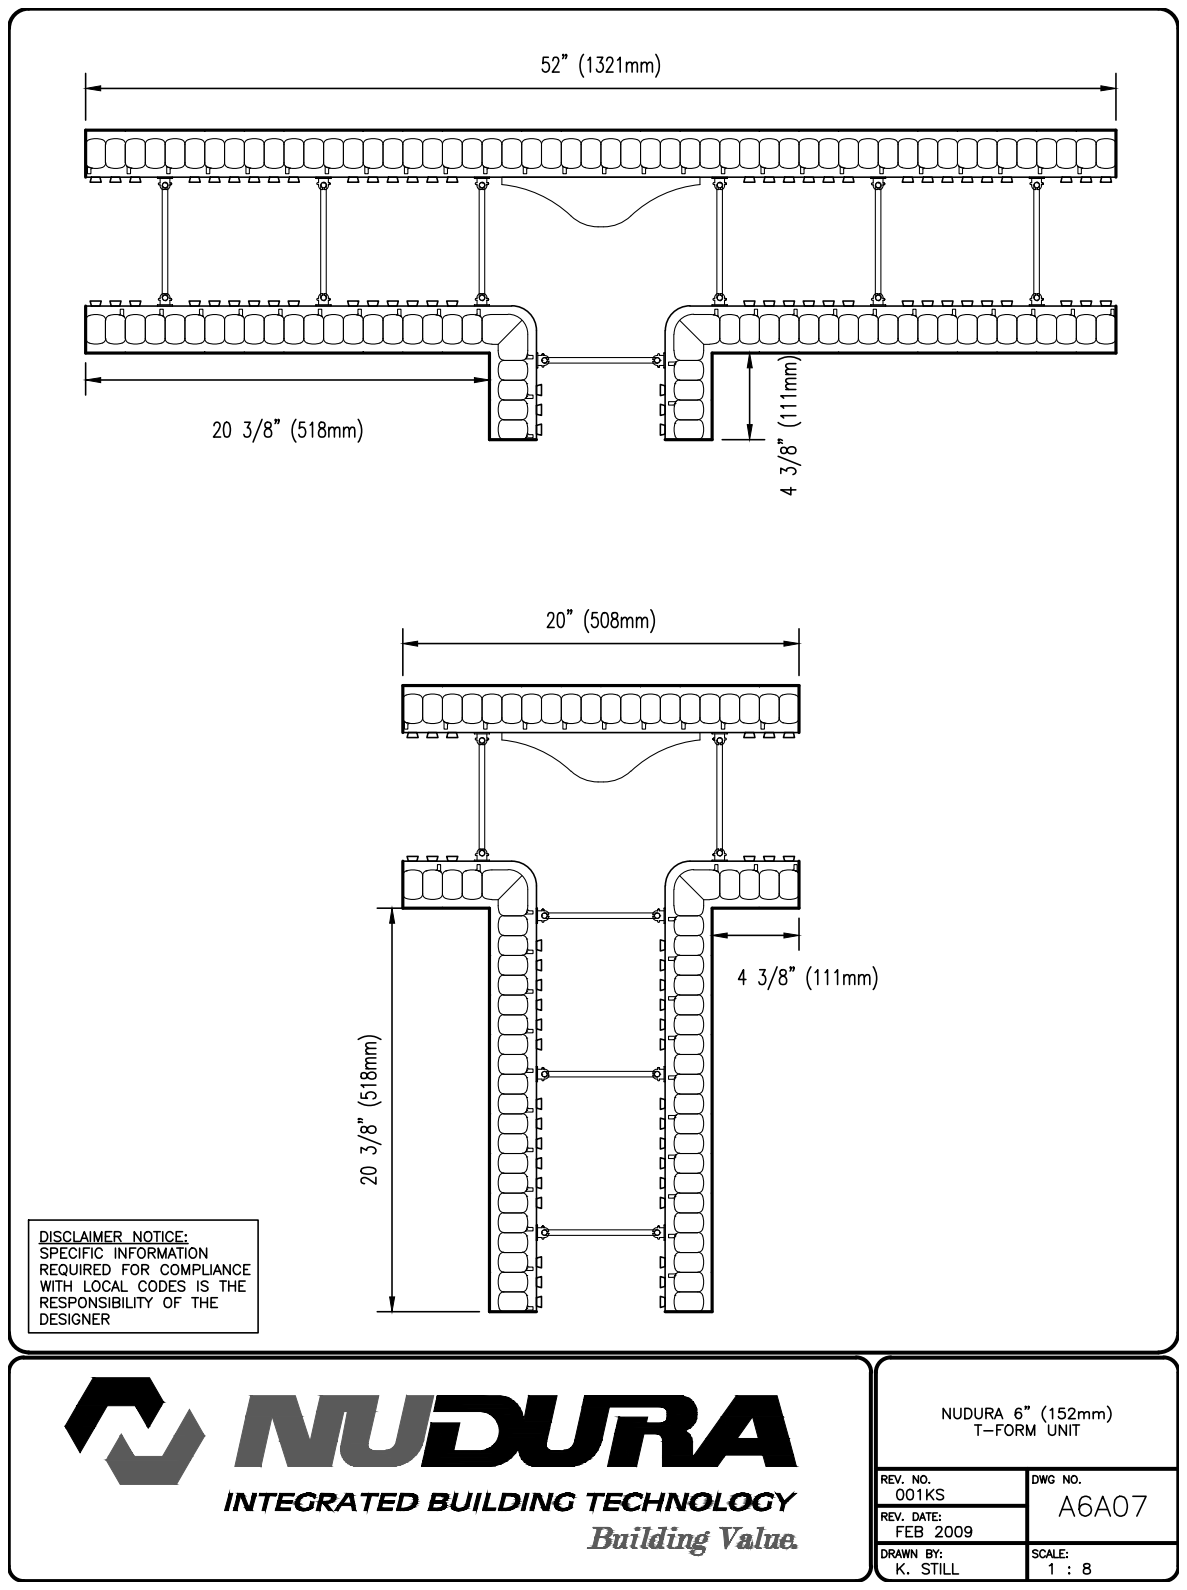
[picture p303: page 1]
