Tanvi11Ghelani/ECO_BUILD_UI/build/EcoBuildPdf/FormUnitProfiles/203mm- 8 Concrete Core Forms/45 Degree Corner Form Unit A8A03.pdf

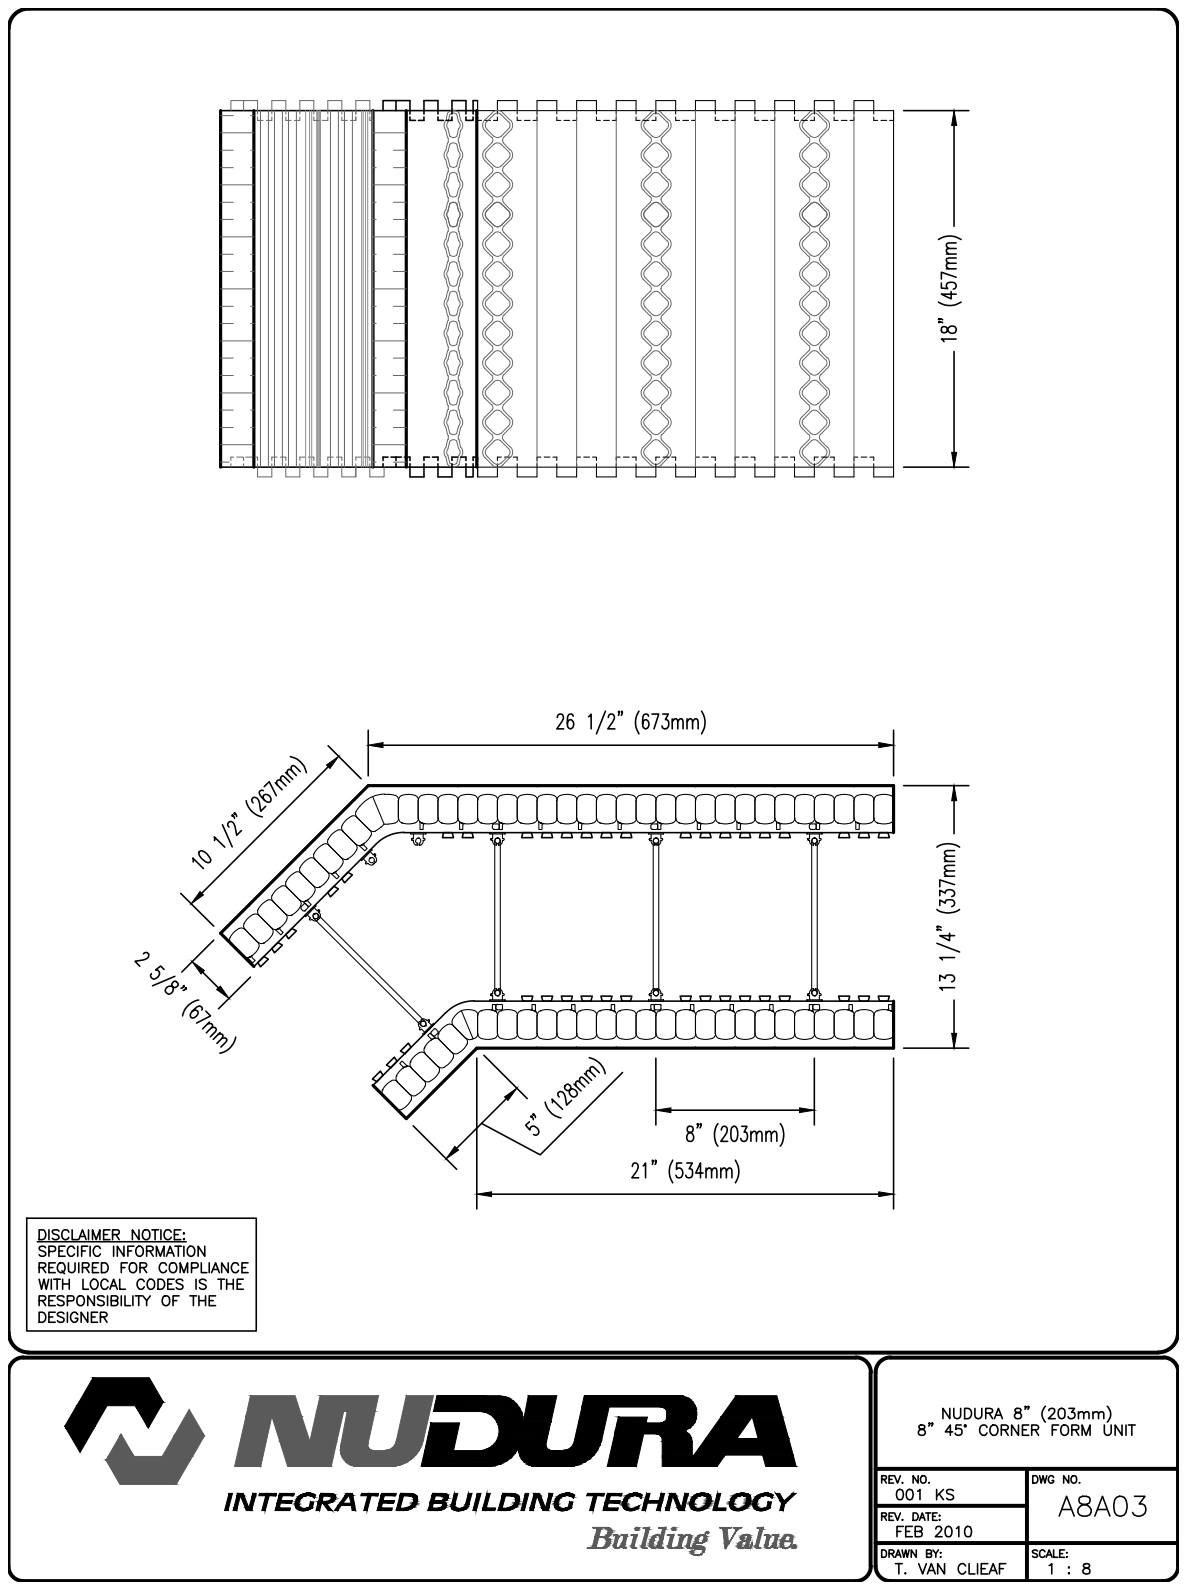
[picture p304: page 1]
