Tanvi11Ghelani/ECO_BUILD_UI/build/EcoBuildPdf/FormUnitProfiles/203mm- 8 Concrete Core Forms/90 Degree Corner Form Unit A8A02.pdf

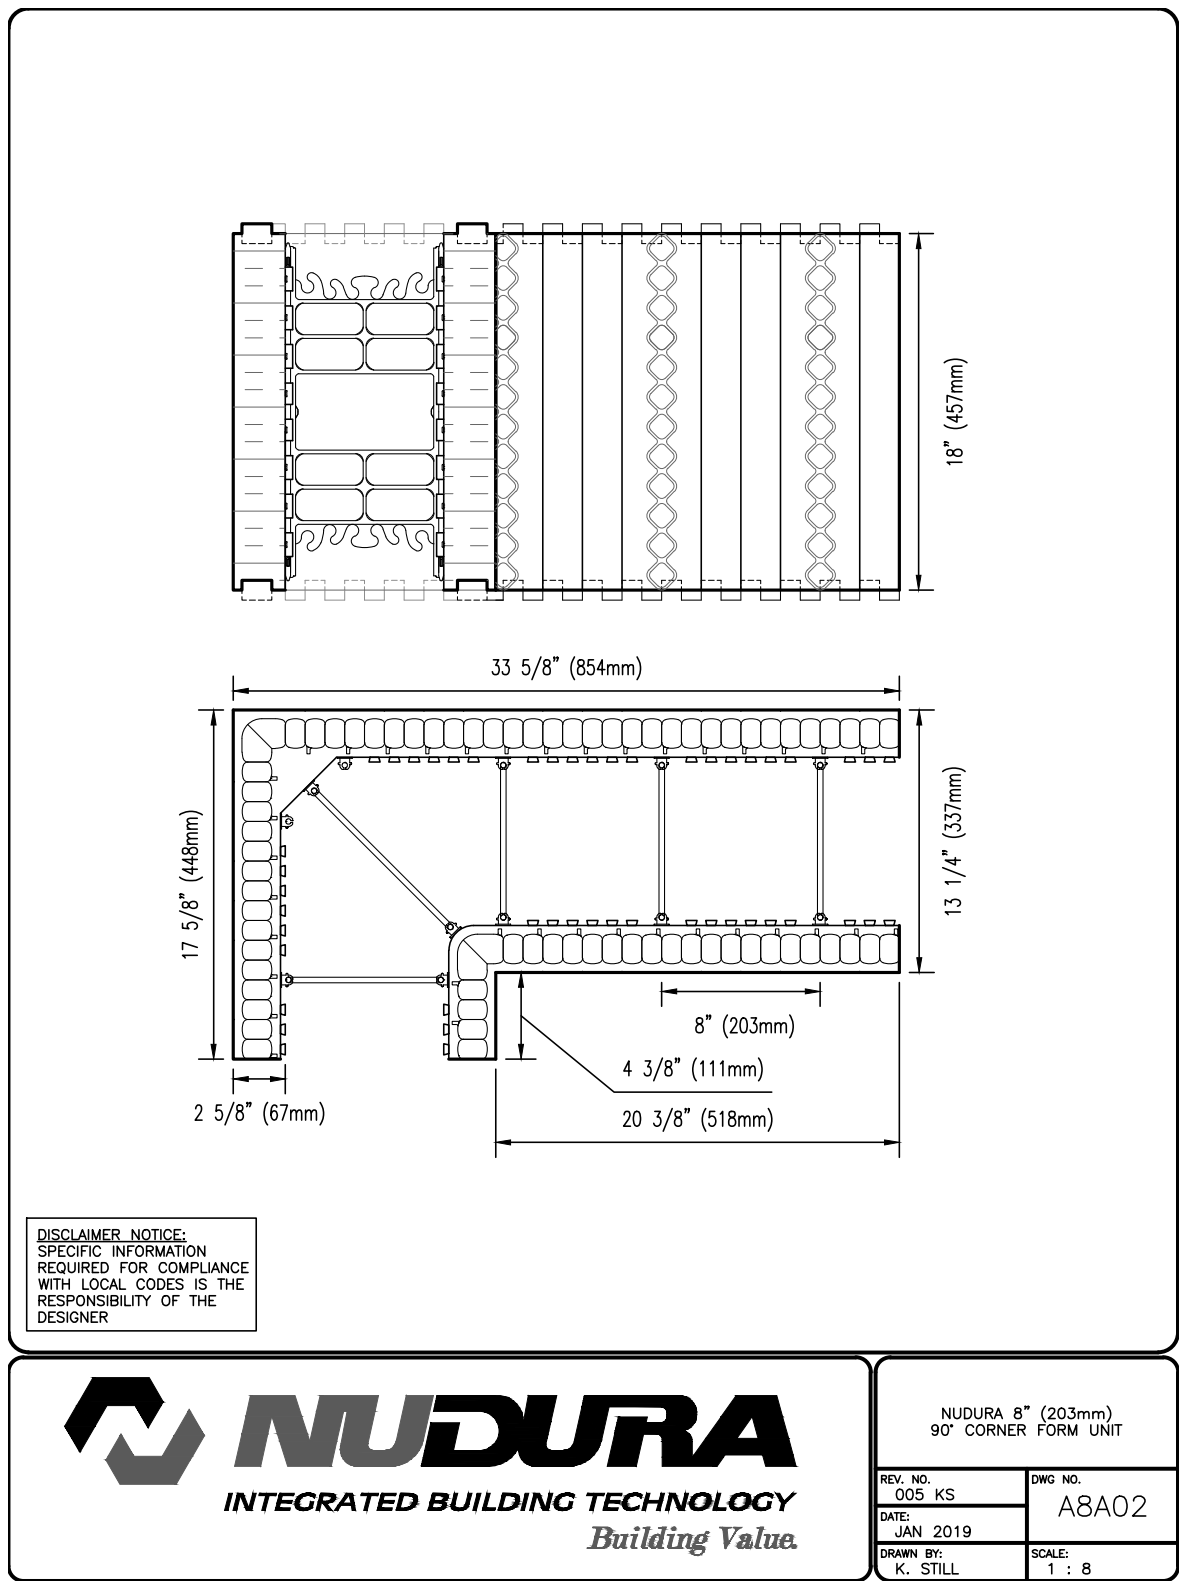
[picture p305: page 1]
