Tanvi11Ghelani/ECO_BUILD_UI/build/EcoBuildPdf/FormUnitProfiles/203mm- 8 Concrete Core Forms/Brick Ledge Form Unit A8A06.pdf

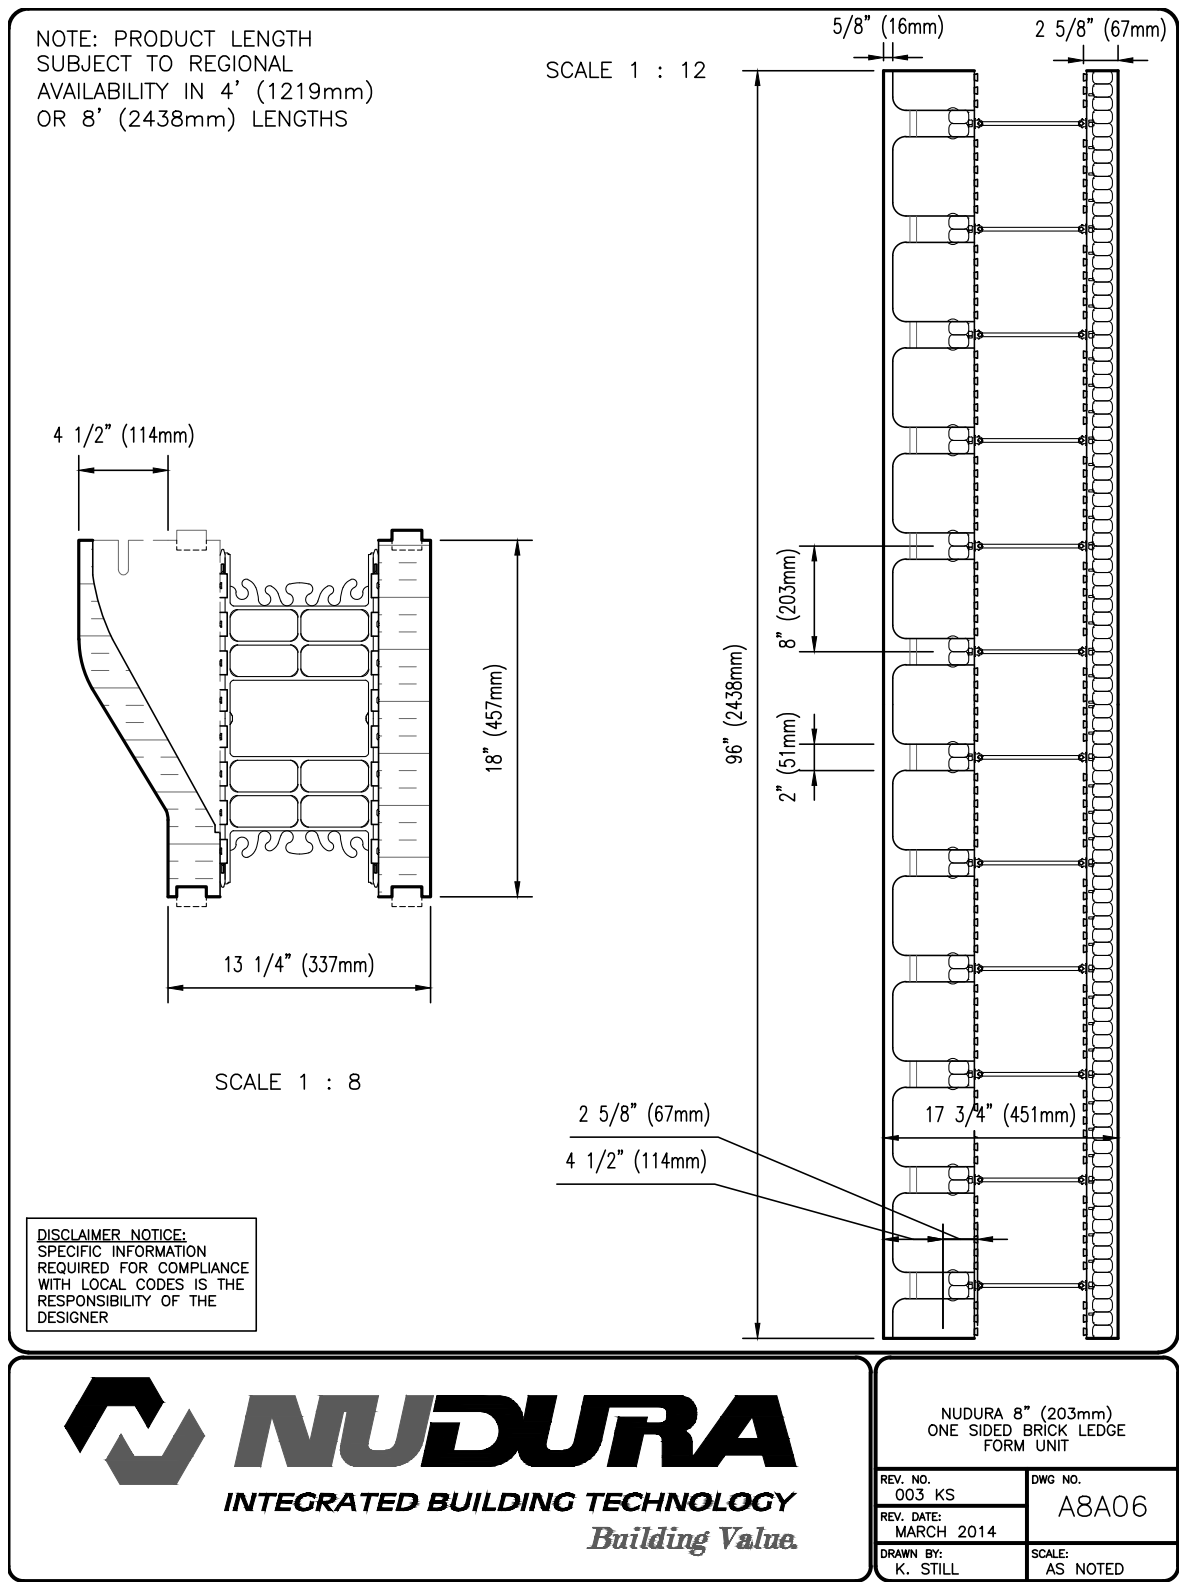
[picture p306: page 1]
