Tanvi11Ghelani/ECO_BUILD_UI/build/EcoBuildPdf/FormUnitProfiles/203mm- 8 Concrete Core Forms/Double Sided Taper Top Form Unit A8A05.pdf

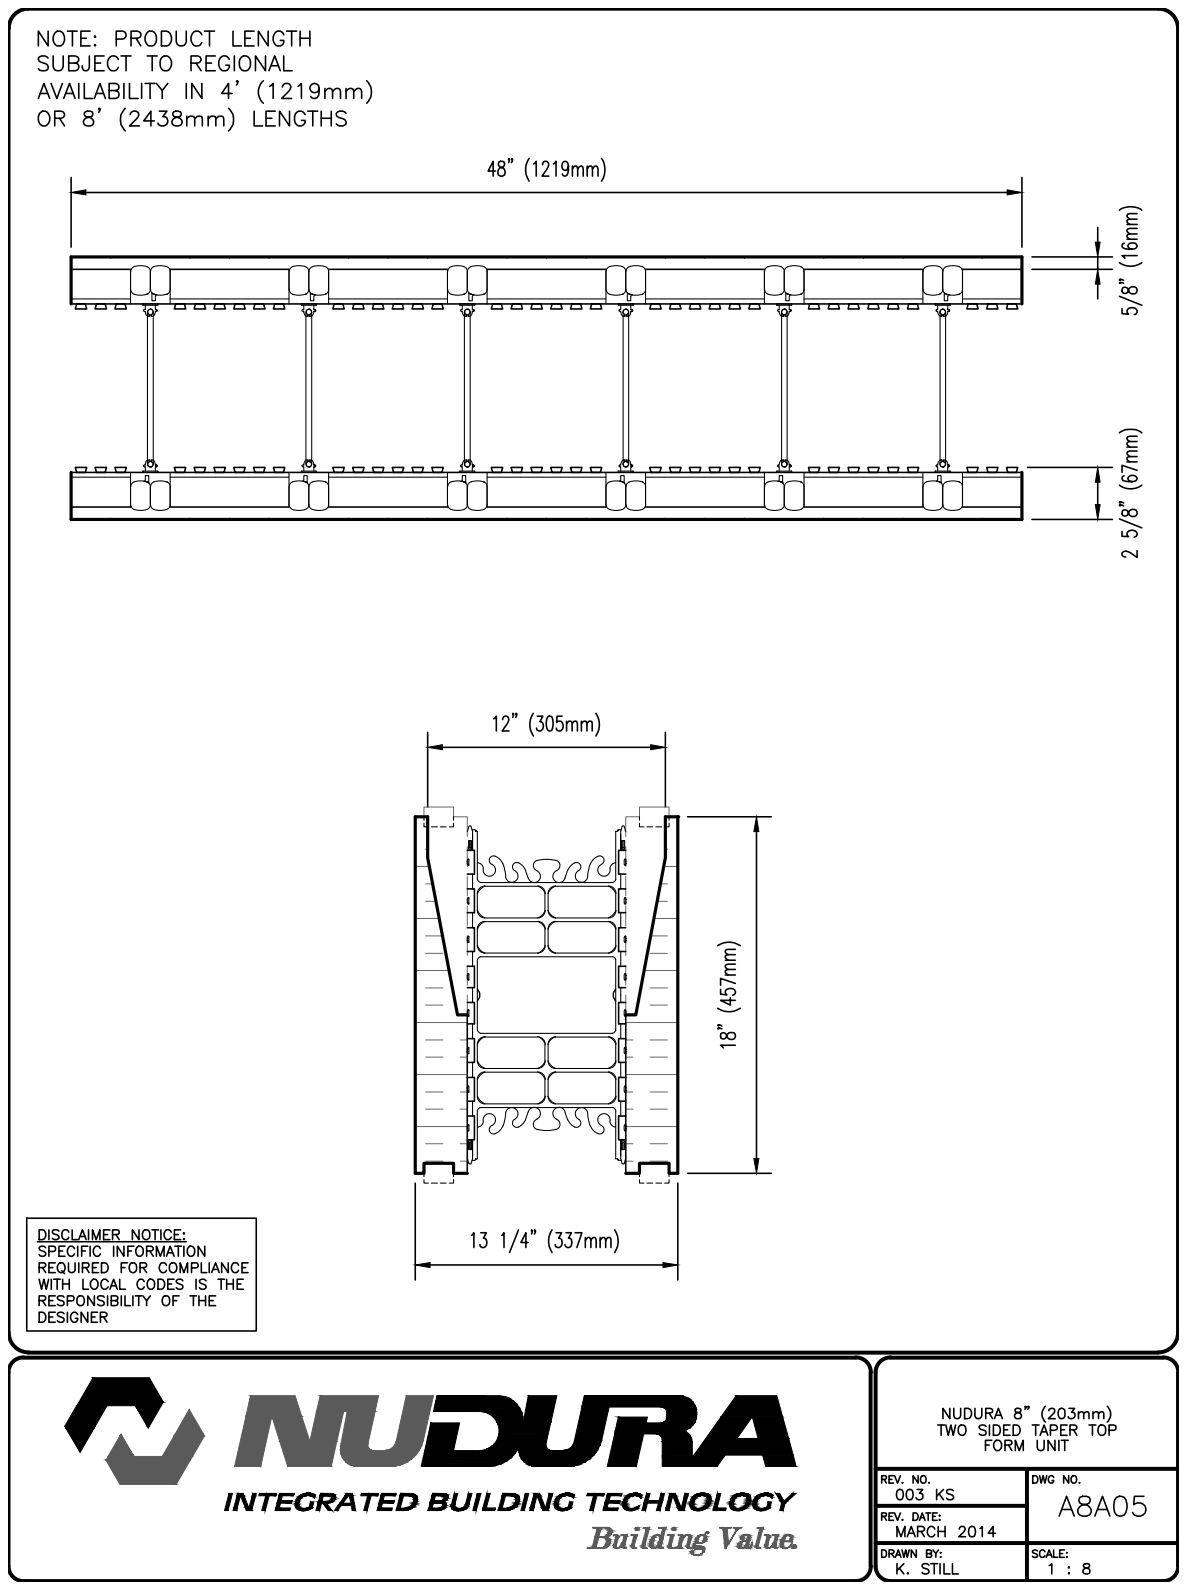
[picture p307: page 1]
