Tanvi11Ghelani/ECO_BUILD_UI/build/EcoBuildPdf/FormUnitProfiles/203mm- 8 Concrete Core Forms/End Cap and Height Adjuster A8A08.pdf

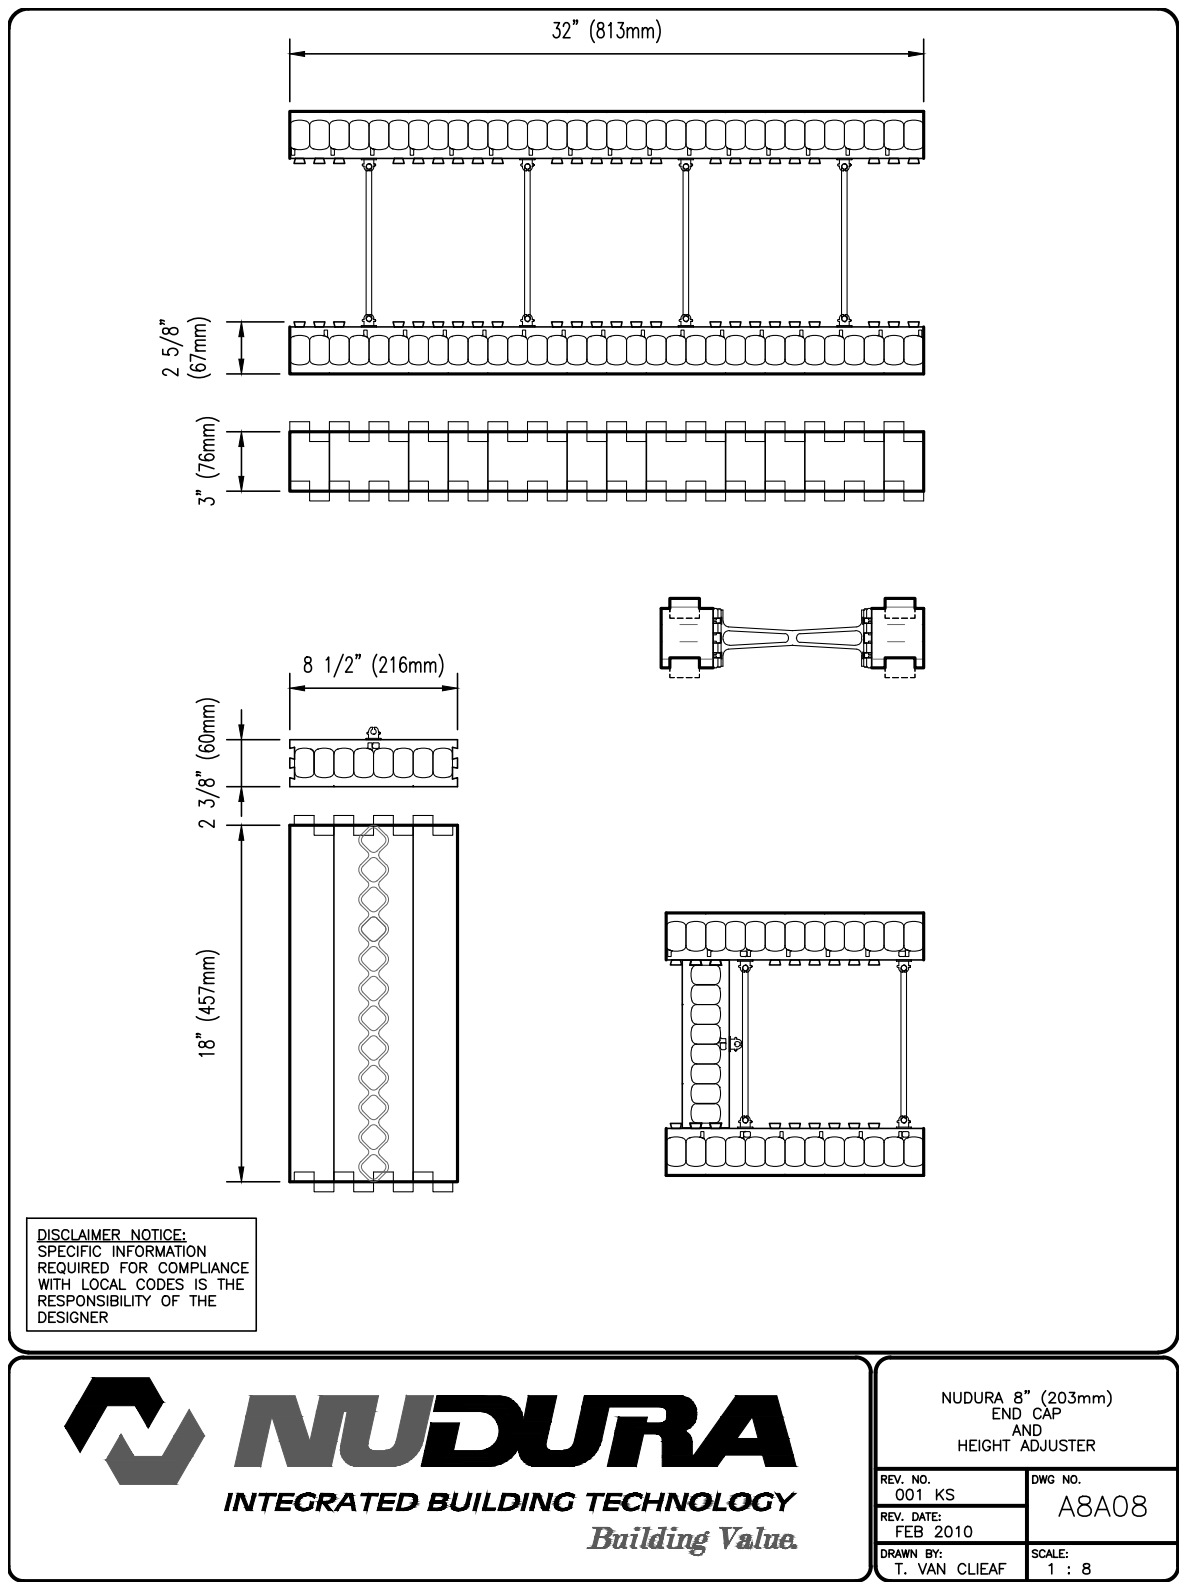
[picture p308: page 1]
