Tanvi11Ghelani/ECO_BUILD_UI/build/EcoBuildPdf/FormUnitProfiles/203mm- 8 Concrete Core Forms/Single Sided Taper Top Form Unit A8A04.pdf

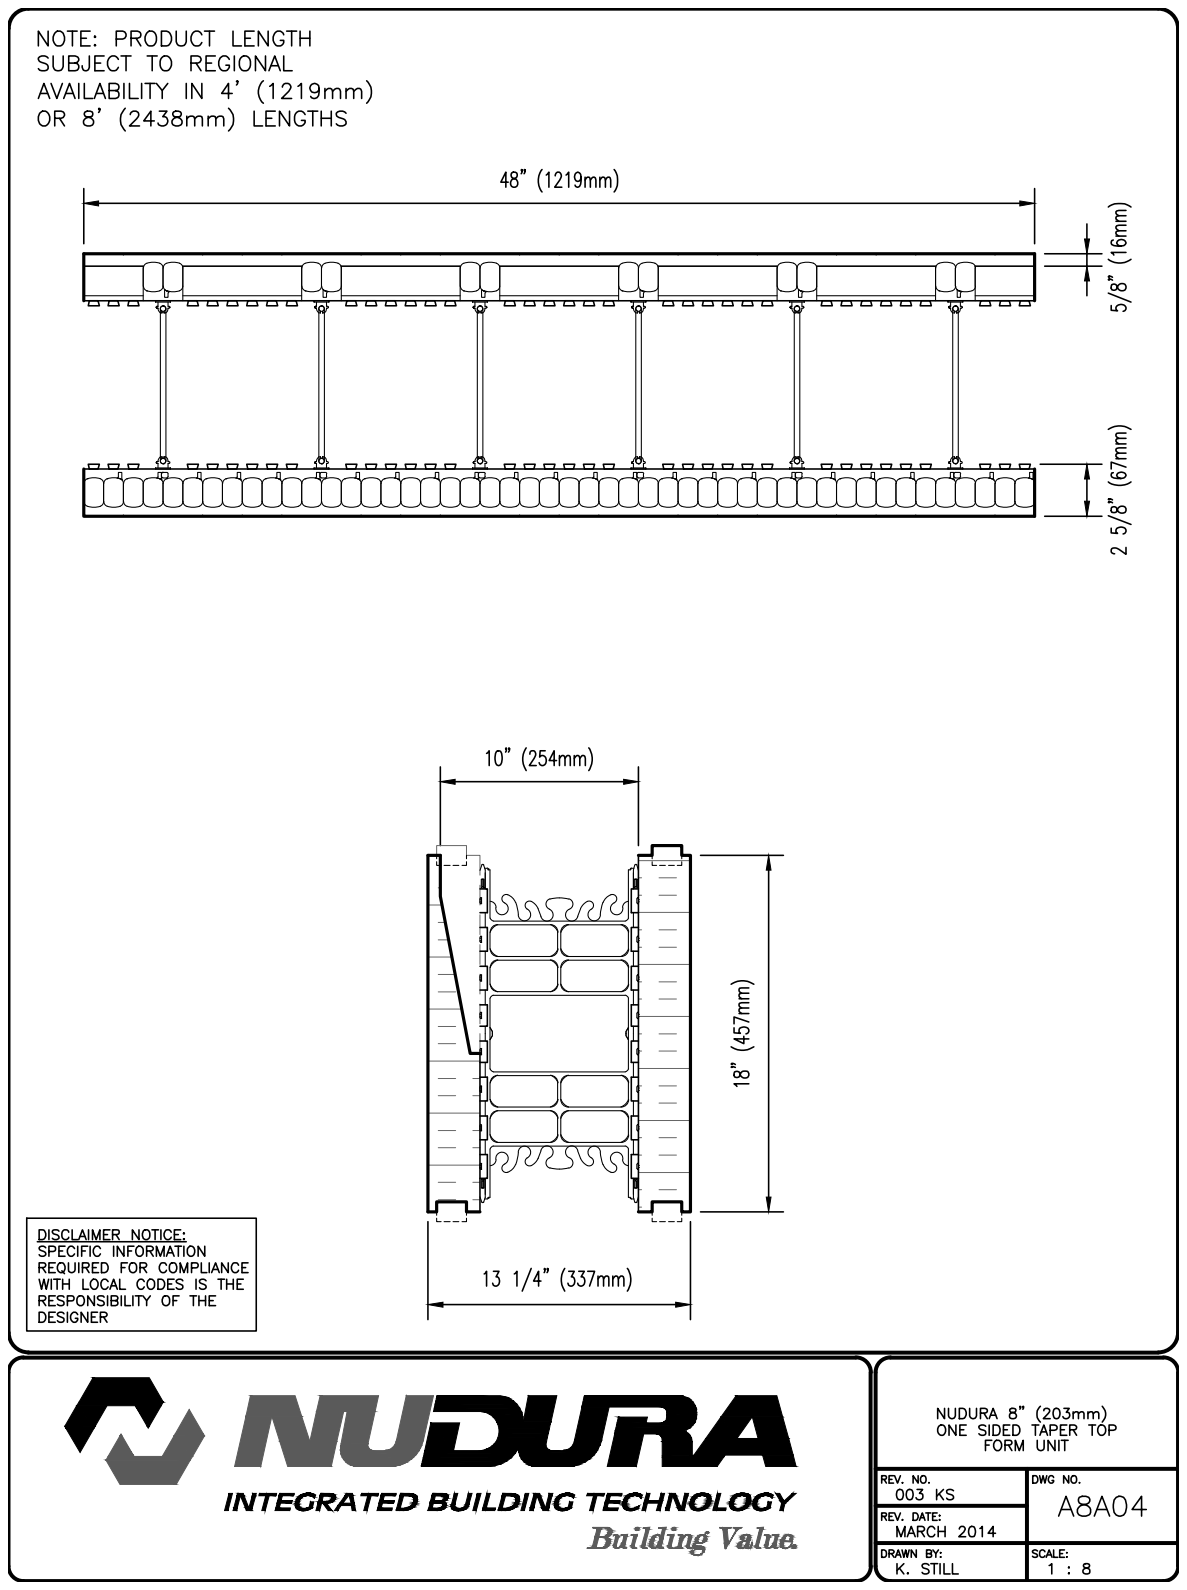
[picture p309: page 1]
