Tanvi11Ghelani/ECO_BUILD_UI/build/EcoBuildPdf/FormUnitProfiles/203mm- 8 Concrete Core Forms/Standard Form Unit A8A01.pdf

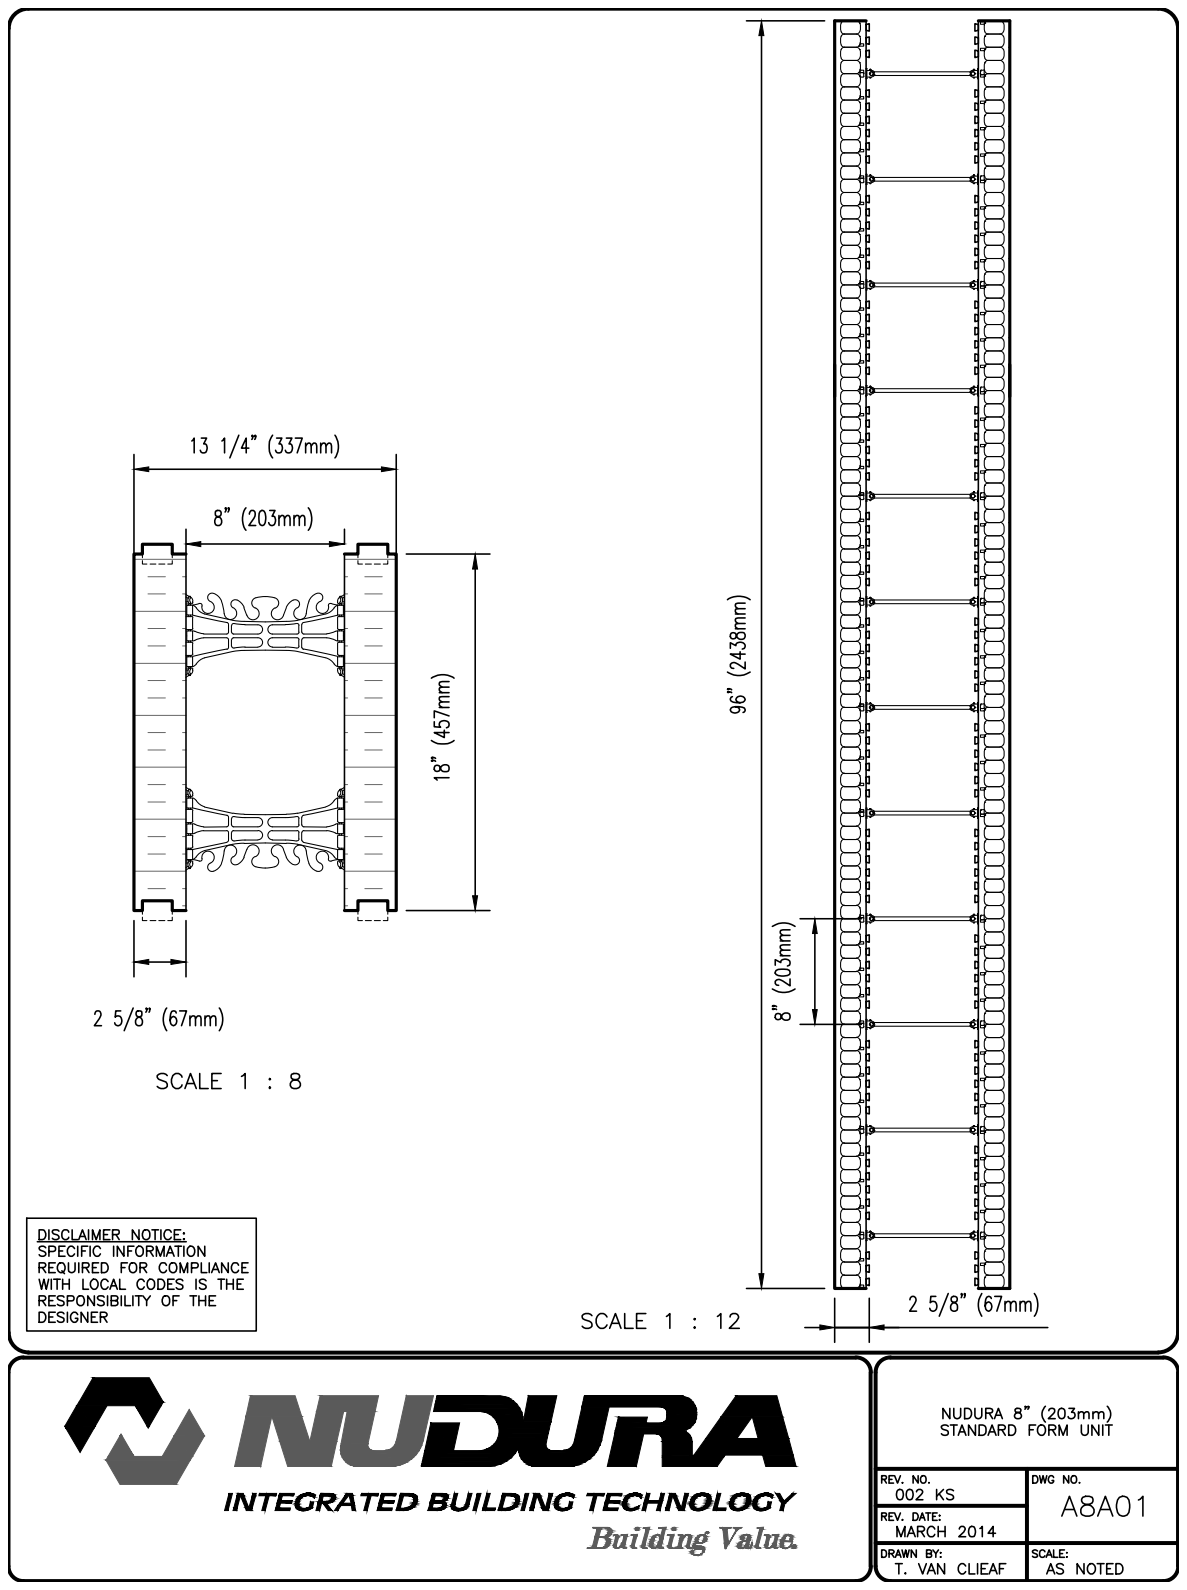
[picture p310: page 1]
