Tanvi11Ghelani/ECO_BUILD_UI/build/EcoBuildPdf/FormUnitProfiles/203mm- 8 Concrete Core Forms/T-Form Unit A8A07.pdf

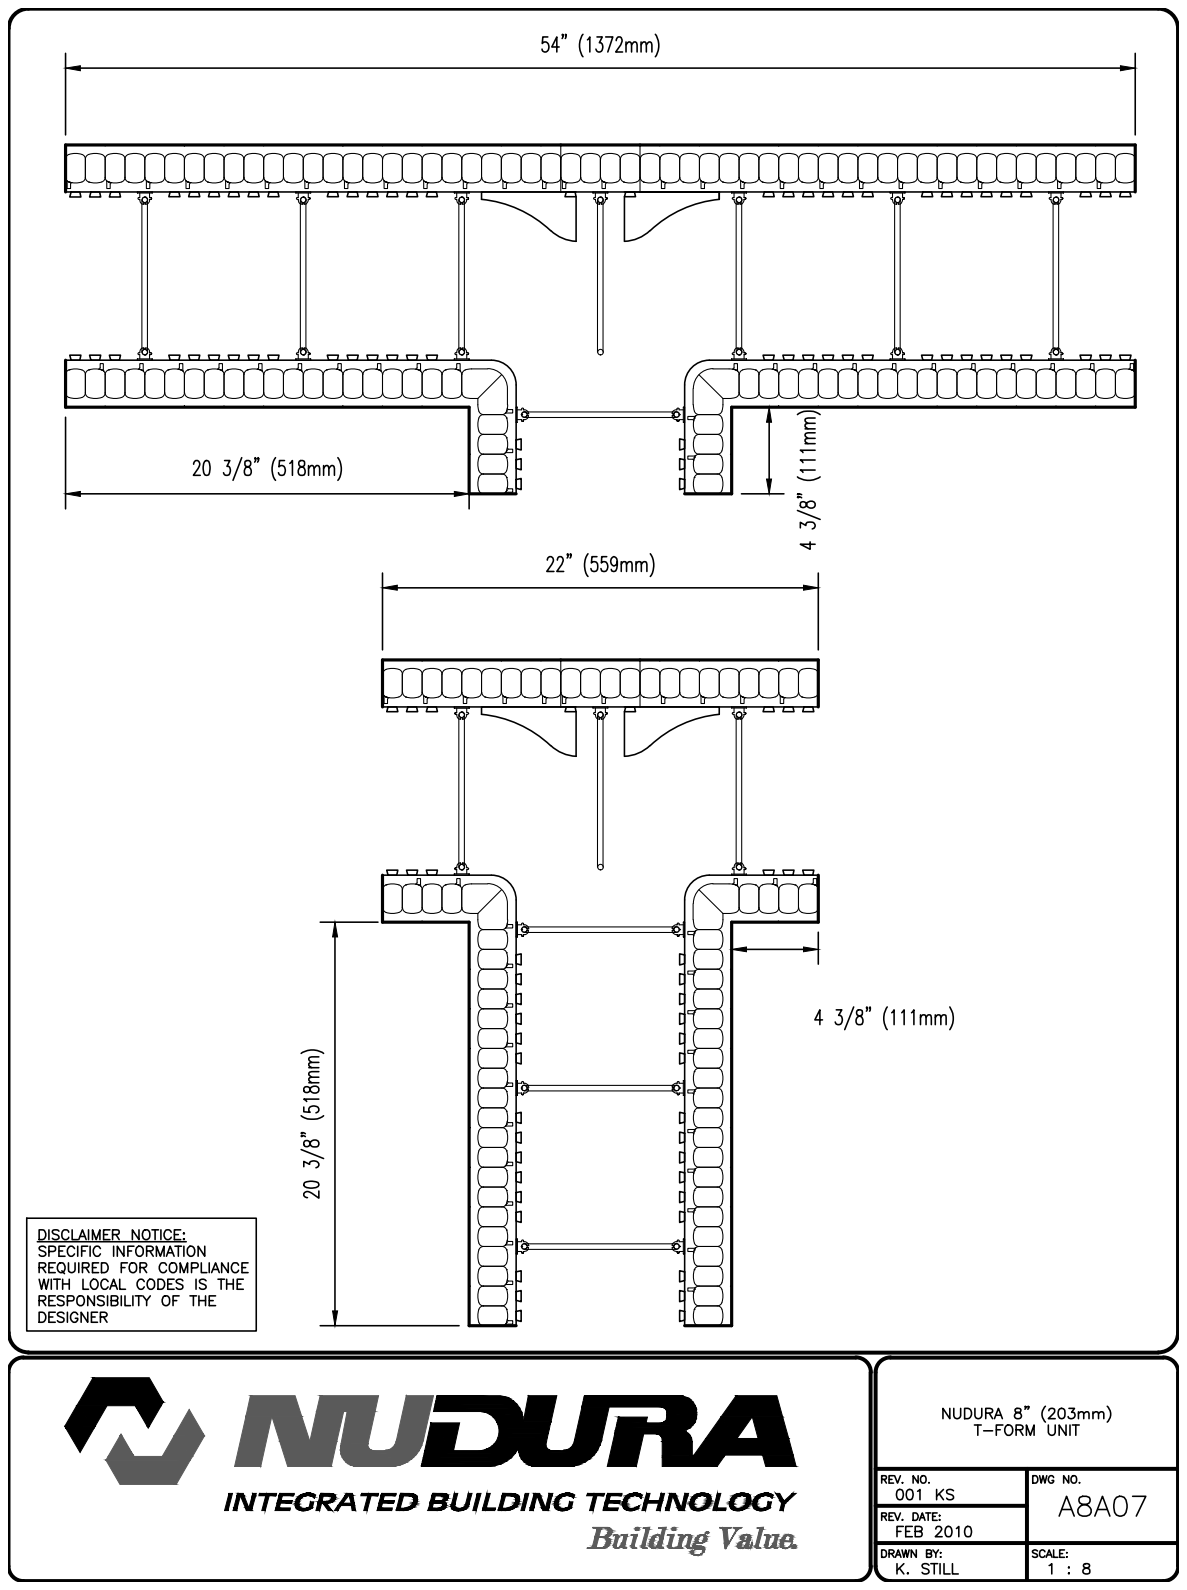
[picture p311: page 1]
