Tanvi11Ghelani/ECO_BUILD_UI/build/EcoBuildPdf/FormUnitProfiles/254mm- 10 Concrete Core Forms/45 Degree Corner Form Unit A10A03.pdf

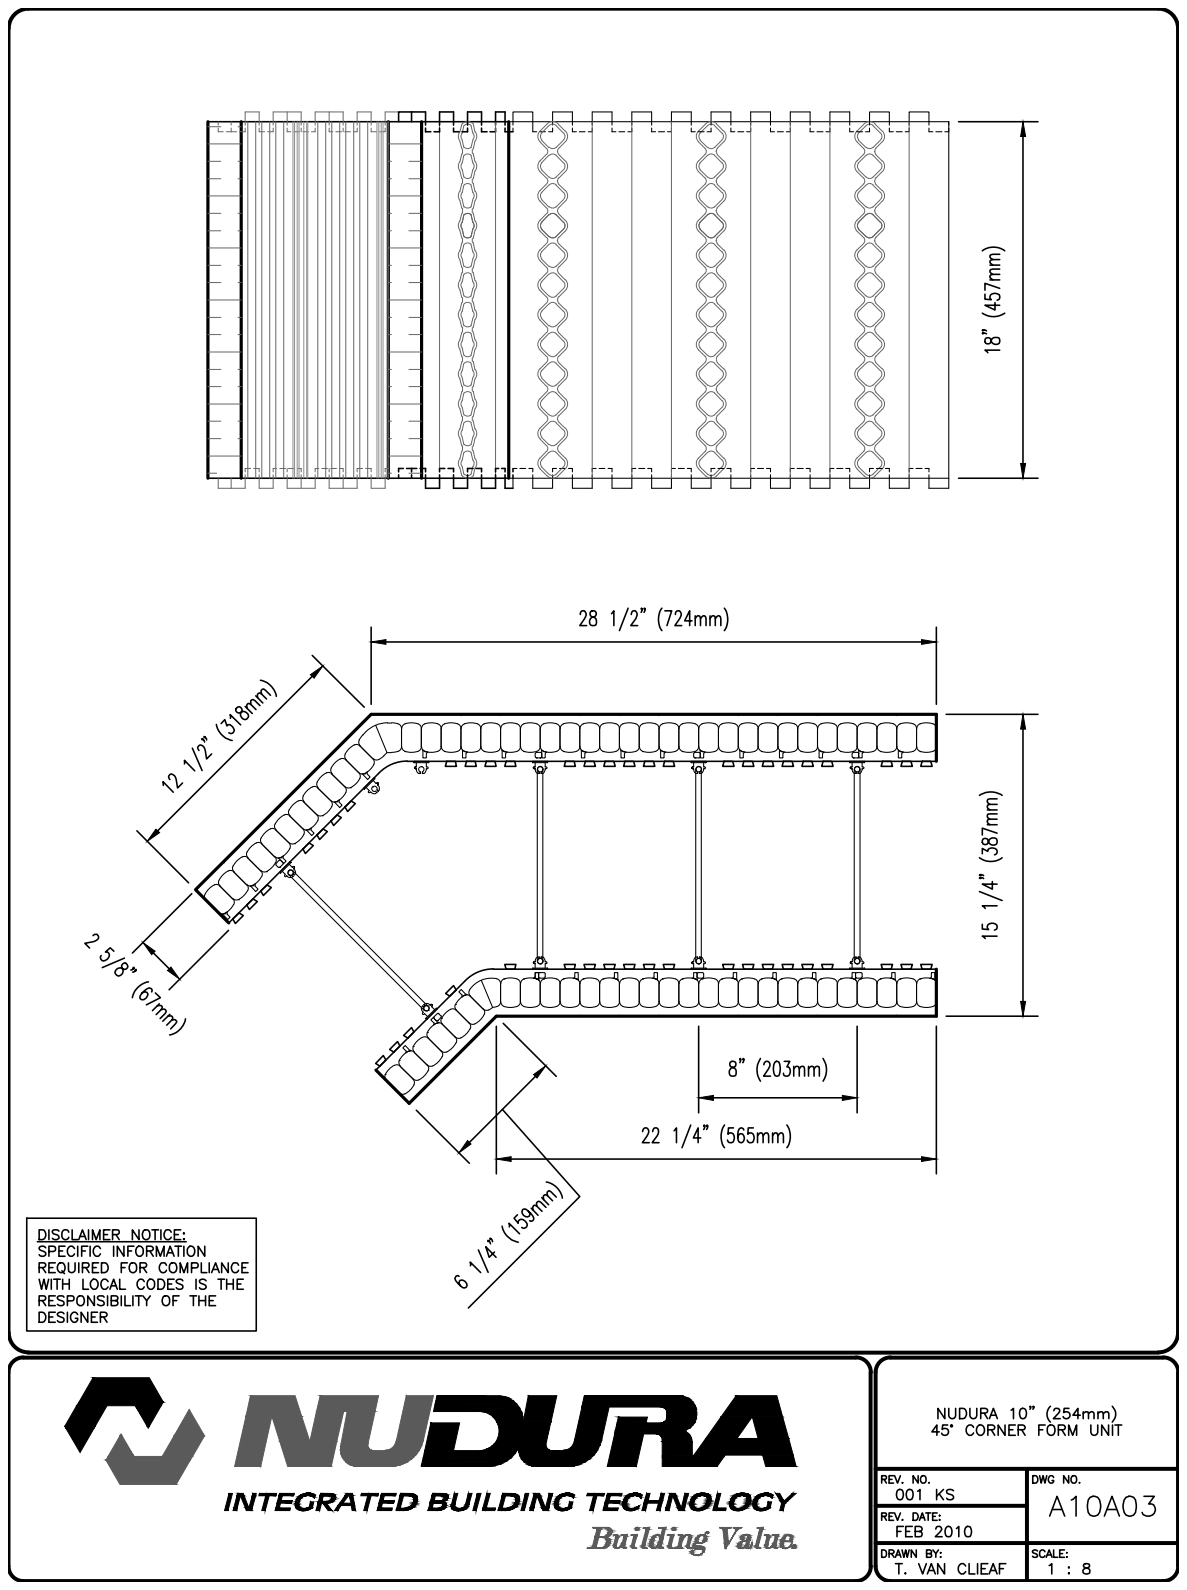
[picture p312: page 1]
