Tanvi11Ghelani/ECO_BUILD_UI/build/EcoBuildPdf/FormUnitProfiles/254mm- 10 Concrete Core Forms/90 Degree Corner Form Unit A10A02.pdf

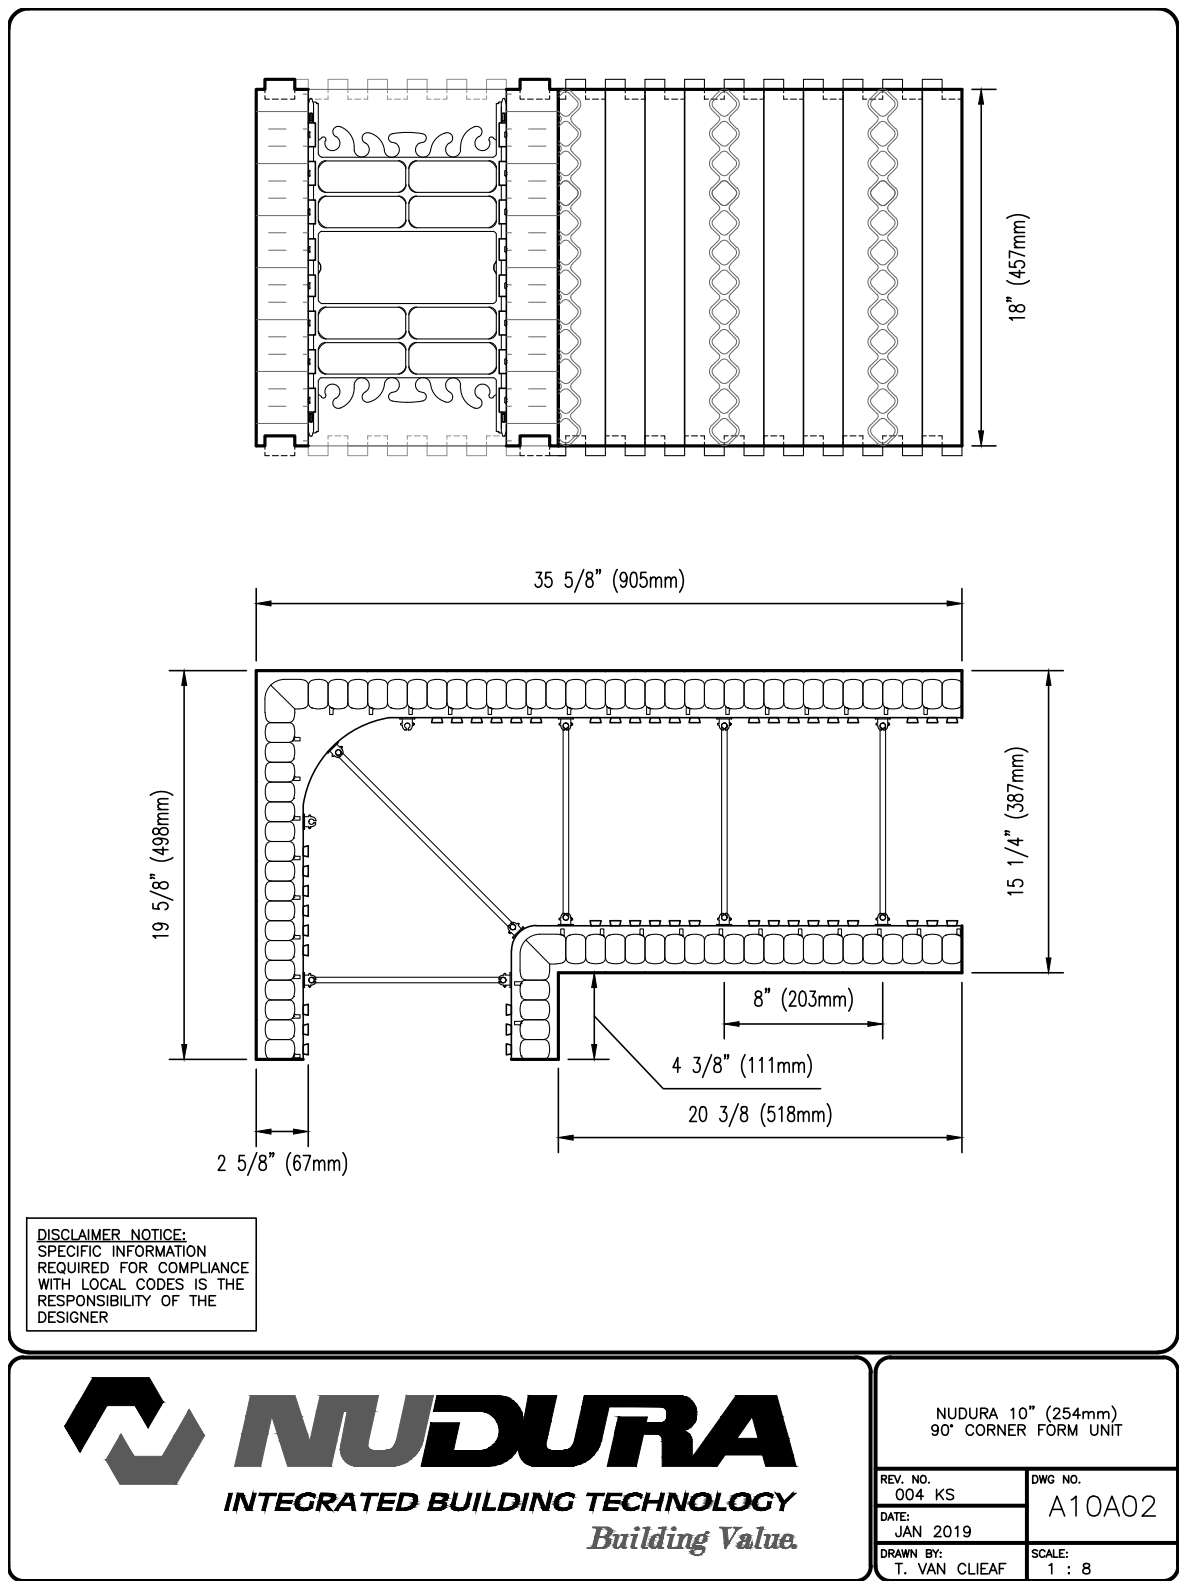
[picture p313: page 1]
