Tanvi11Ghelani/ECO_BUILD_UI/build/EcoBuildPdf/FormUnitProfiles/254mm- 10 Concrete Core Forms/Brick Ledge Form Unit A10A06.pdf

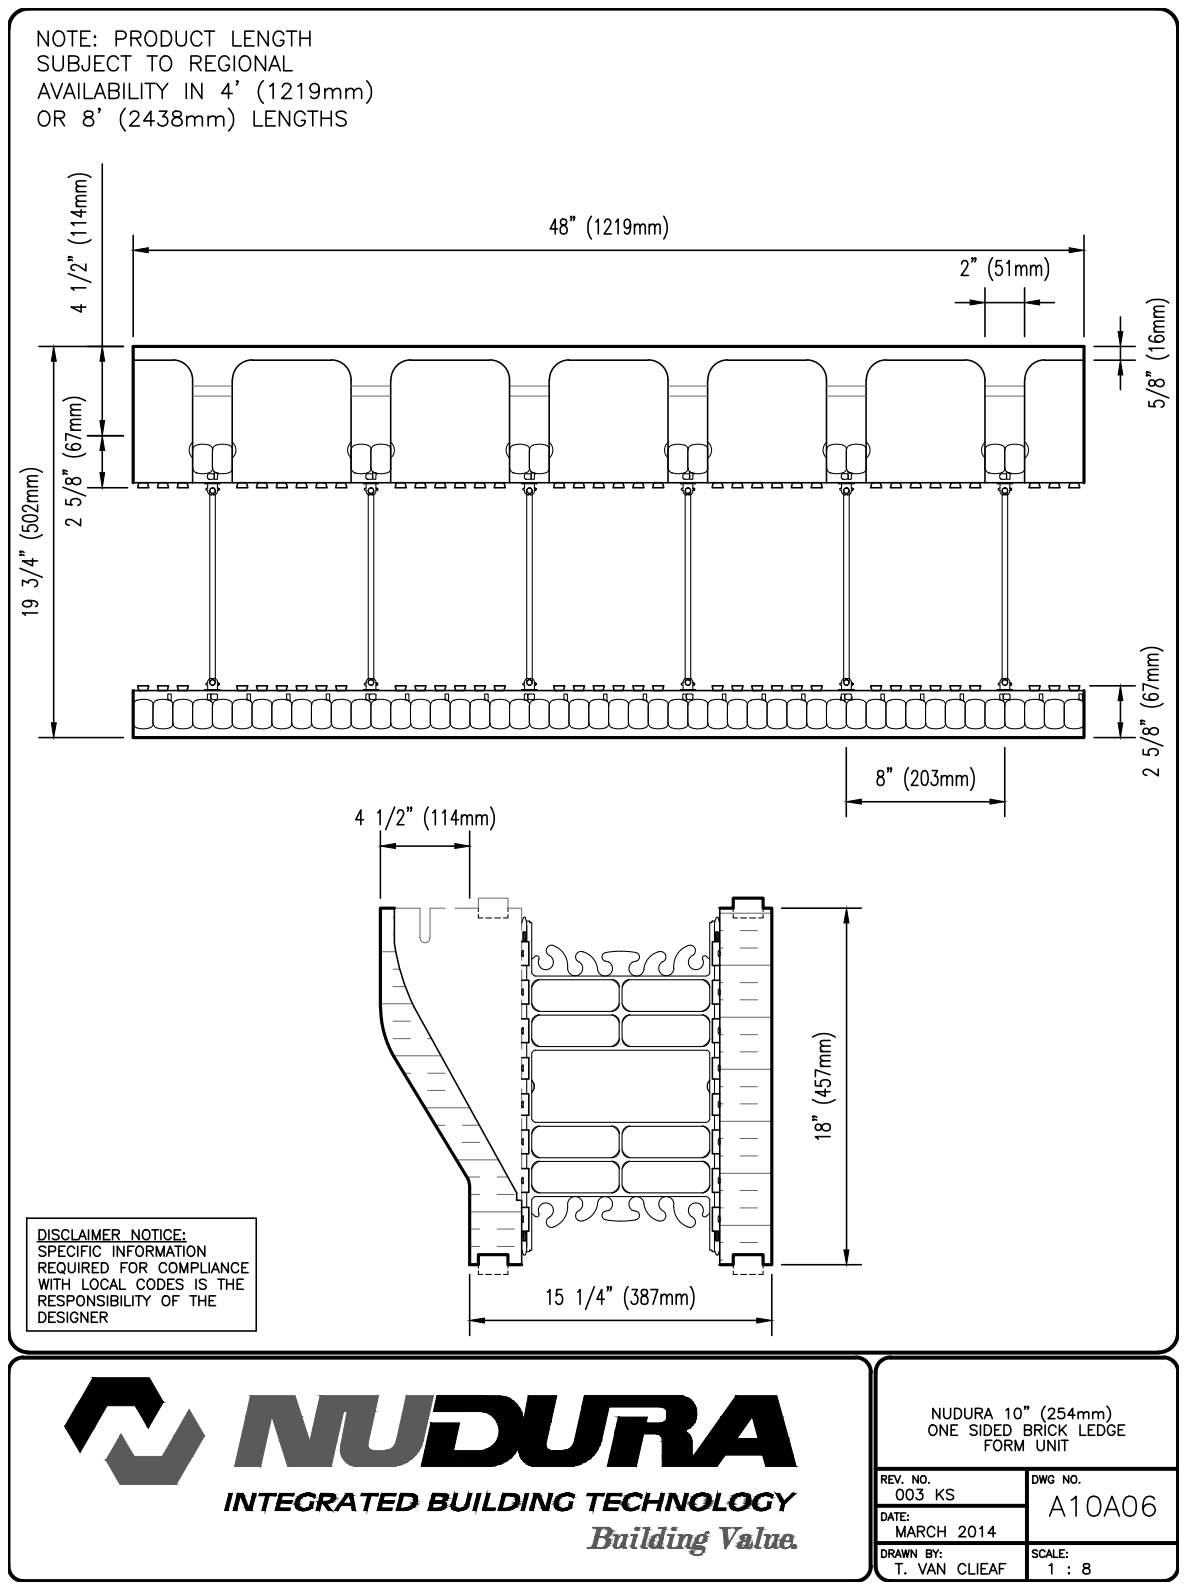
[picture p314: page 1]
