Tanvi11Ghelani/ECO_BUILD_UI/build/EcoBuildPdf/FormUnitProfiles/254mm- 10 Concrete Core Forms/Double Sided Taper Top Form Unit A10A05.pdf

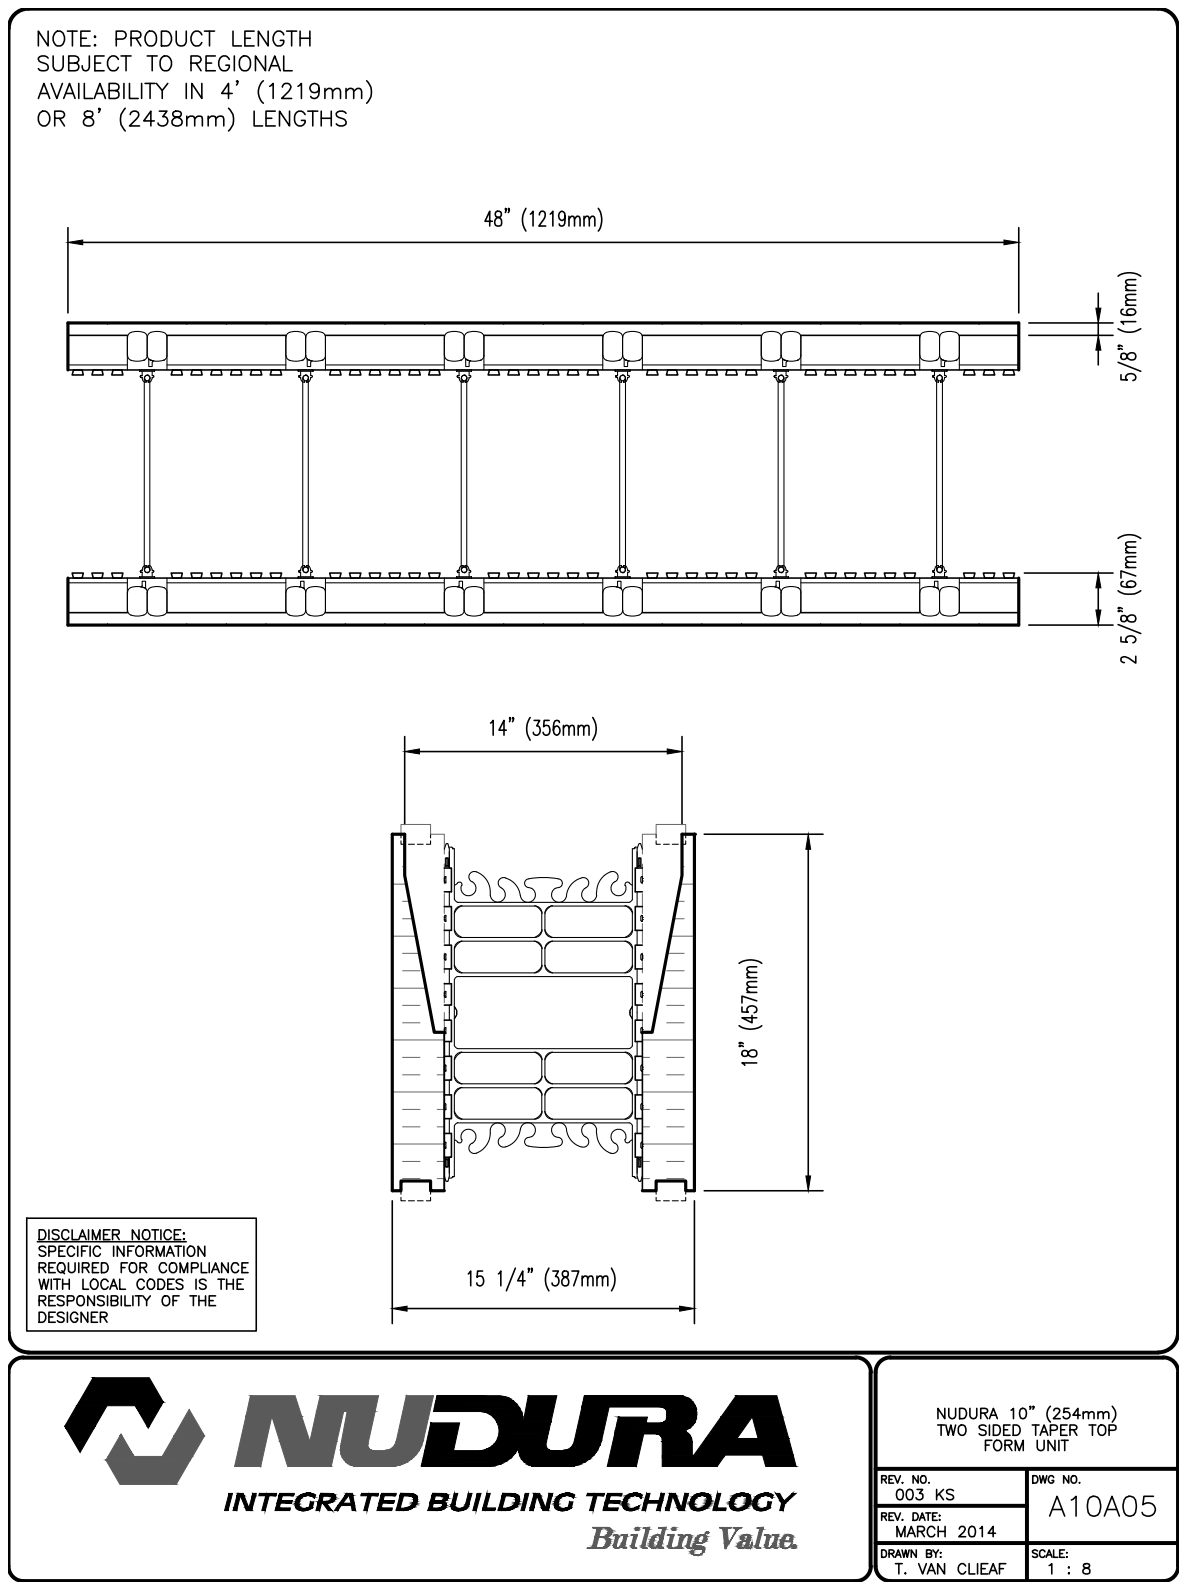
[picture p315: page 1]
