Tanvi11Ghelani/ECO_BUILD_UI/build/EcoBuildPdf/FormUnitProfiles/254mm- 10 Concrete Core Forms/End Cap and Height Adjuster A10A08.pdf

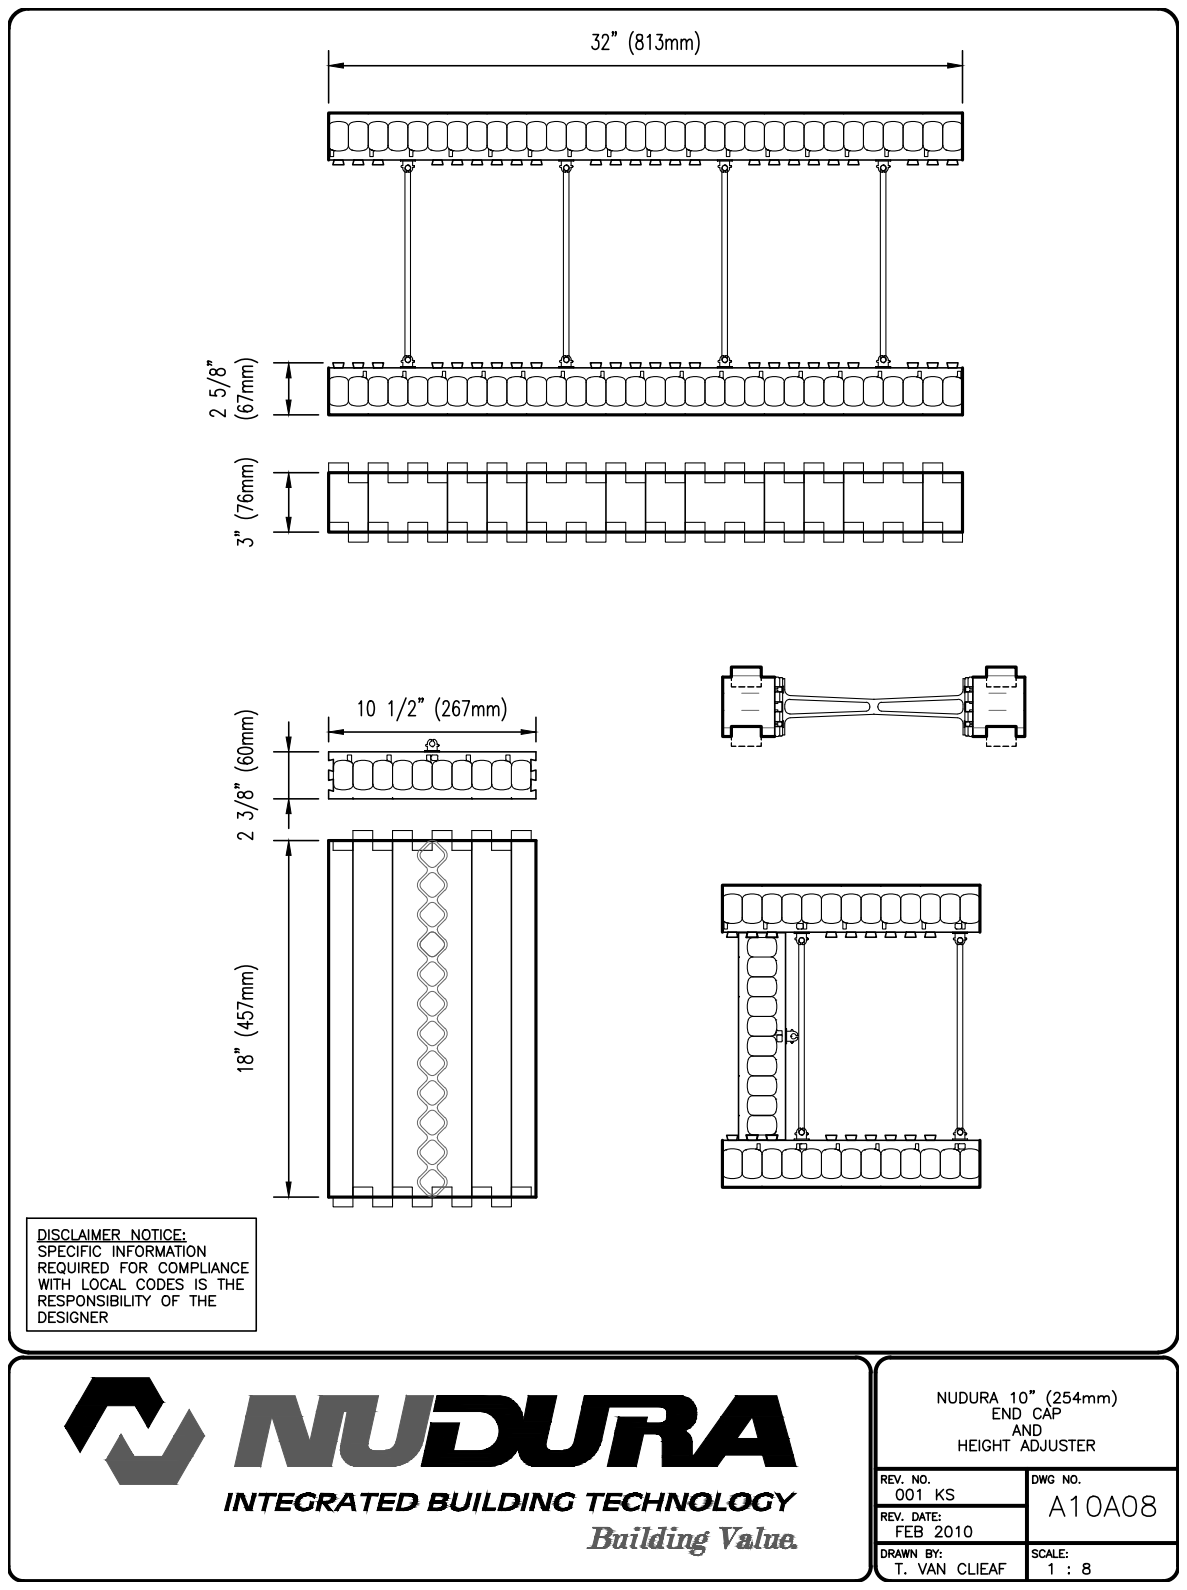
[picture p316: page 1]
