Tanvi11Ghelani/ECO_BUILD_UI/build/EcoBuildPdf/FormUnitProfiles/254mm- 10 Concrete Core Forms/Single Sided Taper Top Form Unit A10A04.pdf

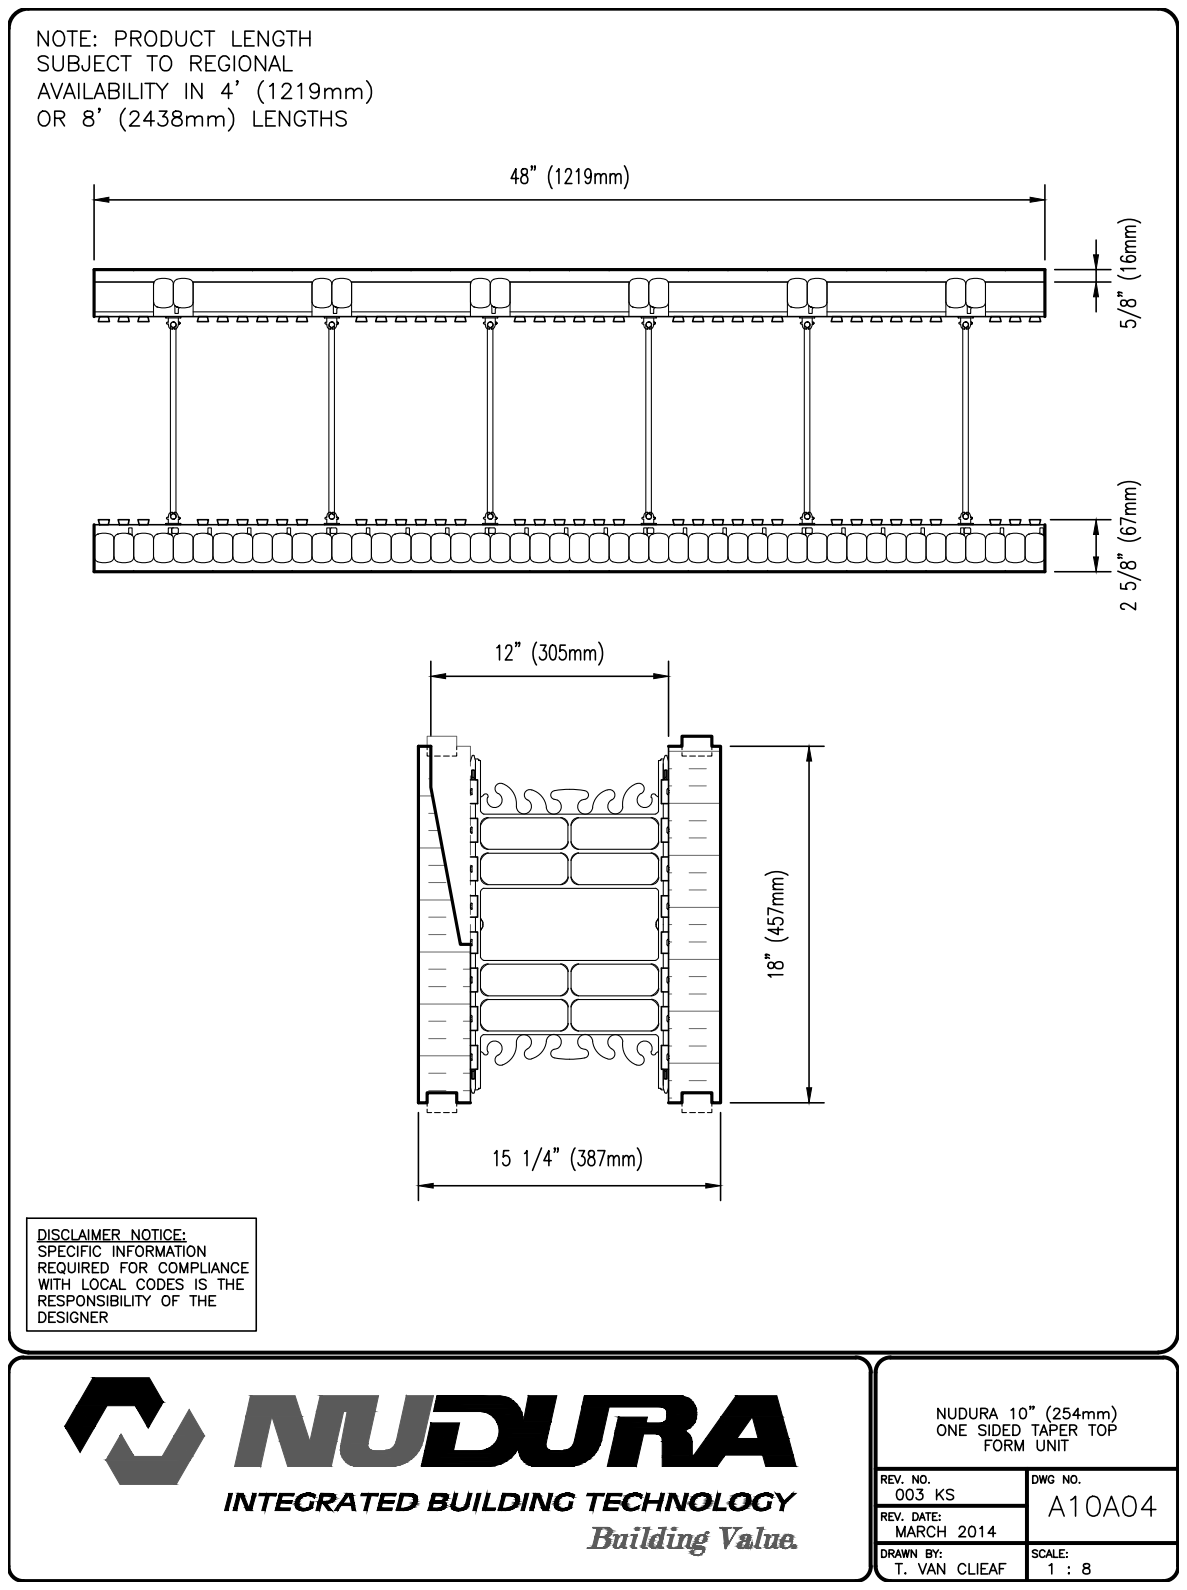
[picture p317: page 1]
