Tanvi11Ghelani/ECO_BUILD_UI/build/EcoBuildPdf/FormUnitProfiles/254mm- 10 Concrete Core Forms/Standard Form Unit A10A01.pdf

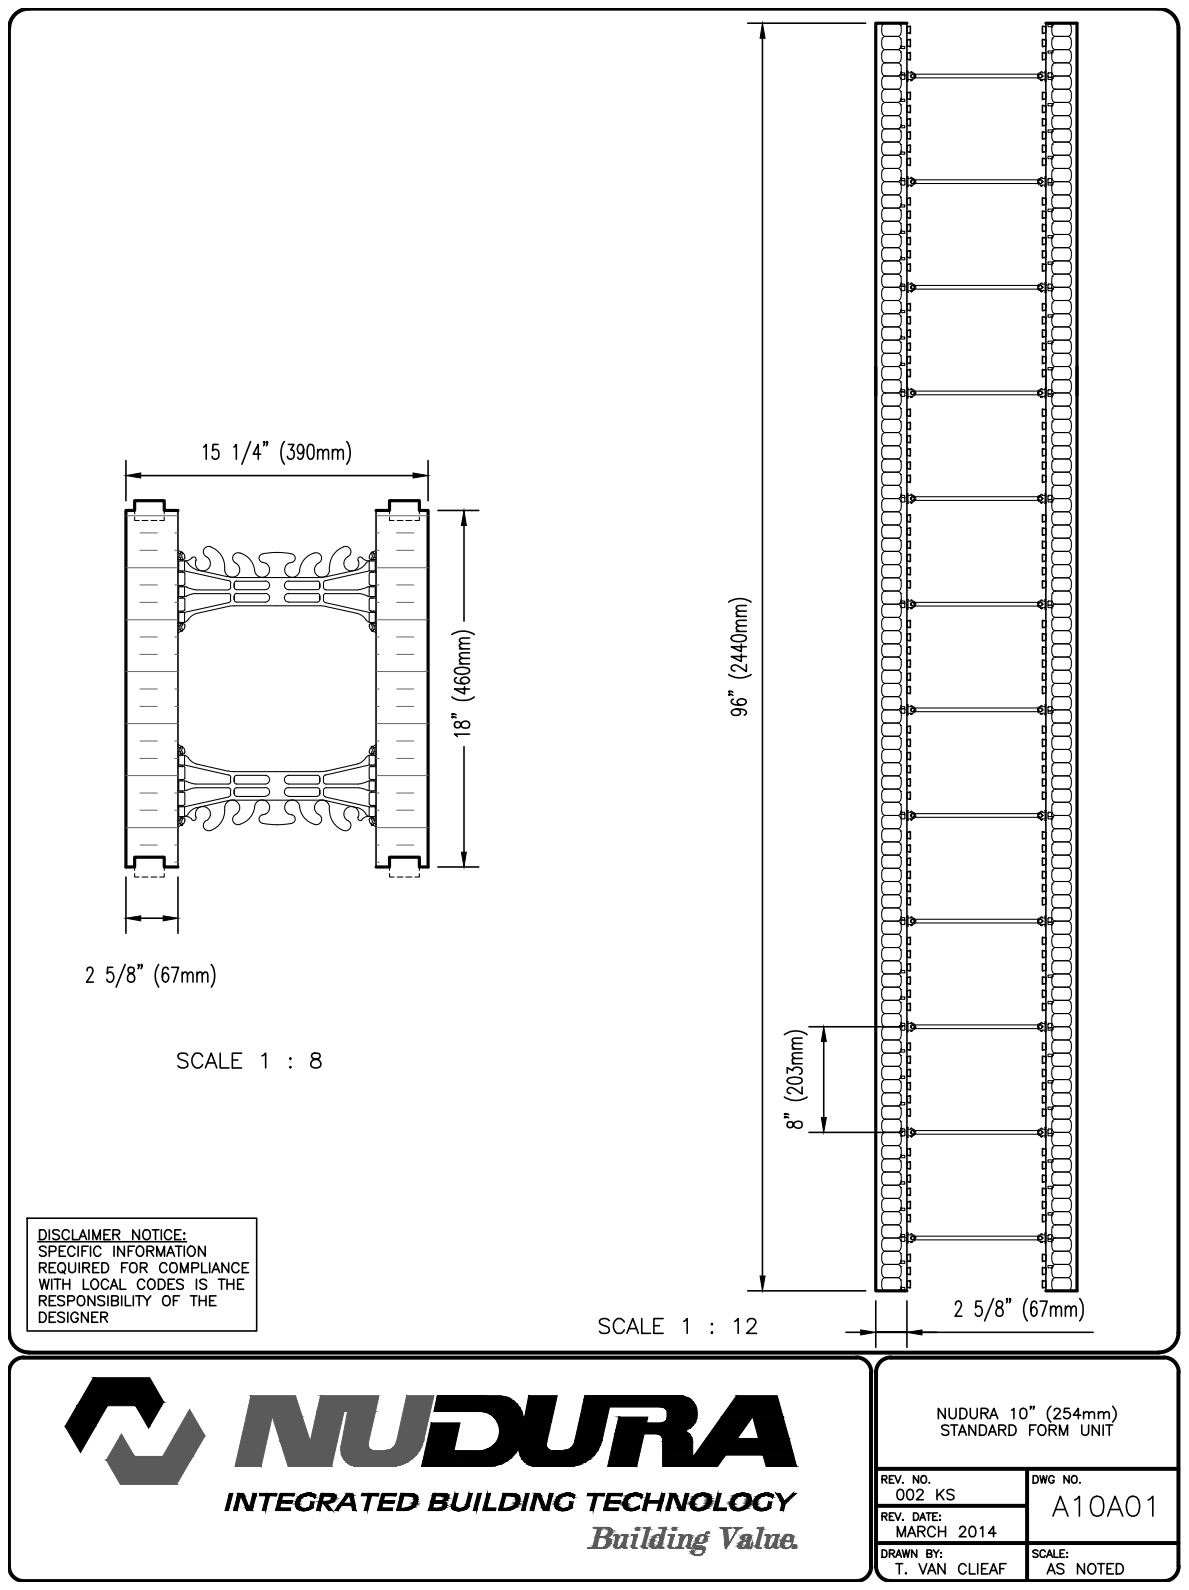
[picture p318: page 1]
