Tanvi11Ghelani/ECO_BUILD_UI/build/EcoBuildPdf/FormUnitProfiles/305mm- 12 Concrete Core Forms/45 Degree Corner Form Unit A12A03.pdf

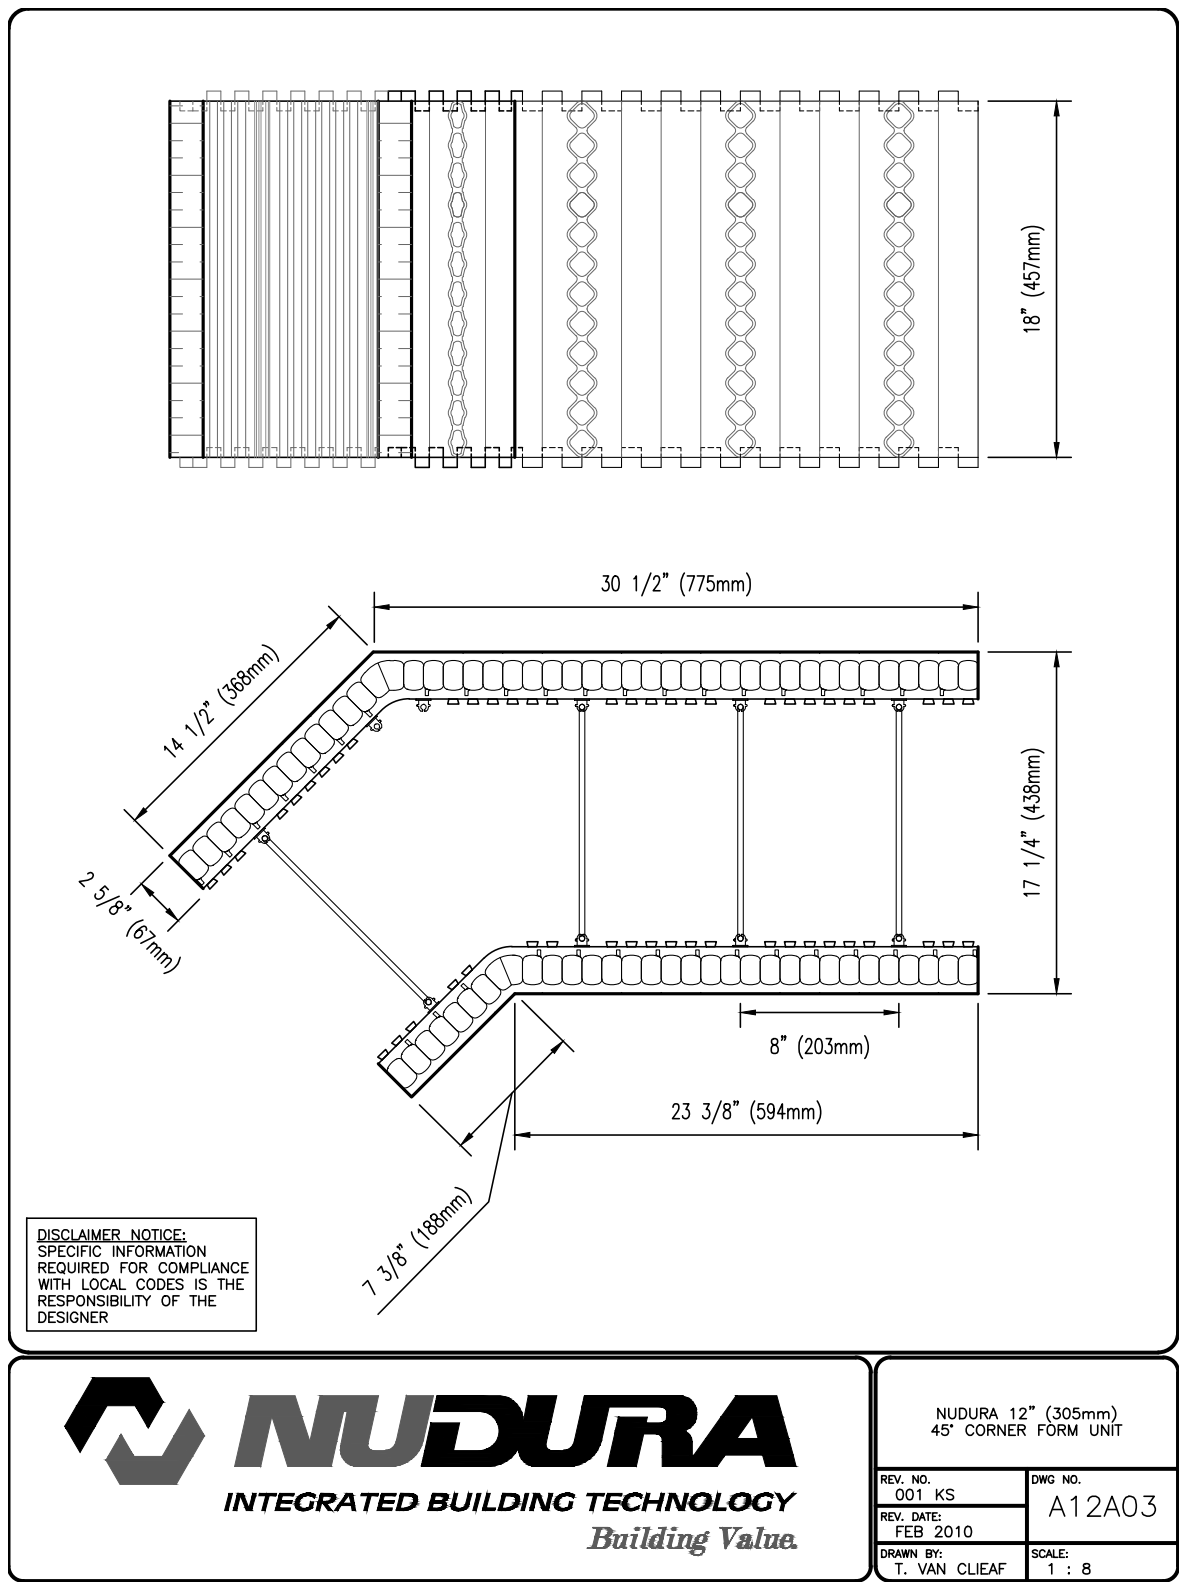
[picture p319: page 1]
