Tanvi11Ghelani/ECO_BUILD_UI/build/EcoBuildPdf/FormUnitProfiles/305mm- 12 Concrete Core Forms/90 Degree Corner Form Unit A12A02.pdf

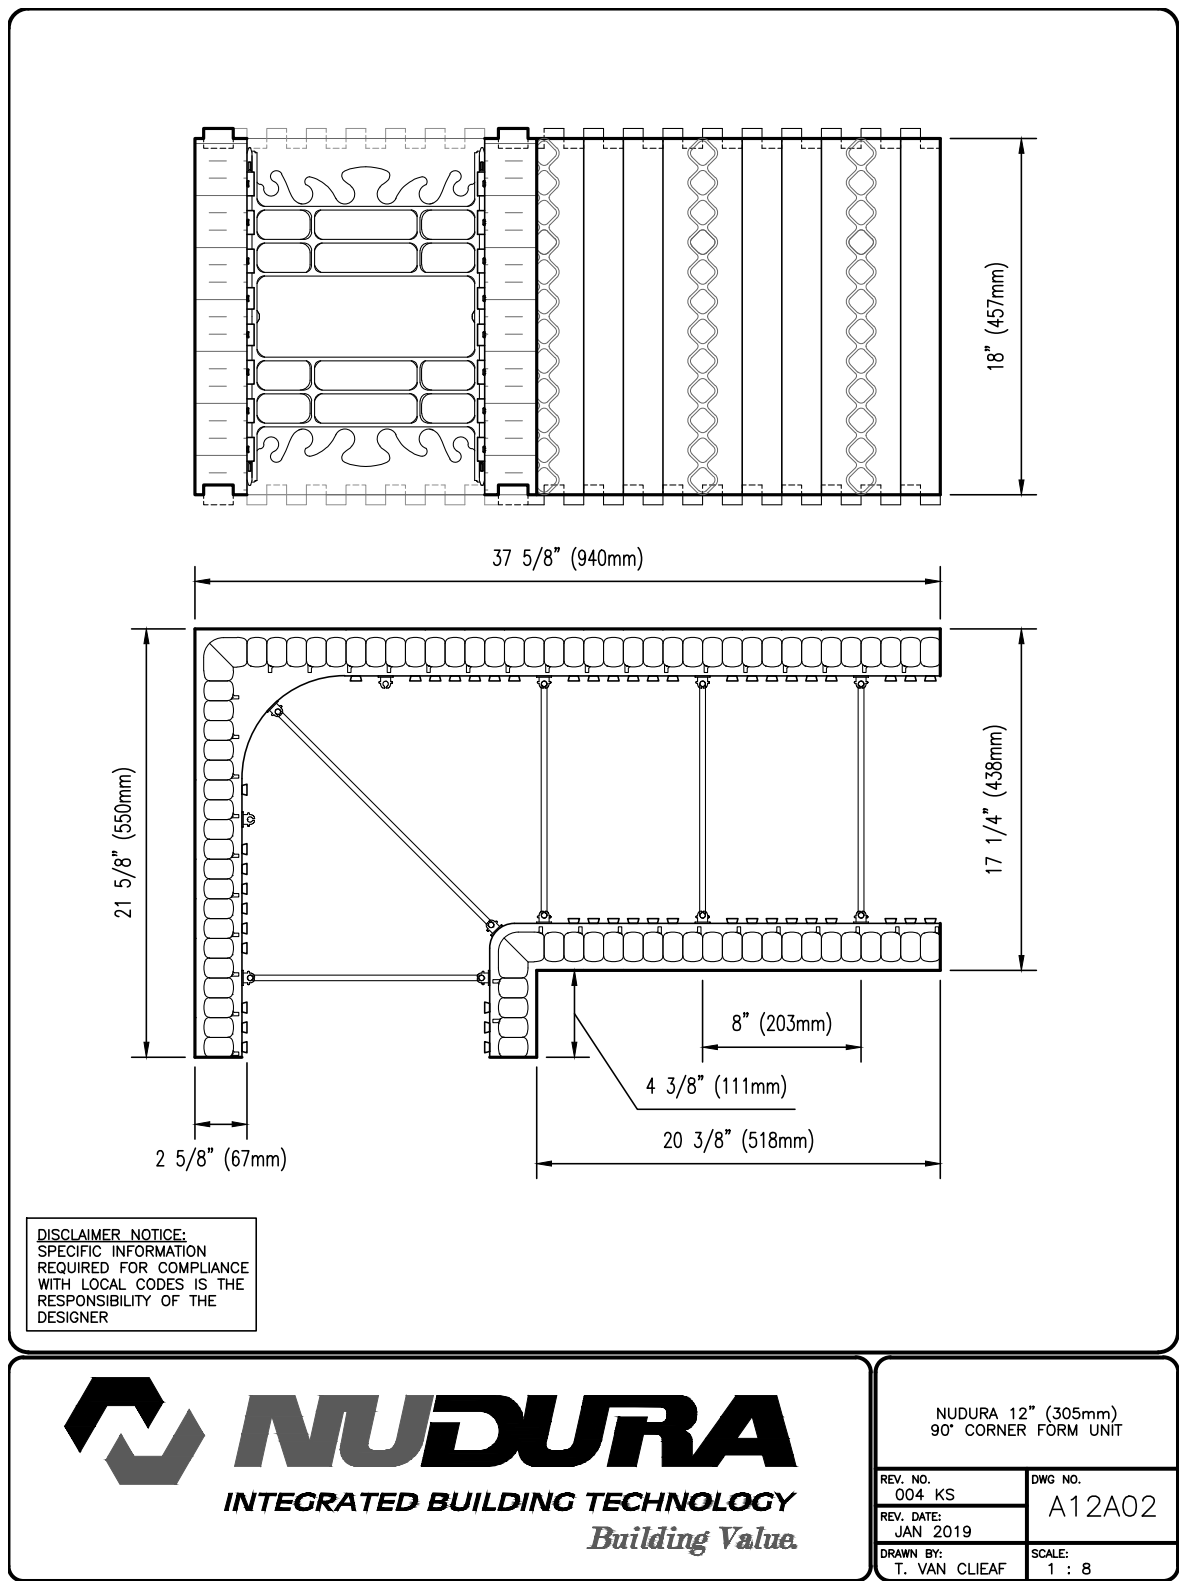
[picture p320: page 1]
