Tanvi11Ghelani/ECO_BUILD_UI/build/EcoBuildPdf/FormUnitProfiles/305mm- 12 Concrete Core Forms/Brick Ledge Form Unit A12A06.pdf

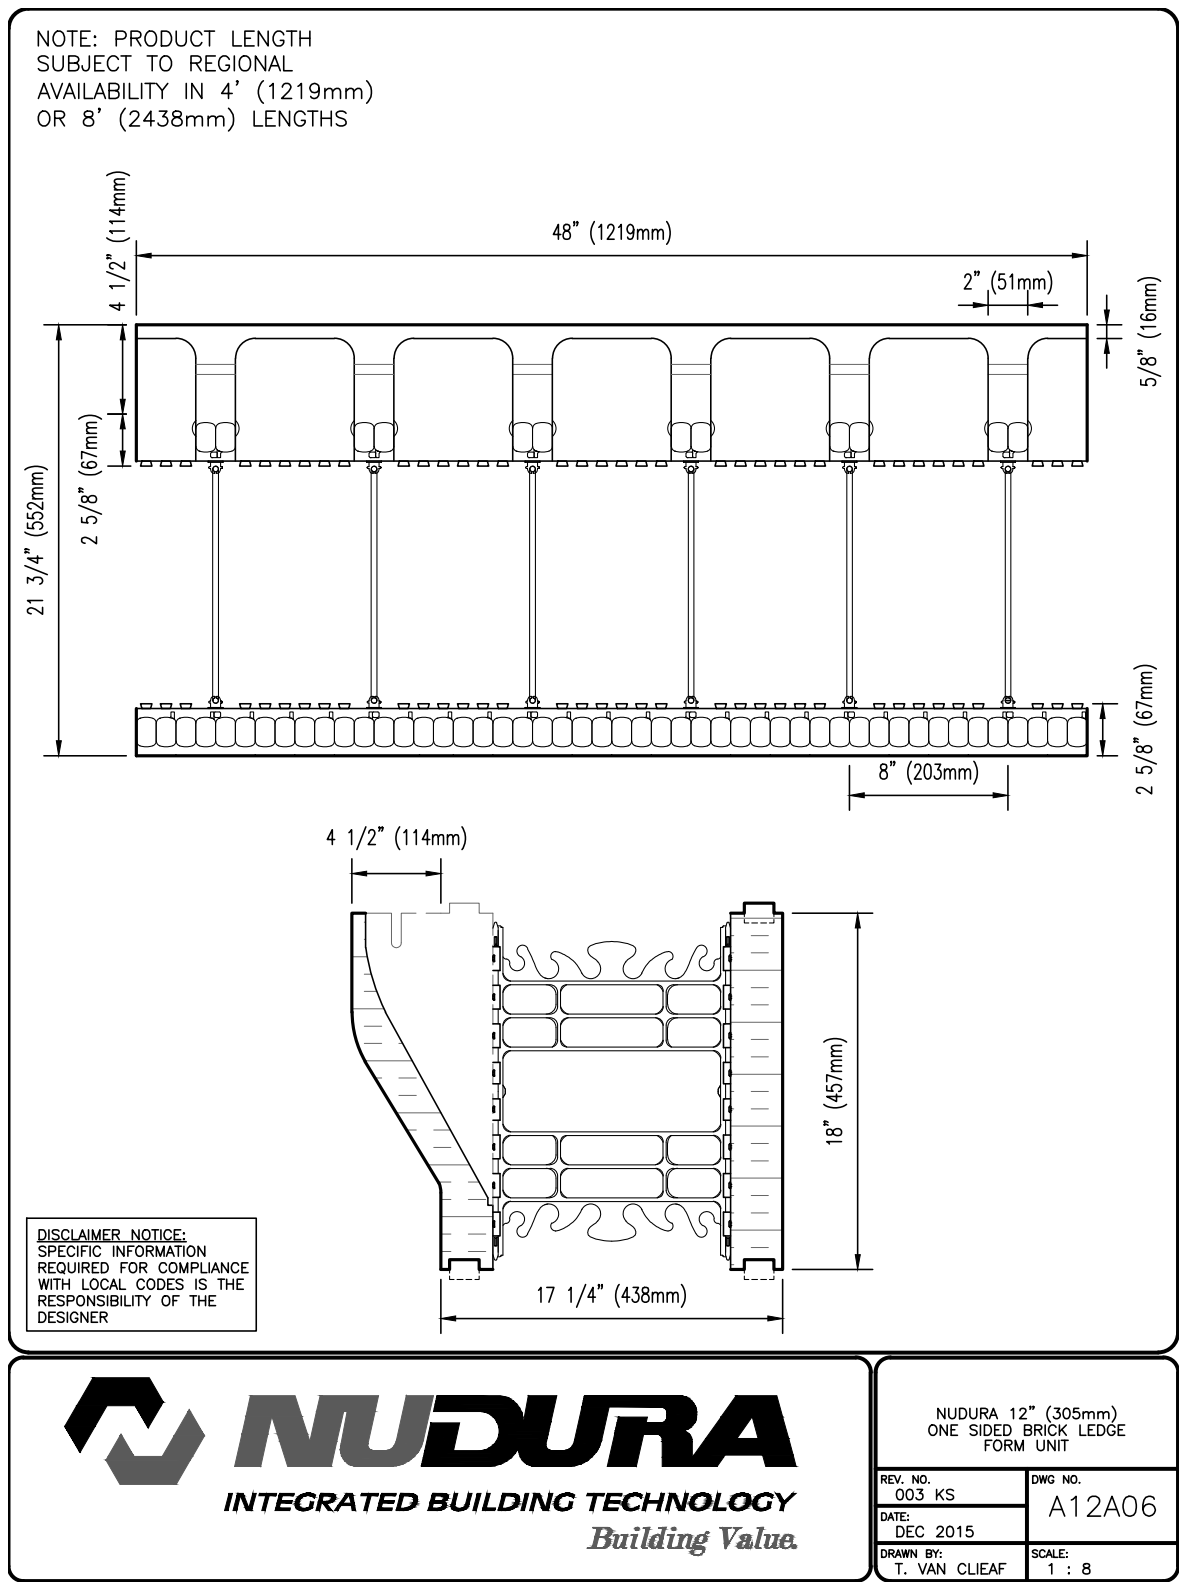
[picture p321: page 1]
