Tanvi11Ghelani/ECO_BUILD_UI/build/EcoBuildPdf/FormUnitProfiles/305mm- 12 Concrete Core Forms/Double Sided Taper Top Form Unit A12A05.pdf

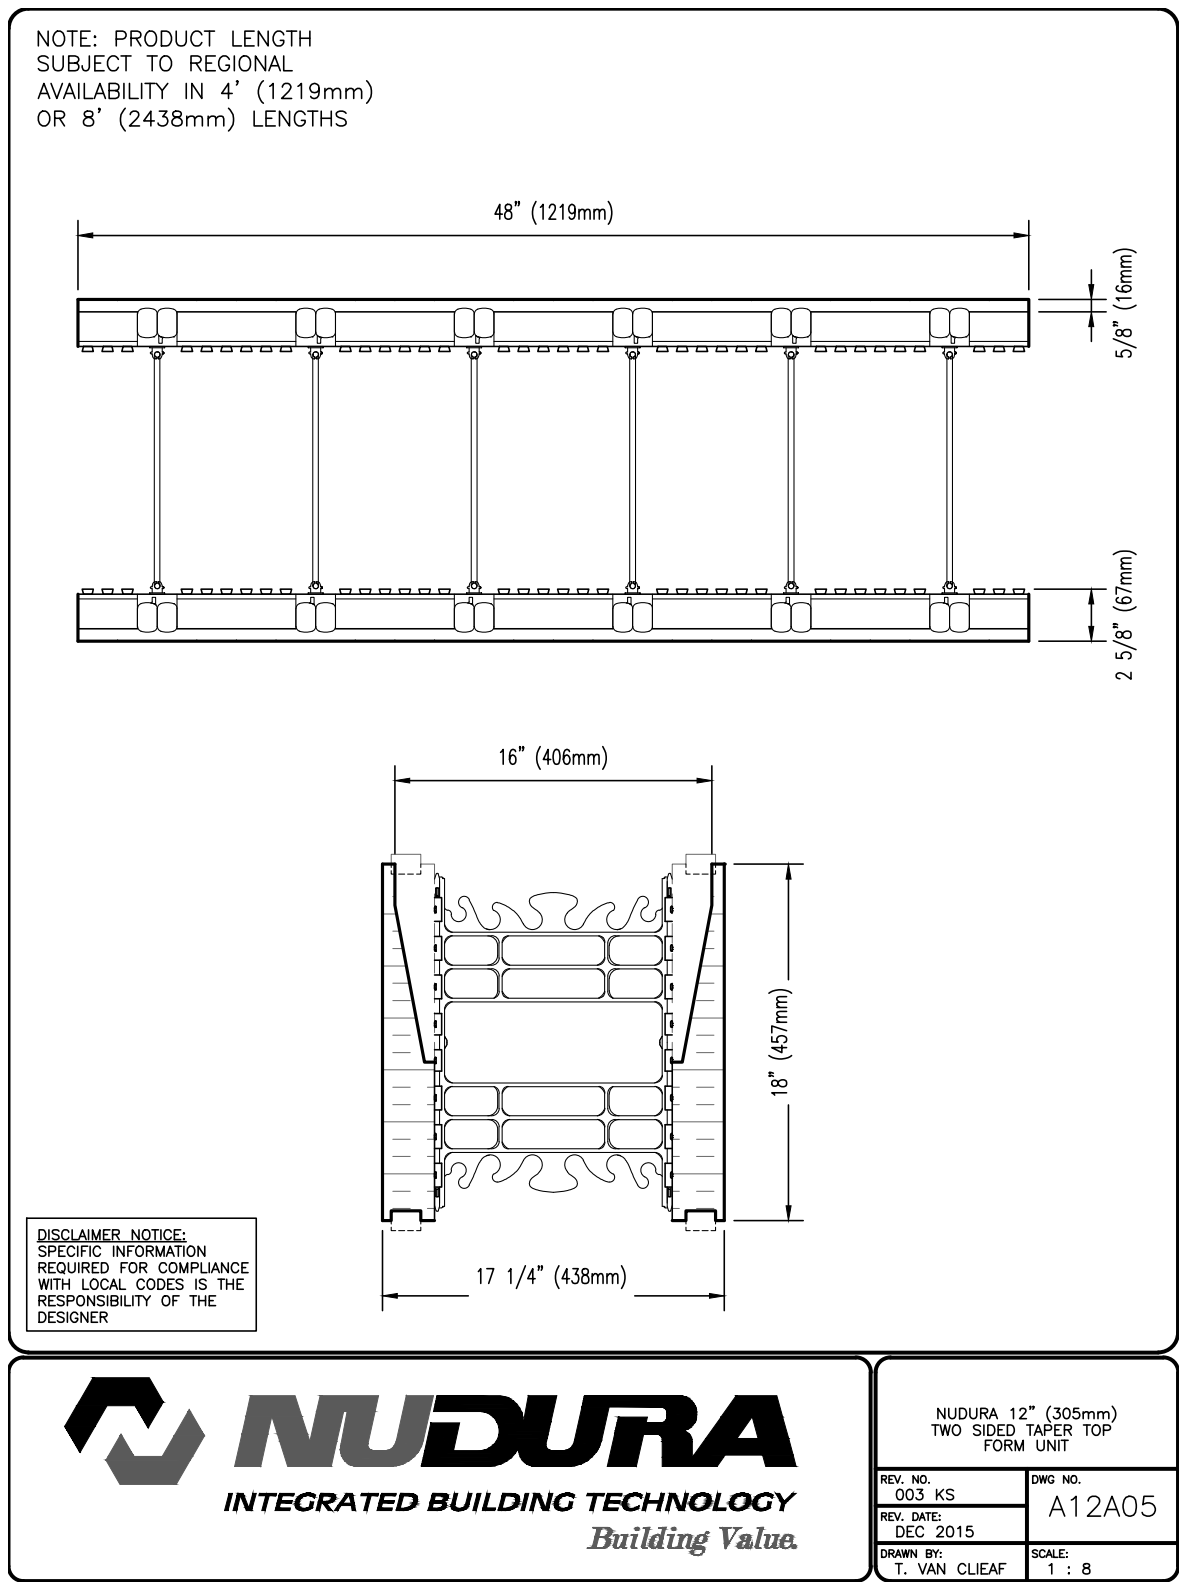
[picture p322: page 1]
