Tanvi11Ghelani/ECO_BUILD_UI/build/EcoBuildPdf/FormUnitProfiles/305mm- 12 Concrete Core Forms/End Cap and Height Adjuster A12A08.pdf

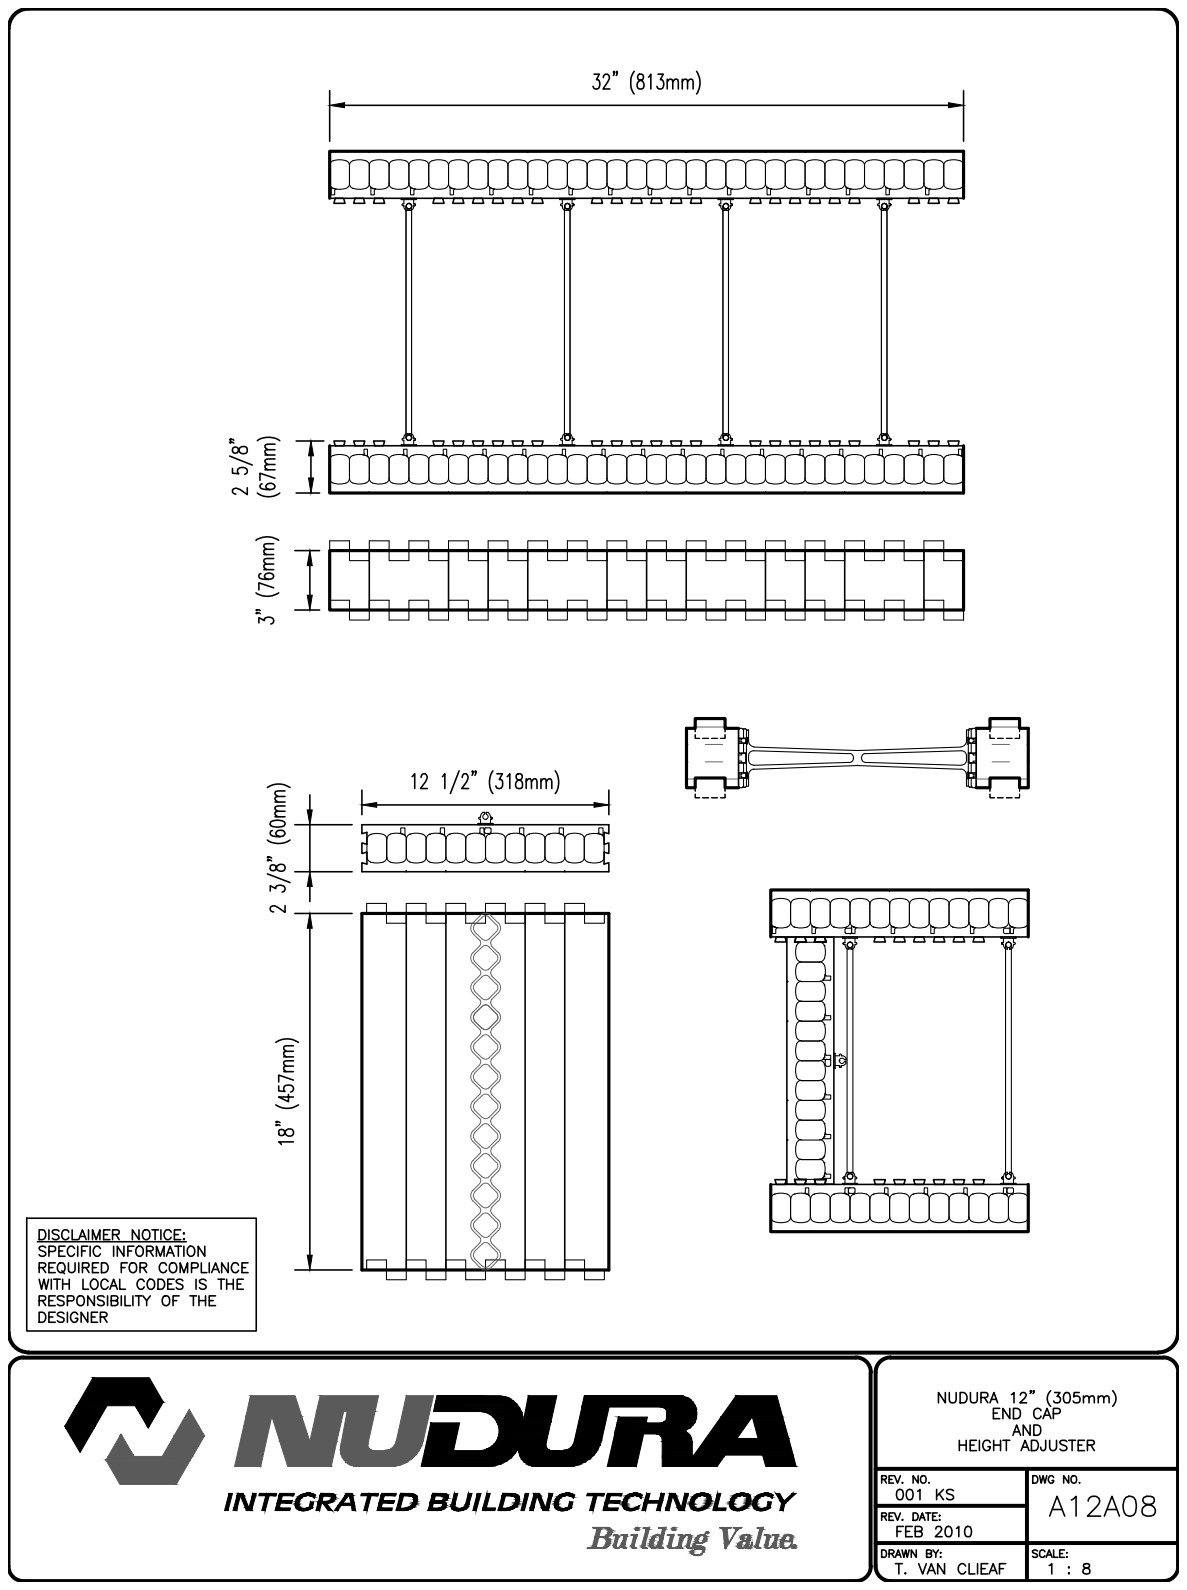
[picture p323: page 1]
