Tanvi11Ghelani/ECO_BUILD_UI/build/EcoBuildPdf/FormUnitProfiles/305mm- 12 Concrete Core Forms/Single Sided Taper Top Form Unit A12A04.pdf

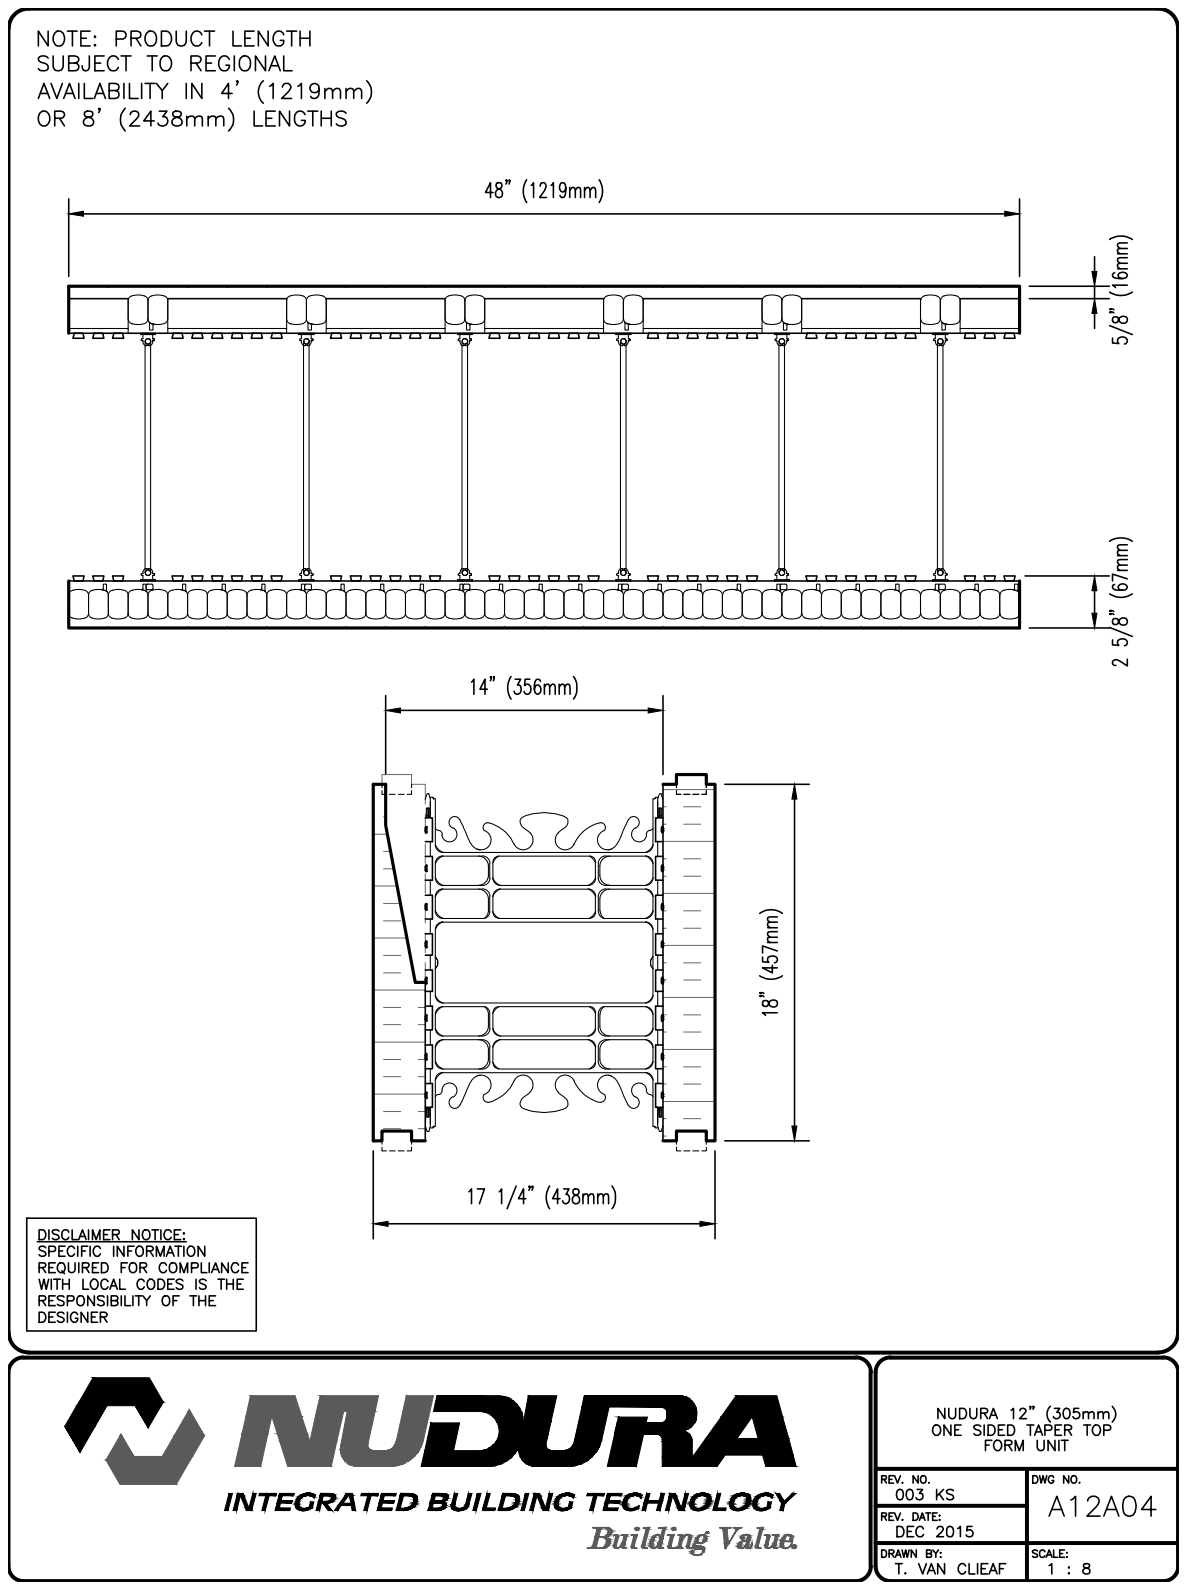
[picture p324: page 1]
