Tanvi11Ghelani/ECO_BUILD_UI/build/EcoBuildPdf/FormUnitProfiles/305mm- 12 Concrete Core Forms/Standard Form Unit A12A01.pdf

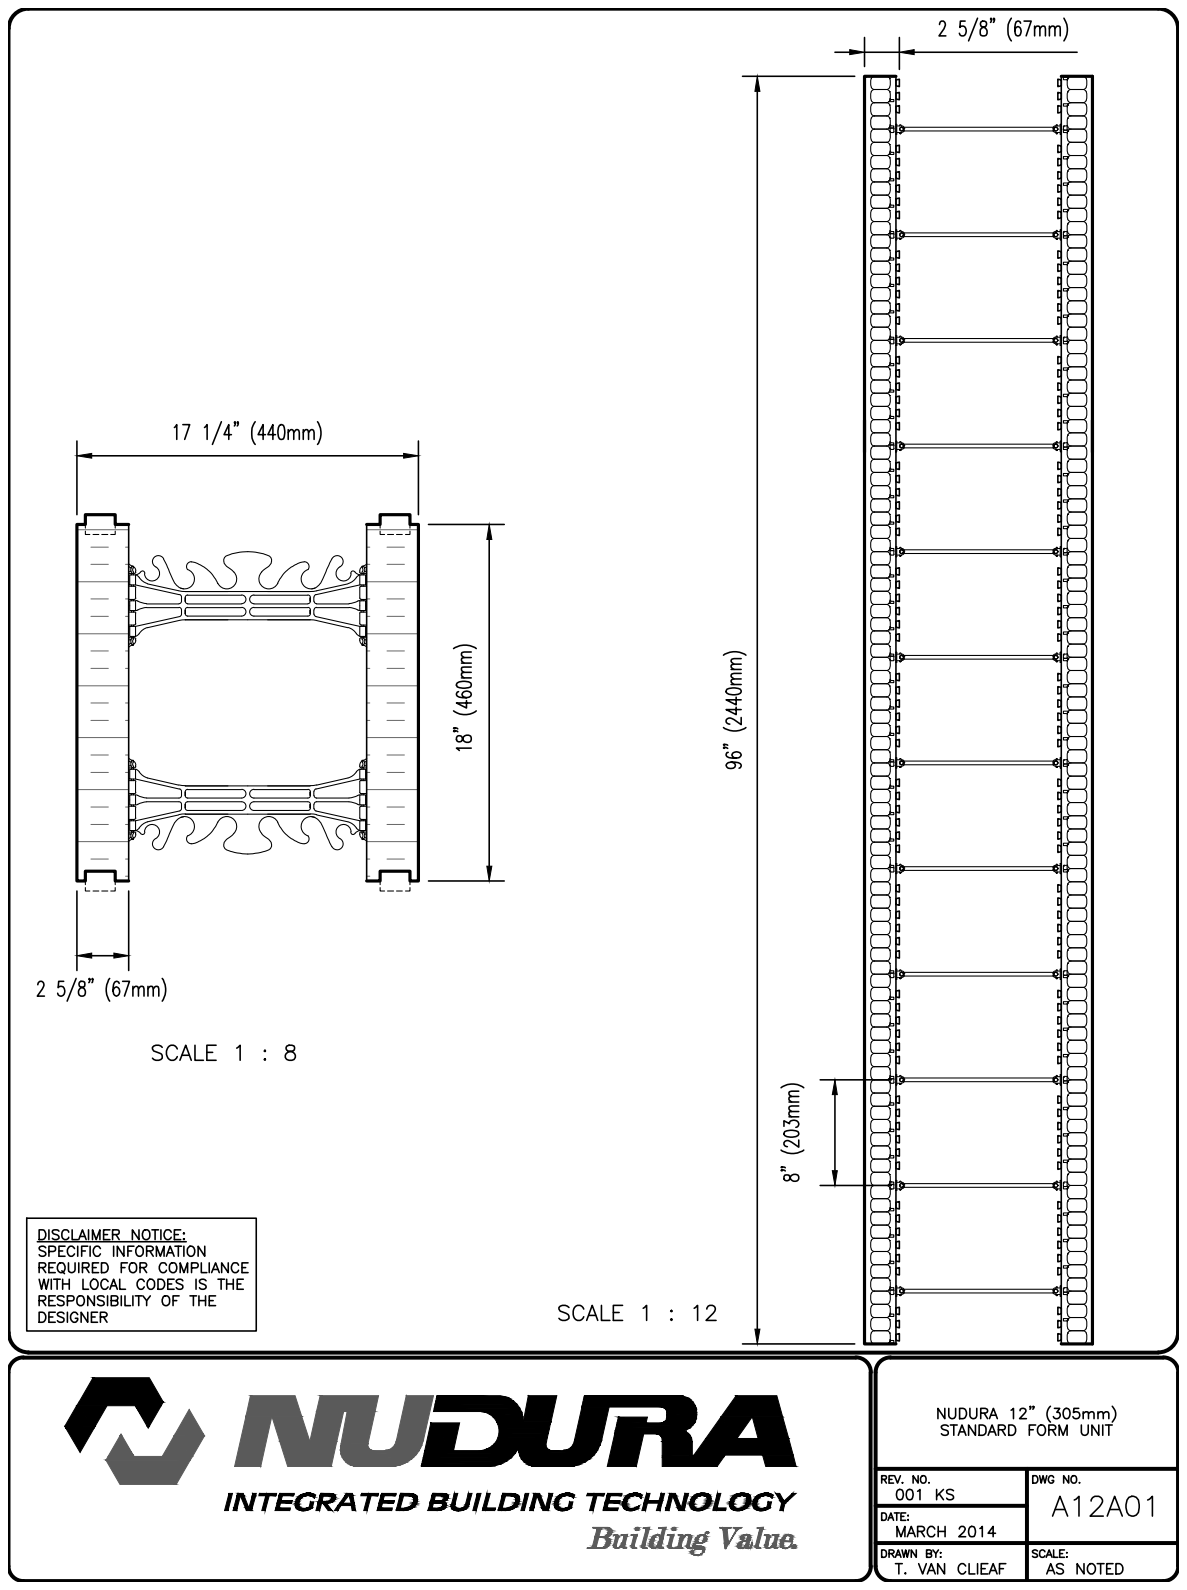
[picture p325: page 1]
