Tanvi11Ghelani/ECO_BUILD_UI/build/EcoBuildPdf/FormUnitProfiles/8 (203mm) XR35 Concrete Core Forms/90 Degree Corner Form Unit XR8A02.pdf

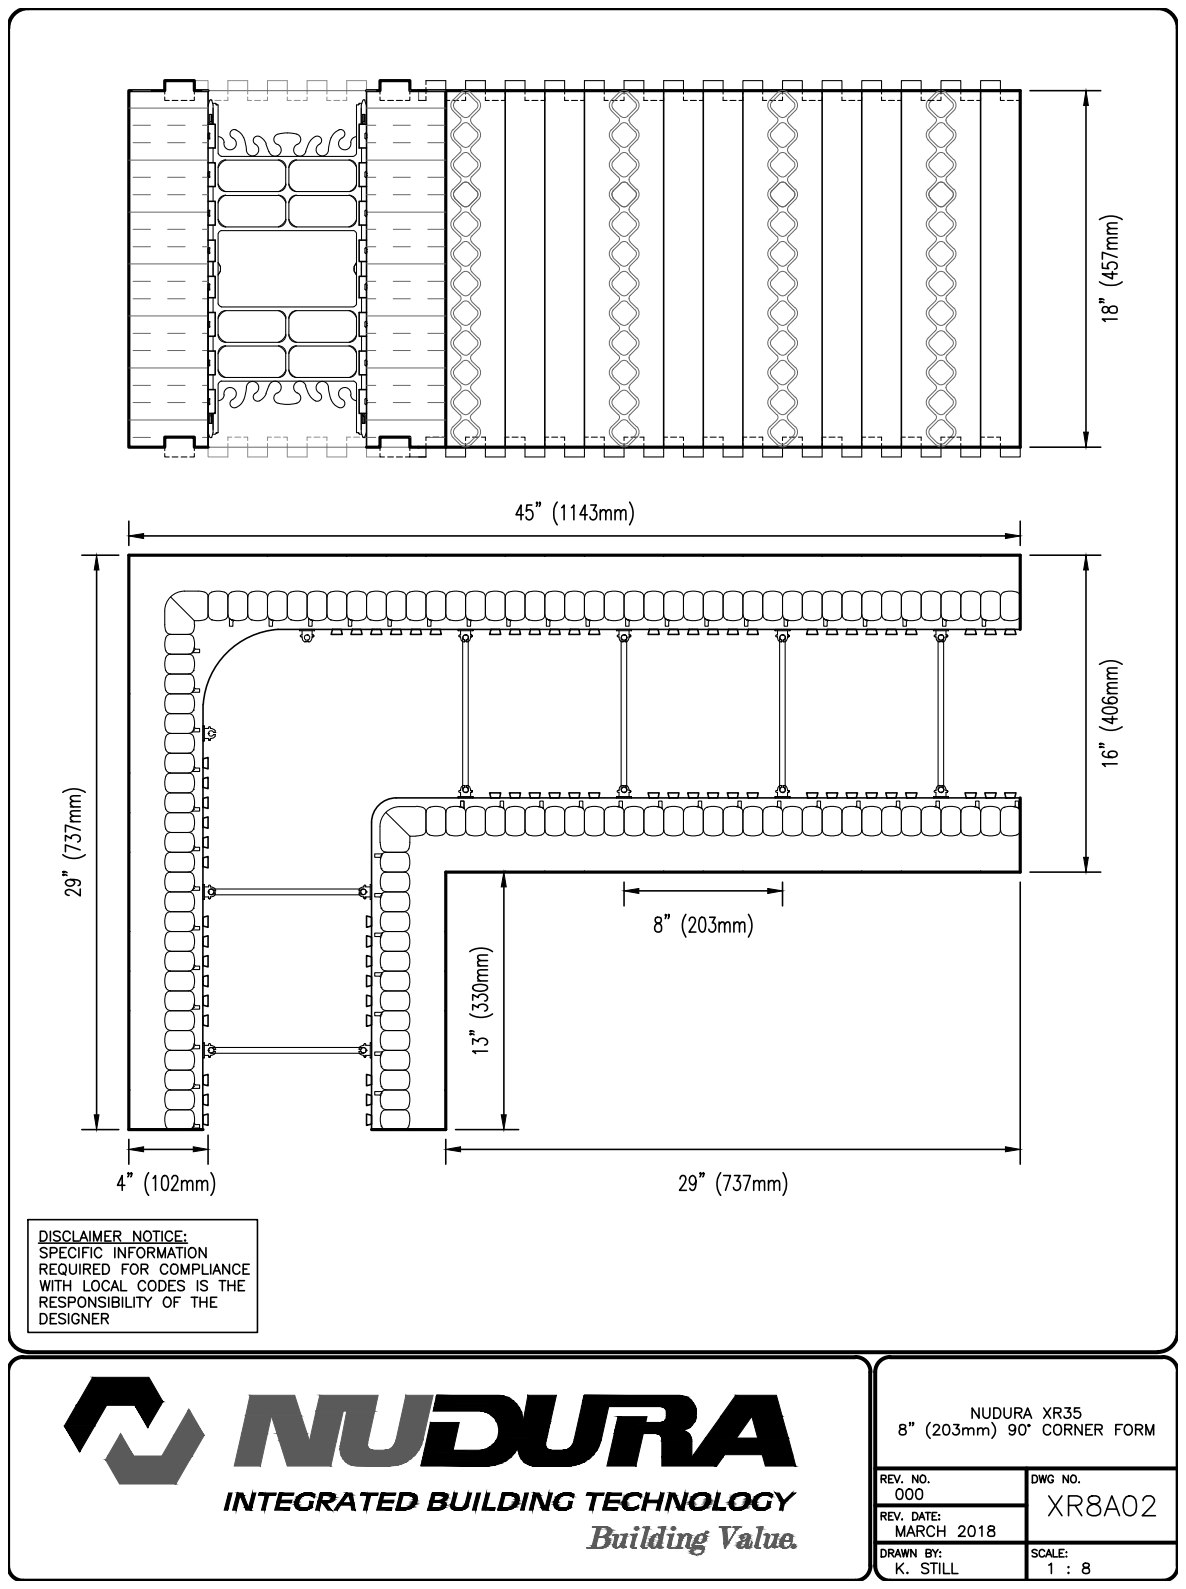
[picture p326: page 1]
