Tanvi11Ghelani/ECO_BUILD_UI/build/EcoBuildPdf/FormUnitProfiles/8 (203mm) XR35 Concrete Core Forms/Standard Form Unit XR8A01.pdf

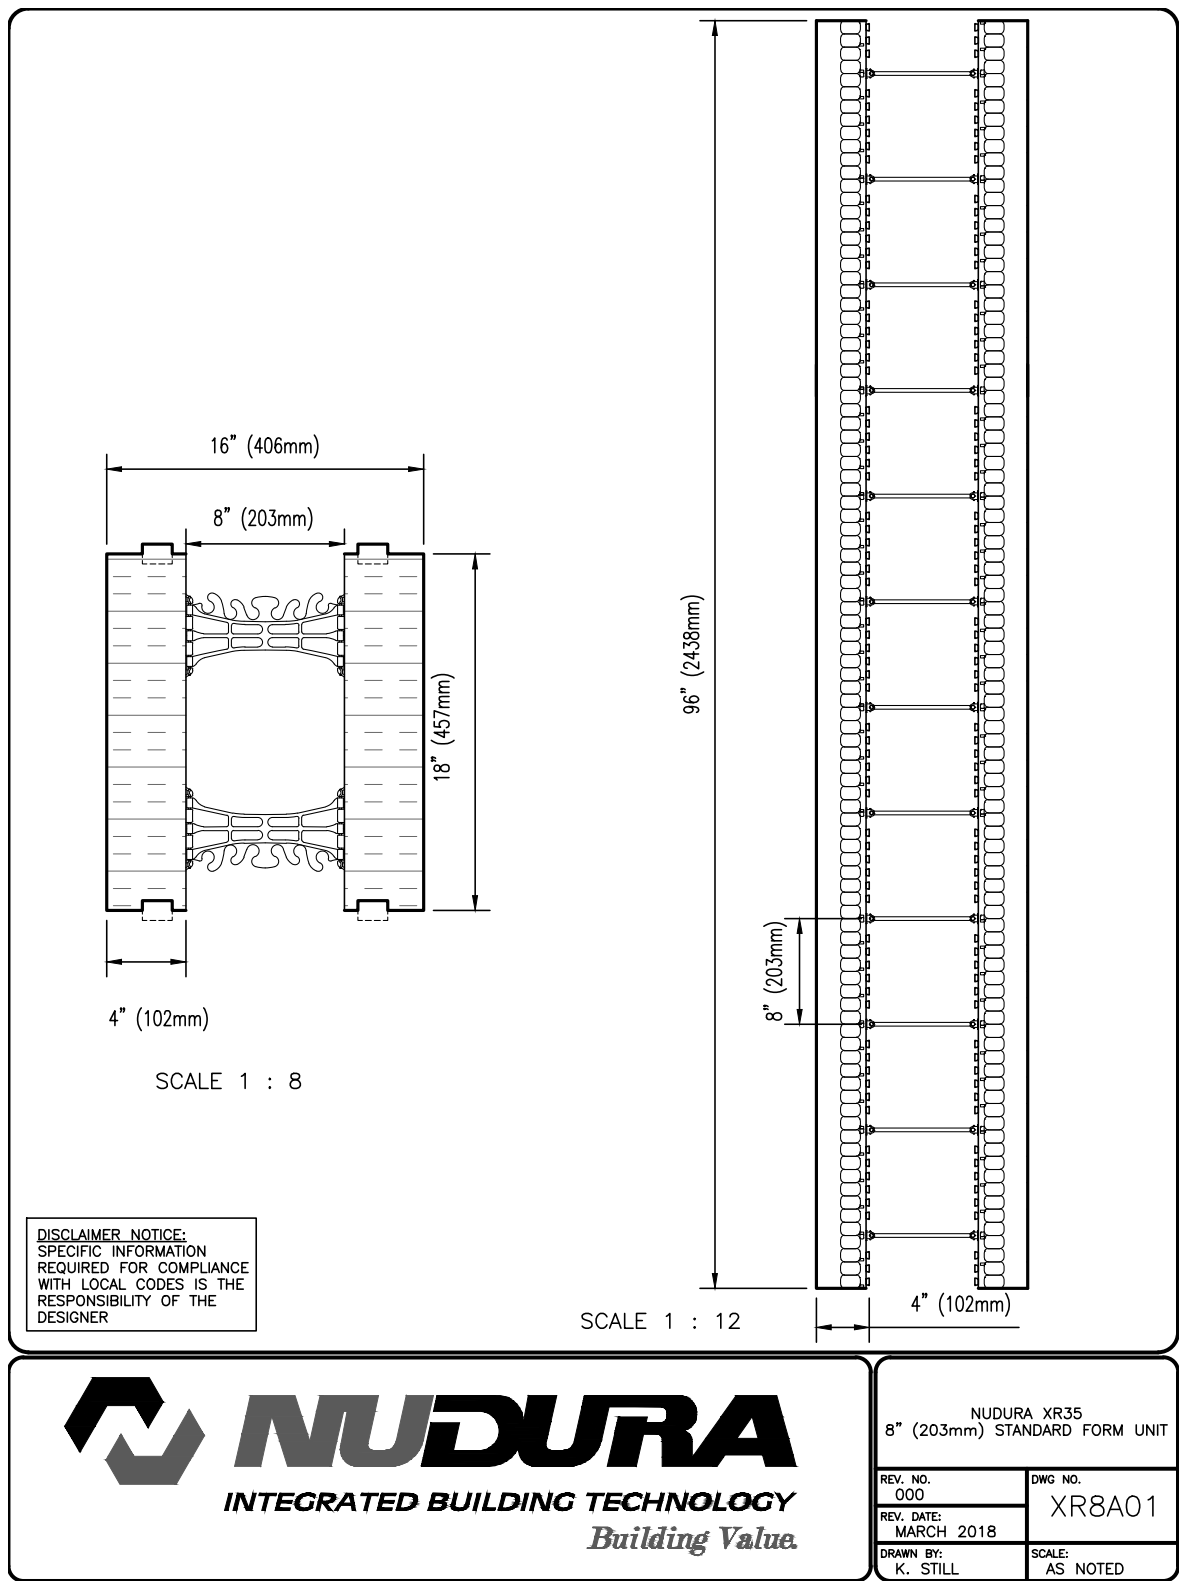
[picture p327: page 1]
