Tanvi11Ghelani/ECO_BUILD_UI/build/EcoBuildPdf/FormUnitProfiles/Concrete core mold 102 mm/45 Degree Corner Form Unit A4A03.pdf

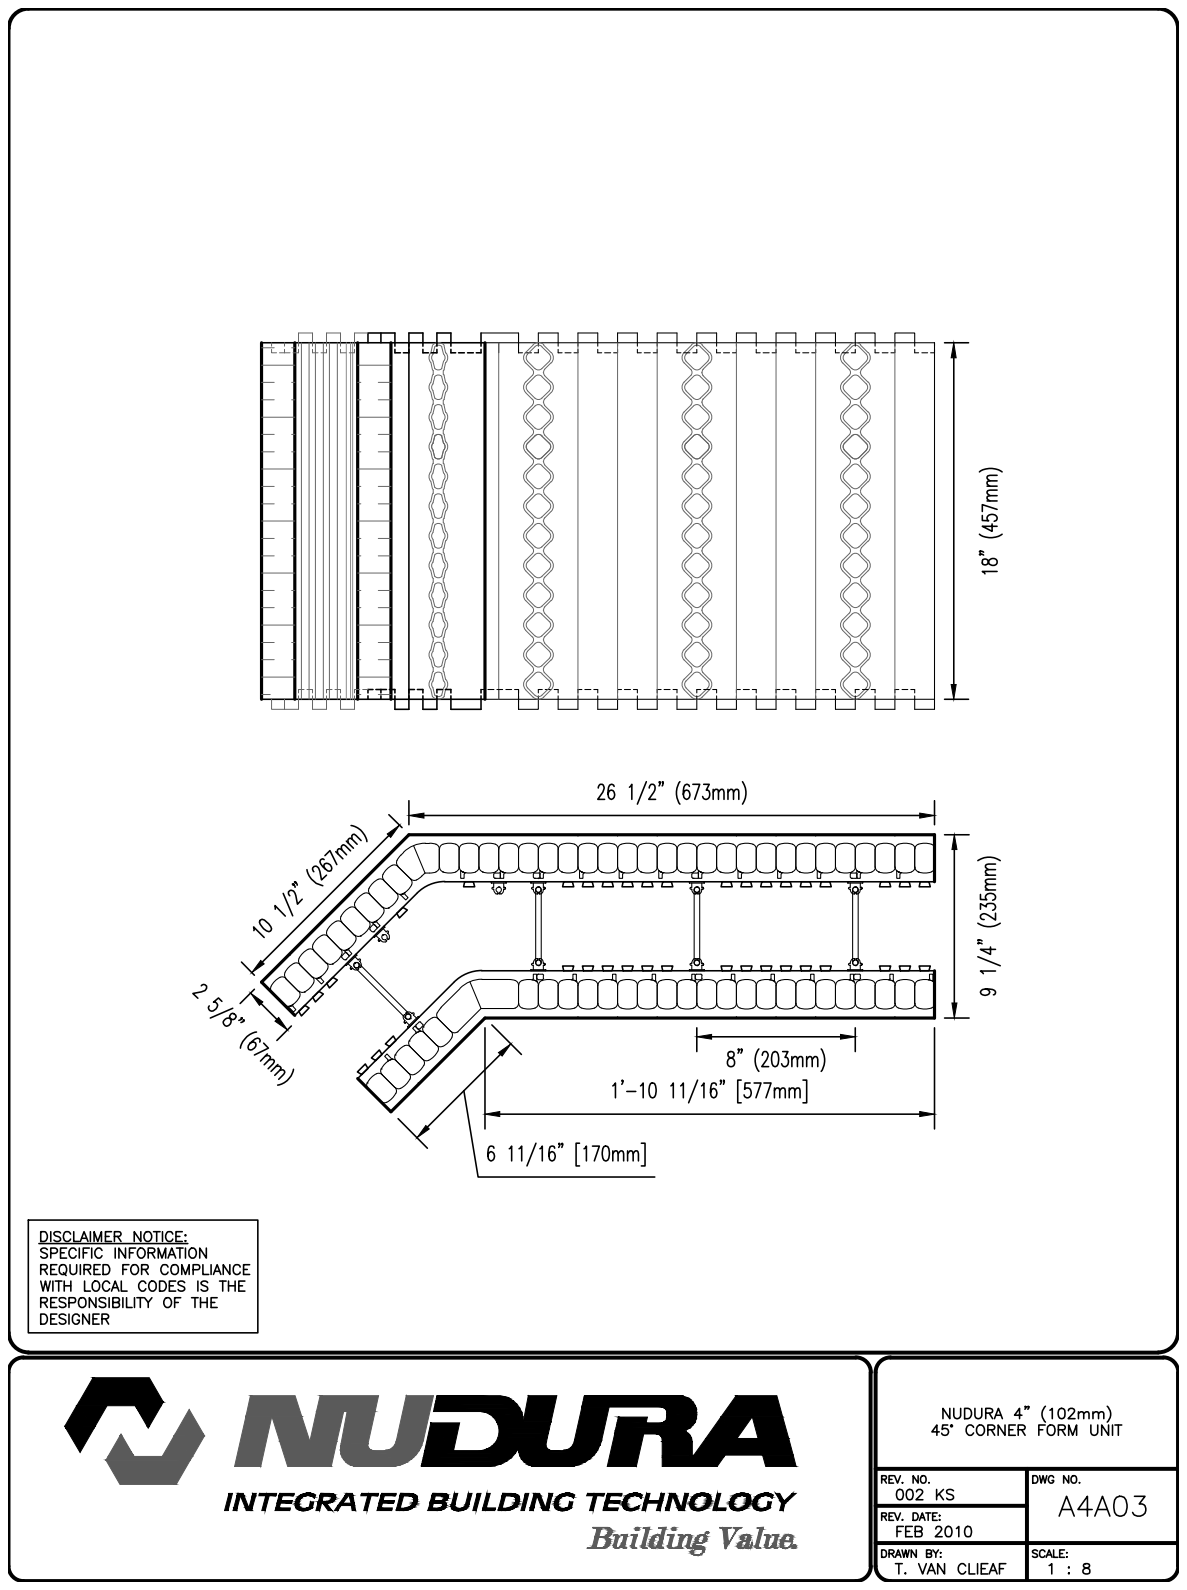
[picture p328: page 1]
