Tanvi11Ghelani/ECO_BUILD_UI/build/EcoBuildPdf/FormUnitProfiles/Concrete core mold 102 mm/90 Degree Corner Form Unit A4A02.pdf

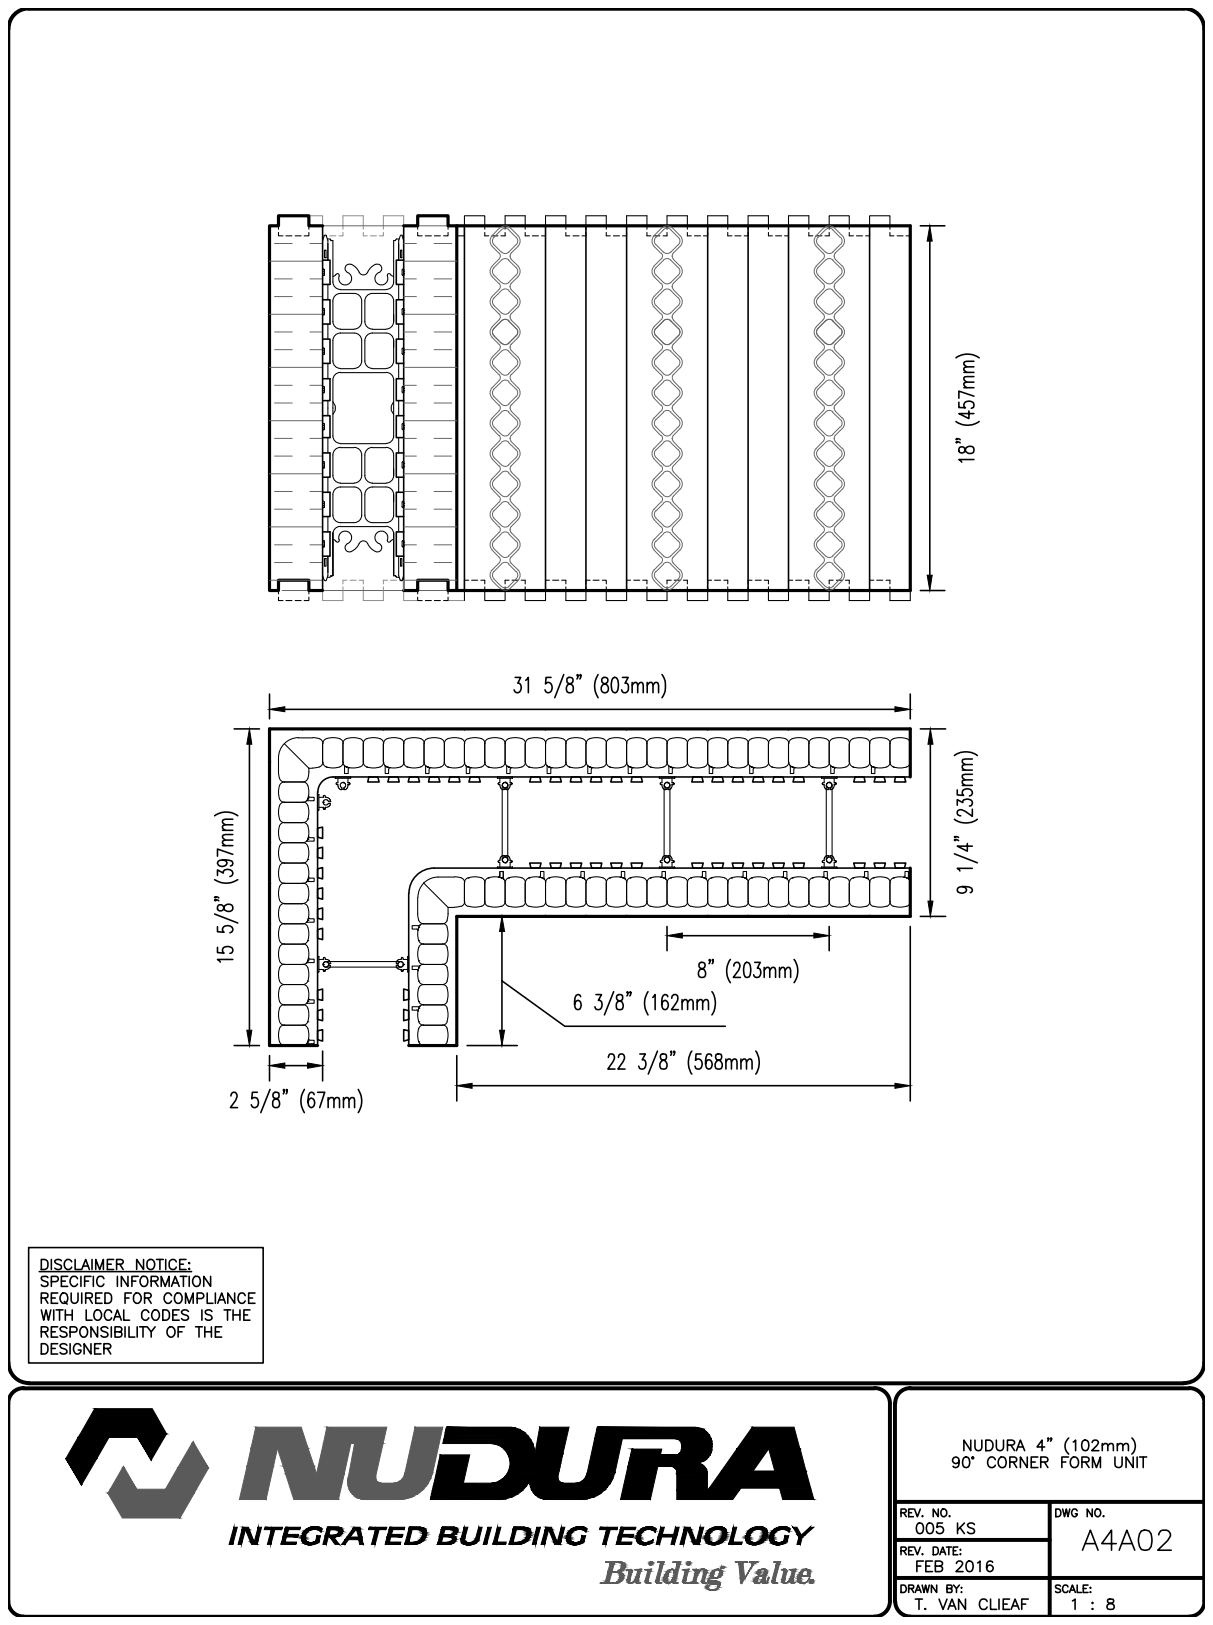
[picture p329: page 1]
