Tanvi11Ghelani/ECO_BUILD_UI/build/EcoBuildPdf/FormUnitProfiles/Concrete core mold 102 mm/Brick Ledge Form Unit A4A06.pdf

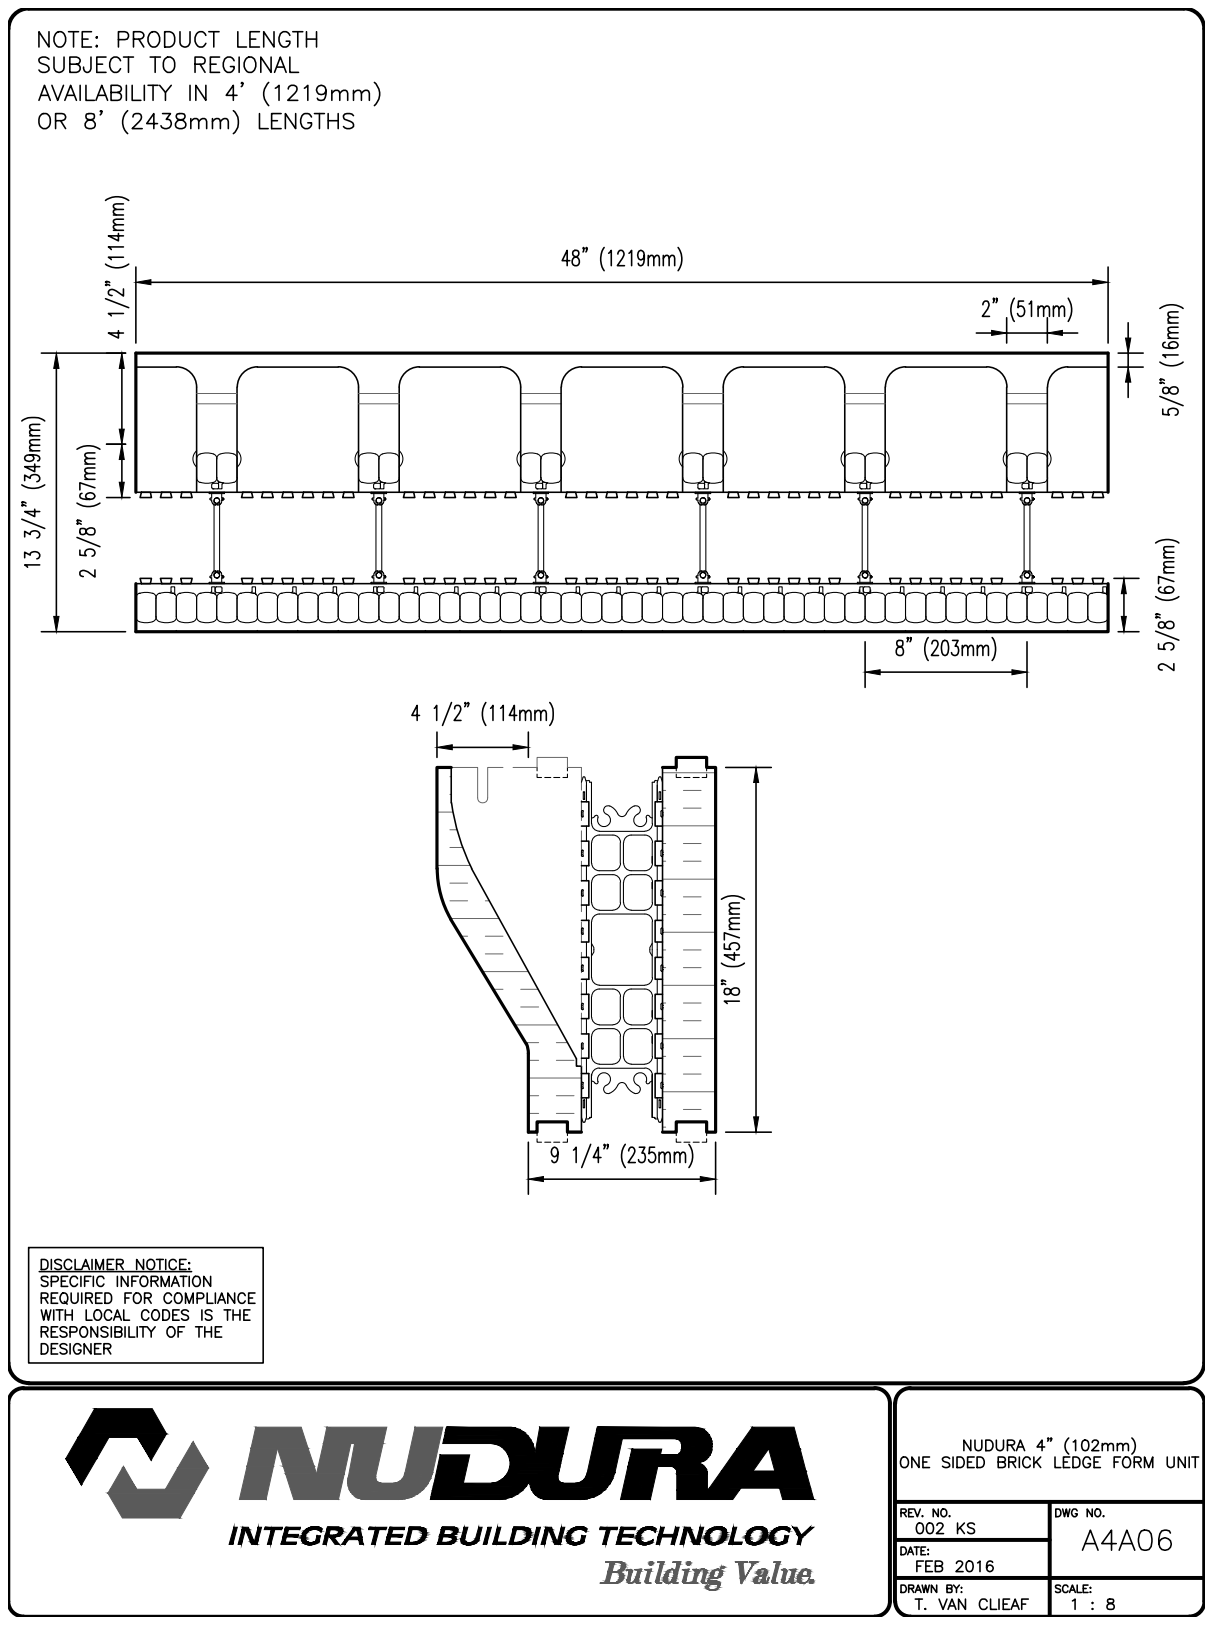
[picture p330: page 1]
