Tanvi11Ghelani/ECO_BUILD_UI/build/EcoBuildPdf/FormUnitProfiles/Concrete core mold 102 mm/Double Sided Taper Top Form Unit A4A05.pdf

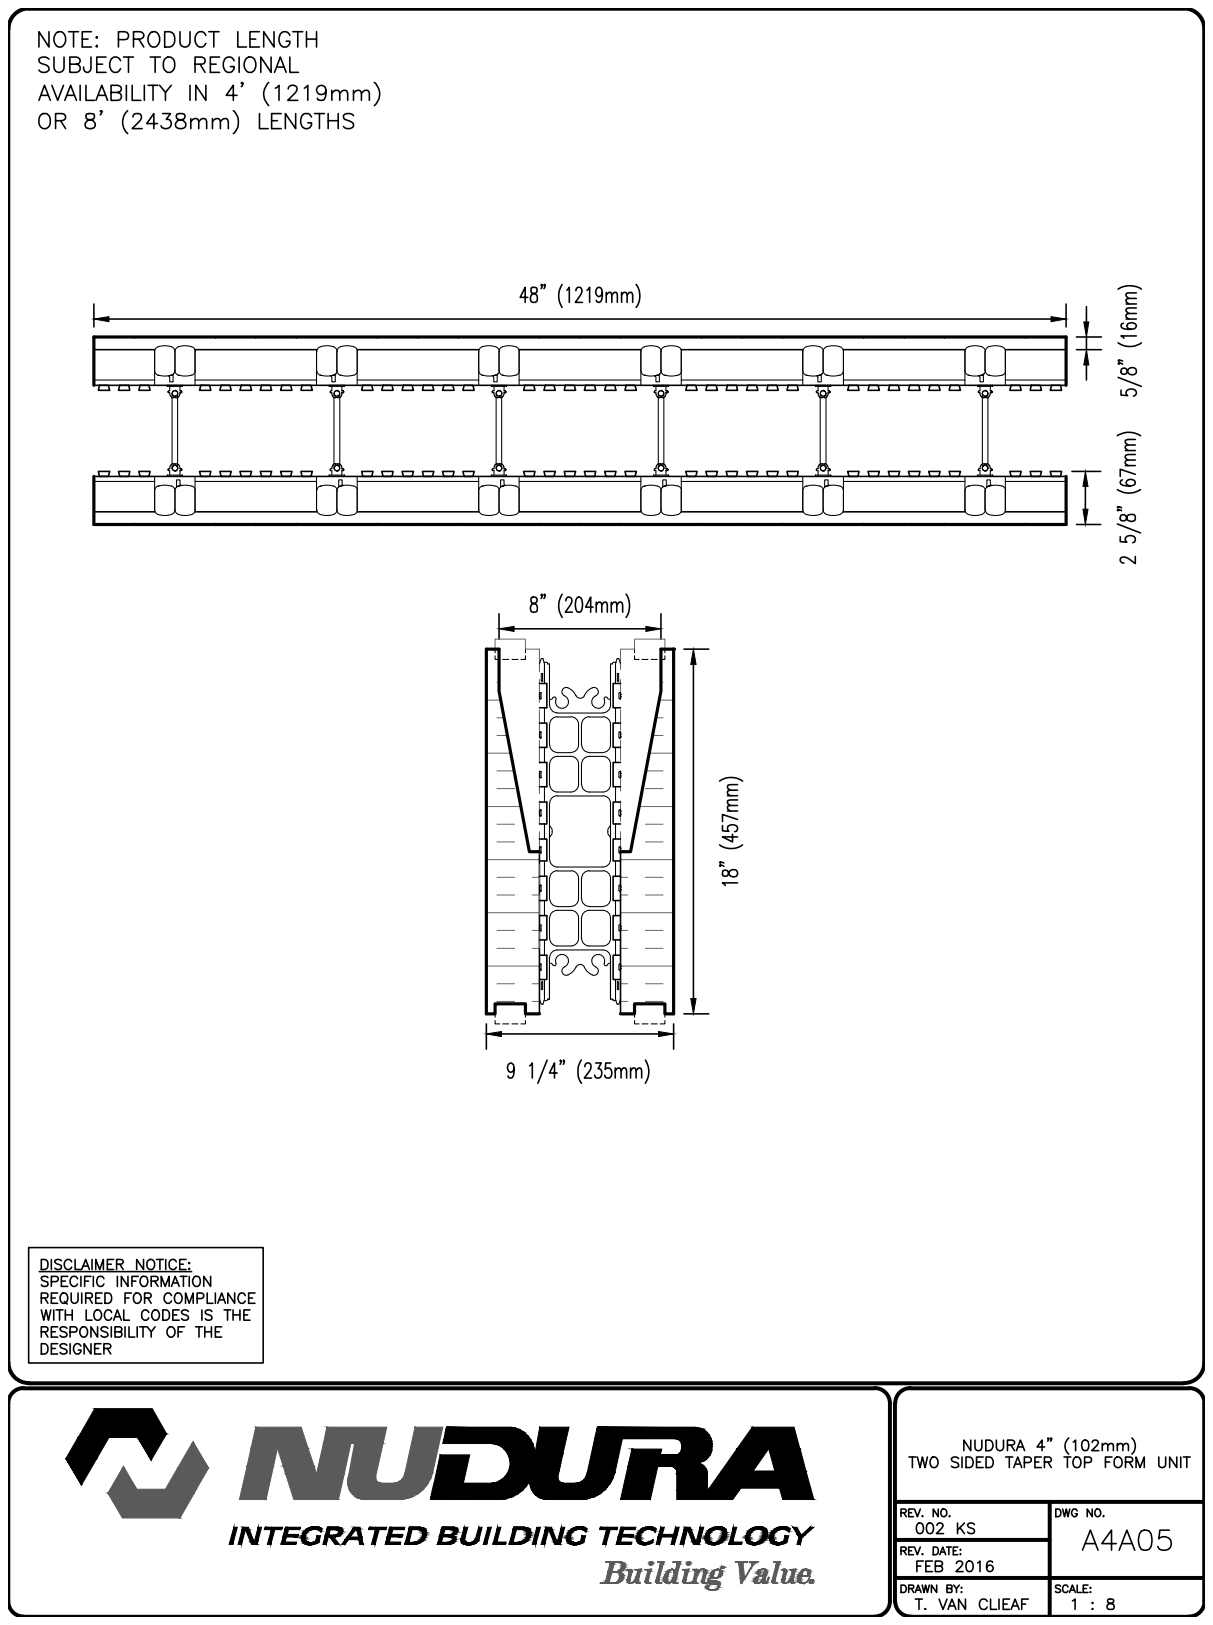
[picture p331: page 1]
