Tanvi11Ghelani/ECO_BUILD_UI/build/EcoBuildPdf/FormUnitProfiles/Concrete core mold 102 mm/End Cap and Height Adjuster A4A08.pdf

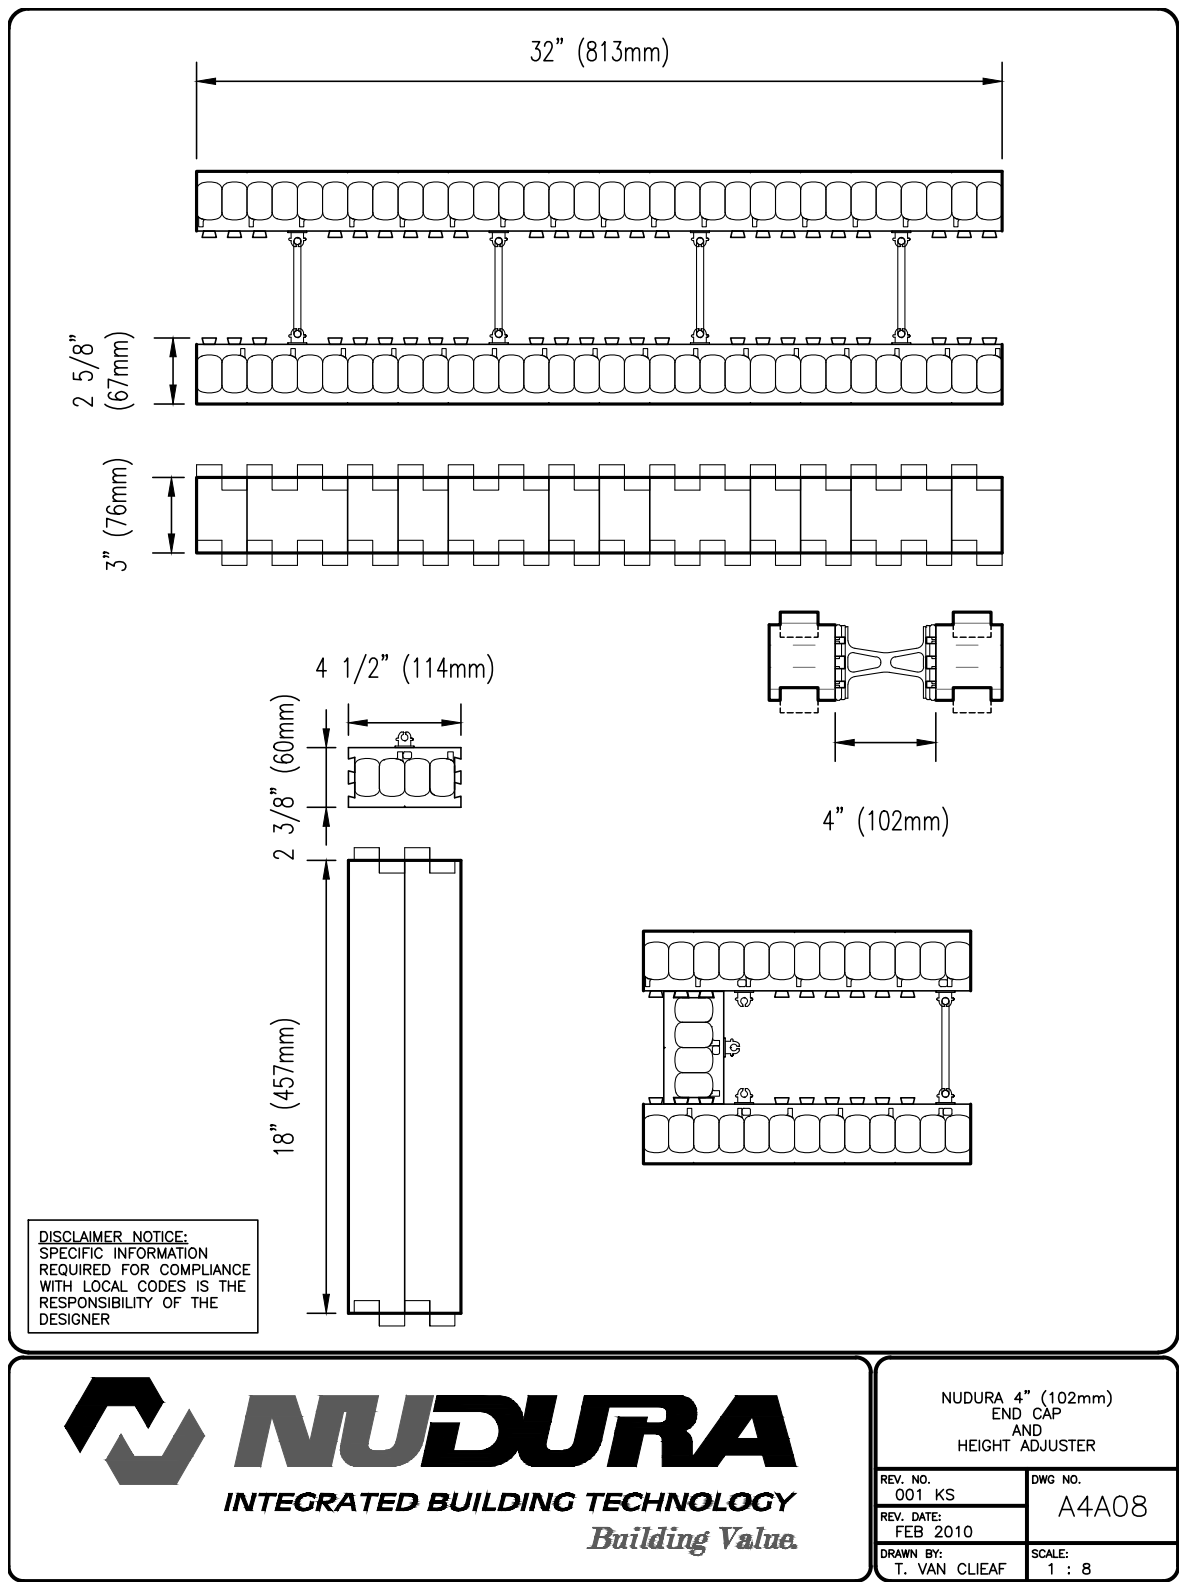
[picture p332: page 1]
