Tanvi11Ghelani/ECO_BUILD_UI/build/EcoBuildPdf/FormUnitProfiles/Concrete core mold 102 mm/Single Sided Taper Top Form Unit A4A04.pdf

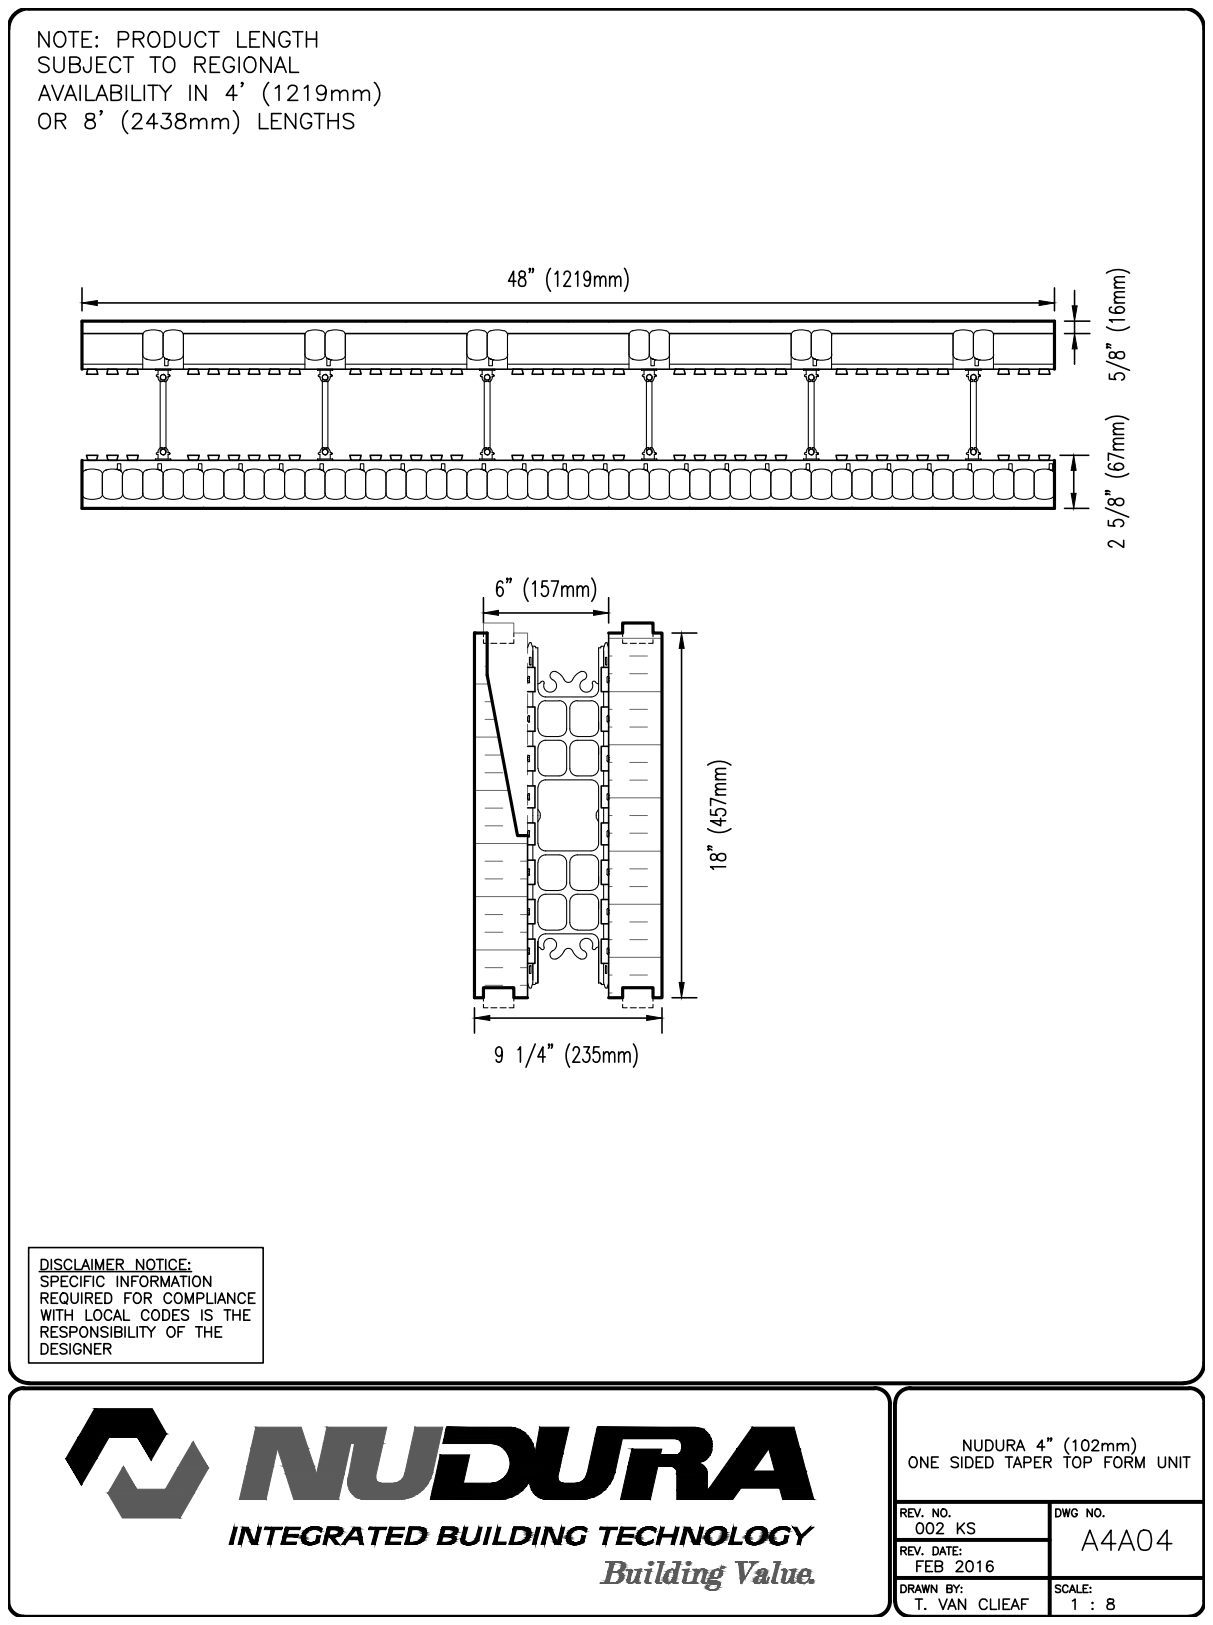
[picture p333: page 1]
