Tanvi11Ghelani/ECO_BUILD_UI/build/EcoBuildPdf/FormUnitProfiles/Concrete core mold 102 mm/Standard Form Unit A4A01.pdf

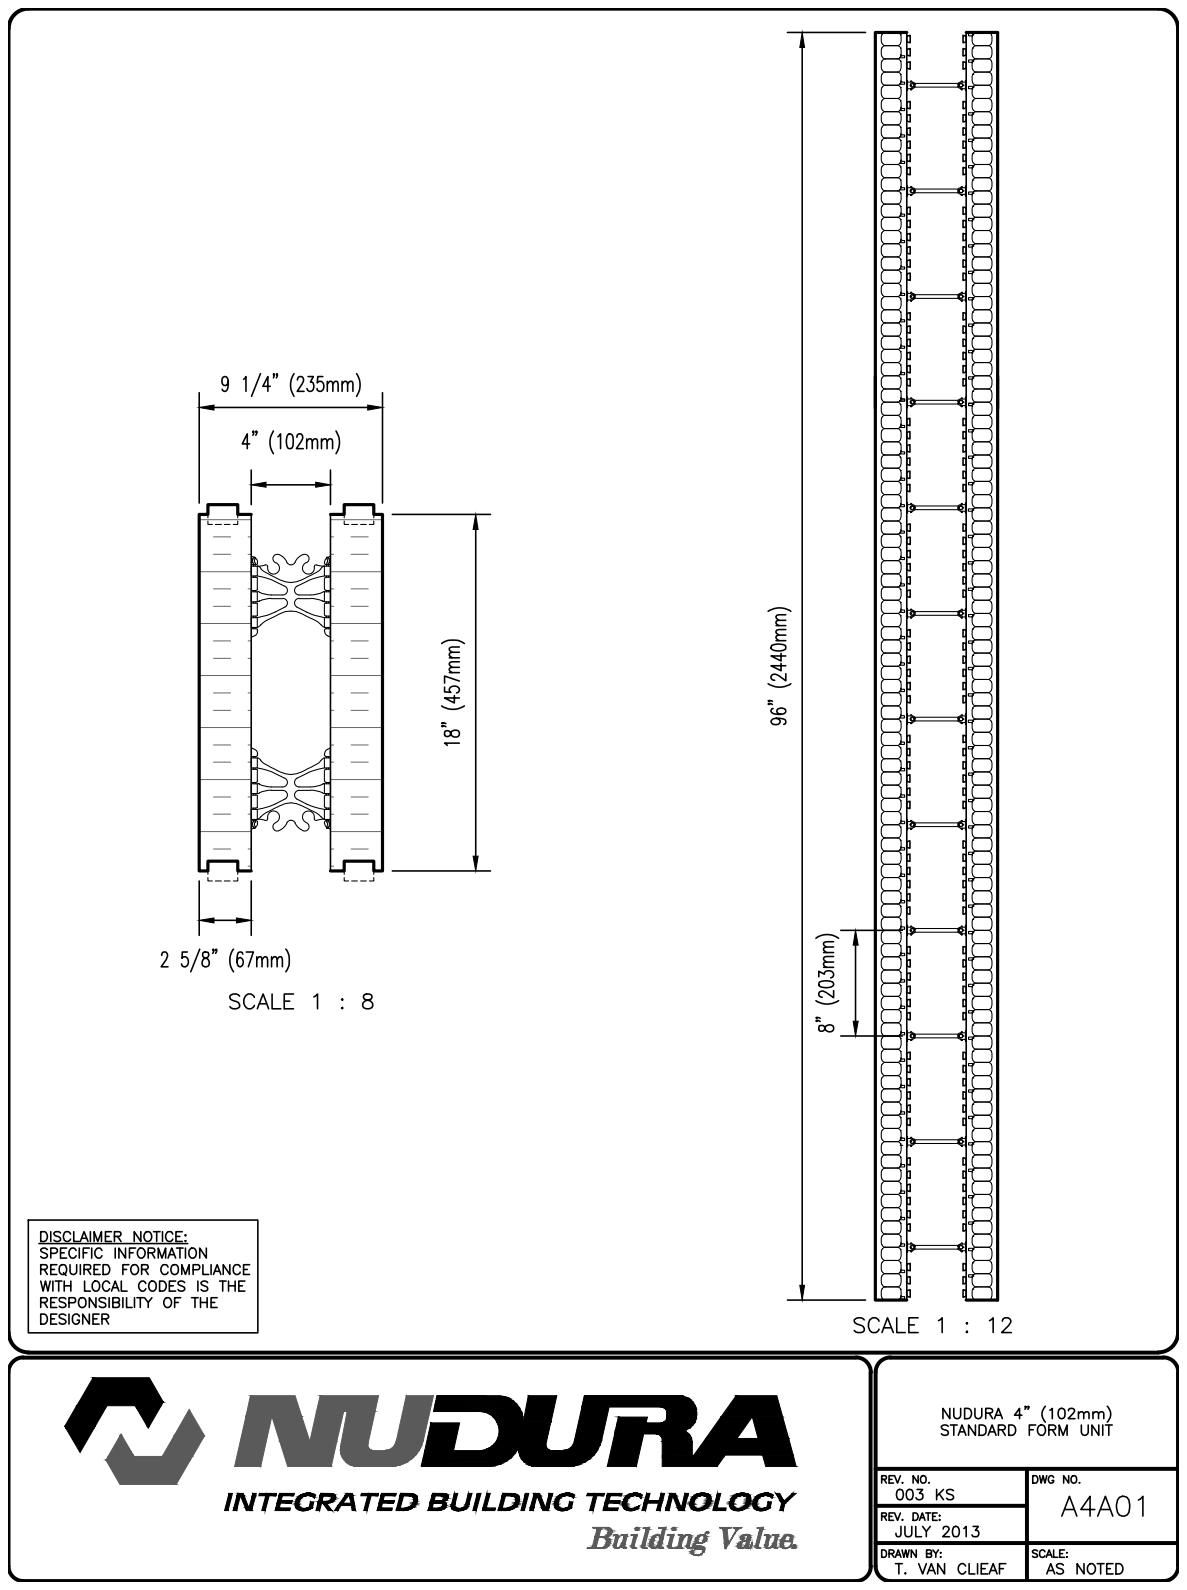
[picture p334: page 1]
