Tanvi11Ghelani/ECO_BUILD_UI/(commit log)

2025-12-12 feat: implement flammable construction details page with filterable data tables and CAD/PDF downloads.
2025-12-12 feat: Add Non-Combustible Construction page with detailed product data and filtering capabilities.
2025-12-14 Add Eco-build guide
    [A10A01.dwg, A10A02.dwg, A10A03.dwg, A10A04.dwg, A10A05.dwg, A10A06.dwg, A10A07.dwg, A10A08.dwg]
